PZero/SwimTimer/firmware/xiao-stream/LEGGIMI.md

# xiao-stream - XIAO nRF52840 Sense, streaming IMU via BLE, registrazione in vasca e sincronizzazione con il display

Firmware di prova: annuncia "SwimTag", invia l'IMU alla tab XIAO di `tools/index.html`, manda un log, si sospende (comando, fermo prolungato) e si risveglia con 4 tocchi o con l'USB, e si aggiorna via Bluetooth dalla finestra «Firmware del tag».

**0.6.4** (2026-11-12, compilata, NON caricata né provata): stack BLE 10 KB (`-DCFG_BLE_TASK_STACKSIZE=(256*10)`); **in registrazione la tag resta collegata al ricevitore** (central con PRONTO v2) e manda ogni blocco appena completo, senza FINE e senza disconnettersi (keepalive: una MAPPA ogni 5 s senza altro traffico; a fine registrazione, con `annSonno`, torna la FINE); se il collegamento cade ricomincia dagli annunci e riprende dal blocco non confermato piu' vecchio (invariato). Nuova **DIAGNOSI2** (0x08, subito dopo la DIAGNOSI, solo PRONTO v2; formato in `swr_sync.h`): intervallo, MTU, DLE e PHY negoziati, VBUS adesso + eventi «vista»/«persa» con contatori e millis dell'ultimo (letti ogni 20 ms in ogni modo; ogni evento anche nel diario: NOTA 19 = p2 1 vista/0 persa, p3 contatore, p4 millis), disconnessioni con motivo HCI 0x3E e totali, ultimo motivo, minimo storico dello stack BLE libero. Compilazione: sketch 191860 B (23 %), RAM 38344 B (16 %). Attenzione: con il collegamento permanente restano valide le regole 0.6.1 «niente scritture flash con un client BLE collegato» (diario solo con >= 32 eventi in RAM, azzeramento del contatore di ripartenze dopo 10 min stabili solo senza client): vanno rimisurate in vasca.

**0.6.1** (2026-11-11, dopo l'incidente in piscina): regole di modo (a batteria niente modalita' normale), ripresa automatica dopo un riavvio inatteso, watchdog, contesto del guasto, diario persistente, allineamento del FIFO. Vedi la sezione «0.6.1» in fondo e `PROVA-0.6.1.md`. Compilazione: sketch ~182 KB (22 %), RAM globale ~36,6 KB (15 %).

**0.6.0** (2026-11-10, provata a secco su 2 tag: 666 blocchi in 15 min, 0 errori): sincronizzazione con il display (`docs/SINCRONIZZAZIONE.md`), BLE sempre acceso anche in registrazione, memoria ad anello (**formato 3**), nome e colore della tag, **LED spenti a batteria** (accesi solo con l'USB alimentata, anche il lampeggio del BLE), seq mai riusato (`/seq.bin`). Vedi la sezione «Sincronizzazione con il display (0.6.0)» in fondo.

**0.5.4** (2026-11-08): corrente di carica 100 mA (P0.13 basso, resta in System OFF). Per le prove si usa una cella da 1000 mAh: da vuota servono ~10-12 h.

## Compilazione e caricamento via USB
Core `Seeeduino:nrf52` 1.1.13 (non mbed, con Bluefruit), FQBN `Seeeduino:nrf52:xiaonRF52840Sense`.
Indice schede: `https://files.seeedstudio.com/arduino/package_seeeduino_boards_index.json`.

Il toolchain ARM **non accetta percorsi con spazi**: compilare una copia in un percorso senza spazi. Dalla 0.6.0 lo sketch ha piu' file (`swr_formato.h`, `swr_anello.h`, `swr_sync.h`, `flash_qspi.h`): vanno copiati tutti.

    mkdir C:\Temp\xs\xiao-stream ; copy xiao-stream.ino,*.h C:\Temp\xs\xiao-stream\
    arduino-cli compile --fqbn Seeeduino:nrf52:xiaonRF52840Sense --build-property "compiler.cpp.extra_flags=-DCFG_BLE_TASK_STACKSIZE=(256*10)" --build-path C:\Temp\xs\build C:\Temp\xs\xiao-stream
    (dal 0.6.3 il -D e' obbligatorio, dalla 0.6.4 vale 10 KB: stack del task BLE 10 KB invece di 5 KB, +5 KB di heap; vale anche per le build destinate all'OTA; con altri -D, nello stesso valore separati da spazio)
    arduino-cli upload -p COMxx --fqbn Seeeduino:nrf52:xiaonRF52840Sense --input-dir C:\Temp\xs\build

Dalla 0.6.0 la compilazione dice: sketch ~172 KB (21 %), RAM globale ~34,8 KB (14 %); il limite dell'app per l'OTA e' 356 KB.

L'upload entra da solo nel bootloader (touch a 1200 baud); la porta cambia (COM13 -> COM15). Se non entra: doppio tap su reset (la scheda in sospensione va svegliata prima).

## Aggiornamento via Bluetooth (OTA 0006, stesso protocollo dell'ESP32)
Il servizio DFU Nordic legacy e' sulla blocklist di Web Bluetooth (Chrome/Edge), quindi l'aggiornamento usa un OTA nostro sulla caratteristica `7a1e0006`, identico a quello dell'ESP32: comando `OTA,<byte>,<crc32 hex>,<versione>[,forza]` su 0004, poi scritture su 0006 = `uint32 offset LE + dati`, poi `OTAEND`. Risposte su 0005: `K ota pronto,<blocco>`, `X ota offset,N` (ripartire da N), `K ota ok`, errori `X ota ...`.

**Cosa si carica**: il `.bin` dell'applicazione, cioe' l'ELF convertito con objcopy (parte da 0x27000, `SP` iniziale in RAM 0x2000xxxx). Il core non lo produce da solo (genera .hex e .zip): si ottiene con

    arm-none-eabi-objcopy -O binary xiao-stream.ino.elf xiao-0.4.x.bin

(l'objcopy e' in `%LOCALAPPDATA%\Arduino15\packages\Seeeduino\tools\arm-none-eabi-gcc\9-2019q4\bin`). Il binario contiene `SWIMTAG_VER=<versione>;` e `SWIMTAG_BOARD=xiao-nrf52840;`: il tag rifiuta (`X`) qualsiasi immagine senza la firma della scheda o con vettori non validi (es. il .bin dell'ESP32), con dimensione fuori da 1 KB..356 KB, della stessa versione o precedente (senza `forza`).

### Mappa della flash (nRF52840, 1 MB)
| Indirizzi | Contenuto | Fonte |
|---|---|---|
| 0x00000-0x26FFF | MBR + SoftDevice S140 7.3.0 | `nrf52840_s140_v7.ld` del core: `FLASH ORIGIN = 0x27000` |
| **0x27000** (`APP_BASE`) - fine app | applicazione (~140 KB, fine ~0x4A000) | idem |
| **0x80000** (`STAGING_BASE`) - 0xEC FFF | **staging** dell'immagine ricevuta (max 356 KB = `APP_MAX_BYTE`, anche limite per l'app) | scelto: dopo l'app, prima di InternalFS |
| 0xED000-0xF3FFF | InternalFS di Bluefruit (bonding, 7 pagine) | `InternalFileSystem.cpp`: `LFS_FLASH_ADDR 0xED000` |
| 0xF4000-0xFDFFF | bootloader Adafruit | `dfu_types.h`: `BOOTLOADER_REGION_START 0xF4000` |
| 0xFE000 / **0xFF000** | MBR params / **impostazioni del bootloader** (`BL_SETTINGS`) | `dfu_types.h` |

### Come funziona
1. I dati arrivano in un anello da 8 KB (la callback BLE non tocca la flash) e il `loop` li scrive nello staging con `flash_nrf5x_write` (API del core sopra `sd_flash_write/erase`, compatibile col SoftDevice). Il CRC32 si calcola mentre arrivano.
2. A `OTAEND`: controllo di lunghezza, CRC32, vettori (SP in RAM, reset dispari dentro l'immagine), firma scheda e marcatore di versione. Se qualcosa non torna: scartato, `X ...` e riga di log.
3. Se tutto torna: `K ota ok`, dopo 0,8 s disconnessione, `sd_softdevice_disable`, interrupt spenti e routine `ramInstalla` **tutta in RAM** (sezione `.data.ramfunc`, verificato col disassemblato: nessuna chiamata a funzioni in flash): cancella le pagine dell'app, copia lo staging con NVMC, rilegge e confronta, riscrive le impostazioni del bootloader e fa il reset di sistema.
4. **Bootloader (fonte: `bootloader.c` e `dfu_types.h` di Adafruit_nRF52_Bootloader, letti da GitHub)**: all'avvio `bootloader_app_is_valid()` guarda `bank_0 == BANK_VALID_APP (1)` e, **se `bank_0_crc != 0`, calcola il CRC16 su `bank_0_size` byte** e lo confronta; con `crc == 0` il controllo e' disattivato. Su questa scheda la pagina impostazioni dopo un upload USB contiene `bank_0 = 1, crc = 0, size = dimensione dell'app` (il firmware lo legge e lo scrive nel log all'avvio: `bl bank0 ok crc 0000 = dim N`). L'OTA scrive esattamente lo stesso formato (`bank_0=1`, `bank_0_crc=0`, `bank_1=0xFF`, `bank_0_size` = byte arrotondati a 4), quindi il bootloader accetta la nuova app. Se la copia non verifica, le impostazioni non vengono toccate e il bootloader (versione di riferimento) resta in modalita' DFU.
5. **Recupero**: il bootloader non viene mai modificato; se la nuova app non parte, doppio tap su reset (LED che pulsa, unita' XIAO-SENSE o porta DFU) e caricamento via USB.

Ogni fase finisce nel log del tag (`ota: 143008 byte, v0.4.1`, `ricevuto 25/50/75/100%`, `crc ok`, `installazione`, errori) e quindi nel pannello «Log tag». Durante l'OTA il flusso IMU e la sospensione automatica sono fermi. Velocita' misurata con Windows/Realtek: ~1 KB/s (scritture con risposta), cioe' circa 2,5 minuti.

Prova da PC senza browser: `python ota_prova.py ota xiao-0.4.1.bin 0.4.1` (script `bleak`, stesso protocollo della pagina; vedi sotto in «Prove»).

## Protocollo (little endian)
- Servizio `7a1e0001-5b1d-4c8e-9f3a-1d2c3b4a5e60`.
- DATI `7a1e0002-...` notify, 16 byte a 25 Hz: `uint32 millis`, `int16 ax,ay,az` (2048 LSB/g, +-16 g), `int16 gx,gy,gz` (16,4 LSB/dps). Ogni valore e' la **media** dei campioni a 208 Hz nei 40 ms dall'ultimo pacchetto (niente aliasing); il giroscopio e' gia' privo di bias.
- STATO `7a1e0003-...` read+notify, 1 Hz, 8 byte: `uint16 mV`, `uint8 flag` (bit0 USB presente o in carica, bit1 IMU ok, bit2 registrazione=0, bit4 g16=1), `uint8 causa` (0 accensione, 1 doppio tap, 3 watchdog, 5 software, 6 lockup, 7 USB, 8 pin reset), `uint32 millis`. mV = 0 se la cella non c'e'.
- COMANDI `7a1e0004-...` write (testo, max 64): `SLEEP`, `LIST` (risponde `Z`), `OTA,...`, `OTAEND`, `OTAABORT`; altro -> `X non supportato`.
- RISPOSTE `7a1e0005-...` notify: primo byte = tipo. **`G` + testo = riga di log**; `Z` fine elenco; `K`/`X` risposte ai comandi.
- OTA `7a1e0006-...`, VERSIONE `7a1e0007-...` (`xiao-0.4.x`). Servizio DFU Nordic (BLEDfu) ancora presente per l'app nRF Connect.

## Batteria (0.4.2)
- **STATO a 12 byte** (compatibile: i primi 8 sono invariati; la pagina riconosce la XIAO dalla lunghezza 12): `[8] flag2` (bit0 VBUS presente, bit1 carica completata, bit2 in carica, bit3 batteria bassa < 3,4 V), `[9] int8` temperatura del die in gradi (`sd_temp_get`), `[10-11] uint16` fattore del partitore x1000. Stati: in carica = VBUS e ~CHG basso; carica completata = VBUS e ~CHG alto con cella presente; a batteria = niente VBUS.
- **Lettura ADC**: 24 letture a 1 ms, media delle 16 centrali (scarta i picchi causati dalle trasmissioni radio).
- **Taratura**: comando `VCAL,<mV letti col tester>` calcola il fattore del partitore e lo salva in flash (file `/vcal.bin` nell'InternalFS di Bluefruit, 0xED000-0xF3FFF: non tocca ne' lo staging OTA 0x80000 ne' le impostazioni del bootloader). `VCAL` senza argomento mostra il fattore, `VCAL,0` ripristina 2,96. Risposta `K vcal 2.xxx`, errori `X vcal ...`.
- **Batteria bassa**: log `batteria bassa` sotto 3,4 V a batteria; sotto 3,3 V per 5 letture di fila sospensione "solo USB" (IMU spento). Mai con la USB collegata.

## Log
Buffer circolare in RAM di 50 righe (44 caratteri): boot e causa di reset (con RESETREAS grezzo), IMU ok/errore, bias del giroscopio, stato del bootloader, batteria/USB/carica (a ogni cambio e ogni 60 s), connessioni, sospensione, OTA. Alla connessione (quando la pagina abilita le notifiche su 0005) viene rimandato tutto il buffer; la pagina mostra le righe nel pannello «Log tag». Le stesse righe escono sulla seriale.

## Sospensione e risveglio con 4 tocchi
`SLEEP` (pulsante «Sospendi») oppure 60 s "abbastanza fermo" (vedi costanti `QUIETE_*`). Il firmware spegne il giroscopio, accelerometro a 416 Hz +-2 g in basso consumo, doppio tap hardware (`TAP_CFG=0x8F` con **LIR**, `TAP_THS_6D`=soglia, `INT_DUR2=0x7F`, `WAKE_UP_THS=0x80`, `MD1_CFG=0x08` -> INT1 = P0.11), poi System OFF con sense alto su P0.11.
- **Risveglio (0.4.5/0.5.0)**: il primo doppio tap hardware (2 tocchi) fa partire il chip. **All'uscita da System OFF l'IMU perde l'alimentazione e resta cieco per circa 0,5 s** (bootloader, avvio, riaccensione e riconfigurazione): il 3o e il 4o tocco dati a ritmo normale cadono in questo buco, misurato sulla tag. Per questo, dopo `RISVEGLIO_PAUSA_MS` (150 ms), `risveglioQuattroTap()` accende il **LED blu come invito** a dare i tocchi di conferma e li conta in software (tocco singolo, `TAP_SRC` bit SINGLE_TAP, antirimbalzo 100 ms) entro `RISVEGLIO_FINESTRA_MS` (3000 ms); il blu si spegne a fine sequenza. Sequenza **2 tocchi, blu, 2 tocchi** = risveglio (log `risveglio 4 tap`). Falso risveglio (solo 2 tocchi): torna in System OFF senza BLE, USB ne' log, scrivendo in `GPREGRET2` `MARCA_FALSO` (0xC0 | tocchi visti), che al boot vale come marca di sleep ed e' visibile nel log `marca %02X` (provato: `marca C0`). WHO_AM_I e' ritentato 4 volte da 40 ms. Il risveglio da USB (VBUS) resta immediato.
- **Bug del risveglio con 2 tocchi: causa vera (0.5.0)**: il bootloader Adafruit azzera `RESETREAS` prima di lanciare l'app, quindi `causaReset` risultava sempre "accensione" (RESETREAS 0, anche dopo un OTA) e `risveglioQuattroTap()` non veniva mai chiamata: la tag partiva al primo doppio tap. La correzione di 0.4.3 (conferma in software) era giusta ma non veniva eseguita. Ora, prima di **ogni** System OFF, si scrive la marca `MARCA_SLEEP` (0xB7) in `GPREGRET2` (`sd_power_gpregret_*` con il SoftDevice, il registro diretto senza; il bootloader non lo tocca); in `setup()` la si legge e la si azzera, e se c'e' la marca, non c'e' VBUS e la causa non e' USB, `causaReset = 1` (doppio tap). Nel log compare `marca B7 vbus 0`. (Fonte: prove sulla tag del coordinatore, versione 0.4.4 provvisoria.)
- **Niente sospensione automatica con la seriale aperta**: se un programma sul PC tiene aperta la porta USB (CDC con DTR attivo, `Serial` vero) la sospensione per quiete non scatta e nel log compare una volta `seriale aperta: niente sospensione`. Restano attivi il comando `SLEEP` esplicito e la protezione batteria bassa (esclusa comunque con la USB). Idem se la pagina e' collegata via BLE con comandi negli ultimi 120 s e durante un OTA.
- **Falso risveglio**: da sveglio per circa 40 ms (avvio) + 40 ms (IMU) + 250 ms + 2500 ms + qualche ms = **~2,9 s**, a regime CPU ferma in attesa (da misurare con un amperometro).
- **Soglia del doppio tap**: `TAP_SOGLIA` in cima allo sketch (12 = 0,75 g, 1 LSB = 62,5 mg). Piu' basso = piu' sensibile. La durata massima fra i due tap di un doppio tap e' in `INT_DUR2` (DUR=7, ~0,5 s a 416 Hz).
- **Consumo in sospensione: stima, non misura.** nRF52840 in System OFF ~1 uA; LSM6DS3TR-C con solo accelerometro a 416 Hz in basso consumo ~100-200 uA (termine dominante: il tap hardware richiede almeno 416 Hz); flash QSPI e BQ25101 pochi uA. Totale atteso ~0,1-0,2 mA, cioe' 8-16 giorni con la cella da 40 mAh. Da misurare con un multimetro in serie alla batteria.

## Orientamento: perche' la testa si storceva e cosa e' cambiato
1. **Aliasing (causa principale)**: prima ogni pacchetto era un campione istantaneo a 25 Hz del giroscopio; una rotazione veloce cade fra due campioni e l'integrale e' sbagliato. Ora il firmware campiona a 208 Hz e manda la media.
2. **Bias del giroscopio**: ~1-2 dps da fermo si integrano in 10-20 gradi al minuto. Misurato al boot e ri-stimato quando il tag e' fermo (finestre da 0,5 s, variazione sotto 2,5 dps, |a| fra 0,9 e 1,1 g, media entro 4 dps dal bias noto).
3. **Assi/segni**: da verificare con «Verifica assi» (Z a +1 g a faccia in su, Y a +1 g con l'USB-C in alto).
4. **Imbardata (yaw)**: senza magnetometro non e' osservabile; la deriva si azzera con «Ricentra».

## Prove
- `C:\Temp\xs\ota_prova.py` (venv con `bleak`): `python ota_prova.py log` legge versione e log; `python ota_prova.py ota file.bin 0.4.1` esegue l'OTA come la pagina.
- Il partitore batteria (2,96) va confermato con un multimetro: letti ~4,0 V con la cella collegata e USB.

## Modalita' vasca (0.5.0): registrazione su flash (dalla 0.6.0 il BLE resta acceso solo per annunciarsi e sincronizzare)
Per la prova in piscina: il BLE non attraversa l'acqua, quindi la tag registra l'IMU grezzo sulla flash QSPI; i dati si scaricano a bordo vasca dal display (0.6.0) oppure a casa via USB.

### Uso (tocchi, tag senza USB)
| Gesto | Effetto |
|---|---|
| **REGISTRA**: 2 tocchi, **LED blu** (si spegne un attimo a ogni tocco contato, dalla 0.5.1), 2 tocchi | sveglia e **registra subito**. Se in memoria c'e' gia' una registrazione, si **accoda** come nuovo segmento (una sola sessione, piu' risvegli). |
| **AZZERA**: 2 tocchi, **LED blu**, 6 tocchi, poi rosso lampeggiante e 2 di conferma entro 4 s | **azzera** la memoria (LED rosso lampeggiante durante i 4 s; senza conferma non succede nulla). Cancellazione 5-15 s. |
| tag ferma | **stop** per quiete: 180 s consecutivi "abbastanza fermi" (soglie `QUIETE_GYRO_DPS`/`QUIETE_ANGOLO_GRADI`), poi chiusura e sospensione. |
Nessuno stop a tocchi. Altri stop: memoria piena, batteria sotto 3,3 V (3 letture ogni 5 s). Il blu si accende 150 ms dopo il risveglio e resta acceso finche' la sequenza non e' finita: finisce quando passano 900 ms senza un nuovo tocco (la registrazione parte ~1 s dopo l'ultimo), e il conteggio decide: 6 tocchi dopo il blu = azzera, da 2 a 5 = registra (2 non si scambia con 6). Finestra totale per il 1o tocco dopo il blu: 3 s. Con la **USB collegata** i tocchi danno la modalita' normale (BLE, OTA, log) e non si registra. **0.6.0**: se la flash contiene dati del **formato 1** (0.5.x) la registrazione **non parte** e i dati non si cancellano da soli: 4 lampi viola (rosso+blu); si scaricano con `DUMP` e poi si azzera con la sequenza AZZERA (6 tocchi + conferma). Un contenuto non riconosciuto (ne' formato 1 ne' 2) si cancella da solo, come in 0.5.x. Nota: i 180 s di quiete contano anche prima di entrare in acqua.

### LED (RGB a tre canali discreti attivi bassi: LED_RED P0.26, LED_GREEN P0.30, LED_BLUE P0.06; non e' un NeoPixel)
| Stato | Segnale |
|---|---|
| registrazione avviata | 3 lampi verdi da 150 ms |
| in registrazione | 1 lampo verde da 30 ms ogni 8 s |
| memoria > 80% non confermata (0.6.0) | 2 lampi gialli (rosso+verde) ogni 8 s |
| batteria < 3,5 V | 1 lampo rosso ogni 8 s |
| memoria piena di blocchi non confermati (stop) / azzera rifiutato | 5 lampi rossi |
| flash in formato 1 (non si registra) | 4 lampi viola (rosso+blu) |
| batteria < 3,4 V al risveglio (non registra) | 3 lampi rossi da 200 ms |
| batteria < 3,3 V (stop e chiusura) | 3 lampi rossi da 200 ms, poi IMU spento: si riparte solo con l'USB |
| errore (IMU, flash, I2C) | 10 lampi rossi rapidi |
| conferma azzeramento | rosso lampeggiante a 5 Hz per 4 s; poi azzerata = 3 lampi blu; gia' vuota = 1 lampo blu |
| flash formattata (altro contenuto) | blu fisso durante la cancellazione |
**Dalla 0.6.0 i LED sono spenti a batteria** (decisione 2026-11-10: sotto la cuffia non si vedono e consumano): la tabella vale solo con l'USB alimentata. I tempi delle sequenze (tocchi, finestre) restano uguali; lo stato si vede sul display e sulla pagina.

### Cosa si registra
208 Hz, accelerometro +-16 g (488 ug/LSB), giroscopio +-1000 dps (35 mdps/LSB), FIFO dell'LSM6 in modo continuo (a 208 Hz tiene ~1,6 s: copre le scritture in flash). Il giroscopio **non e' corretto del bias** (si stima a casa dai tratti fermi). Ordine nel FIFO secondo il datasheet: G poi XL; nel file: ax ay az gx gy gz. Controllo a secco: a faccia in su az ~ +1 g.
Se mai il FIFO va in overrun, riparte e la pagina successiva ha il flag di interruzione.

### Formato .swr 1 (0.5.x; specifica completa in `swr_formato.h`; il formato 2 della 0.6.0 e' descritto piu' sotto)
Flash = sequenza di **pagine da 256 byte** scritte una sola volta, in ordine (nessuna cancellazione in registrazione, nessun filesystem). Intestazione da 16 byte: tipo (segmento 0xA5 / dati 0xD1 / chiusura 0xE0), numero di pagina, `millis` del primo campione, mV, temperatura, flag, segmento, **CRC16** dell'intera pagina. Pagina dati: primo campione **assoluto** (12 B) poi per campione 6 differenze int8, oppure un **escape** (0x80 + 12 B assoluti) se una differenza esce da -127..127: ogni pagina si decodifica da sola. Capacita': 8192 pagine; con dati regolari ~6 B/campione (~2 x rispetto ai 12 B grezzi: ~25 min), con molti escape meno (13 B al campione). Una pagina di segmento a ogni risveglio, una di chiusura (motivo, campioni).
La fine si ricostruisce dall'ultima pagina valida (ricerca binaria della prima pagina libera): se la batteria muore senza chiusura i dati scritti restano e il segmento risulta "senza chiusura". Al risveglio, con pagina 0 non valida e non vuota, la flash viene azzerata (prima installazione).
Il driver `flash_qspi.h` usa direttamente `nrfx_qspi` (la libreria utente `Adafruit_SPIFlash` 5.x rompe la compilazione di Bluefruit).

### Scarico (USB, modalita' normale) e analisi
Comandi sulla seriale (115200): `MEM`, `DUMP`, `ERASE`. `DUMP` risponde `SWR1 <pagine>`, le pagine binarie, `END <pagine>` (flash in formato 1) oppure, dalla 0.6.0 con la flash in formato 2, `SWR2 <blocchi>`, i blocchi non vuoti da 4096 byte in ordine fisico (confermati compresi: lo scarico USB legge anche cio' che e' gia' sul display), `END <blocchi>`; durante il dump niente log sulla seriale. `swr.py` e `scarica.py` riconoscono i due formati (primo byte 0xA5 o 0xB1), riordinano i blocchi per seq, saltano le intestazioni, trattano le pagine 0xFF come vuote e segnalano i buchi di seq. `MEM` in formato 3: `K mem formato3 da_validare N confermati N liberi N anomali N seq N`. `NOME` e `COLORE` senza argomento rispondono col valore attuale. **SLEEP funziona anche in registrazione** (dalla pagina): chiude il segmento (motivo 6 «comando SLEEP»), annuncia «vado in sonno» e dorme; gli altri comandi in registrazione rispondono `X registrazione in corso`. `ERASE` cancella tutto (anche non confermato: e' un comando esplicito da USB).

    pip install pyserial
    python scarica.py scarica COM5        # salva registrazioni/AAAAmmdd_HHMMSS.swr e il CSV
    python scarica.py converti file.swr   # solo conversione
    python scarica.py mem COM5 ; python scarica.py azzera COM5
    python test_swr.py                    # test su dati inventati (23 test; anche `python -m unittest test_swr` dalla cartella)

CSV: `seg,pagina,n,t_s,ax_g..gz_dps,mV` (`--grezzo` per gli LSB). `t_s` e' in secondi dall'inizio del segmento (dai `millis` di pagina, regolarizzati con una regressione sulle pagine contigue); tra segmenti diversi il tempo non e' collegabile. Il programma segnala pagine corrotte, interruzioni, segmenti senza chiusura. I `.swr` e i CSV sono dati di salute: ignorati da git.

### Limiti noti (0.5.0, non provata su hardware)
- Non collaudata sulla tag: ordine G/XL del FIFO, lettura a burst da `FIFO_DATA_OUT`, cancellazione chip, QSPI senza SoftDevice e consumi vanno verificati a secco.
- Il codificatore C++ (`swr_formato.h`) e' specchiato in Python (`swr.py`) ma non e' stato eseguito su PC (nessun compilatore host): i test provano il formato in Python; la parita' C++/Python e' per costruzione e va confermata scaricando una registrazione vera.
- Il tempo dei campioni nel firmware e' stimato (±1 campione); il bias del giroscopio non e' misurato.
- Nessun BLE/OTA in vasca: aggiornare il firmware richiede l'USB. Il sensore `LED` puo' non essere visibile sotto la cuffia.
- Consumo stimato (da misurare): ~1,5-2 mA registrando, ~0,1-0,2 mA in sospensione.

## Sincronizzazione con il display (0.6.0)
Specifica: `docs/SINCRONIZZAZIONE.md` (§1-§3, §7, §8). Riferimento binario lato display: `firmware/display-sync/protocollo.h` (i messaggi di `swr_sync.h` devono combaciare byte per byte).

### Cosa fa
- **BLE sempre acceso**, anche in registrazione (prima in vasca era spento): annuncio connectable ogni **200 ms** con i dati produttore del §7 (22 byte: id, stato, batteria, % memoria non confermata, blocchi in attesa, ultimo seq, secondi di registrazione, errori, colore) e, nella scan response, il nome. **2 collegamenti periferici** contemporanei (display + pagina web). La tag **non interpreta il movimento**: l'annuncio e' sempre lo stesso, con i dati che cambiano.
- **Nome** nella scan response: il nome scelto dall'utente (max 12 caratteri ASCII) oppure `ST-xxxx` (ultime 4 cifre dell'id). **Cambia rispetto alla 0.5.x** (prima `SwimTag`): la pagina `tools/index.html` non deve piu' filtrare per nome `SwimTag`. Nella scan response c'e' anche il servizio `7a1e0001` se il nome e' di al massimo 11 caratteri.
- **Stati annunciati**: 0 vado in sonno (~2 s prima di dormire; se la memoria e' piena prima 2 s di stato 4; se un display sta scaricando si aspetta la sua FINE/STOP, al massimo 60 s), 1 pronta (modalita' normale), 2 registra, 4 memoria piena, 5 errore (IMU o flash, anche flash in formato 1), 6 sincronizza.
- **Servizio `7a1e0101`**: CONTROLLO `0102` (scrittura, **solo collegamento cifrato**: `SECMODE_ENC_NO_MITM`, bonding Just Works con le impostazioni predefinite di Bluefruit: bond, LESC se il chip lo permette), DATI `0103` (notifiche inviate direttamente al SoftDevice con `sd_ble_gatts_hvx`: se la coda radio e' piena non si blocca, riprova al giro dopo), STATO SYNC `0104` (lettura + notifica ogni 2 s, 151 byte, senza cifratura, la pagina non puo' confermare). MTU 247, coda di 4 notifiche, evento da 7,5 ms; PHY 2M e DLE li negozia il display (la libreria Bluefruit accetta le richieste del centrale).
- **Scarico**: dopo PRONTO la tag manda MAPPA, poi il blocco non confermato piu' vecchio (BLOCCO + 32 FRAMMENTI), al massimo 2 blocchi trasmessi e non confermati; **attende la CONFERMA senza timer**; non rinvia mai da sola; RIPETI rimette in coda il blocco; STOP chiude; quando non resta niente da confermare manda FINE (e riparte da sola se si chiude un nuovo blocco mentre il display e' ancora collegato). **Il blocco aperto non si invia** (niente anteprima): il display riceve solo blocchi chiusi (~3 s di ritardo al massimo).
- **Conferma**: CONFERMA(seq, crc32) -> la tag **ricalcola il CRC32 dalla flash** e solo se coincide scrive la parola 252..255 a 0x00, **rilegge l'intera intestazione** (deve risultare confermata e ancora valida) e risponde CONFERMATO. Altrimenti ERRORE (1 CRC diverso, 2 seq sconosciuto, 3 flash).
- **La registrazione non si ferma durante lo scarico**: tutto gira nel `loop` a pezzi (al massimo ~10 messaggi per giro, ogni frammento e' una lettura da 128 byte dalla flash; il CRC32 di un blocco = 16 letture da 256 byte). Il FIFO dell'IMU (1,6 s) viene servito almeno ogni 20 ms mentre si scarica (40 ms altrimenti). Le operazioni piu' lunghe sono la **cancellazione di un settore** (45 ms tipici, fino a 300 ms; una per blocco, solo quando la memoria ha fatto il giro) e la scrittura. **Misure per verificarlo**: la pagina di chiusura di ogni segmento ora contiene (byte 24..30) il massimo intervallo fra due letture del FIFO in ms, gli overrun, il massimo tempo di apertura di un blocco (cancellazione compresa) e i blocchi confermati nella sessione; `swr.py` le mostra nel riassunto (`tempi: ...`). Se il massimo intervallo si avvicina a 1600 ms il FIFO va in overrun.

### Memoria ad anello (formato 3)
- Flash da 2 MB = **512 blocchi da 4 KB** (= settore). Pagina 0 del blocco = intestazione `0xB1` (seq u32 globale, id tag, **parola 252..255 = conferma** fuori dal CRC16; il formato 2 la teneva nel byte 16, vedi sotto), pagine 1-15 = pagine del formato 1 (segmento 0xA5, dati 0xD1, chiusura 0xE0, numero di pagina fisica). Capacita' utile 15/16 della flash (~7680 pagine). CRC32 del blocco = IEEE sui 4096 byte con la conferma a 0xFF (anche nei frammenti inviati). Il seq non si riusa mai: prima di ogni cancellazione totale si salva il massimo in `/seq.bin` (InternalFS), senza file si parte da 1000.
- All'avvio si leggono le 512 intestazioni (~100 ms): seq massimo, blocchi da validare, confermati, liberi, anomali (contenuto non riconosciuto: non si toccano mai). Un blocco e' "aperto" solo in RAM mentre si registra; dopo un riavvio i blocchi scritti a meta' sono semplicemente "da validare" (le pagine non scritte restano 0xFF = vuote e valide). Ogni segmento (ogni risveglio) comincia un blocco nuovo; il blocco si chiude quando e' pieno o a fine segmento.
- Nuovo blocco: il **libero successivo** (in ordine ad anello); se non c'e', il **confermato piu' vecchio** (cancellato solo ora); se sono tutti non confermati: **stop `SWR_STOP_PIENA`** (5 lampi rossi, stato 4). **Mai si scrive su un blocco non confermato.** Il blocco libero si verifica tutto 0xFF prima dell'uso (cancellazione interrotta da un'interruzione di corrente), altrimenti si cancella.
- Con memoria piena la pagina di chiusura del segmento non si scrive (il segmento risulta senza chiusura per `swr.py`; il motivo e' nell'annuncio, stato 4) e l'ultima pagina dati parziale (< 0,2 s) puo' andare persa.
- Il seq riparte da 1 dopo un azzeramento totale (`ERASE` o AZZERA a tocchi): il display riconosce un seq gia' visto con CRC diverso come anomalia e lo segnala.
- **Flash in formato 1 trovata all'avvio**: non si cancella, non si registra (vedi sopra); `DUMP` la legge ancora come prima. In 0.5.x un contenuto estraneo veniva azzerato da solo; **dalla 0.6.0 mai**: 4 lampi viola (solo con USB), niente registrazione, si azzera con `ERASE` o con i tocchi.

### Nome e colore (comandi sulla caratteristica `7a1e0004`, solo in modalita' normale)
`NOME,<testo>` (max 12 caratteri ASCII stampabili, vuoto = cancella; risposte `K nome <testo>`, `X nome troppo lungo (max 12)`, `X nome carattere non valido`), `COLORE,<0-9>` / `COLORE,-1` (`K colore <n>`, `X colore fuori campo (0-9 o -1)`); `COLORE` senza argomento mostra il valore. Salvati in InternalFS `/nome.bin` (come `/vcal.bin`: restano dopo riavvio e OTA); il nome cambia subito la scan response, il colore e' il byte 21 dell'annuncio. In registrazione (vasca) tutti i comandi rispondono `X registrazione in corso`.

### Consumi stimati del BLE in registrazione (stime, NON misure)
Annuncio a 200 ms, +4 dBm (3 canali per evento, con le finestre di ascolto per scan request e connessione): ~50-100 uA medi; con 0 dBm circa un quarto in meno. In piu': 2 stop/start dell'annuncio ogni 4 s (trascurabile) e il loop sveglio ogni 40 ms come prima. Rispetto ai ~1,5-2 mA della registrazione e' un +3-5 %: da **misurare con un amperometro in serie alla batteria**, prima e dopo. Collegata al display (7,5-15 ms) la tag assorbe ~0,5 mA in piu', con picchi di qualche mA durante lo scarico (pochi secondi a ogni sosta).

### Cosa NON e' provato (0.6.0: solo compilata, mai eseguita su hardware)
- Memoria SRAM del SoftDevice con 2 collegamenti, MTU 247, 4 notifiche e tabella attributi da 3 KB: se `Bluefruit.begin` fallisce il BLE resta spento ma la registrazione parte comunque (log `BLE begin KO`; in modalita' normale si vede nel pannello log). Da verificare al primo avvio.
- **Lezione 2026-11-10 (formato 2 → 3):** la Puya della XIAO, riprogrammando una parola da 4 byte gia' scritta, la **sostituisce** (non fa l'AND dei bit): scrivere `00 FF FF FF` nei byte 16..19 cancellava i byte 17..19 del seq. Intestazioni non valide, seq riusati, 185 anomalie al display (nessun dato perso: erano blocchi gia' confermati). Dal formato 3 la conferma ha una parola tutta sua (252..255) e dopo la scrittura si rilegge l'intestazione intera.
- Ordine e tempi reali: massimo intervallo fra letture FIFO con scarico in corso e con cancellazioni, throughput (atteso 30-80 KB/s con PHY 2M, mai misurato), tempo da «fermo» a «collegato».
- Bonding Just Works con il display ESP32 (CONTROLLO richiede la cifratura; se il display non fa il pairing la scrittura viene rifiutata), PHY 2M e DLE, stop/start dell'annuncio con 1 collegamento attivo (il secondo collegamento si riannuncia dal loop), nome lungo nella scan response, collegamento contemporaneo di display e pagina.
- Il codificatore C++ del formato 2 (`swr_formato.h`, `swr_anello.h`) e' specchiato in `swr.py` e provato lato Python (25 test, compresi la parola di conferma isolata e la lettura del formato 2); non c'e' un compilatore host: la parita' C++/Python va confermata con uno scarico USB reale. Nessun test automatico sulla logica dell'anello e della macchina a stati (solo compilazione).
- La batteria non e' stata considerata per lo scarico: la tag non si spegne da sola finche' un display sta scaricando (max 60 s dopo lo stop).

## 0.6.1 - regole di modo, ripresa, watchdog, contesto del guasto, diario, FIFO (2026-11-11)
Nasce dall'incidente in piscina: la tag 4A510689 si e' riavviata registrando, al riavvio e' andata in modalita' normale (ignora i tocchi) e ha perso tutto il nuoto; nei dati acc e giro risultavano scambiati a tratti. Casi di prova: `PROVA-0.6.1.md`.

### Regole di modo
- **A batteria la modalita' normale non esiste.** Senza USB un avvio puo' solo: registrare (4 tocchi, oppure ripresa automatica) o dormire. Avvio senza USB e senza ragione per registrare (cella appena collegata, reset senza marca) = System OFF subito, senza BLE (`dormiSenzaBle`, diario `MODO sonno mot5`).
- **USB staccata in modalita' normale** (VBUS assente per ~0,5 s): annuncio SONNO ~2 s e System OFF con marca B7 e tap configurato (`controlloUsb()`, diario `USB staccata`). Non scatta durante un OTA.
- **Con USB: modalita' normale, mai registrazione**, anche se arrivano i 4 tocchi. PC o caricatore si distinguono con l'**enumerazione USB** (`TinyUSBDevice.mounted()` = `tud_mounted()`; non il DTR): diario `USB PC` / `USB caricatore`. All'avvio con USB si attende fino a 3 s la seriale.
- **Nome e colore** (`NOME,x`, `COLORE,n`) solo con USB: altrimenti `X solo con USB` (le richieste senza argomento restano permesse).
- **OTA via BLE**: di fatto solo con la tag su USB o caricatore (e' una funzione della modalita' normale). In piscina o a batteria non si aggiorna. `SLEEP` resta (anche in registrazione).

### Ripresa automatica dopo un riavvio inatteso
- All'avvio della registrazione: `GPREGRET2 = MARCA_REGISTRA (0xD0 | riprese)` e `/reg.bin` (InternalFS: attiva, riprese). Alla chiusura ordinata: `MARCA_SLEEP` (B7) e `/reg.bin` azzerato (subito dopo la pagina di chiusura, prima degli annunci, cosi' un guasto in quella fase non riprende un segmento gia' chiuso).
- Al boot **senza VBUS**: marca REGISTRA -> `modalitaVasca(1)`: nessun rito dei tocchi, IMU riacceso (`imuAccendi()`), **nuovo segmento** (nuovo blocco), causa nella pagina di segmento.
- **Seconda rete** (GPREGRET2 perso, es. brownout): senza marca e senza USB, se `/reg.bin` e' attivo **e** l'ultimo blocco per seq contiene pagine di segmento/dati ma non la chiusura (`ultimoSegmentoAperto()`) -> `modalitaVasca(2)`. Con USB al boot lo stato orfano viene annullato (non riparte piu').
- **Protezione dai cicli**: al massimo `MAX_RIPRESE = 3` riprese consecutive senza chiusura ordinata; alla quarta annuncio ERRORE (~3 s) e sonno, diario `RIPRESA 4/3`. Il contatore si azzera con una chiusura ordinata o con una partenza a tocchi. **Non c'e' un orologio**: il vincolo «in pochi minuti» non e' implementabile senza RTC, vale «consecutive senza chiusura». Niente ripresa con batteria sotto `BAT_MIN_AVVIO_MV` (controllo gia' prima del conteggio).

### Watchdog hardware
`wdtAvvia()` a inizio `setup()`: timeout 8 s (`CRV = 8*32768-1`), `CONFIG.SLEEP = Run` (conta anche mentre la CPU dorme nel FreeRTOS idle), servito da `cane()` (RR[0] = 0x6E524635) nel `loop()`, nel ciclo della registrazione, in `attendi`, `bleServi` (quindi `sonnoAnnuncia`, fino a 60 s), `contaTocchi`, `calibraBoot`, nelle attese del chip QSPI (`flash.ciclo`, cancellazione chip fino a 15 s), nei `DUMP` e dentro `ramInstalla` (a interrupt spenti: scrittura diretta di NRF_WDT->RR[0] per pagina e ogni 1024 parole).

**Cosa succede al WDT (fonti e prove):**
- **Dopo il reset software e attraverso il bootloader il WDT continua a contare**: lo dice il bootloader stesso (Adafruit_nRF52_Bootloader 0.6.2, `lib/sdk11/components/libraries/bootloader_dfu/bootloader.c`, `wait_for_events()`: «WDT cannot be disabled once started. It even last through NVIC soft reset») e l'ho verificato: dopo `PROVA_RESET` la tag riparte con `RUNSTATUS = 1` (diario `WDT gia' attivo al boot`). Il bootloader **serve tutti i canali WDT** nel suo ciclo DFU, quindi gli aggiornamenti via USB non vengono interrotti (provato: caricamenti da 27 s con il WDT attivo). Il passaggio normale nel bootloader dura ~1 s, ben sotto 8 s.
- **Dopo un reset del watchdog il WDT risulta fermo** (provato: `PROVA_BLOCCO`, riavvio con `RUNSTATUS = 0`).
- Conseguenza: un firmware **piu' vecchio, senza watchdog**, installato (OTA con `forza` o USB) sopra la 0.6.1 subisce **un** reset del WDT ~8 s dopo l'avvio e poi gira normale.
- **OTA / `ramInstalla`**: SoftDevice disabilitato e interrupt spenti, il WDT non e' servito da nessuno: per questo la routine in RAM lo serve da sola (verificato col disassemblato: nessuna chiamata a funzioni). Dopo il reset l'app nuova ha ~1 s di bootloader e poi parte (e fa `cane()` subito).
- **System OFF: NON VERIFICATO.** La documentazione Nordic del WDT dice che dopo un reset o un risveglio da OFF i registri tornano configurabili, quindi non dovrebbe scattare in OFF (LFCLK spento); non l'ho potuto provare perche' con l'USB collegata la tag si risveglia subito. Caso 17 di `PROVA-0.6.1.md`: in sonno > 1 min nel diario non devono comparire avvii con causa 3.
- Il TIMEOUT del WDT genera un IRQ ~61 us prima del reset: `WDT_IRQHandler` (priorita' 3, le 0/1/4 sono del SoftDevice) salva PC e LR. Se la CPU e' bloccata in un handler di priorita' <= 3 l'IRQ non parte: resta solo RESETREAS = watchdog senza PC.

### Contesto del guasto
- **RESETREAS e' affidabile**: lo azzera il **core** (`init()` in `cores/nRF5/wiring.c`: `NRF_POWER->RESETREAS |= NRF_POWER->RESETREAS`) prima di `setup()`, ma ne conserva una copia, `readResetReason()`. Il bootloader Adafruit **non lo tocca** (`main.c` 0.6.2: lo legge solo per la doppia pressione del reset). La nota della 0.5.0 («lo azzera il bootloader») era sbagliata; l'effetto («causa sempre 0») era del core. Il firmware ora usa il valore grezzo (bit: 0 pin, 1 watchdog, 2 software, 3 lockup, 16 System OFF, 20 VBUS) e lo scrive nella pagina di segmento e nel diario. Il resto di questo documento che dice «il bootloader azzera RESETREAS» va letto con questa correzione.
- `HardFault_Handler` (`guastoC`) sostituisce quello del core (che faceva solo `NVIC_SystemReset`): salva in RAM `noinit` PC, LR, CFSR, HFSR, fase e tipo, poi reset. Per il WDT: tipo 4 dall'IRQ. **Non agganciabili senza modificare il core**: l'handler di errore del SoftDevice (`nrf_error_cb` e' `static` in `bluefruit.cpp` e con `CFG_DEBUG=0` ritorna) e gli hook FreeRTOS `vApplicationStackOverflowHook`/`MallocFailedHook` (stesso oggetto di `yield`: definirli qui darebbe un doppione): un assert del SoftDevice o uno stack overflow lasciano la tag bloccata o impazzita e li copre solo il watchdog (senza contesto, tipo «watchdog»).
- **Dove sta la RAM**: `.noinit` normale NON basta (GCC lo emette come `PROGBITS` e lo startup del core copia da `__data_start__` a `__bss_start__`, quindi lo azzera: provato, il contesto andava perso). Si dichiara la sezione `NOBITS` con `section(".noinit,\"aw\",%nobits@")` (su ARM `@` e' il commento): finisce fra `.bss` e `.heap`, non copiata ne' azzerata, e **sopravvive al bootloader** (provato con `PROVA_CRASH` e `PROVA_BLOCCO`: il PC si risolve con `addr2line` sulla riga giusta). L'indirizzo dipende dalla dimensione del bss; il bootloader usa la RAM da 0x20008000 (`linker/nrf52840.ld`): **se un giorno il contesto non torna piu', controllare l'indirizzo** (`nm xiao-stream.ino.elf | grep ctxRam`). Si valida con magic + checksum e solo se RESETREAS ha watchdog, reset software o lockup. A System OFF la RAM si perde: non serve.
- Il contesto va nella **pagina di segmento** (byte 38..63, `swr_formato.h`; i lettori vecchi li ignorano) e nel diario (`GUASTO`, `AVV`). Dalla revisione le pagine di segmento portano anche il tempo di sessione (byte 64..73). Un guasto in modalita' normale (USB) finisce solo nel diario e nel log.

### Diario persistente
`/dia.bin` nell'InternalFS (stessa flash interna di bonding e nome): record da 12 byte (secondi dall'avvio, tipo, parametri), **200 record** al massimo; al riempimento si tiene la meta' piu' recente. Gli eventi si accodano in RAM (40 posti) e si scrivono in `diarioFlush()`: al boot, ai cambi di modo, a inizio e fine registrazione e, in registrazione, al massimo ogni 120 s (400-800 ms misurati, vedi «Revisione del 2026-11-11»; il FIFO tiene ~1,6 s); mai dalle callback BLE. Eventi: avvii con causa, marca e RESETREAS, guasto (PC/LR/CFSR), WDT gia' attivo, cambi di modo con motivo, USB (staccata/PC/caricatore), inizio e fine registrazione (origine, motivo, secondi), riprese, overrun, disallineamenti del FIFO, batteria, connessioni e sincronizzazione (collegato/scollegato con motivo, pronto, STOP, FINE, persa), falsi risvegli (solo con `PROVE_GUASTI`: una scrittura flash per falso risveglio). Ogni evento e' anche una riga di log (`D ...`): arriva sul pannello «Log tag». Comandi: seriale `DIARIO` (stampa tutto) e `DIARIO,CANC`; BLE `DIARIO[,n]` (ultimi n record come righe `G`, solo in modalita' normale). **Limite**: gli eventi in RAM non ancora scritti si perdono in un guasto (al massimo gli ultimi 120 s di registrazione).

### Allineamento del FIFO (il difetto acc/giro scambiati)
L'algoritmo sta in **`swr_fifo.h`** (C++ senza Arduino, I2C/tempo/uscita iniettati: template `SwrFifo<Hw>`); lo sketch ha solo l'adattatore `FifoHw`. Il **port Python `fifo_sim.py`** ne e' la copia riga per riga (sul PC non c'e' un compilatore C++) con un simulatore del sensore; `test_swr.py` controlla che le costanti coincidano con quelle dell'header e prova l'algoritmo con segnale sintetico.
- **Causa misurata** (`PROVA_FIFO,<s>[,<modo>]`, tag ferma su USB, IMU vero, nessuna scrittura in flash): il flusso del FIFO dell'LSM6DS3TR-C **si sfasa davvero da solo**, ~5 volte al minuto a riposo (si perdono 1-2 parole nel flusso). La 0.6.0 leggeva insiemi da 6 parole senza controllare nulla: da quel punto tutti i campioni risultano scambiati o mescolati. Prova `modo 2` (taglio forzato di 3 parole, senza controllo): meta' dei campioni scambiati.
- **Causa dello slittamento: NON trovata.** Senza effetto: letture da 2/4/6 byte, I2C a 100 kHz, margine di 12 parole nel FIFO. **Esperimento sulla radice (modo 4, un solo tentativo):** lettura a **fase fissa** dopo il dato pronto (DRDY dell'accelerometro su INT1 a impulsi, 4 impulsi = ~19 ms, poi ~2,4 ms di attesa e lettura) invece che a fase casuale: **nessun miglioramento**: 3 prove da 60 s a fase fissa = 11, 1 e 5 riallineamenti (media 5,7/min), 3 prove a fase casuale = 5, 0 e 1 (media 2/min); gli sfasamenti variano molto da un minuto all'altro, ma non crollano con la fase fissa. Non e' la strada.
- Osservazioni sul sensore: il registro **FIFO_PATTERN** (FIFO_STATUS3/4) e' esatto per una parte degli slittamenti, ma a volte legge un valore falso e a volte lo slittamento non compare nei registri; **DIFF_FIFO e PATTERN non sono assestati per ~1 ms** dopo una lettura del FIFO; con il FIFO vuoto il pattern non e' significativo (legge 5).
- **Lezione del 2026-11-11 (buffer di Wire):** una lettura I2C piu' lunga di 32 byte (il buffer di `Wire`) interrompe la transazione a meta' e **perde parole dal FIFO, creando lo sfasamento che vuole curare**: la finestra di ricerca da 70 byte lo faceva (misurato: 30 % di campioni scambiati). Ora `leggiBlocchi` legge al massimo 24 byte per transazione (`SWRF_BLOCCO_I2C`); il simulatore riproduce il limite.
- **Rimedio a due livelli** (commento in testa a `swr_fifo.h`):
  1. **Registri**: stato letto solo almeno 8 ms dopo l'ultimo accesso; gli insiemi della chiamata precedente (batch, max 40) vanno al codificatore solo con pattern 0. Pattern != 0 si agisce solo se **confermato dopo 2 ms** e **coerente con DIFF** (`DIFF mod 6 == (6 - pattern) % 6`): batch buttata e scarto di `6 - pattern` parole.
  2. **Contenuto**: al primo salto della somma delle differenze fra insiemi consecutivi (`SWRF_SPIKE` = 1000 LSB, ~0,5 g sui 6 canali) si smette di leggere; alla chiamata dopo si leggono 35 parole fresche (5 insiemi per ogni scostamento `s` = 0..5) e per ogni `s` si assegnano le 5 serie temporali ai 6 canali, se ne prende la **mediana** e si somma `|mediana - canale dell'ultimo insieme buono|`. Si cambia `s` solo se `costo(s) < 800` e `costo(s) * 4 < costo(0)`; altrimenti (urto vero o dubbio) `s = 0`, nessuno scarto e l'insieme sospetto si tiene. La mediana su 5 campioni ignora un urto lungo fino a 2 campioni. **Una prima versione** (soglia 3500, accettazione `c[best]*2 < c[0] && c[best] < 3500`, confronto con l'ultimo insieme su 11 parole) **creava falsi riallineamenti con gli urti** (6,5 % secondo il modello del revisore) e una seconda (coerenza interna fra insiemi consecutivi) era sbagliata in principio (confronta sempre lo stesso canale con se' stesso e non dipende dall'allineamento: 197 falsi su 1500 urti nella simulazione): scartate.
- **Prova sintetica** (`fifo_sim.py`, `TestFifo` in `test_swr.py`): segnale = gravita' che oscilla + rotazione + rumore ±3 LSB, urti da **5, 10 e 20 g su 1-3 campioni**, sfasamenti iniettati di 1-5 parole, pattern «visibile» o «invisibile» e il 2 % di letture false del pattern. Risultati: **0 falsi riallineamenti su 10 000 urti** (10 000 sospetti, 0 riallineamenti, 0 campioni mescolati su ~205 000); sfasamenti trovati: pattern visibile **100 %**, pattern invisibile senza urti **~96 %** (media su 3 semi, 91-98 %), pattern invisibile con urti vicini ~88 % (la scelta e' ambigua se lo sfasamento cade dentro l'urto: si resta con `s = 0`, limite noto). **Il criterio del 95 % e' soddisfatto per il pattern visibile e per l'invisibile senza urti, NON per l'invisibile con urti vicini.**
- **Costo**: ogni riallineamento butta ~20-40 ms (una batch) e chiude la pagina dati con `SWR_FLAG_GAP`: a ~5 al minuto sono ~300 pagine chiuse in anticipo all'ora (+1,5 % di pagine su ~20 000/h); `swr.py` li raggruppa. Diario: un solo record cumulativo (`FIFO riall +N`) ogni 120 s. **Non si e' evitato il GAP** (i campioni buttati sono tempo perso e il tempo di pagina si falserebbe). «Zero sfasamenti» **non raggiunto alla fonte** (e' il sensore), raggiunto per i dati a riposo.
- **Contatori di `PROVA_FIFO`** (riga `n ok sw d s r b`): campioni, plausibili (|a| = 1 g), scambiati (stesso criterio di `swr.py`, **vale solo a riposo**), `d` riallineamenti con dati scartati, `s` **sospetti** (salti di contenuto), `r` ricerche eseguite, `b` ricerche con `s != 0` (riallineamenti dal contenuto); seconda riga `gmax ovr dia reg`.
- Statistiche: chiusura byte 31..34 (disallineamenti, parole scartate **saturate**), diario `FIFO riall`. `vImuAvvia()` controlla anche CTRL2_G, FIFO_CTRL5 e FIFO_CTRL3. L'overrun resta come prima. Costo CPU: ~2 transazioni I2C ogni 20 ms in piu'.
- `vQuiete` ora vede il giroscopio vero: lo stop per quiete (180 s) deve tornare a scattare (caso 13).

### Comandi di prova (`PROVE_GUASTI`, predefinito **0**; build di prova con `-DPROVE_GUASTI=1`; **prima di ogni rilascio `PROVE_GUASTI = 0`**)
Sulla caratteristica COMANDI `0004` (**aperta**: chiunque in portata puo' mandarli, per questo vanno spenti in produzione) anche in registrazione, e sulla seriale: `PROVA_CRASH` (HardFault vero: `udf`), `PROVA_BLOCCO` (ciclo infinito: watchdog dopo 8 s), `PROVA_RESET` (reset software), `PROVA_FIFO,<s>[,<modo>]` (solo modalita' normale; modo 0 normale, 1 taglio di 3 parole con riallineamento, 2 taglio senza riallineamento, 3 senza riallineamento ne' taglio), `PROVA_TEMPI` (misura diarioFlush e regScrivi), `PROVA_TEMPO` e `PROVA_AVVIO` (per `misura_avvio.py`). I messaggi di CONTROLLO del display (protocollo di sincronizzazione) non sono stati toccati.

### swr.py
Legge i campi nuovi del segmento (origine, riprese, marca, RESETREAS, tipo di guasto, PC/LR/CFSR/HFSR, fase) e della chiusura (disallineamenti, parole scartate); il riassunto mostra «origine», «GUASTO», «FIFO» e avvisa con **ATTENZIONE** se trova campioni con acc/giro scambiati (|giro grezzo| x 0,488 mg ~ 1 g e |acc| < 0,5 g) e quanti. `python test_swr.py`: 45 test, dati inventati.

### Non verificato / rischi
- Tutti i casi **a batteria** (sonno a stacco USB, ripresa, seconda rete, protezione dai cicli, System OFF con WDT): solo scritti e compilati, non provati. Anche la registrazione con il nuovo `vServi` non e' stata provata in vasca (provata solo con `PROVA_FIFO` su USB).
- Il contesto in RAM sopravvive al bootloader su questa build; non e' garantito per ogni layout.
- Con `GPREGRET2` persa e `/reg.bin` attivo la ripresa parte anche dopo giorni se l'ultimo segmento e' senza chiusura e si ricollega la cella (una connessione USB nel frattempo annulla lo stato).
- La ripresa lascia un buco nei dati (~8 s col watchdog) e un nuovo segmento: il tempo fra segmenti non e' collegabile.
- `TinyUSBDevice.mounted()` puo' essere falso con PC molto lenti all'enumerazione (>3 s): il diario dira' `caricatore` e poi si correggera' in `PC`; non cambia il comportamento.

### Revisione del 2026-11-11 (correzioni dopo la revisione indipendente)
- **Regola di rilascio: prima di ogni rilascio `PROVE_GUASTI = 0`** (e' il predefinito). La build per la prova a secco si compila con `--build-property compiler.cpp.extra_flags=-DPROVE_GUASTI=1` (script: `arduino-cli compile --fqbn Seeeduino:nrf52:xiaonRF52840Sense --build-property "compiler.cpp.extra_flags=-DPROVE_GUASTI=1" ...`); e' riconoscibile dalla versione `xiao-0.6.1-prove` (caratteristica 0007, log di boot), dal diario (`AVV ... PROVE`) e dalla pagina di segmento (versione `0.6.1p`). Con 0 i comandi `PROVA_*` non esistono: rispondono `X non supportato` (BLE) o `X comando` (seriale), **verificato sulla build 0**. La build di prova e quella normale hanno lo stesso `VER_NUM` (0.6.1, il marcatore dell'OTA): l'OTA fra le due viene rifiutata come «stessa versione», si cambia build via USB.
- **Protezione dai cicli**: `riprese = max(contatore in /reg.bin, nibble della marca GPREGRET2) + 1`; il file e' di 3 byte con checksum e si scrive **atomicamente** (si scrive `/reg.tmp` e lo si rinomina su `/reg.bin`, `lfs_rename` e' atomico). File mancante = nessuna ripresa dalla seconda rete (resta la marca); file presente ma corrotto = prudenza (attivo, riprese al massimo: la prossima ripresa viene rifiutata). Con `/reg.bin` cancellato la tag si ferma comunque alla quarta ripresa grazie alla marca. Il contatore si azzera anche dopo **10 minuti di registrazione stabile** (una sola scrittura di `/reg.bin`, FIFO svuotato subito prima).
- **Vitalita' del flusso dati**: in registrazione, se `vCampioni` non cresce per 5 s si smette di servire il watchdog (`wdtSospeso`): dopo al piu' 8 s scatta il reset e la ripresa automatica, che **riaccende l'IMU** (`imuAccendi`). Si e' scelto questo e non una chiusura con ERRORE perche' chiudere perderebbe il resto dell'allenamento mentre la ripresa lo salva; il limite di 3 riprese consecutive evita i cicli. Diario `NOTA 6`.
- **Misura dei tempi con il BLE in annuncio** (`PROVA_TEMPI`, tag su USB, BLE non collegato): `diarioFlush` **400-625 ms** (800 ms quando il file ruota), `regScrivi` fino a **1217 ms**. Sono stalli veri del loop (la flash interna con il SoftDevice cancella pagine da 85 ms e aspetta gli slot radio). Con il FIFO da ~1,6 s reggono, ma con un collegamento BLE attivo possono allungarsi e portare a un overrun. Per questo: (a) fuori dalla registrazione (partenza, chiusura) nessun problema; (b) in registrazione il diario si scrive **al massimo ogni 120 s** (non 15), dopo aver svuotato il FIFO, e i riallineamenti del FIFO sono **un solo record cumulativo**; (c) `regScrivi` in registrazione solo al decimo minuto (una volta per catena). Il massimo reale si legge nel diario a fine registrazione: `NOTA 7 <diarioFlush ms> <regScrivi ms> <statGapMax ms>`. **Da verificare in vasca** con la tag collegata al display; se `statGapMax` si avvicina a 1000 ms, passare il diario a un registro in flash raw (pagina dedicata con record da 12 byte in append, senza LittleFS: scrittura da pochi ms): proposta non realizzata.
- **Watchdog nelle scansioni**: servito anche in `anello.scansiona` (ogni 32 blocchi) e in `memInit`. **`DUMP` seriale**: se il PC smette di leggere, `Serial.write` si blocca, il watchdog scatta dopo 8 s e la tag si riavvia (nessun dato perso: lo scarico e' di sola lettura); riaprire la porta e ripetere `DUMP`.
- **Stati silenziosi a batteria**: i LED restano spenti a batteria (decisione 2026-11-10), con tre eccezioni: **un solo lampo da 15 ms** (aggira `ledScrivi`) per (a) ripresa dopo guasto = giallo, (b) avvio senza motivo che porta al sonno = blu, (c) IMU muto = rosso. Consumo: ~15 ms x pochi mA = ~0,05 mC per evento, trascurabile (una cella da 40 mAh = 144 C); i casi sono rari.
- **`VCAL,<mV>`** (taratura) solo con USB come nome e colore (`X solo con USB`); `VCAL` senza argomento legge.
- **Controllo di `&ctxRam`**: all'avvio si logga l'indirizzo (`ctx 2000EED4`) e, se cadesse in `[__bss_start__, __bss_end__)` (lo startup lo azzererebbe), compare `IN BSS!` e il diario `NOTA 8`.
- **USB instabile (2026-11-11)**: la tag, collegata al PC, si era addormentata dopo 0,5 s senza VBUS e poi, risvegliata 3 volte dall'USB, leggeva ancora `vbus0` all'avvio e tornava a dormire. Ora: (a) USB staccata = **2 s** di assenza continua (`VBUS_ASSENZA_N`); (b) avvio causato dall'USB ma VBUS non visto: attesa fino a **1 s** (`VBUS_ATTESA_AVVIO_MS`), diario `NOTA 12 <visto> <ms>`; (c) `sistemaOff()` (usato da tutti i sonni) e il falso risveglio **non entrano mai in System OFF con VBUS presente**: riavviano in modalita' normale, diario `NOTA 11 <marca>`. Caso 40 di `PROVA-0.6.1.md`.
- **LED della gestione dei tocchi visibili anche a batteria (2026-11-11, richiesta dell'utente)**: dopo il doppio tocco che sveglia il chip (~0,5 s di bootloader) si accende il **blu** (aspetta, ~150 ms); poi **verde** finche' e' aperta la finestra dei tocchi di conferma (3 s; si spegne un attimo a ogni tocco contato); se non arrivano abbastanza tocchi **rosso per 2 s**, poi spento e di nuovo in sonno. Se la registrazione parte, **3 lampi verdi** e da li' LED di nuovo spenti a batteria (`ledTocchi`). Anche i lampi di errore all'avvio della registrazione e la sequenza AZZERA restano visibili.

### Tempo di sessione continuo dopo le riprese (sincronizzazione con il video)
Dopo un riavvio `millis()` riparte da 0: ogni segmento ripreso salva nella pagina di segmento lo **scarto** da sommare ai suoi millis (byte 64..73, `swr_formato.h`): `tempo di sessione = millis + scarto`.
- `scarto = scarto precedente + istante del reset + T_AVVIO`. L'**istante del reset** (millis del vecchio avvio) lo salvano `HardFault_Handler` e l'IRQ del watchdog nel blocco RAM NOBITS `ctxTempo` (origine «gestore», esatto a ~1 ms). Senza gestore (assert del SoftDevice, reset software, lockup) si usa l'**ultimo vivo** = millis dell'ultimo `cane()` (+8 s se la causa e' il watchdog). **RAM persa** (brownout, System OFF): origine «sconosciuta», il segmento dice «tempo non continuo» e la catena resta persa fino alla prossima partenza a tocchi. Un **contatore di avvii** nel blocco conta anche gli avvii andati in crash prima di scrivere il segmento (lo scarto si accumula comunque in RAM) e finisce nel segmento (byte 71). Il margine d'errore (byte 69..70) somma `T_AVVIO_ERR_MS` (30 ms) per ogni riavvio, piu' 60 ms con origine «ultimo vivo». Il T_AVVIO usato e' nel segmento (byte 72..73): `swr.correggi_scarto()` lo ricalcola con un valore migliore.
- **T_AVVIO MISURATO dal PC** (`misura_avvio.py`, tag su USB seriale, 2026-11-11): tempo fra il reset e `millis() = 0` del nuovo avvio (bootloader + avvio). Crash (HardFault): **n = 10, media 499,8 ms, min 495,0, max 518,1** (due avvii a ~517 ms, gli altri 495,0-496,0). Watchdog: **n = 6, media 495,6, min 495,2, max 496,0**. Misura BLE con la tag su USB (n = 3, crash): 493,2 ms (min 487,6, max 501,8; rtt BLE 15-30 ms, quindi +-8 ms). Costante `T_AVVIO_MS = 500`, `T_AVVIO_ERR_MS = 30`.
- **Margine d'errore risultante** (per riavvio): crash e watchdog con gestore ~30 ms (+ BLE: ~8 ms di incertezza della misura); senza gestore ~90 ms; dopo piu' riavvii si somma. Un ciclo completo di 3 riprese col gestore: ~90 ms.
- **Casi NON coperti**: (1) **T_AVVIO senza VBUS (a batteria)** non e' misurato: il bootloader potrebbe comportarsi diversamente (niente USB da enumerare). Lo script per la prova vera esiste (`misura_avvio.py --ble auto` con la tag in registrazione a batteria, vedi sotto): va eseguito dall'utente e il valore corretto messo in `T_AVVIO_MS`. (2) RAM persa (brownout): tempo non continuo, non recuperabile. (3) La seconda rete (`modalitaVasca(2)`) con RAM valida usa il blocco; con RAM persa e' «sconosciuta». (4) Deriva dell'orologio della tag (RC/cristallo ±250 ppm: ~2 ms in 8 s). (5) Il margine non include l'errore di sincronizzazione video/PC dell'utente.
- **Come misurare a batteria (per l'utente)**: compilare e caricare la build di prova; staccare l'USB; avviare la registrazione con i 4 tocchi (2 tocchi, blu, 2 tocchi); sul PC (con Bluetooth) `pip install bleak pyserial` e `python misura_avvio.py --ble auto --guasto crash -n 10`, poi `--guasto blocco -n 5` (la tag si riavvia e riprende da sola: lo script si riconnette); confrontare con i valori su USB e, se differiscono, aggiornare `T_AVVIO_MS`. Ogni ripetizione consuma una ripresa (max 3 consecutive): lo script non puo' farne piu' di 3 senza chiudere la registrazione: dopo 3 ripetizioni staccare e rifare i 4 tocchi (o provare 3 per volta).

### Seconda revisione del 2026-11-11 (correzioni)
- **Uscite anticipate dalla modalita' vasca** (`uscitaAnticipata`): lo stato «registrazione in corso» (marca GPREGRET2 e `/reg.bin`) non resta mai armato. Durante una **ripresa** (origine != 0), se l'IMU non parte (`imuAccendi`, `vImuAvvia`) o la flash/memoria non rispondono (`memInit`, `apri`, scrittura della pagina di segmento), si fa **`NVIC_SystemReset()`** dopo aver scritto `/reg.bin` e la marca con la ripresa consumata: il reset riaccende l'IMU e il QSPI, il limite di 3 riprese chiude il ciclo. In **ogni altra** uscita anticipata (batteria < 3,4 V, formato 1 o estraneo, memoria piena, partenza a tocchi con guasto, rifiuto della quarta ripresa) si disarma (`MARCA_SLEEP`, poi `regScrivi(0,0)`): una cella ricollegata giorni dopo non riprende da sola. In tutti questi casi **un lampo rosso da 15 ms** anche a batteria (come per ripresa, avvio senza motivo, IMU muto).
- **Chiusura**: prima `MARCA_SLEEP` (istantanea), poi `/reg.bin` (~1 s misurato): un guasto in mezzo lascia la marca gia' disarmata (con la sola marca disarmata e `/reg.bin` ancora attivo l'avvio con USB annulla lo stato, senza USB la tag dorme).
- **Watchdog sospeso**: `wdtSospeso` si rimette a false all'uscita dal ciclo di registrazione (la chiusura e gli annunci durano piu' di 8 s); dopo ogni stallo pianificato (`diarioFlush` periodico, `regScrivi` del decimo minuto) `tVivo` si riparte, cosi' lo stallo non conta come flusso fermo.
- **Diario sicuro rispetto alle callback BLE**: `diario()` accoda dentro una sezione critica (`taskENTER_CRITICAL`), `diarioFlush()` copia e svuota la coda nella sezione critica e scrive la copia fuori: gli eventi arrivati durante la scrittura finiscono nella coda nuova, nessuno si perde.
- **Parole scartate**: somma **saturata** a 0xFFFE (`swrfSatSomma`).
- **Timestamp** dei 6 insiemi dopo un sospetto: ~4,8 ms l'uno, l'ultimo al tempo attuale (prima due insiemi avevano lo stesso tempo).
- **Stalli con BLE collegato (D3)**: `ble_carico.py` (client `bleak` collegato, notifiche abilitate) lancia `PROVA_FIFO,<s>,5`: il servizio del FIFO gira come in registrazione (ogni 20 ms) con un `diarioFlush` ogni 10 s e un `regScrivi` ogni 60 s (su file di prova). **Risultato, client collegato, modo 5 (stalli grezzi, 180 s): `gmax` 2037 ms, overrun 2, `diarioFlush` max 931 ms, `regScrivi` max 2014 ms: criterio (gmax < 1000 ms, overrun 0) NON rispettato.** Per questo nel ciclo di registrazione **niente scritture flash finche' un client BLE e' collegato** (diario e reset del contatore a 10 min aspettano lo scollegamento o la chiusura; il diario scrive comunque con >= 32 eventi in RAM). Modo 6 (stessa regola, client collegato, 150 s): **`gmax` 31 ms, overrun 0**. Non spostato il diario in QSPI (tocca la mappa a 512 blocchi del display: da decidere insieme). Limite: la regola e' provata solo con un client collegato senza traffico di sincronizzazione.
- **Misure da rifare in vasca**: come nel caso 33 della prova a secco, con il display che scarica (la sincronizzazione vera non e' riproducibile dal PC: il CONTROLLO richiede il bonding).
- **Numeri aggiornati**: `python test_swr.py` = **45 test** (37 + 8 del FIFO: costanti, 10 000 urti, sfasamenti trovati in 4 condizioni, lettura senza controllo, senza sfasamenti); compilazione prove 190624 B flash (23 %), RAM 37816 B (15 %), build normale 185752 B (22 %), RAM 37784 B (15 %). Caso 26 della prova a secco: reset dopo circa **13 s** (5 s di rilevamento + 8 s di watchdog). Il commento sul diario dice 120 s (non 15). `swr.py`: il controllo dei campioni scambiati **vale solo a riposo** (messaggio e docstring aggiornati; «firmware <= 0.6.0» rimosso).

### 0.6.2 (2026-11-12): crash in sincronizzazione e banda (NON ancora caricata né provata sull'hardware)
- **Callback BLE leggere**: `inConnessione`/`inDisconnessione` e `inOta` non usano più snprintf né diario; copiano un evento in una coda (`evConn`, 8 posti) e il loop fa log, diario e richieste di PHY 2M / DLE / intervallo 7,5-15 ms (`connEventiServi()`, da `syncServi()`). `inControllo`/`inComando` erano già solo copie.
- **Stack**: loop 4 KB, task «Callback» 3 KB, «BLE» 5 KB (default del core) sono costanti del core (`main.cpp`, `bluefruit.cpp`); dalla 0.6.3 lo stack BLE si porta a 10 KB con `-DCFG_BLE_TASK_STACKSIZE=(256*10)` (in word da 4 byte, obbligatorio: senza il flag lo sketch non compila, `#error`), vedi sopra. Nuovo `stackMonitor()` (ogni 5 s, `uxTaskGetSystemState`): minimo libero per task nel diario (NOTA 13, sotto 512 B) e nella DIAGNOSI. HardFault (PC/LR/CFSR in RAM non inizializzata) e RESETREAS nel diario c'erano già dalla 0.6.1.
- **DIAGNOSI** (0x07, solo con PRONTO versione 2): motivo dell'ultimo reset + ultime righe del diario, vedi `docs/SINCRONIZZAZIONE.md`.
- **Banda**: frammenti da 238 B (PRONTO v2 e MTU 247; ricaduta a 128), `HVN_CODA` 8, invio in ciclo finché la coda radio accetta (tetto 40 messaggi per chiamata), annuncio a 100 ms con blocchi in attesa e 200 ms altrimenti, `carSyncDati` maxLen 244. Finestra di conferma invariata (2 blocchi).
- **Da verificare al primo avvio**: `Bluefruit.begin` con HVN 8 (RAM del SoftDevice; se fallisce: log `BLE begin KO`, riportare `HVN_CODA` a 6 o 4), banda reale, compatibilità con display-sync (PRONTO v1).
