PZero/SwimTimer/firmware/display-sync/src/trgb/LEGGIMI.md

# Driver LilyGO T-RGB

Copia senza modifiche di LilyGo-T-RGB 1.0.5 (licenza MIT, vedi LICENSE), senza `LV_Helper` (richiede LVGL).
Va compilato con il core Arduino ESP32 2.0.x e SensorLib 0.2.3, come indicato da LilyGO: vedi `../../platformio.ini`.
