PZero/SwimTimer/hardware/nrf52840/progetto.md

# Tag su misura nRF52840 — progetto (proposta)

**Stato:** studio del 2026-10-25 (schema e PCB v0.2 fatti; v0.3 in corso, vedi sotto), nessun acquisto. Componenti in `bom.md`. Prototipo attuale (ESP32-S3 SuperMini + BMI160) in `../bom.md` e `../schema.md`.

**Obiettivo:** tag da portare sotto la cuffia, ~19 × 21 × 7,2 mm resinato (disposizione B), con sensore di profondità e vibratore, LiPo ~20 mAh, ricarica a contatto in una custodia tipo AirPods, prodotto e montato da JLCPCB.

## Schema a blocchi

```
 custodia (5 V, molle pogo + magneti)
   │ VIN   GND
   ▼
 [TVS] → [Schottky] ──┬──► BQ25101 (13,5 mA, 4,2 V) ──► LiPo 20 mAh (con PCM)
                      │        │ /CHG → GPIO               │ BAT
                      └─ 1M/1M → GPIO "in custodia"         ▼
                                                    VDDH  nRF52840 (MDBT50Q)
                                                          REG0 LDO → VDD 3,3 V (UICR.REGOUT0)
                                                          REG1 DC/DC → core
                                                          SAADC: VDDHDIV5 = misura batteria
                         VDD 3,3 V ─┬─ LSM6DSV16X  (SPI, INT1/INT2: dati pronti, risveglio)
                                    ├─ W25Q256JV   (QSPI, 32 MB)
                                    ├─ MS5837-02BA (I2C, profondità)
                                    └─ LED rosso 0603 (anodo sulla batteria, GPIO in assorbimento)
                         VDDH ──[2×47 µF]── vibratore Ø 6 mm ── N-MOSFET ← GPIO (PWM)
                         SWD: piazzole interne per il primo avvio (sotto la resina)
```

Note di progetto:
- **VDDH direttamente dalla LiPo** (modo "alta tensione" dell'nRF52840): niente regolatore esterno. ⚠ In questo modo VDD esce a **1,8 V di serie**: il firmware (o il primo flash) deve scrivere `UICR.REGOUT0 = 3,3 V`, altrimenti la flash a 3 V non parte. VDD a 3,3 V (deciso in v0.1 per il LED e la flash) permette di usare la batteria fino a ~3,5 V.
- **Batteria con VDDHDIV5** sul SAADC: nessun partitore esterno, nessuna perdita a riposo (SlimeVR usa un partitore con interruttore; qui non serve).
- **IMU su SPI** (8 MHz, meno tempo di CPU sveglia rispetto all'I2C) con FIFO: l'nRF si sveglia ~3 volte al secondo, legge un blocco e torna a dormire.
- **Le piazzole non portano mai la tensione della batteria**: senza custodia VIN è tirato a massa dal partitore → niente elettrolisi in acqua tra i contatti.
- **Risveglio**: dall'IMU (movimento o doppio tocco, come sul prototipo) e dal pin "in custodia" (estrazione = accensione, inserimento = sonno e ricarica).

## Cosa riusare dai progetti SlimeVR nRF

Fonti: [SlimeVR-Tracker-nRF](https://github.com/SlimeVR/SlimeVR-Tracker-nRF) (firmware, Zephyr/nRF Connect SDK, licenza MIT/Apache 2.0), [SlimeVR-Tracker-nRF-PCB](https://github.com/SlimeVR/SlimeVR-Tracker-nRF-PCB), [slimenrf3 su OSHWLab](https://oshwlab.com/sctanf/slimenrf3), [documentazione Smol Slimes](https://docs.slimevr.dev/smol-slimes).

| Area | Cosa fanno | Cosa riusiamo |
|---|---|---|
| Moduli | slimenrf r3 = Ebyte E73 (nRF52840); versioni precedenti con Insight SiP ISP1807 e ISP1507 (8 × 8 mm); molti cloni "SuperMini nRF52840" | conferma che E73 e ISP1807 sono montabili e funzionano; ISP1807 per la v2 ultra piccola |
| IMU | driver con FIFO per LSM6DSV, LSM6DSO/DSM, ISM330BX, ICM-45686, ICM-42688, BMI270; la loro classifica mette LSM6DSV e ICM-45686 ai primi posti | scelta dell'IMU, configurazione FIFO, calibrazione del giroscopio, uso del clock esterno dell'IMU (`clk-gpios`) |
| Magnetometri | MMC5983MA, BMM350, LIS2MDL… | non servono a noi (direzione assoluta inutile in vasca) |
| Carica | caricatore con pin `chg`/`stby` letti dal firmware; pin `dock` per la base; base di ricarica con 3 contatti per 8 tracker a 300 mA | lettura stato di carica, rilevamento custodia, idea della base a 2–3 contatti |
| Batteria | partitore con interruttore (`power-gpios`) sul SAADC | noi usiamo VDDHDIV5 (più semplice) |
| Alimentazione | DC/DC (`reg1` in modo DCDC), opzionalmente LDO separato | DC/DC attivo su REG1 |
| Sonno | System OFF con risveglio dall'IMU (`int0-gpios`) o pulsante | stesso schema |
| Bootloader | UF2 (Adafruit) su USB | **diverso**: niente USB nel tag sigillato → MCUboot + aggiornamento via BLE (SMP/mcumgr) |
| Radio | ESB proprietario verso un dongle | **diverso**: BLE verso display e pagina web |

Anche Zephyr ha già i driver: `st,lsm6dsv16x`, `invensense,icm45686`, `meas,ms5837`, `nordic,qspi-nor`.

## Memoria: 32 MB

| Frequenza | Dati per ora (6 assi × 16 bit + tempo + intestazioni) | Ore in 32 MB (~31 MB liberi, 1 MB per la copia del firmware di MCUboot) |
|---|---|---|
| 50 Hz | ~2,8 MB | **~11 h** |
| 100 Hz | ~5,5 MB | ~5,5 h |
| 50 Hz + pressione a 5 Hz | ~2,9 MB | ~10,5 h |

32 MB coincidono con l'autonomia della batteria (~12 h di registrazione): 64 MB (W25Q512JV, stesso package 8 × 6) non servirebbero finché la cella è da 20 mAh. Scaricamento via BLE: una sessione di 1 h (~3 MB) in 30–60 s; la memoria piena in 5–10 min.
Trucco per i consumi: **cancellare la flash mentre è in custodia** (la cancellazione è la parte più costosa delle scritture), così in acqua si scrive soltanto.

## Bilancio dei consumi (stima, cella 20 mAh, ~16 mAh utilizzabili)

| Voce | Nuoto (registra a 50 Hz, BLE attivo) | Fermo fuori dalla custodia | In custodia, custodia scarica |
|---|---|---|---|
| IMU LSM6DSV16X | 0,65 mA (alte prestazioni) | ~5 µA (solo acc., risveglio al movimento) | 2,6 µA (spenta) |
| nRF52840 (CPU + RAM) | ~0,2 mA (letture FIFO, algoritmi) | ~3 µA (System ON in attesa) | ~1,5 µA (System OFF + risveglio sui GPIO) |
| BLE (annunci 10 Hz, 0 dBm; zero sott'acqua se si usa la pressione) | ~0,15 mA | — (o ~20 µA con annunci a 1 Hz) | — |
| Flash (solo scrittura, pre-cancellata) | ~0,04 mA | 1 µA | 1 µA |
| Pressione 5 Hz | ~0,06 mA | — | 0,1 µA |
| LED a impulsi | ~0,05 mA | — | — |
| Vibratore (~100 impulsi da 200 ms per ora, PWM 50 %) | ~0,2 mA medi | — | — |
| PCM della cella + caricatore | ~3 µA | ~3 µA | ~3 µA |
| **Totale** | **~1,35 mA** | **~12 µA** | **~8 µA** |
| **Autonomia** | **~12 h** (circa 8–10 allenamenti da 1–1,5 h) | ~55 giorni | ~80 giorni (poi interviene il PCM) |

Con l'ICM-45686 il nuoto scende a ~1,1 mA (~14 h). Ricarica a 13,5 mA: **~1,5–2 h** da vuota. Questi numeri vanno **misurati** sui primi tag montati (Nordic PPK2 o un multimetro con shunt) prima di fissare la cella.

## Ingombro stimato

Pianta in scala 1:1 in [`ingombro.svg`](ingombro.svg) (rigenerabile con `python.exe genera_ingombro.py` di KiCad: **ora disegna la v0.3 variante 1c dal PCB reale**, 26 × 30 mm; il testo di questa sezione è la storia della v0.2/Raytac). Vincolo principale dal foglio Raytac: **antenna sul bordo della scheda** e striscia di **3,8 mm senza rame su tutti gli strati**, larga quanto la scheda. Sopra al modulo, fuori da quella striscia, ci sta esattamente una cella da ~3 × 10 × 12 mm.

| Disposizione | Scheda | Tag finito (0,8 mm di resina sui lati) | Note |
|---|---|---|---|
| **A · lunga** (un solo lato) | 11,5 × 26,5 mm | **~13 × 28 × 7,2 mm** | modulo in alto, sotto la flash con il vibratore sopra, in fondo IMU, pressione, caricatore, LED |
| **B · compatta** (un solo lato) — **scelta dall'utente** | 17,5 × 19,5 mm | **~19 × 21 × 7,2 mm** | flash e vibratore a fianco del modulo, pressione e passivi in basso |
| C · due lati (non disegnata) | ~11,5 × 19 mm | ~13 × 21 × 10 mm | componenti anche sotto il modulo: più corta ma più spessa (il sensore di pressione da 2,75 mm finisce sotto), montaggio JLC più caro, poco posto per il vibratore |

Spessore di A e B: resina sotto 0,5 (copre le piazzole SWD) + PCB 0,8 + modulo 2,05 + biadesivo 0,2 + cella 3,0 + resina sopra 0,6 ≈ **7,2 mm**; il vibratore (2,7 mm) sta sopra la flash (0,75 mm) senza aumentare lo spessore. Peso stimato ~4–5 g.
Contatti di ricarica: due piazzole tonde Ø 2,5 mm sul lato sotto, a filo della resina; piazzole SWD sul lato sotto, annegate. Il sensore di pressione resta scoperto verso l'alto (O-ring).

Confronto: una moneta da 2 € è Ø 25,75 mm; il prototipo attuale (SuperMini 18 × 22 mm + modulo BMI160 + LiPo da 300–500 mAh) è parecchie volte più grande.

## Avviso in acqua: vibratore o cicalino

| | Vibratore (motore a moneta Ø 6 × 2,7 mm) | Cicalino magnetico passivo (es. Huaneng MLT-5020, LCSC C94598, 5 × 5 mm, 4 kHz, ~75 dB, ~0,4 $) |
|---|---|---|
| Chi lo percepisce | tutti, anche i non udenti | solo chi sente; sotto la cuffia arriva per via ossea (come il metronomo FINIS Tempo Trainer) |
| Dubbio | sotto la cuffia e in movimento potrebbe sentirsi poco | potrebbe sentirsi troppo o disturbare chi nuota vicino |
| Intensità regolabile | sì, PWM sulla tensione del motore (soglia minima per partire) | **sì**: duty cycle del PWM (volume) e frequenza (tono; più forte vicino a 4 kHz). Livello impostabile dalla pagina web o dal display |
| Consumo | 50–80 mA mentre vibra | decine di mA, molto meno a volume basso |
| Ingombro sulla scheda B | sopra la flash, nessun mm in più | 5 × 5 mm sulla scheda: con entrambi la scheda passa da 19,5 a ~21 mm (tag ~19 × 22,5 mm) |

**Consiglio:** puntare sul **vibratore** come avviso principale (vale per tutti, discreto, non disturba la corsia) e decidere con una **prova sul prototipo ESP32**, prima dello schema:
- 2 motori a moneta (Ø 6 e Ø 8 mm, per confronto), 1 cicalino MLT-5020, 2 MOSFET AO3400 (SOT-23, facili da saldare a mano), 2 diodi 1N4148, resistenze; ~5 € in tutto.
- Firmware di prova: impulsi singoli, doppi, lunghi; intensità in PWM a 3–4 livelli; da provare sotto la cuffia, prima a secco poi nuotando.
- Se il vibratore si sente bene: solo vibratore. Se è al limite: entrambi sulla scheda (+1,5 mm) e scelta dall'utente nelle impostazioni.

## Sigillatura in resina

- Guscio stampato in 3D (o stampo in silicone) riempito di **resina epossidica o poliuretanica a basso ritiro**; colata sotto vuoto o con degasaggio per evitare bolle sui componenti BGA.
- **Restano fuori dalla resina**: le piazzole di ricarica (a filo della superficie) e la porta del sensore di pressione (il gel del MS5837 deve toccare l'acqua: guarnizione o O-ring intorno al cappuccio, mai resina sopra).
- LED visibile attraverso una resina trasparente o una finestrella.
- Vibratore incollato rigido al guscio prima della colata (la resina rigida trasmette bene la vibrazione; una morbida la smorza).
- **Contatti esterni: solo i 2 poli di ricarica** (più l'eventuale terzo). Le piazzole SWD servono una volta sola, prima della colata (MCUboot + firmware + prova), e poi restano annegate nella resina.
- Niente pulsanti: accensione/spegnimento dalla custodia e dai gesti (doppio/triplo tocco già usati nella pagina).
- La resina sopra l'antenna sposta un po' la frequenza: provare la portata **dopo** la colata.

## Rischi

| Rischio | Gravità | Mitigazione |
|---|---|---|
| **Corrosione dei contatti nel cloro** | alta | nessuna tensione sulle piazzole fuori dalla custodia; oro spesso (ENIG ha solo 0,05–0,1 µm: si consuma) → meglio inserti dorati o in acciaio inox sulla resina, saldati alla scheda; molle pogo e magneti nella custodia; risciacquo con acqua dolce |
| **Antenna** sotto la cuffia, vicino alla testa e all'acqua | media | il BLE in acqua non va comunque (già noto): trasmettere solo fuori dall'acqua/al muro; antenna sul bordo della scheda, zona libera da rame e componenti come da foglio Raytac; prova di portata dopo la resina |
| **Montaggio** (DSBGA 0,4 mm, LGA, modulo con piazzole sotto) | media | JLC li monta con raggi X; nessun componente 0201 fuori dai *basic*; ordinare 5 pezzi e provarne 2 prima di resinare |
| **Carica a corrente bassa** (13,5 mA) | bassa/media | il BQ2510x è fatto apposta (da 10 mA); attenzione al **timer di sicurezza fisso di 10 h** e alla soglia di terminazione (PRETERM); niente caricatori tipo TP4056 (minimo pratico ~50 mA) |
| **Picchi di corrente** su cella da 20 mAh (max 1–2 C = 20–40 mA), soprattutto il **vibratore** (50–80 mA) | alta | vibratore in PWM ~50 % a impulsi brevi, 2 × 47 µF su VDDH, niente radio/flash durante l'impulso, cella ≥ 2 C; soglia di spegnimento del vibratore sotto ~3,6 V; provarlo sul prototipo ESP32 prima del PCB |
| **Disponibilità componenti** (modulo e IMU *extended*, stock variabile) | media | verificare stock il giorno dell'ordine; riserva E73 per il modulo e ICM-45686 per l'IMU già nel progetto |
| **Primo flash e recupero**: dopo la resina l'SWD non è più raggiungibile | alta | programmare e collaudare (radio, IMU, flash, carica) **prima** della colata; da lì solo aggiornamenti via BLE con MCUboot: bootloader non aggiornabile, immagine nuova provata e confermata solo se il BLE funziona (altrimenti torna alla precedente), immagine di riserva nella flash esterna; programmatore J-Link EDU Mini o Raspberry Pi Pico come *debugprobe* con pinza pogo |
| **Porting del firmware** da Arduino/ESP32 a Zephyr | media | algoritmi già indipendenti dall'hardware e messi a punto sul prototipo ESP32; il porting si fa su un tag montato e **non resinato**, collegato all'attrezzo di programmazione |
| **Sensore di pressione** con porta esposta | media | O-ring, prova di tenuta in vasca prima di resinare le altre schede |

## Progetto KiCad v0.2 (2026-10-25)

File in [`kicad/`](kicad/), generati da script a partire da un'unica tabella di dati, così schema e PCB restano coerenti:

| File | Cosa fa |
|---|---|
| `dati_scheda.py` | componenti, codici LCSC, collegamenti, posizioni sulla scheda (**si modifica solo questo**) |
| `genera_schema.py` | scrive `swimtag.kicad_sch` (schema a etichette di rete) |
| `verifica_netlist.py` | confronta la netlist esportata da KiCad con i dati (oggi: 28 reti su 28) |
| `genera_pcb.py` | scrive `swimtag.kicad_pcb`: contorno, componenti, piani di massa, zona antenna, regole JLC |
| `posizioni_collaudo.py` / `cerca_posizioni.py` | posizioni dei componenti della variante 1c (x, y, rotazione, lato) e programma che le cerca (raffreddamento simulato, `python.exe cerca_posizioni.py L H seme passi file`) |
| `sbroglia.py` | sbroglio automatico con **Freerouting 2.5.0** (Java 25), poi riempimenti di massa |
| `esporta_jlc.py` | Gerber + fori (zip), BOM e CPL nel formato JLC, render, PDF dello schema in `jlc/` |
| `lib/` | simboli, impronte e modelli 3D scaricati da LCSC con `easyeda2kicad` |

**Scheda:** 17,5 × **22,5 mm** (v0.1 era 20,5: +1 mm per le piazzole reali della flash, +2 mm per protezione dei contatti e reset), 4 strati, 0,8 mm. Tag finito ~**19 × 24 × 7,2 mm**.
- Sopra tutti i componenti (montaggio JLC su un lato); sotto solo piazzole: 2 contatti di ricarica Ø 2,5 mm sul bordo basso (VIN a sinistra, GND a 4,2 mm), 5 piazzole SWD Ø 1 mm su due file sfalsate (VDD, SWDIO, SWDCLK, RESET, GND, per molle pogo), BAT+/BAT− sul bordo sinistro, MOT+/MOT− sul bordo destro (fili saldati a mano).
- Antenna sul bordo alto, striscia di 3,8 mm senza rame su tutti gli strati; massa su In1 (piano) e riempimenti di massa sugli altri strati.
- Regole: piste 0,127 mm (minimo 0,1), distanze 0,1 mm, via 0,5/0,3 mm (nessun sovrapprezzo), foro-rame 0,2 mm; via coperti dal solder mask (anche quelli sotto il modulo).
- **DRC: 0 errori**, 401 piste, 55 via (dopo le correzioni delle verifiche, vedi [verifiche.md](verifiche.md)). Restano avvisi di sola serigrafia (contorni delle impronte LCSC) e i pin liberi del modulo, che nello schema hanno la crocetta.

**Pin dell'nRF52840:** QSPI flash P0.17 CS, P0.19 SCK, P0.20/21/22/23 IO0–3 (pin consigliati da Raytac); IMU in SPI P0.15 SCK, P0.13 MOSI, P0.14 MISO, P0.16 CS, INT1 P0.11, INT2 P0.12; pressione I2C P0.26 SDA, P0.27 SCL (pull-up 10 kΩ R5/R6, come da TE); vibratore P0.08 (MOSFET, pull-down 100 kΩ); LED P0.06; stato di carica P0.04; contatti di ricarica → TVS SD05 → Schottky B5819WS → caricatore e VBUS del modulo (evento USB = "nella custodia"); reset hardware all'inserimento nella custodia (AO3400A + 100 nF + 1 MΩ su RESET); VDDH alla batteria, VDD 3,3 V da impostare in `UICR.REGOUT0`.

**Per l'ordine JLC** (non ancora fatto): `jlc/swimtag_gerber.zip`, `jlc/bom_jlc.csv`, `jlc/cpl_jlc.csv`. Opzioni: 4 strati, 0,8 mm, **ENIG** (contatti dorati), montaggio *Economic* lato sopra, raggi X per modulo e BGA. Controllare nell'anteprima JLC la rotazione dei componenti (alcune impronte risultano ruotate di 90/180° rispetto alla libreria JLC).

**Verifiche sui datasheet:** fatte il 2026-10-25, registro in [verifiche.md](verifiche.md) (4 correzioni: due 100 nF sull'IMU, pull-up I2C, 10 µF sull'uscita del caricatore, condensatori del modulo avvicinati). Restano: anteprima JLC (rotazioni e stock) e la protezione dei contatti. Il modulo Raytac non ha modello 3D (nei render si vedono solo le piazzole).

## v0.3 (2026-11-01) — solo variante "collaudo", forma 1c (quasi quadrata)

> **Modulo sostituito il 2026-11-01: Raytac MDBT50Q-1MV2 → Ebyte E73-2G4M08S1C (LCSC C356849).** Il Raytac è a **stock 0** su JLC e LCSC (decisione dell'utente). Il resto della v0.3 è invariato; cambiano pin del modulo, impronta, zona antenna, misure della scheda e spessore. Verifiche sul foglio Ebyte in [verifiche.md](verifiche.md) (ultima sezione). Il testo sotto sul "foglio Raytac" vale solo come storia; `ingombro.svg` è ora generato dal PCB reale (vedi sotto).

**Variante 1c (approvata dall'utente il 2026-11-01).** Il tag di collaudo si indossa a lungo sotto la cuffia, quindi la forma è **quasi quadrata e piatta** (la v0.3 con header 2 × 12 era 19 × 46 mm, lunga e scomoda). Cambiano rispetto al commit 2a257ff: **tolti J2 (header 2 × 12) e J3 (ponticello)**; BAT e VBAT sono uniti da uno **0 Ω 0402 (R11, C17168, basic)** che si dissalda a banco per misurare la corrente; **J1 JST SH resta** (serigrafia + e −); sul lato sotto **Tag-Connect TC2030-NL (J4)** per SWD al posto delle 5 piazzole, più piazzole di prova (Ø 0,8: CHG_N, SENS_ON, VDD_SENS, FG_ALRT; Ø 1: VBAT, VDD, GND per il tester) e due contatti di ricarica Ø 2,5 mm a 4,2 mm l'uno dall'altro. Componenti solo sul lato sopra; sotto solo piazzole.

**Stato del progetto KiCad (2026-11-01): sbrogliato.** `kicad/swimtag_collaudo.kicad_sch/.kicad_pcb` generati da `dati_scheda.py` + `posizioni_collaudo.py` (posizioni cercate con `cerca_posizioni.py`, raffreddamento simulato su lunghezza delle reti e ingombri reali): **netlist 0 differenze (36 reti), ERC 0, DRC 0 errori e 0 elementi non connessi, parità schema/PCB 0** (restano 7 avvisi di serigrafia: U5 e D4 vicini, cerchio del pin 1 di U5), **609 piste e 80 via** (Freerouting 2.5.0, 40 passate, margine di 5 µm sul minimo JLC di 0,1 mm). File per JLC in `kicad/jlc/v0.3_swimtag_collaudo/` (Gerber, BOM, CPL, render sopra/sotto/3D, PDF dello schema). I file v0.2 (`swimtag.kicad_*`, `jlc/` sciolti) restano come storico. La variante *definitiva* è prevista in `dati_scheda.py` ma non ancora implementata.

| Cambio | Come | Pin / rete |
|---|---|---|
| Batteria Ampul 401012 (40 mAh, PCM) | connettore **JST SH 1,0 mm laterale SM02B-SRSS-TB (J1)**, montato da JLC; serigrafia + (BAT) e − (GND) | rete `BAT` |
| Sensori commutati | **TPS22916C (U6)**: VDD → `VDD_SENS`; alimenta IMU (Vdd e Vdd_IO), MS5837, pull-up I2C R5/R6 e i loro 100 nF. La flash resta su VDD | ON = `SENS_ON` pad 6 (P1.13); pull-down 1 MΩ (R8) |
| Misuratore di carica | **MAX17048 (U7)** sul VBAT lato sistema, 100 nF, secondo bus I2C con pull-up 10 kΩ (R9/R10) su VDD sempre acceso | SDA2 pad 34 (P0.22), SCL2 pad 35 (P0.24), ALRT pad 4 (P0.28) |
| Sospensione carica | pin TS del BQ25101 a un GPIO, R2 10 kΩ resta | `TS` pad 2 (P1.10) |
| Condensatori | 2 × 47 µF 0805 (C10, C11) su VBAT; 10 µF su VDDH (C7) e 10 µF sull'uscita del caricatore lato batteria (C12) | |
| Corrente | **R11 = 0 Ω 0402** (C17168, basic) tra `BAT` (cella e caricatore) e `VBAT` (circuito): si dissalda a banco e il tester va in serie (C12 resta sul lato batteria, vicino al caricatore) | la carica non passa dallo 0 Ω |
| Collaudo | niente header: **Tag-Connect TC2030-NL (J4)** sul lato sotto per SWD + 7 piazzole di prova sotto | vedi sotto |
| Misure | scheda **26,0 × 30,0 mm** con l'E73 (v0.3 con header: 19 × 46; Raytac 17,5 × 34,5; v0.2: 17,5 × 22,5), vedi sotto | |

**Pin del modulo scelti (E73, rete → pad → GPIO).** Fonte: foglio Ebyte cap. 3 e Nordic PS. SPI, I2C e QSPI solo su pin non "bassa frequenza"; sui pin lenti (colonna sinistra, pad 2-10) solo segnali statici.
- Alimentazione e sistema: VDD 19, VDDH (`VBAT`) 23, VBUS (`VIN_D`) 27, GND 5/21/24, RESET P0.18 26, SWDIO 37, SWDCLK 39.
- Lenti: TS 2 (P1.10), CHG_N 3 (P0.03), FG_ALRT 4 (P0.28), SENS_ON 6 (P1.13), IMU_INT2 7 (P0.02), IMU_INT1 8 (P0.29), LED 9 (P0.31), MOT_PWM 10 (P0.30, **PWM ≤ 10 kHz**).
- QSPI (qualsiasi GPIO, registri PSEL): CS 12 (P0.26), IO1 14 (P0.06), IO2 15 (P0.05), IO3 16 (P0.08), SCK 17 (P1.09), IO0 18 (P0.04); i pin consigliati da Nordic non sono esposti tutti (P0.19, 21, 23 mancano).
- IMU in SPI: SCK 20 (P0.12), MOSI 22 (P0.07), MISO 28 (P0.15), CS 30 (P0.17). I2C sensori: SDA 32 (P0.20), SCL 33 (P0.13). I2C misuratore: SDA 34 (P0.22), SCL 35 (P0.24).
- Liberi: P1.11, XL1/XL2 (11, 13, per un eventuale quarzo), DCCH, USB D±, P1.00, P1.02, P1.04, P1.06, NFC.

**Lato sotto (variante 1c).**
- **J4 Tag-Connect TC2030-NL** (6 pad Ø 0,787 mm a passo 1,27 + 3 fori di allineamento NPTH Ø 0,99; impronta KiCad `Tag-Connect_TC2030-IDC-NL`, dal disegno Tag-Connect). Pinout standard ARM SWD: **1 VREF (VDD), 2 SWDIO, 3 RESET, 4 SWDCLK, 5 GND, 6 SWO non collegato**. Sta sotto il corpo del modulo (x = 13, y = 9,5): sul lato opposto non ci sono pad, ma i 3 fori passano sotto l'E73 (controllo DRC `npth_inside_courtyard` messo su *ignore* nel progetto per questo motivo); nessuna via sotto i pad (zona di divieto nell'impronta). Si usa il cavo TC2030-NL con i fori di centraggio.
- **Piazzole di prova** (colonna a destra, nomi in serigrafia): Ø 0,8 mm CHG_N, SENS_ON, VDD_SENS, FG_ALRT; Ø 1 mm VBAT, VDD, GND (puntali del tester). Gli altri ex pin di J2 (IMU_*, I2C_*, FG_SDA/SCL, TS) non sono più raggiungibili dall'esterno.
- **Contatti di ricarica:** 2 piazzole Ø 2,5 mm (VIN, GND) a 4,2 mm tra i centri (x = 15,2 e 19,4; y = 28,0), lontane dal Tag-Connect: servirà una base a più posti (molle pogo a passo 4,2 mm) o un solo posto per tag.
- **Vibratore: non montato sui 2 tag di collaudo** (decisione 2026-11-01). L'utente non salda, e nessun motore SMD adatto è montabile da JLC a rifusione: LEADER C2942345 e C2992359 risultano "Wave Soldering", C41348533 è alto 11 mm, KOTL C2836756 (SMT, cilindrico 3 V 90 mA) ha stock e misure non verificati. Il pilotaggio resta montato (Q1, D1, R3); MOT+/MOT− (1 × 1 mm, x = 8,6 e 10,6) restano come piazzole di prova per l'oscilloscopio, senza fili. Il vibratore arriva nella versione definitiva, dopo la prova sotto la cuffia sul prototipo ESP32; ai tag di collaudo (registrazioni per i filtri) non serve.
- Serigrafia sotto: "SwimTimer tag / v0.3 collaudo" e i nomi di tutte le piazzole; sopra + e − del connettore batteria.

**Ingombro (variante 1c, dal PCB sbrogliato; disegno in [ingombro.svg](ingombro.svg), render in `kicad/jlc/v0.3_swimtag_collaudo/` e `kicad/prova/`):**
- **Scheda 26,0 × 30,0 mm** (misurata sul contorno), 4 strati 0,8 mm. **25 × 27 e 25 × 28 mm non reggono** (flash 9,5 × 6,2 mm e J1 5,9 × 6,7 mm non entrano nelle strisce laterali larghe ~5 mm accanto al modulo, vanno nella fascia sotto, e così gli spazi per le piste mancano); 26 × 30 è la più piccola che si è sbrogliata con DRC 0.
- Modulo E73 (13 × 18 mm) in alto, antenna sul bordo alto con la **striscia di 3,7 mm senza rame su tutti gli strati**; nella fascia sotto il modulo J1 (a filo del bordo sinistro, apertura verso l'esterno) e la flash; ai lati MOSFET, caricatore, IMU, MS5837 (scoperto verso l'alto), MAX17048, TPS22916C, 2 × 47 µF e i passivi. Cella 401012 (4 × 10 × 12 mm) **sopra il modulo** (x 8-18, y 5-17 mm), ≥ 1,3 mm oltre la striscia dell'antenna. Lo spazio sopra la flash resta libero (riservato al vibratore della versione definitiva).
- **Tag finito con ~1,5 mm di resina per lato: ~29 × 33 mm**; la spina della cella (J1) a sinistra sporge ancora di ~4-5 mm (connettore + filo). **Spessore ~9,2 mm**: PCB 0,8 + modulo 3,0 + cella 4,0 + resina ~1,4 (sopra ~0,9, sotto ~0,5). Rispetto alla v0.3 con header (19 × 46 mm, ~22 × 49 con resina, fino a 30 × 52 con i pin): larghezza +7 mm, lunghezza −16 mm, area −11 %, ma forma quasi quadrata e **nessun pin che sporge**: adatta a stare sotto la cuffia.
- **Piste sotto il modulo (lato opposto, B.Cu):** solo SWD (SWDIO 2,0 mm, SWDCLK 4,1, RESET 2,5), VDD 7,2 e SENS_ON 7,1 mm (statici), GND 0,8 mm: **nessun segnale veloce** (QSPI, SPI dell'IMU, I2C) sul lato opposto al modulo, come consiglia il foglio Ebyte. I piani interni però **non sono interi**: Freerouting ha usato In1 e In2 anche per i segnali (219 e 245 mm di piste) con la massa a riempimento attorno; da migliorare nella versione definitiva con piano di massa pieno e sbroglio guidato.
- Possibili riduzioni (decisioni dell'utente): flash 16 MB (WSON 6 × 5 mm) al posto di quella da 32 MB; componenti anche sul lato sotto (JLC doppia faccia, più caro); variante *definitiva* senza piazzole di prova.

**Pendenze prima dell'ordine:** impronta MAX17048 (KiCad TDFN-8 2×2, EP 0,8 × 1,2) da confrontare con quella LCSC; nell'anteprima JLC controllare rotazione e pin 1 di U6 (TPS22916C), U7 (MAX17048), U1 (E73), J1 (JST SH, apertura verso il bordo sinistro), Q1/Q2 (SOT-23: nelle librerie JLC spesso serve +180°), D2 (LED) e D1/D3/D4 (polarità); `esporta_jlc.py` scrive in `jlc/v0.3_<variante>/` con rotazioni normalizzate 0-359.

## v0.4 / v0.5 "economica" (2026-11-02 / 2026-11-04) — registrazione dei dati grezzi dell'IMU, budget ≤ 100 €

**Scopo:** 2 prototipi montati da JLC per registrare i dati grezzi dell'IMU (definire i filtri), spesi il meno possibile (5 PCB, 2 montati, spedizione e IVA incluse, tetto 100 €). La v0.3 collaudo resta com'è e si rigenera con `SWIMTAG_VARIANTE=collaudo` (default); la v0.4 con `SWIMTAG_VARIANTE=economica`. Dati in `kicad/dati_economica.py`, posizioni in `kicad/posizioni_economica.py`, file generati `kicad/swimtag_economica.*`, file JLC in `kicad/jlc/v0.4_swimtag_economica/`, disegno in [`ingombro_v0.4.svg`](ingombro_v0.4.svg).

**Revisione v0.5 (2026-11-04), da leggere prima del resto della sezione (che descrive la v0.4: dove c'è conflitto vale questo blocco).** File: `kicad/swimtag_economica.*` e `kicad/jlc/v0.5_swimtag_economica/` (la cartella `v0.4_swimtag_economica/` resta com'è, congelata; la v0.4 si rigenera dal commit 8fd6cc0; la v0.3 resta rigenerabile con `SWIMTAG_VARIANTE=collaudo`). Titolo schema "Rev 0.5", serigrafia "v0.5 economica". **Scheda 21,59 × 28,0 mm** (larghezza invariata, +2 mm in altezza), 2 strati, 25 componenti montati per scheda, **DRC 0 errori / 0 avvisi / 0 non collegati, parità schema/PCB 0, ERC 0 errori (41 avvisi `pin_to_pin` dei pin "Unspecified" dei simboli generati), netlist 28/28 reti, `kicad/verifica_v05.py`: 100 pin attesi, 0 differenze**; 369 piste, 36 via. Piazzole sotto TP1–TP7 **alle stesse coordinate della v0.4**; nuova TP8.

Cosa cambia rispetto alla v0.4 (21,59 × 26):
1. **Interruttore di carico TPS22916C (U6, C2680319, extended, stock 1619, 0,40 $)**: VDD → `VDD_IMU` → Vdd e Vdd_IO dell'IMU con C2 e C4 (100 nF) sulla rete commutata; ON = `SENS_ON` su **P0.04 (pad 18)**, pull-down **R7 1 MΩ** (C26083, basic). Motivo: tag sigillato in resina, un IMU in latch-up si sblocca solo togliendo l'alimentazione. Nessun condensatore in uscita oltre ai 100 nF (il foglio TI SLVSDO5F non lo richiede; in ingresso bastano C1 10 µF e C3 su VDD, vicini). **R6** (100 k su CS) ora sta su `VDD_IMU`: nessun pull-up dell'IMU verso il VDD sempre acceso. Nessun altro pin dell'IMU va a VDD (INT1/INT2 sono uscite dell'IMU, senza pull-up). MAX17048 **non** rimesso.
2. **GPIO cambiati rispetto alla v0.4:** IMU_MISO pad 13 → **16 (P0.08)**, IMU_CS pad 11 → **20 (P0.12)** (P0.00/P0.01 = XL1/XL2 ora **liberi**; MISO commuta in MHz e non è su un pin "low frequency"); SENS_ON nuovo su **P0.04 (pad 18)**. Invariati: IMU_MOSI P0.05 (15), IMU_SCK P1.09 (17), INT1 P0.26 (12), INT2 P0.06 (14), CHG_N P0.20 (32), LED P0.22 (34), flash P0.13/P0.15/P0.17/P0.24, RESET P0.18, SWD. Nessun dato inviato all'app cambia.
3. **C5 (ingresso BQ25101) = 4,7 µF 10 V X5R (C23733, basic)**: prima 10 µF 6,3 V (C15525) su un ingresso a 5 V. TI SLUSBV8C: IN 1–10 µF (≥ 1 µF per l'ESD); con la polarizzazione a 5 V il 0402 10 V tiene ~2,5–3 µF effettivi.
4. **Capacità su VBAT: C6 = 4,7 µF 10 V (C23733), C7 tolto.** Prima ~20 µF nominali contro 1–10 µF consigliati da TI per OUT. Ora 4,7 µF sulla rete VBAT più i 4,7 µF già dentro il modulo E73 su VDDH (manuale Ebyte; Nordic fig. 211 chiede 4,7 µF su VDDH): ~9 µF nominali, circa 5–6 µF effettivi a 4,2 V, dentro l'intervallo TI e sopra il minimo di 2 µF in uscita (ESD).
5. **R8 100 kΩ tra VIN (TP6, anodo di D2) e GND** (C25741, basic): a tag fuori dalla base il contatto resta a ~0 V (la perdita inversa di D2 non porta VIN verso VBAT, niente elettrolisi tra i due contatti in acqua); costa 50 µA a 5 V durante la carica (0,4 % di 13,5 mA).
6. **TVS D3 bidirezionale PTVSLC3D5VB (C41408025, SOD-323, extended, stock 3384, 0,029 $)** sul contatto VIN **prima** dello Schottky: VRWM 5 V, perdita 200 nA, 0,6 pF, clamp ~20 V (BQ25101 IN regge 28–30 V). A monte di D2 perché così protegge anche D2 dall'ESD sul contatto; bidirezionale perché con la polarità invertita a 5 V non conduce (Vbr 6 V). Scartati: PTVSUC3D5VB C918847 (1 µA, 1,2 pF), unidirezionali a valle (D2 resterebbe esposto), SMF5.0A SOD-123 (più grande, 400 µA). Tutti i TVS a stock sono *extended*: +1 caricamento.
7. **Protezione dall'inversione della cella: P-MOSFET AO3401A (Q1, C15127, *basic*, stock 1,64 M, 0,096 $)** in serie al "+" di J1: **drain verso la cella** (`BAT_IN`, pin 1 di J1), **source verso il circuito** (`VBAT`: uscita BQ25101, VDDH, C6), **gate a GND con R9 100 kΩ** (C25741). Cella dritta: il diodo del corpo conduce all'inizio, poi Vgs ≈ −Vcella e il canale conduce nei due versi (scarica e carica dal BQ25101); cella invertita: gate e source a 0 V, il diodo è inverso, tutto spento. Dal foglio AO3401A: Vgs(th) −0,5…−1,3 V, Rds(on) 47 mΩ a 10 V, 60 a 4,5 V, **85 mΩ a 2,5 V** (≈ 70 mΩ a 3,0 V): a 20 mA di picco (radio + flash) cadono ~1,5 mV, a 13,5 mA di carica ~1 mV; Vgs max ±12 V (cella 4,2 V). ⚠️ Da provare a banco con cella dritta e invertita (la tensione letta dal BQ25101 è quella a valle del MOSFET).
8. **Piazzola di prova TP8 `VDD_IMU`**, Ø 0,8 mm, lato sotto, x = 17,78 mm, y = 12,70 mm (sulla riga SWD, a destra di GND), serigrafia "VDD_IMU". Nessuna piazzola per CHG_N (non c'era spazio gratis).
9. **Piste sotto il modulo:** zona senza piste su F.Cu al centro sotto l'E73 (x ±2,2 mm dal centro del modulo, y 7,4–14,8 mm). Non si può eliminare del tutto (uscite dei pad interni): la prova di portata resta obbligatoria.
10. **Serigrafia ≥ 1,0 mm** (nomi delle piazzole, titolo, "+" e "−" della cella), tratto 0,15 mm (minimo JLC).

**Perché 28,0 mm e non 26:** i 6 componenti in più (U6, R7, R8, R9, D3, Q1) hanno reso lo sbroglio a 2 strati con Freerouting impossibile a 26 e 26,5 mm (non chiudono ISET, TS e VIN_D intorno al BGA 0,4 mm del BQ25101, né MISO dell'IMU); a 27,5 mm il posizionamento chiude con pochissime soluzioni e lo sbroglio non è chiuso; a 28 mm chiude. Tag finito ~25 × 31 mm con la resina. La larghezza 20,32 mm (prova della v0.4) resta non raggiungibile.

**Per il firmware (v0.5).**
- **UICR (una volta, con SWD, cella collegata):** `REGOUT0` (0x10001304) = 5 (3,3 V; es. scrivere 0xFFFFFFFD), `PSELRESET[0]` e `[1]` (0x10001200 / 0x10001204) = 18 (P0.18 = RESET); poi un reset. Prima VDD è 1,8 V: la flash non risponde e il LED non si accende; **non toccare la flash prima del reset**.
- **LFCLK da RC** (`CLOCK_CONTROL_NRF_K32SRC_RC`): il modulo non ha il quarzo a 32,768 kHz. Dalla v0.5 P0.00/P0.01 sono liberi, ma i pad 11 e 13 restano non collegati.
- **Spegnere l'IMU:** prima di portare SENS_ON basso, **SCK, MOSI e CS a uscita bassa** (o in alta impedenza senza pull-up) e **MISO, INT1, INT2 come ingressi senza pull-up**: con VDD_IMU a 0 un pin alto alimenterebbe l'IMU dal diodo ESD (alimentazione parassita). Il pull-up di CS (R6) sta su VDD_IMU, quindi non lo alimenta.
- **Riaccendere:** SENS_ON alto → attendere **≥ 3 ms** (tON 1,7 ms a 3,6 V + avvio dell'IMU; ~10 ms per sicurezza) → CS alto, SPI modo 3 o 0 → leggere WHO_AM_I → riprogrammare **tutta** la configurazione (ODR, fondo scala, FIFO, interrupt): spento, l'IMU perde ogni registro. Per sbloccare un latch-up: SENS_ON basso ≥ 100 ms (il QOD da 150 Ω scarica VDD_IMU), poi riaccendere.
- Lettura batteria: SAADC `VDDHDIV5`; VDDH = VBAT a valle di Q1.

**Esito: scheda a 2 strati riuscita, DRC 0 errori e 0 avvisi, 0 non collegati, ERC 0, parità schema/PCB 0, netlist 24/24 reti.** Non serve passare a 4 strati. ERC: 0 errori (34 avvisi `pin_to_pin` sui pin "Unspecified" dei simboli generati, come prima). **Ricompattata il 2026-11-03: 21,59 × 26,0 mm** (era 22,86 × 26,0), 313 piste, 29 via, 0,8 mm, HASL senza piombo, componenti solo sopra.

**Contenuto (20 componenti montati per scheda):** E73-2G4M08S1C (VDDH dalla cella, REGOUT0 3,3 V da UICR, come v0.3), IMU LSM6DSV16X in SPI con INT1/INT2, flash 16 MB in SPI semplice, caricatore BQ25101, 1 LED 0603 *basic* (KT-0603R, anodo su VDD), header batteria a 2 pin, 6 resistenze, 7 condensatori, Schottky in serie ai contatti di ricarica. **Tolti rispetto alla v0.3:** MS5837 (pressione), MAX17048, TPS22916C, vibratore e pilotaggio (Q1, D1, R3 di allora), Tag-Connect, 7 piazzole di prova, TVS, MOSFET di reset (Q2, C8, R7), 2 × 47 µF, 0 Ω BAT/VBAT, pull-up I2C. BAT e VBAT sono ora la stessa rete (`VBAT`).

**Misure (ricompattazione del 2026-11-03).** Scheda **21,59 × 26,0 mm** (8,5 passi da 2,54 mm), tag finito ~25 × 29 mm con 1,5 mm di resina. Cosa è cambiato rispetto ai 22,86 mm: il modulo E73 è spostato a sinistra, con i pad esterni a **0,3 mm dal bordo** (centro a x = 7,8 mm); la striscia sinistra (D2, LED, resistenza, header) non c'è più; D1 (LED), BQ25101 e i suoi condensatori e resistenze stanno nella colonna destra (x da 15,3 mm), D2 e J1 nella fascia sotto il modulo, a sinistra della flash. **Antenna:** il foglio Ebyte non indica alcuna distanza laterale tra modulo e bordo (solo "antenna lontana da metallo"); resta la zona senza rame di 3,7 mm sul bordo alto, larga quanto la scheda, e a sinistra non c'è rame oltre ai pad del modulo. La prova di portata resta obbligatoria (⚠️ il piano di massa vicino al lato sinistro dell'antenna non è misurato). **Perché non 20,32 mm:** con il modulo a filo di sinistra la colonna destra utile è 5,0 mm meno 0,9 mm di uscita dei pad (3,8 mm per D1, BQ25101, 7 passivi, 2 resistenze); la posizione dei componenti chiude (penalità 0 a 20,32 × 25,4 e 26) ma lo sbroglio con Freerouting a 2 strati, regole JLC 0,127 mm, non chiude: su circa 100 sbroglii (una quindicina di posizionamenti con penalità 0, altezze 25,4 e 26) il migliore lascia 2 collegamenti aperti o violazioni di distanza di pochi µm (reti ISET, CHG_N, SPI dell'IMU, VDD, riempimenti di massa isolati sopra), mai DRC 0. A 21,59 mm chiude dopo ~20 sbroglii (margine di 35 µm sulla distanza in Freerouting). Per scendere ancora servirebbe lo sbroglio a mano o 4 strati (non misurato). Il flash SOIC resta (nessun WSON, nessun caricamento extended in più).

**Pinout del modulo (pad → GPIO → rete).** Segnali veloci solo su pin non "bassa frequenza" (Nordic PS).

| Pad | GPIO | Rete | Pad | GPIO | Rete |
|---|---|---|---|---|---|
| 20 | P0.12 | IMU_CS (R6 100 k a VDD_IMU) | 28 | P0.15 | FL_MISO |
| 16 | P0.08 | IMU_MISO | 30 | P0.17 | FL_CS (R5 100 k a VDD) |
| 15 | P0.05 | IMU_MOSI | 33 | P0.13 | FL_MOSI |
| 17 | P1.09 | IMU_SCK | 35 | P0.24 | FL_SCK |
| 32 | P0.20 | CHG_N (pull-up interno) | 12 / 14 | P0.26 / P0.06 | IMU_INT1 / IMU_INT2 |
| 34 | P0.22 | LED (anodo su VDD, 1 k, attivo basso) | 26 | P0.18 | RESET (`UICR.PSELRESET`) |
| 19 / 23 | VDD / VDDH | VDD (C1 10 µ) / VBAT (C6 4,7 µ) | 37 / 39 | SWDIO / SWDCLK | SWD |
| 18 | P0.04 | SENS_ON (ON del TPS22916C, R7 1 M a GND) | 5, 21, 24 | GND | |
| altri | | liberi (11, 13 = XL1/XL2 liberi; 27 VBUS non collegato) | | | |

**Pinout cambiato il 2026-11-03** rispetto alla prima v0.4 (CHG_N 3→32, LED 9→34, INT2 7→14, INT1 8→12): i pad della colonna sinistra del modulo stanno a 0,3 mm dal bordo e non hanno spazio per le piste; il firmware deve usare i nuovi GPIO (P0.20, P0.22, P0.26, P0.06). Nessun dato inviato all'app cambia. P0.00/P0.01 sono XL1/XL2: liberi come GPIO perché l'E73 non ha il quarzo a 32 kHz. Lettura batteria: canale **VDDHDIV5** del SAADC (VDDH è la cella), nessun partitore e nessun GPIO. Nessun dato inviato all'app cambia; **manca però la pressione (profondità)**: se l'app o il rilevamento la usano va segnalato all'agente `app`.

**Scelte e motivazioni.**
- **Flash 16 MB: W25Q128JVSIQ SOIC-8 208 mil (C97521), *basic*, 78 mila pz, 2,46 $.** Alternative: W25Q128JVPIQ WSON 5 × 6 (C190862, extended, 3,38 $) e XTX XT25F128FWOIGT WSON (C3202839, extended, 1,56 $). Per 2 schede: SOIC 4,93 $; WSON Winbond 6,76 + 3,07 di caricamento extended = 9,83 $; XTX 3,12 + 3,07 = 6,19 $. Il SOIC costa meno e non paga il caricamento; l'ingombro (courtyard 9,4 × 5,9 mm contro ~6 × 6) ha imposto la larghezza (21,59 mm, ex 22,86). SPI semplice (non QSPI): per l'IMU bastano pochi kB/s; IO2/IO3 (WP#/HOLD#) alti con R4 10 k su VDD. **Attenzione: 16 MB sono ~24 minuti a 960 Hz sei assi a 16 bit (11,5 kB/s, senza timestamp), ~97 min a 240 Hz, ~3 ore a 120 Hz:** scegliere la frequenza di campionamento di conseguenza (la v0.3 aveva 32 MB).
- **TS del BQ25101:** resistenza fissa **10 k verso massa (R2)**, nessun NTC e nessun GPIO: 50 µA × 10 k = 0,5 V = zona normale, il caricatore carica sempre. Costa una resistenza *basic* e zero pin. Rinuncia alla protezione termica del caricatore (la cella ha il PCM; 13,5 mA = 0,34 C). Alternativa scartata: NTC 10 k (componente in più, non giustificato a 13,5 mA). ISET 10 k = 13,5 mA, come v0.3 (verifiche.md).
- **Stato di carica:** `CHG_N` (open drain) su P0.20 (pad 32) con pull-up interno; costa solo una pista.
- **Protezione dei contatti di ricarica:** Schottky **1N5819WS (C191023, *basic*)** in serie al contatto VIN (polarità inversa, e nessun ritorno della tensione di batteria verso i contatti anche se il caricatore perdesse). TVS (extended, +3,07 $) e reset all'inserimento tolti.
- **LED:** 0603 rosso **KT-0603R (C2286, *basic*, stock 6,98 M pz il 2026-11-03, 0,0077 $)**: toglie il caricamento extended del LED (−3,07 $, ~3,3 €). **Anodo su VDD** (non su VBAT): al primo avvio VDD è 1,8 V (UICR vuoto) e con l'anodo su VBAT (fino a 4,2 V) LED e resistenza tirerebbero il pin oltre VDD + 0,3 V iniettando corrente nei diodi di protezione. Catodo → R3 1 k → P0.22 in assorbimento: con VDD 3,3 V e Vf ~1,9 V circa **1,4 mA** (a VDD 1,8 V il LED non si accende). Alternativa scartata: 0402 NCD0402R1 C130719 (extended).
- **Batteria: header SMD 1,27 mm 1 × 2 (C55213900) al posto del JST SH.** Confronto: JST SH SM02B-SRSS-TB (C160402): impronta 4,8 × 5,55 mm = 26,6 mm², 0,133 $; header SMD 1,27 mm: 2,0 × 5,2 mm = 10,4 mm² (−61 %), 0,008 $; header SMD 2,54 mm (C41417359): 3,81 × 5,8 mm = 22,1 mm², 0,028 $; header THT 2,54 (C225477): **non montabile nel servizio Economic (solo SMD)**, servirebbe il montaggio Standard (setup 25 $ invece di 8,18 $, più manodopera a mano) = circa +20 $. Tutti i connettori sono *extended* (3,07 $ in ogni caso). L'header 1,27 mm occupa meno della metà del JST e costa meno: scelto. Pin lunghi (7,2 mm totali): si accorciano dopo la saldatura dei fili; i pad sfalsati sono piccoli, serve un fermacavo o la resina. Da controllare nell'anteprima JLC che lo accetti a rifusione (`assemblyProcess` non indicato nell'API).
- **2 strati / 0,8 mm / HASL senza piombo:** regole JLC a 2 strati: piste e distanze 0,127 mm, via 0,6/0,3 mm (coperti dal solder mask), foro-rame 0,2 mm. Massa piena su B.Cu (isole di massa su F.Cu rimosse), sbroglio Freerouting 2.5.0 con margine di 20 µm sulla distanza (da ripetere finché DRC = 0: lo sbroglio non è deterministico). Zona antenna invariata: 3,7 mm senza rame su tutti gli strati, modulo a 2,2 mm dal bordo. Un 2 strati con piano di massa unico dalla parte dei contatti e piste di segnale a 0,127 mm vicino all'antenna non è stato misurato: la prova di portata resta obbligatoria.

**Lato sotto: griglia 2,54 mm.** Coordinate in mm dall'angolo in alto a sinistra (lato antenna, scheda vista da sopra, y verso il basso); la larghezza (21,59 mm) non è multipla di 2,54: vista da sotto le colonne sono a x' = 21,59 − x (la griglia dalle tacche si legge dal bordo sinistro visto da sopra, il bordo alto è lo stesso).

| Piazzola | Rete | x | y | Ø | x' vista da sotto |
|---|---|---|---|---|---|
| TP1 | VDD | 5,08 | 12,70 | 2,0 | 16,51 |
| TP2 | SWDIO | 7,62 | 12,70 | 2,0 | 13,97 |
| TP3 | SWDCLK | 10,16 | 12,70 | 2,0 | 11,43 |
| TP4 | RESET | 12,70 | 12,70 | 2,0 | 8,89 |
| TP5 | GND | 15,24 | 12,70 | 2,0 | 6,35 |
| TP6 | VIN (ricarica) | 7,62 | 17,78 | 2,5 | 13,97 |
| TP7 | GND (ricarica) | 12,70 | 17,78 | 2,5 | 8,89 |

Le 5 piazzole SWD stanno in una fila a passo 2,54 mm (5 passi dal bordo alto), i 2 contatti di ricarica a 5,08 mm l'uno dall'altro, 2 passi sotto la fila, sulle colonne di SWDIO e RESET. Le piazzole SWD (Ø 2,0) hanno 0,54 mm tra i bordi. Riferimento per la millefori: **tacche di serigrafia ogni 2,54 mm sui bordi sinistro e alto** (più lunga ogni 5 passi); l'angolo in alto a sinistra è il foro (0,0). Su una millefori le molle pogo si saldano ai fori (colonna, riga) = (2, 5), (3, 5), (4, 5), (5, 5), (6, 5) per SWD e (3, 7), (5, 7) per la ricarica, con colonna = x/2,54 e riga = y/2,54. Finitura HASL: contatti irregolari (ENIG costa di più). VDD sul pogo è solo riferimento: il tag va programmato con la cella collegata. Nell'ingombro la griglia è sovrapposta (lato sotto).

**Controlli nell'anteprima JLC:** rotazione e pin 1 di U1 (E73), U2 (LGA), U4 (BGA), U3 (SOIC-8: punto sul pin 1), J1 (header), D1 (LED 0603: catodo/anodo) e D2 (Schottky); che JLC accetti l'header C55213900 nel servizio Economic; stock dell'E73 (550 pz); che il CPL (Y negativi, come KiCad) sia letto correttamente.

**Costi v0.4 (stima del 2026-11-02, superata dal carrello reale: vedi sotto).**

**Costi v0.5 (2026-11-04), da carrello JLC reale del 2026-11-03 (montaggio *Standard*: E73, IMU e BQ25101 sono "Standard only"; ricalcolato, non rifatto nel carrello).** Il carrello (v0.4 con LED extended) era: merce 87,52 € (setup 23,02, stencil 7,39, componenti 26,95, caricamenti extended 16,63 = 5 × 3,33, SMT 0,66, raggi X 8,85, imballo 0,45, PCB 1,79) + spedizione 9,62 + IVA, dazio e gestione 31,32 (32,2 % su merce + spedizione) = **128,46 €**.

| Voce (€) | Carrello v0.4 | v0.5 |
|---|---|---|
| Setup + stencil + imballo + SMT | 31,52 | 31,57 |
| Componenti per 2 schede | 26,95 | ~27,8 (+TPS22916C, TVS, AO3401A, 3 resistenze; −C7, condensatori 4,7 µF più economici) |
| Caricamenti extended | 16,63 (5 tipi) | 19,96 (**6 tipi**: E73, IMU, BQ25101, header, TPS22916C, TVS; il LED 0603 è *basic*) |
| Raggi X | 8,85 | ~11,8 (+1 BGA, TPS22916C) |
| PCB | 1,79 | 1,79 |
| Coupon PCBA / PCB | — | −8,05 / −1,79 |
| Merce dopo i coupon | 87,52 | **~84,9** |
| Spedizione | 9,62 | 9,62 |
| IVA, dazio, gestione (32,2 %) | 31,32 | ~30,5 |
| **Totale** | 128,46 | **~125 €** (115 € la v0.4 con i coupon) |

**ENIG invece di HASL:** non verificato nel carrello; per 5 PCB 2 strati 0,8 mm piccoli JLC chiede in genere pochi dollari in più (stima **+4–8 $, cioè +5–10 € con imposte**): totale ~130–135 €. La scelta HASL/ENIG si fa all'ordine e non cambia i Gerber (la verifica consiglia ENIG per il BGA 0,4 mm del BQ25101 e l'LGA a 0,5 mm).

**Il tetto di 100 € non è raggiunto** con la v0.5 completa (~125 €): il montaggio Standard costa 23,02 € di setup contro 8,18 $ dell'Economic. Tagli (stessa formula, coupon inclusi): **senza raggi X ~109 €** (ma i BGA/LGA non verificati: rischio sul BQ25101 e sull'IMU); senza raggi X e senza TVS (−1 extended) **~105 €**; senza raggi X, TVS e header J1 (fili saldati sulle piazzole, −1 extended) **~100,5 €**; senza raggi X, TVS e TPS22916C **~99,5 €**. I tagli sono tutti rinunce a protezioni o controlli: vanno decisi dall'utente. Nel conto non sono compresi la cella, il programmatore e le molle pogo.

## Piano a tappe

**(a) Prototipo: resta l'ESP32-S3 SuperMini + BMI160** (decisione dell'utente 2026-10-25)
- Su di esso si mettono a punto gli algoritmi (registrazioni e video) e si prova l'avviso in acqua: vibratore Ø 6 mm e cicalino con un MOSFET su un GPIO, sotto la cuffia.
- Niente scheda di sviluppo nRF intermedia: il firmware Zephyr nasce direttamente sui primi tag definitivi.

**(b) Schema e PCB (KiCad)** — v0.1 fatta il 2026-10-25 (vedi sopra)
- Schema e layout 4 strati, regole e librerie JLC; simbolo/impronta MDBT50Q dal foglio Raytac.
- Firmware `firmware/tag-nrf/` su nRF Connect SDK (VS Code + estensione nRF Connect) con overlay della scheda: lettura IMU con FIFO, servizio GATT compatibile con la pagina `tools/`, annuncio BLE per il display, registrazione su flash, sonno con risveglio dall'IMU, misura della batteria, MCUboot + aggiornamento via BLE (SMP, da aggiungere alla pagina web).
- Revisione dello schema prima dell'ordine (consumi a riposo, piazzole SWD, zona antenna).

**(c) Ordine prototipi** — 5 pezzi montati da JLC (~150–250 $ con spedizione e IVA)
- **Pannello**: più tag sulla stessa scheda (proposta 2 × 3 = 6 tag, ~70 × 80 mm con i bordi), staccati con **mouse bites** (fori di rottura su linguette da 2–3 mm, dove non c'è la zona dell'antenna); il V-cut no, perché taglia da bordo a bordo e su schede così piccole è poco preciso. Bordi di servizio da 5 mm con fiducial e fori di riferimento (servono comunque a JLC per montare schede sotto i 20 mm). Pannello generato con **KiKit** (plugin di KiCad). Prezzo: JLC fa pagare il pannello per le sue misure (fascia fino a 100 × 100 mm) e lo stesso progetto ripetuto è ammesso; più progetti *diversi* sullo stesso pannello pagano un supplemento.
- Il risparmio vale per PCB e spese fisse, **non per i componenti**, che restano a tag. Proposta: 5 pannelli prodotti, **2 montati** = 12 tag (~12 × 25 $ di componenti + spese fisse), i 3 pannelli nudi di scorta.
- Collaudo a banco: carica a 13,5 mA, consumi, portata BLE, scrittura flash.
- Resinare 1–2 pezzi, prova in vasca; gli altri restano aperti per le modifiche.

**(d) Custodia di ricarica e attrezzo di programmazione** — da progettare noi (elettronica + parti 3D stampate con la Bambu Lab A1 mini, piano 180 × 180 mm)
- Stampa 3D, molle pogo dorate, magneti per allineamento e polarità, alimentazione USB-C (eventuale batteria nella custodia in una seconda fase).
- LED di carica sulla custodia (o lettura dello stato dal tag via BLE).

## Risposte dell'utente (2026-10-25) e conseguenze

- **Modulo Raytac MDBT50Q-1MV2** e **IMU a ±4 g**: confermati.
- **Autonomia richiesta: 3 ore.** Al nuoto servono ~4–5 mAh (3 h × ~1,4 mA) più qualche giorno di attesa (~2 mAh a settimana). Basta una cella da **15–20 mAh**: la 40 mAh non serve e aumenta l'ingombro, che è il vincolo principale. Si tiene la 20 mAh solo se il vibratore la richiede (picchi: 20 mAh × 2 C = 40 mA).
- **Memoria:** 3 h a 50 Hz sono ~8,4 MB. 32 MB = 3–4 allenamenti senza scaricare; **16 MB (W25Q128JV, WSON 6 × 5 mm invece di 8 × 6)** = un allenamento e mezzo, con meno ingombro. Da decidere.
- **Ingombro:** scelta la disposizione **B compatta** (~19 × 21 × 7,2 mm), vedi *Ingombro stimato*. ISP1807 scartato dall'utente.
- **Feedback in acqua:** il vibratore è l'unico avviso mentre si nuota, ma va provato: sotto la cuffia il tag è premuto sul cranio, che trasmette bene le vibrazioni. Alternativa da provare insieme: un **cicalino** piezo o magnetico (come il FINIS Tempo Trainer, un metronomo che si mette sotto la cuffia e si sente bene in acqua). Prova sul prototipo ESP32 con entrambi prima di fissare lo schema; sulla scheda si può lasciare l'impronta e montarlo o no.
- **Budget: 50 € per la sola parte JLC** (PCB + montaggio + componenti + spedizione). JLC monta **almeno 2 schede** (minimo del montaggio economico, da riverificare):

| Voce JLC (2 tag con MDBT50Q, stima) | Con sensore di pressione | Senza |
|---|---|---|
| PCB 4 strati, 5 pezzi | ~8 $ | ~8 $ |
| Spese fisse (impianto ~8 $, stencil ~1,5 $, ~5 componenti *extended* a ~3 $) | ~25 $ | ~22 $ |
| Componenti per 2 tag | ~50 $ | ~38 $ |
| Spedizione economica | ~8 $ | ~8 $ |
| IVA 22 % | ~20 $ | ~17 $ |
| **Totale** | **~110 $ ≈ 95–100 €** | **~93 $ ≈ 80 €** |

  **50 € non bastano** per 2 tag con questi componenti: il modulo da solo costa ~10 $ a tag e il minimo è 2 tag. Leve per ridurre: sensore di pressione non montato al primo giro (impronta pronta; ~−15 €), solo componenti *basic* per i passivi, vibratore saldato a mano (i fili non servono a JLC), eventuali buoni sconto per nuovi clienti del montaggio. Realisticamente **~80 € il minimo**, ~100 € completo.
- **ISP1807 (8 × 8 mm) come opzione:** sì. Non è su LCSC, ma JLC lo può comprare per noi con il servizio **Global Sourcing** (lo prende da DigiKey/Mouser, lo mette nella nostra libreria e lo monta), oppure glielo si spedisce noi (*consigned parts*). Contro: prezzo più alto (DigiKey ~12,5 $; tramite JLC alcuni utenti riportano ricarichi fino al +50 %), 1–3 settimane in più di attesa, piazzole LGA fini (montaggio con raggi X). Costo in più sull'ordine di 2 tag: **~+15–20 €**. Da verificare sul datasheet Insight SiP prima di sceglierlo: piedini VDDH e QSPI disponibili (servono per alimentazione dalla LiPo e flash da 32 MB).
- **Memoria: 32 MB confermati** (W25Q256JV).
- **Stampo per la resina:** rinviato.
- **Da progettare (elettronica + oggetto 3D):** custodia di ricarica, attrezzo di programmazione, stampo per la resina:

| Oggetto | Elettronica | Parte 3D |
|---|---|---|
| Custodia di ricarica | USB-C con resistenze CC da 5,1 kΩ, fusibile ripristinabile, LED; 2 molle pogo e 2 magneti. Basta una schedina da USB-C già pronta: il caricatore sta nel tag | guscio con sede del tag, coperchio, magneti a polarità fissa (il tag non entra al contrario) |
| Attrezzo di programmazione | 5 molle pogo sulle piazzole SWD + Raspberry Pi Pico con firmware *debugprobe*; contatti di ricarica per il collaudo | culla che allinea la scheda (o il pannello) sopra le molle |
| Stampo per la resina | — | guscio stampato che resta come involucro, oppure stampo in silicone ricavato da un modello stampato; sedi per contatti, porta del sensore di pressione con O-ring, finestrella del LED |

## Decisioni proposte (non ancora prese)

| Proposta | Motivo |
|---|---|
| Flash **32 MB W25Q256JV** (**confermato dall'utente**) | 3–4 allenamenti da 3 h senza scaricare |
| Modulo **Raytac MDBT50Q-1MV2** (**confermato dall'utente**); ISP1807 scartato dall'utente | certificato, montabile da JLC |
| IMU **LSM6DSV16X** a **±4 g** (**confermato dall'utente**), ICM-45686 di riserva | rumore 3 volte inferiore al BMI160, fondo scala cambiabile via firmware |
| VDDH dalla LiPo, VDD a 3,3 V da UICR, batteria con VDDHDIV5 | meno componenti, zero perdite di partitori |
| Caricatore **BQ25101** a 13,5 mA (deciso in v0.1) | fatto per celle piccole, protetto fino a 28 V sull'ingresso |
| Sensore di pressione **MS5837-02BA** (**deciso dall'utente** il 2026-10-25) | fase subacquea, uscita dall'acqua, BLE spento sott'acqua |
| **Vibratore** Ø 6 mm in PWM come avviso principale; cicalino MLT-5020 solo se la prova sul prototipo ESP32 lo richiede | vale anche per i non udenti, discreto; volume/intensità regolabili in PWM |
| Cella **15–20 mAh** (non 40) | 3 h di autonomia richieste; l'ingombro è il vincolo principale |
| Firmware su **Zephyr / nRF Connect SDK** con MCUboot e DFU via BLE | driver pronti, stesso stack di SlimeVR, aggiornamento senza aprire il tag |
| Piazzole SWD interne, sotto la resina (**deciso dall'utente** il 2026-10-25) | si programmano una volta prima della colata; all'esterno solo i contatti di ricarica |
| Primo ordine: 2 tag senza pannello; **pannello con mouse bites** (KiKit) dal lotto successivo | budget; il pannello conviene solo con molti tag |
| Disposizione **B compatta**, componenti su un solo lato (**decisa dall'utente**) | ~19 × 21 × 7,2 mm; montaggio JLC su un lato, più economico |
| Nessuna scheda nRF intermedia (**deciso dall'utente**): prototipo ESP32 per gli algoritmi, poi direttamente il tag definitivo | il prototipo è già montato e funzionante |
| Budget JLC: ~80 € senza sensore di pressione, ~100 € completo (obiettivo dell'utente 50 €) | il minimo di 2 tag e il costo del modulo non permettono di scendere a 50 € |
