PZero/SwimTimer/docs/DECISIONI.md

# Registro delle decisioni

| Data | Decisione | Motivazione |
|---|---|---|
| 2026-10-24 | Repository `PZero/SwimTimer`, segreti solo in `.env` | Nessuna credenziale o dato personale su GitHub |
| 2026-10-24 | Eventuale app su Firebase Spark, senza Cloud Functions | Nessuna spesa |
| 2026-10-24 | Template adattato a progetto hardware: agenti `elettronica` e `app` al posto di `frontend`/`backend` | Il prodotto principale sono due dispositivi; l'app è facoltativa |
| 2026-10-24 | Repository GitHub pubblico | Scelta dell'utente; i dati reali restano fuori da git (`dati/` ignorata) |
| 2026-10-24 | Architettura di partenza: tag BLE indossato + display a bordo vasca | Idea dell'utente; dettagli e limiti in `docs/IDEA.md` |
| 2026-10-24 | Prototipo del tag con ESP32-S3 SuperMini + BMI160 + TP4056 | Componenti già disponibili; il magnetometro si aggiunge dopo se serve |
| 2026-10-24 | Batteria direttamente sui pad BAT+/BAT− dell'ESP32, senza TP4056 né interruttore di programmazione | La scheda ha il caricabatterie integrato; meno componenti |
| 2026-10-24 | START dalla spinta (accelerometro), STOP da tag vicino + calma ≥ ~3 s, con ora presa alla decelerazione | Evita falsi STOP in virata; distanze in multipli di 100 m, display sul lato di partenza |
| 2026-10-24 | Firmware con Arduino CLI (core esp32 3.3.12), non PlatformIO | Già installato sul PC; PlatformIO resta possibile in seguito |
| 2026-10-24 | Strumento di diagnosi come pagina HTML con Web Serial (`tools/assi.html`) | Nessuna installazione; funziona in Chrome o Edge |
| 2026-10-24 | Display a bordo vasca: LilyGO T-RGB (ESP32-S3, display rotondo 480×480, touch, microSD) | Già disponibile; BLE integrato e stesso microcontrollore del tag; si legge da fermi al muro |
| 2026-10-24 | Il display riceve i dati nell'annuncio BLE (dati produttore), senza collegarsi al tag | Un solo collegamento libero per la pagina; latenza bassa; il display resta in sola ricezione |
| 2026-10-24 | Libreria BLE del core esp32 (non NimBLE-Arduino) su tag e display | NimBLE-Arduino manda in crash il tag con core 3.3.12 |
| 2026-10-24 | Driver T-RGB copiato in `firmware/display-prova/src/trgb` e adattato | LilyGo-T-RGB richiede LVGL 8.4 e SensorLib 0.2; sul PC ci sono LVGL 9 e SensorLib 0.3 |
| 2026-10-24 | Doppio framebuffer con attesa del vsync sul display | Niente tremolio negli aggiornamenti |
| 2026-10-24 | Corona del display: 3 assi di accelerazione, un giro ogni 15 s in senso orario | Stessa lettura della pagina HTML, a colpo d'occhio |
| 2026-10-24 | Cronometro di prova: parte con colpo secco, si ferma con tag vicino e fermo 3 s (ora dell'ultimo movimento) | Provabile fuori dall'acqua, dove il BLE non cade |
| 2026-10-24 | Display compilato con PlatformIO, espressif32 6.9.0 (core Arduino 2.0.17), driver LilyGO originale | Con il core 3.x il display RGB scorre e balla (contesa sulla PSRAM); LilyGO supporta solo 2.0.x |
| 2026-10-24 | Il tag resta su arduino-cli con core 3.3.12 | Funziona bene; un solo ambiente per il display |
| 2026-10-24 | Interfaccia del display: pace clock con 4 lancette (sfondo, lancette, segni), al posto del grafico degli assi | Si legge a colpo d'occhio dall'acqua; meno aggiornamenti dello schermo |
| 2026-10-24 | Lancette continue (circa 15 immagini/s), costante per tornare agli scatti di un secondo | Provato: fluido |
| 2026-10-24 | Sonno profondo: tag dopo 2 min fermo (risveglio dal BMI160 su INT1), display dopo 5 min senza tag (risveglio al tocco) | Autonomia della batteria |
| 2026-10-24 | Seriale non bloccante sul tag (`setTxTimeoutMs(0)`) | Senza PC la seriale rallentava il programma e il BLE |
| 2026-10-24 | Quadrante sempre dritto con un accelerometro sul connettore I2C del display | Il display può essere appoggiato in qualsiasi orientamento |
| 2026-10-24 | Display: risveglio anche dal tasto BOOT, pull-up su GPIO1 nel sonno, motivo dell'avvio a schermo | Riserva se il touch non risveglia; diagnosi senza seriale |
| 2026-10-24 | Confronti dei tempi con segno quando un valore arriva da un altro task (`visto` dal BLE) | La sottrazione senza segno traboccava e mandava subito il display in sonno |
| 2026-10-25 | Tag su misura: modulo Raytac MDBT50Q-1MV2, IMU LSM6DSV16X a ±4 g, sensore di pressione MS5837, piazzole SWD sotto la resina | Certificato e montabile da JLC; meno rumore del BMI160 senza saturare; programmazione una volta prima della colata |
| 2026-10-25 | Autonomia del tag: 3 ore di nuoto | Requisito dell'utente: cella piccola, l'ingombro conta più della durata |
| 2026-10-25 | Tag su misura: disposizione B compatta (scheda 17,5 × 19,5 mm, componenti su un lato, cella sopra il modulo), tag finito ~19 × 21 × 7,2 mm | Più raccolta della versione lunga; montaggio su un solo lato più economico |
| 2026-10-25 | Tag su misura: cella LiPo 15–20 mAh con protezione | Bastano per le 3 ore richieste; l'ingombro conta più dell'autonomia |
| 2026-10-25 | Programmatore e custodia di ricarica costruiti da noi (elettronica + stampa 3D su Bambu Lab A1 mini) | Scelta dell'utente: tutto l'hardware è da progettare |
| 2026-10-25 | PCB del tag v0.1: 17,5 × 20,5 mm, 4 strati 0,8 mm, generato da script KiCad e sbrogliato con Freerouting; avviso solo con vibratore | Schema e PCB coerenti da un'unica tabella; 1 mm in più per le piazzole reali della flash |
| 2026-10-25 | Caricatore BQ25101 (disponibile su LCSC) al posto del BQ25100; niente TVS né diodo su VIN, un LED rosso | Spazio sulla scheda; polarità garantita dai magneti della custodia |
| 2026-10-25 | PCB v0.2: protezione dei contatti (TVS SD05 + Schottky B5819WS) e reset hardware all'inserimento nella custodia; scheda 17,5 × 22,5 mm | Richiesta dell'utente; un terzo contatto RESET esposto in acqua rischierebbe corrosione e reset spontanei |
| 2026-10-25 | Nessuna scheda nRF intermedia: il prototipo resta l'ESP32 SuperMini, poi direttamente il tag definitivo | Il prototipo è già montato; la scheda è da progettare comunque |
| 2026-10-25 | Primo ordine JLC: 2 tag senza pannello; pannello con mouse bites (KiKit) dal lotto successivo | Budget: il pannello conviene solo con molti tag |
| 2026-10-25 | Reset del tag all'inserimento nella custodia (nessun terzo contatto esposto); watchdog nel firmware per i blocchi in acqua | Un contatto RESET in acqua rischia corrosione e reset spontanei |
| 2026-10-25 | Sbroglio automatico con Freerouting 2.5.0 (Java 25, jar verificato col checksum di GitHub) | Scheda di 17,5 × 22,5 mm con BGA a passo 0,4 mm: a mano troppo lungo |
| 2026-10-25 | Verifiche sui datasheet: due 100 nF sull'IMU, pull-up I2C 10 kΩ, 10 µF sull'uscita del caricatore, condensatori del modulo vicini a VDD e VDDH | Indicazioni di ST (AN5763), TE, TI e Raytac; vedi `hardware/nrf52840/verifiche.md` |
| 2026-10-25 | Pagina di analisi unica `tools/index.html` (3D, radar, interpretazione, registrazioni), al posto di `assi.html` | Un solo posto per vedere i dati, calibrare e rielaborare le registrazioni |
| 2026-10-25 | Calibrazione automatica: fermo in piedi 2 s per l'asse "su", cenno in avanti per l'asse "avanti" | Il tag sotto la cuffia non è mai montato nello stesso modo; senza magnetometro |
| 2026-10-25 | Registrazione sul tag con doppio tap (inizio) e triplo tap (fine), file su LittleFS; la pagina scarica e rielabora | Il BLE non passa l'acqua; la logica sta nella pagina finché gli algoritmi si mettono a punto |
| 2026-10-25 | Tap riconosciuti dai campioni (salto oltre 0,8 g), non dal motore tap del BMI160 | Il bit del motore tap non si attivava mai senza pin mappato |
| 2026-10-25 | Accelerometro a ±16 g e 100 Hz | Il ±2 g satura su tuffi e urti; la letteratura usa 100 Hz o più |
| 2026-10-25 | Flash con due copie del programma e aggiornamento via Bluetooth con ritorno automatico; ~40 min di registrazione | Non servono più cavo e tasto BOOT (con la batteria sempre collegata non si entrava in modalità BOOT) |
| 2026-10-25 | Versione numerica con marcatore nel .bin; stessa versione rifiutata, precedente con conferma; controllo sia nella pagina sia nel tag | Il firmware lo rilasciamo noi; evita caricamenti inutili o file sbagliati |
| 2026-10-25 | Firmware compilato da GitHub e pubblicato con la pagina (`firmware/tag.bin`, `tag.json`) | La pagina può aggiornare "all'ultima" anche dall'iPhone |
| 2026-10-25 | Partitore su GPIO 2 dal pin 5V; percentuale in carica stimata con correzione di 0,15 V | Sapere se è in carica; il misuratore MAX17048 resta l'alternativa precisa |
| 2026-10-25 | LED RGB del tag come riscontro (legenda nella pagina) | Prima il tag era muto: non si capiva se registrasse o dormisse |
| 2026-10-25 | Sblocco automatico del bus I2C all'avvio e dopo 20 letture fallite | Il BMI160 si era incantato tenendo SDA a 0 V |
| 2026-10-25 | Algoritmi propri, ispirati alla letteratura; origine annotata | Brevetti sul campo (es. FORM): verifica di libertà di operare prima di vendere |
| 2026-10-25 | Scheda su misura nRF52840 affidata a una sessione dedicata; prototipo resta l'ESP32 finché gli algoritmi non funzionano | Gli algoritmi sono indipendenti dall'hardware; si evita di cambiare due cose insieme |
| 2026-10-25 | Fondo scala ±16 g impostato a sensori accesi e riletto (fino a 5 tentativi) | Con il BMI160 sospeso le scritture si perdevano: ±2 g sul sensore, ±16 g nella pagina, 8 g da fermo |
| 2026-10-25 | La pagina avvisa se da fermo il modulo non vale circa 1 g | Scale incoerenti tra tag e pagina falsano calibrazione, tap ed eventi |
| 2026-10-25 | Vibrazione sospesa (serve un modulo con transistor; GPIO 5 libero) | Nessun modulo trovato da saldare; riscontro per ora dal LED |
| 2026-10-25 | Latch-up del BMI160: sul prototipo interruttore generale per spegnere tutto; firmware 0.4.4 (sensore alimentato da GPIO 5) scartato. Sulla nRF52840 load switch o P-MOSFET sul sensore | Dopo uno spegnimento brusco il sensore si sblocca solo togliendogli tensione; sul prototipo basta l'interruttore in fase di test |
| 2026-10-25 | Lezioni apprese dal prototipo in `docs/LEZIONI-APPRESE.md`, da applicare alla scheda nRF52840 | Confronto con la v0.2: mancano alimentazione commutata del sensore, misuratore di carica, spegnimento vero, etichette +/− |
| 2026-10-25 | Correzione in carica della percentuale da 0,15 a 0,05 V | Misurato col tester: 3,84 V a riposo, 3,87 V in carica; con 0,15 V la pagina segnava 29% invece di ~65% |
| 2026-10-26 | Card batteria della pagina con grafico di GPIO 1, GPIO 2, tensione stimata a riposo e livello target in % | Distinguere a colpo d'occhio partitori, batteria vera e carica mancante; il valore in carica falsava la percentuale |
| 2026-10-26 | GitHub Pages attivo (Source: GitHub Actions) | Pagina e firmware raggiungibili da iPhone (Bluefy) e aggiornamento "all'ultima" dalla pagina |
| 2026-10-26 | Il progetto della scheda nRF52840 vive nel repository privato `PZero/SwimTimer-nrf52840`; `SwimTimer` resta pubblico | Hardware della miniaturizzazione riservato; rendere privato tutto spegnerebbe GitHub Pages (piano gratuito), che serve pagina e firmware |
| 2026-11-01 | Cella LiPo **401012 Ampul** (4 × 10 × 12 mm, 40 mAh dichiarati, 4,2 V, PCM integrato, 1 C) al posto della 301012 da 20 mAh; tag stimato ~19 × 24 × 8,2 mm | Nessuna cella da 3 mm regge 2 C e nessuna 401015 con PCM trovata: stesso ingombro in pianta, 40 mA per il vibratore; capacità reale da misurare |
| 2026-11-01 | Tag v0.3 di collaudo variante **1c**: 26 × 30 mm, una faccia, modulo Ebyte E73 (Raytac a stock 0), senza header, Tag-Connect TC2030-NL sotto, BAT/VBAT con 0 Ω | Indossato a lungo sotto la cuffia per le registrazioni: forma quasi quadrata, niente sporgenze |
| 2026-11-01 | Vibratore **non montato** sui 2 tag di collaudo; pilotaggio e piazzole MOT+/MOT− restano | L'utente non salda e nessun motore SMD adatto è montabile da JLC a rifusione; per le registrazioni non serve |
| 2026-11-01 | v0.3: sensori su interruttore di carico (TPS22916C), MAX17048 su bus I2C separato, TS del caricatore da GPIO, 2 × 47 µF, 0 Ω tra cella e circuito, niente reed né protezione d'inversione (connettore polarizzato) | Risponde alle lezioni apprese del prototipo senza componenti inutili |
| 2026-11-01 | Programmazione via Tag-Connect TC2030-NL; il pin VDD è solo riferimento (VREF), programmatore a tensione adattabile | Con la cella collegata VDD è già alimentato; a 1,8 V di fabbrica un Pico a 3,3 V danneggerebbe la scheda |
| 2026-11-01 | Wallpaper tecnici e PDF di progetto generati dal PCB reale con script (`hardware/nrf52840/wallpaper/`) | Riproducibili a ogni revisione della scheda |
| 2026-11-02 | **v0.4 "economica"** su JLC con E73: solo IMU, flash, caricatore, 1 LED, header batteria; scheda 22,86 × 26 mm | Prototipi di sola registrazione dei dati grezzi dell'IMU con tetto di 100 € tutto compreso |
| 2026-11-02 | v0.4: via MS5837, MAX17048, TPS22916C, vibratore, Tag-Connect, piazzole di prova, TVS e MOSFET di reset; lettura batteria con VDDHDIV5 | Risparmio di componenti *extended* (3,07 $ l'uno) e di spazio; non servono alla registrazione (manca la profondità) |
| 2026-11-02 | v0.4: 2 strati, 0,8 mm, HASL senza piombo, DRC 0 con regole JLC 0,127 mm | Lo sbroglio a 2 strati chiude senza toccare l'antenna: nessun motivo per i 4 strati |
| 2026-11-02 | v0.4: flash W25Q128JVSIQ SOIC-8 *basic* (C97521) in SPI semplice, 16 MB | 4,93 $ per 2 schede contro 9,83 $ del WSON (caricamento extended); costa 3 mm di larghezza |
| 2026-11-02 | v0.4: TS del BQ25101 con 10 k a massa (niente NTC né GPIO), CHG_N su GPIO, Schottky *basic* in serie ai contatti | Soluzione più economica; carica sempre; polarità e ritorno verso i contatti bloccati |
| 2026-11-02 | v0.4: batteria su header SMD 1,27 mm (C55213900) invece del JST SH | 10,4 contro 26,6 mm² e costa meno; il THT 2,54 mm non è montabile nell'Economic (+~20 $) |
| 2026-11-02 | v0.4: sotto 5 pogo SWD Ø 2 e 2 contatti di ricarica sulla griglia 2,54 mm, tacche di serigrafia | Primo caricamento su millefori con pin/molle pogo saldati |
| 2026-11-03 | v0.4: LED 0603 KT-0603R (C2286, *basic*) con anodo su VDD; scheda ricompattata a 21,59 × 26 mm (E73 a 0,3 mm dal bordo sinistro, pinout dei segnali lenti spostato sui pad interni) | −3,07 $ di caricamento extended; anodo su VDD per non iniettare corrente nel pin al primo avvio (VDD 1,8 V); 20,32 mm non chiude lo sbroglio a 2 strati |
| 2026-11-03 | Programmatore: HAT 65 × 56,5 mm innestato sul 40 pin del Raspberry Pi 3/4 (OpenOCD bit-bang), pogo sulle 7 piazzole, 1 kΩ in serie su SWD, ricarica 5 V con ponticello e PTC; toner transfer | L'utente ha un Pi 3/4 e non vuole comprare altre schede; l'innesto 2×20 completo evita errori di cablaggio |
| 2026-11-03 | Regola "niente saldature" solo per il tag (tutto montato da JLC); il programmatore lo salda l'utente | Chiarimento dell'utente |
| 2026-11-04 | v0.5: TPS22916C su VDD_IMU (R6 su VDD_IMU), TVS C41408025 su VIN, AO3401A contro l'inversione della cella, 100 kΩ VIN-GND, TP8 VDD_IMU, C5/C6 4,7 µF 10 V (C7 tolto), IMU_MISO/CS su P0.08/P0.12; scheda 21,59 × 28 mm | un IMU in latch-up nella resina si sblocca solo senza alimentazione; protezioni dalle revisioni esterne; a 26 mm lo sbroglio a 2 strati non chiude; costo ~125 € (Standard), tetto 100 € non raggiunto |
| 2026-11-04 | Repository unico e **pubblico** `PZero/SwimTimer` con tutto il progetto (scheda, programmatore, sfondi, video); il privato `SwimTimer-nrf52840` dismesso | Scelta dell'utente: un solo progetto; GitHub Pages resta gratuito per la pagina di analisi e i test a secco del tag |
| 2026-11-05 | Associazione nuotatore–tag con la **base di ricarica a slot** ("pulsantiera"): gettone NFC passivo personale lasciato nello slot del tag preso; la base attiva il tag, a fine allenamento ne scarica i dati e li manda al display; tag non attivato = non registra | Il display non è touch e può essere lontano dagli atleti; niente telefono a bordo vasca; deterrente al furto |
| 2026-11-06 | v0.6 "Rev0" (`swimtag_v06`): MCP73831T-2ACI/OT (SOT-23-5, PROG 66,5 kΩ = 15 mA, STAT su CHG_N tramite 1N4148WS + pull-up 100 kΩ) al posto del BQ25101, TPS22917DBVR (SOT-23-6) al posto del TPS22916C, J1 DNP (fili a mano), 4 strati 0,8 mm (In1 massa), 21,59 × 28,5 mm | NextPCB Rev0 rifiuta i BGA con passo < 0,45 mm (DSBGA 0,4); v0.5 resta invariata |
| 2026-11-06 | README.md solo in inglese (nessuna copia italiana), senza sezione ringraziamenti per ora; documenti di lavoro in `docs/` in italiano; nuove voci del CHANGELOG in inglese | Repository pubblico con pubblico internazionale; i documenti interni restano nella lingua di lavoro |
| 2026-11-06 | Resta la v0.6 a 4 strati (non a 2): ordine NextPCB Rev0 da 20 pz in 5 pannelli 2×2, D3 sostituito con LC05CI; si attende il contatto di Viviane prima di ordinare | A 2 strati il risparmio è solo ~25–40 $ (~1,5–2 $/tag) ma la scheda crescerebbe e servirebbe nuovo sbroglio e nuova anteprima; la massa piena aiuta l'antenna |
| 2026-11-06 | Versione finale del tag senza flash esterna (solo eventi, buffer RAM ~10 s); i prototipi la tengono. XIAO nRF52840 Sense con cella LP-401230 100 mAh (minimo 50 mA di carica) valutato come tag di prova | Semplifica l'elettronica; il BQ25101 del XIAO non carica sotto 50 mA |
| 2026-11-06 | Messaggi di commit e descrizione del repository GitHub in inglese (i vecchi commit restano in italiano) | Repository pubblico con pubblico internazionale, coerente con il README |
| 2026-11-06 | Pagina web: tab XIAO con testa wireframe dalla scansione Lee Perry-Smith (CC BY 3.0, caricata da CDN, crediti in pagina), collo e spalle procedurali; calibrazione del montaggio dalla gravità + cenni | Più realistica di una testa procedurale; licenza libera con attribuzione, nessun file del modello nel repo |
| 2026-11-06 | Tag XIAO sempre sul lato destro della testa con il lato componenti verso l'esterno: tolte dalla pagina le scelte «Lato componenti» e «USB-C verso» | Con lato e verso fissi la gravità basta a ricavare anche la rotazione della scheda nel suo piano (verificato: errore 0° con qualunque direzione dell'USB-C); resta solo lo spostamento avanti/indietro, corretto da «Annuisci» |
| 2026-11-06 | Tab XIAO: cuffia da nuoto arancione facoltativa (casella «Cuffia», ricordata in localStorage) sulla testa scansionata | Rende chiaro dove va il tag (sotto la cuffia, sul lato destro) e il punto di tangenza |
| 2026-11-06 | Display a bordo vasca: architettura proposta Raspberry Pi 4 (2 GB) + dongle USB nRF52840 + monitor portatile 15,6" + power bank USB-C PD, Wi-Fi spento, programma nativo (non ancora in distinta; l'ESP32/LilyGO resta per 1–3 nuotatori) | Servono 10 tag connessi e un monitor leggibile per 2 h a batteria (~13 W, ~26 Wh); il BLE del Pi regge solo 4–7 connessioni, il dongle nRF52840 ~15–20 |
| 2026-11-06 | Il tag registra gli eventi col proprio orario e li conserva finché il display conferma la ricezione; il display salva solo eventi (~60 KB per 10 tag in 2 h), niente dati IMU raw | Il BLE non attraversa l'acqua: tempi precisi anche con consegna in ritardo; la connessione (non l'advertising) dà la conferma |
| 2026-11-06 | Pagina `tools/display.html` a **segmenti generici** (partenza→arrivo, qualsiasi distanza), nessun allenamento caricato; vasca 25/50 m impostata una volta | Il Pi è offline e caricare l'allenamento ogni volta è complesso; gli allenamenti reali non sono mai solo «10×100» |
| 2026-11-06 | Sul display l'indicatore si chiama **Effort** (1–10), calcolato solo sull'ultimo segmento (CSS/passo, provvisorio), con storico degli ultimi 10 segmenti: il nuovo entra a sinistra, lampeggia 5 s, gli altri slittano a destra | «Fatigue» non piaceva; il test di riferimento per il calcolo è da concordare |
| 2026-11-06 | Il cronometro grande riparte quando il primo nuotatore inizia un nuovo segmento e mostra in grigio la durata del giro precedente; i tempi di ogni nuotatore partono dalla sua partenza | Gli altri possono ancora arrivare: la pagina non deve influire sui loro tempi |
| 2026-11-06 | Ogni nuotatore ha un colore (10 colori distinti) e l'interfaccia della pagina display è tutta in inglese (stati Swimming/Rest) | Riconoscere il proprio nome a colpo d'occhio; coerenza con il README |
| 2026-11-06 | Nella demo i nuotatori si fermano solo al muro del display (segmenti multipli di 100 m); il caso del muro opposto resta gestito nel codice | Un mattoncino di storico per arrivo; il problema BLE al muro opposto si affronta con l'hardware |
| 2026-11-07 | Firmware XIAO `firmware/xiao-stream/` (Arduino, core Seeeduino:nrf52 + Bluefruit, non Zephyr) come tag di prova: stesso protocollo BLE 'SwimTag' (dati 16 byte 25 Hz, stato, comandi, log, versione), IMU mediata a 208 Hz con bias del giroscopio tarato | Riusa la tab XIAO della pagina senza modifiche al protocollo; la media toglie l'aliasing a 25 Hz e il bias era una causa della testa «storta» |
| 2026-11-07 | Aggiornamento firmware della XIAO via BLE con un **OTA nostro** sulla caratteristica 0006 (staging a 0x80000, CRC32, firma `SWIMTAG_BOARD=xiao-nrf52840;`, installatore in RAM), provato 0.4.0→0.4.1→0.4.2; pubblicati `xiao.bin`/`xiao.json` su GitHub Pages | Il DFU Nordic legacy (00001530) è nella blocklist di Web Bluetooth di Chrome: dal browser non è raggiungibile; per il tag definitivo resta l'opzione Zephyr + MCUboot + SMP |
| 2026-11-07 | Sospensione: comando «Sospendi» e **automatica dopo 60 s «abbastanza fermo»** (medie di 1 s: rotazione < 3 dps e inclinazione < 3°); mai durante un OTA, con seriale USB aperta o con comandi BLE recenti; risveglio con **4 tap** (due doppi tap) o con la USB; sotto 3,3 V a batteria va in sospensione | Il tavolo vibra ma non s'inclina, una testa a riposo sì; i 4 tap evitano accensioni per urti; protegge la LiPo |
| 2026-11-07 | Riquadro Batteria della pagina rifatto per la XIAO (stato carica, % da curva LiPo, tempo, grafico, taratura `VCAL` col tester); l'ESP32 non è più la scheda principale (codice mantenuto) | Stato a 12 byte (carica, VBUS, temperatura, fattore del partitore) |
| 2026-11-07 | La XIAO usata per le prove ha il regolatore 3,3 V guasto (probabilmente durante la saldatura della cella): alimentata dalla cella tramite un diodo al silicio sul pin 3V3, solo per il banco | Con 0 V sul 3V3 la scheda non partiva; il diodo (~0,6 V) porta la cella nei limiti dell'nRF52840 |
| 2026-11-07 | Scarico della registrazione dalla pagina `tools/index.html` con **Web Serial** (MEM/DUMP/ERASE, Chrome/Edge), salvataggio `.swr` con showSaveFilePicker (fallback download), Azzera con doppia conferma | Nessun programma da installare (niente Python/pyserial) e i dati restano nel browser; `scarica.py` resta come alternativa |
| 2026-11-07 | Gli eventi annotati si salvano nel **tempo del video** (t_dati = t_video + offset), sync con X sul 5° tocco | Cambiare l'offset non obbliga a rifare l'annotazione; il video è il riferimento che l'utente vede |
| 2026-11-07 | Definizioni: B = entrata della mano in acqua, R = bocca fuori dall'acqua (V/F inizio/fine virata, P, A, X) | Eventi osservabili senza ambiguità nel video; servono per tarare i filtri dopo l'annotazione completa |
| 2026-11-07 | Il bug del risveglio con 2 tocchi aveva una causa sola: il bootloader Adafruit azzera `RESETREAS`, quindi `risveglioQuattroTap()` non partiva mai. Ora prima di ogni System OFF si scrive una marca in `GPREGRET2` e al boot si legge quella | Provato sulla tag (log `marca B7` / `marca C0`); la conferma in software della 0.4.3 era giusta ma non veniva eseguita |
| 2026-11-07 | Risveglio = **2 tocchi, LED blu, 2 tocchi** (blu come invito, finestra 3 s); dalla 0.5.1 il blu si spegne un attimo a ogni tocco contato | All'uscita da System OFF l'IMU resta cieco ~0,5 s: senza un segnale il 3° e il 4° tocco andavano persi |
| 2026-11-07 | Firmware 0.5.0 «vasca»: 4 tocchi registrano subito (BLE spento), nuovi risvegli accodano un segmento; **8 tocchi + 2 di conferma** azzerano; registrazione su flash QSPI in pagine da 256 B con CRC, delta int8, 208 Hz, acc ±16 g, gyro ±1000 dps | Dati al sicuro se la batteria si scarica (si perde al più l'ultima pagina); ~25 min con dati regolari |
| 2026-11-07 | Niente stop a tocchi durante la registrazione; quiete di **180 s** (60 s fuori dalla registrazione), memoria piena o batteria < 3,3 V | I 5 colpi di sincronizzazione non devono fermare né azzerare niente |
| 2026-11-07 | Scarico dei dati solo via USB (a registrazione finita la tag in modalità normale con USB non registra); niente file inventati nel repo: la parità `swr.js`/`swr.py` si verifica su una registrazione reale fuori dal repo (`tools/parita_swr.mjs`) | Nessun BLE in registrazione per risparmiare energia; dati reali = dati di salute, restano sul PC |
| 2026-11-07 | Vecchia scheda «Registrazioni» rinominata «Reg. ESP32»; la nuova è «Registrazione» | Evitare confusione tra prototipo ESP32 e nuova registrazione XIAO |
| 2026-11-07 | Le schede Registrazione e Annotazione non usano il layout «tutto in una schermata» (`min-height: auto`, scorrono); `annotazione.css/js` caricati con `?v=2` | Il layout a schermata unica schiacciava il riquadro video a 0 px; la cache mostrava il vecchio CSS |
| 2026-11-07 | Avviso in pagina se il video ha solo audio (`videoWidth` 0), tipico di HEVC da telefono | Evitare di scambiare un codec non supportato per un bug |
| 2026-11-07 | Adattamento dello strumento ai video a 25 fps rimandato | Decisione dell'utente («non ora»); i tempi degli eventi restano corretti |
| 2026-11-08 | Campagna di test 1: solo l'utente, **vasca da 50 m**, ~800 m al giorno tra 100 e 50, ripresa con **iPhone** da una persona che segue il nuotatore lungo il bordo, **4 giorni**; poi si decide se estendere ad altri nuotatori | Il metodo (sync, annotazione, filtri) va provato su un solo nuotatore prima di coinvolgerne altri; il 50 m è la vasca d'uso |
| 2026-11-08 | I filtri per ora esistono **solo nella pagina web** (JavaScript, a casa); la tag registra soltanto i dati raw | Iterare sui filtri senza toccare il firmware; il porting in C si fa quando i filtri sono stabili |
| 2026-11-08 | Si procede a cicli: giorno 1 annotato tutto a mano → prima bozza del filtro → giorni 2–4 annotati partendo dalla pre-classificazione (con confidenza) e corretti a mano | Partenze e arrivi sono pochi ma facili da localizzare (confine fermo/nuoto): la bozza riduce il lavoro, la precisione al fotogramma si affina coi dati |
| 2026-11-08 | Firmware XIAO 0.5.2: **niente sospensione automatica con USB alimentata** (VBUS), anche senza porta seriale aperta | Collegata al PC la tag dormiva dopo 60 s e spariva dall'USB, impedendo scarico e azzeramento |
| 2026-11-08 | Pagina `tools/index.html` riordinata solo per la XIAO: un pannello di collegamento (USB filtro 0x2886 + Bluetooth + Demo), schede Dal vivo / Registrazione / Annotazione / Firmware; tolti Reg. ESP32, USB ESP32, radar, interpretazione, eventi e i rami ESP32 dell'OTA; eliminata `tools/assi.html` | Tre pulsanti di collegamento e doppioni ESP32 rendevano la pagina incomprensibile; l'ESP32 non si usa più (il suo firmware resta in `firmware/`) |
| 2026-11-08 | Firmware 0.5.3: collegare l'USB durante la registrazione la chiude (motivo `SWR_STOP_USB` = 4) e riavvia in modalità normale | In acqua l'USB non si collega mai: è un gesto voluto per scaricare; prima la tag continuava a registrare e non rispondeva alla pagina |
| 2026-11-08 | Parte online su Firebase Spark (progetto `swimtimer-pzero`, Firestore eur3): sessioni raw a chunk su Firestore, video come link Drive con sha256 (non su Firebase), annotazioni per autore; niente Storage (richiede Blaze) né Functions | Restare nelle quote gratuite; i video pesano GB; tutti gli approvati vedono tutto ma si vede chi ha fatto cosa |
| 2026-11-08 | Login Google; ogni nuovo account è «in attesa» e solo l'admin (identificato dall'UID nelle regole, non dall'email) lo approva | Il repo è pubblico: niente email nel codice; sicurezza solo nelle regole Firestore |
| 2026-11-08 | Landing pubblica su `/`, area riservata su `/area/`; `versione.json` generato a ogni deploy e controllato dalle pagine per ricaricarsi da sole (non se ci sono modifiche non salvate) | Evitare che gli utenti restino con file vecchi in cache |
| 2026-11-08 | Il controllo «sono admin» in sessione ricorda solo il sì, mai il no | Un no memorizzato bloccava l'admin dopo l'aggiornamento delle regole |
| 2026-11-08 | Video di annotazione: camera ferma al muro, esercizi corti per virate/partenze/arrivi (giorni 1–3), allenamento vero solo per verifica (giorno 4); X360 al muro solo sott'acqua e lato corsia | Gli eventi rari sono il cuore del progetto; i giri in acqua servono come falsi positivi |
| 2026-11-08 | Firmware 0.5.4: corrente di carica 100 mA (P0.13 uscita bassa) invece di 50 mA | Con il regolatore guasto la scheda si alimenta sempre dalla cella e a 50 mA la tensione restava ferma a 3,57 V |
| 2026-11-08 | Per le prove la tag usa una cella da 1000 mAh (non 100); la pagina stima la carica con 1000 mAh e 100 mA | Con 100 mA una cella da 1000 mAh sale di pochi mV in minuti: la tensione ferma non è un guasto |
| 2026-11-08 | Landing e area in italiano e inglese (selettore, `app/comune/i18n.js`); pagina Strumenti per ora solo in italiano | Pubblico internazionale; tradurre gli strumenti è un lavoro più grande |
| 2026-11-08 | Modulo contatti senza Functions: messaggi in Firestore `contatti` (creazione libera validata, lettura solo admin), honeypot e pausa di 60 s; indirizzo pubblico SmartSwimTimer@gmail.com | Piano gratuito: niente invio email dal server |
| 2026-11-08 | Strumenti della tag pubblicati anche su `/strumenti/` del sito Firebase (copiati al deploy) con «Carica online»; GitHub Pages resta come copia senza upload | Un solo portale; i file raw finiscono subito nell'archivio condiviso |
| 2026-11-08 | Video condivisi tramite una cartella Google Drive condivisa (Visualizzatore) con gli utenti approvati, mai «chiunque abbia il link» | Sono riprese di persone: accesso solo ai membri |
| 2026-11-08 | Nuovo video YouTube di avanzamento (IT `_Htx2DawnF8`, EN `JLs5JJG4JG8`), musica originale generata da codice; in landing sopra la prima presentazione | Mostrare l'avanzamento; nessun diritto di terzi |
| 2026-11-09 | Riferimento degli eventi dal video con OpenCV (verificato a mano), non più dalle etichette manuali | Le etichette manuali variavano fino a ±0,45 s tra due passate |
| 2026-11-09 | Metodo strutturato: dataset, banco di prova in streaming, validazione su sessioni nuove; rete neurale solo per l'arrivo (notifica ≤ 1,5 s, tempo datato al tocco) | Le soglie tarate a mano su una sessione non dicevano nulla sulla successiva |
| 2026-11-10 | Video YouTube v3 «Il primo test in vasca» (IT `J01CR2nldp8`, EN `bs7WDUuwb-A`) con dati e immagini reali dell'autore; in landing sopra il video v2 | Scelta dell'autore; i file con immagini reali restano fuori dal repo |
| 2026-11-10 | Pacchetto di aggiornamento della pagina portato da 0.4.2 a 0.5.4 (`xiao.bin`/`xiao.json`, compilato senza percorsi locali) | Il tag del test 1 gira la 0.5.4; la pagina installava una versione più vecchia |
| 2026-11-10 | Annotazione d'ora in poi nell'area riservata online; editor con fps reali, lista senza scroll e frecce che spostano l'evento selezionato | Salvataggio condiviso su Firestore; le etichette erano imprecise a 30 fps su video a 50 |
| 2026-11-10 | Video da Google Drive nell'editor: lasciato stare | Serve la Drive API e la condivisione «chiunque abbia il link» |
| 2026-11-10 | Sincronizzazione tag→display (`docs/SINCRONIZZAZIONE.md`): blocchi da 4 KB, la tag spinge il più vecchio non confermato, conferma solo dopo scrittura e rilettura su SD, nessun rinvio a tempo, finestra 2 | Nessun dato perso e memoria «estesa» a ogni sosta al muro |
| 2026-11-10 | Si resta a 208 Hz; la tag non interpreta il movimento (niente stato «al muro», annuncio fisso ~200 ms) | Richiesta dell'utente: per ora solo registrazione e scarico |
| 2026-11-10 | Display di sincronizzazione su T-RGB con Adafruit GFX (no LVGL), 3 spicchi da 120°, mai in standby | Riuso dell'ambiente già stabile; il display deve sempre ricevere |
| 2026-11-10 | Formato `.swr` 2: pagina 0 di ogni blocco = intestazione 0xB1 con seq e byte di conferma fuori CRC | Formato 1 delle pagine dati invariato; −6% di spazio |
| 2026-11-10 | Nome (max 11 caratteri) e colore (tavolozza di 10) impostati dalla pagina, salvati nella tag, mostrati dal display | Riconoscere la propria tag a colpo d'occhio |
| 2026-11-10 | **LED della tag spenti a batteria** (sotto la cuffia non si vedono e consumano): da applicare al prossimo aggiornamento del firmware | Richiesta dell'utente |
| 2026-11-10 | Priorità: versione «super stabile» di tag e display (timeout, watchdog, prova di durata, casi limite) prima di nuove funzioni | Richiesta dell'utente |
| 2026-11-10 | Formato `.swr` 3: conferma nella parola di 4 byte 252..255, tutta sua; il formato 2 si legge ma non si scrive | La flash Puya riscrive l'intera parola da 4 byte: la conferma nel byte 16 rovinava il seq |
| 2026-11-10 | Seq dei blocchi mai riusato, nemmeno dopo un azzeramento (base salvata in `/seq.bin`, iniziale 1000) | Il display riconosce i doppioni dal seq: un seq riusato diventa un'anomalia |
| 2026-11-10 | La tag non cancella mai da sola una memoria non riconosciuta (4 lampi viola, azzeramento esplicito) | Nessun dato perso; prima un contenuto «estraneo» si cancellava automaticamente |
| 2026-11-10 | Batteria sul display con la stessa curva LiPo della pagina; segnale in % al posto di «vista N s fa» (scala provvisoria −95…−55 dBm) | I due numeri non coincidevano; il segnale dice il margine per lo scarico |
| 2026-11-10 | Pagina dei tool con Edge (Chrome su Windows tiene un collegamento BLE appeso) | Con Edge il collegamento funziona |
| 2026-11-10 | Il display scrive un file per tag (`/swim/<id>/tag.swr`) invece di uno per avvio; la pagina apre più `.swr` e li unisce per seq | Una registrazione spezzata su più file non si leggeva (solo il primo aveva la pagina di segmento) |
| 2026-11-10 | In registrazione la tag accetta il comando SLEEP (chiude il segmento, motivo 6) e risponde a NOME/COLORE senza argomento | Il pulsante Sospendi non faceva niente; la pagina mostrava il nome in cache |
| 2026-11-11 | Senza USB la tag registra o dorme: la modalità normale esiste solo con l'USB | L'incidente in vasca: dopo un riavvio la tag restava PRONTA e non registrava |
| 2026-11-11 | Ripresa automatica dopo un riavvio inatteso, al massimo 3 di fila, con marca in RAM + file in flash (si usa il maggiore dei due contatori) | Un crash non deve più fermare la registrazione; il watchdog azzera la marca, la flash no |
| 2026-11-11 | Watchdog 8 s; contesto del guasto e diario persistenti | La causa del riavvio in vasca è andata persa |
| 2026-11-11 | Nome, colore e taratura batteria modificabili solo con l'USB | Richiesta dell'utente; niente scritture da chiunque in portata |
| 2026-11-11 | Comandi di prova (`PROVE_GUASTI`) spenti nella versione di rilascio e visibili nella versione (`-prove`) | La caratteristica dei comandi è aperta |
| 2026-11-11 | Memoria piena: la tag si ferma (non sovrascrive i blocchi non scaricati) | Scelta dell'utente |
| 2026-11-11 | Mai System OFF con l'USB presente: si riavvia in modalità normale | Con VBUS presente la tag non avrebbe modo di svegliarsi |
| 2026-11-11 | LED visibili anche a batteria solo nella gestione dei tocchi (blu, verde, rosso 2 s, 3 lampi verdi) | Senza segnali non si sapeva se la registrazione era partita |
| 2026-11-11 | Display senza schermo: rete Wi-Fi «SwimTimer» con pagina di stato per iPhone; scansione BLE al 30 % | Schermo rotto; con l'80 % la rete spariva |
| 2026-11-11 | Standby comandato dalla scheda con il comando M_SONNO (0x14) sul canale cifrato di sincronizzazione | Il secondo collegamento sulla caratteristica aperta non funzionava ed era insicuro |
| 2026-11-11 | Dimezzare il costo in token: agenti nuovi e brevi, niente riprese di agenti lunghi, un obiettivo per sessione | Richiesta dell'utente dopo una giornata troppo costosa |
| 2026-11-12 | Display finale: monitor portatile 15,6″ HDMI pilotato da un Raspberry Pi (pagina HTML), usato anche per log e diagnosi; una scheda dedicata acquisisce le tag via BLE e passa i dati al Pi | Acquisto dell'utente; schermo grande leggibile da più nuotatori, il T-RGB resta scheda di sviluppo |
| 2026-11-12 | Scheda di acquisizione: XIAO nRF52840 collegata via USB al Raspberry Pi (niente ESP32); test con 2 tag in raw | Stessa radio e stesso stack delle tag, nessuna condivisione con il Wi-Fi; scelta dell'utente |
| 2026-11-12 | Stazione: Raspberry Pi 3 (pagina HTML a schermo intero sul monitor 15,6″) | La schermata dei tempi è leggera; il flusso dati (pochi KB/s) non richiede di più |
| 2026-11-12 | Pi configurato senza Imager: immagine scritta con `dd`, cloud-init al primo avvio, poi script `systemd.run=` sulla partizione di avvio; display Waveshare 4″ con `hdmi_cvt 480 800` + `hdmi_drive=1` (non `video=` del KMS) | Imager non funziona da riga di comando su Windows; cloud-init non riparte dopo il primo avvio; con `video=` l'immagine era triplicata |
| 2026-11-12 | La tag considera scaricato un blocco solo dopo che l'host (Pi/PC) lo ha scritto, sincronizzato su disco e riletto | Scelta dell'utente: nessun blocco perso se il Pi o il collegamento cadono |
| 2026-11-12 | Ricevitore: senza PRESENZA dall'host non si collega a nessuna tag | Evita conferme di blocchi che nessuno salva |
| 2026-11-12 | Frammenti di sync da 238 B con PRONTO v2 e MTU 247; 128 B con il protocollo v1 | Circa metà delle notifiche per blocco; display-sync resta compatibile |
| 2026-11-12 | Stack del task BLE della tag a 8 KB (`-DCFG_BLE_TASK_STACKSIZE=(256*8)` in ogni compilazione) | Con 5 KB la DIAGNOSI misurava 29–47 B liberi: probabile causa del crash dell'11/11 |
| 2026-11-12 | Letture flash della tag sempre allineate a 4 byte | Con frammenti da 238 B le letture non allineate davano E_FLASH |
| 2026-11-12 | Dopo ogni collegamento la tag invia la DIAGNOSI (reset, guasto, stack, diario) e l'host la registra | La causa di un riavvio non deve più andare persa |
| 2026-11-12 | Causa del crash dell'11/11 attribuita all'overflow dello stack BLE della tag; nella 0.6.4 lo stack sale a 10 KB | Dopo ore d'uso restano 606 B liberi su 8 KB: servono ~7,4 KB, oltre i 5 KB della versione andata in vasca |
| 2026-11-12 | Non si ottimizza la conferma della tag: il limite dello scarico è la radio del ricevitore condivisa (~17 KB/s totali) | Prove a banco: con 1 tag 16,5 KB/s, con 2 tag ~8,8 KB/s ciascuna; il periodo per blocco non cambia con la conferma |
| 2026-11-12 | Tag 0.6.4: in registrazione, vicino al ricevitore, la tag resta collegata e invia ogni blocco appena completo (niente ricollegamento per blocco) | Scelta dell'utente: le prove mostrano un ricollegamento per blocco (fino a 247 in 6 min) e HCI 0x3E frequenti |

| 2026-11-12 | Eventi diagnostici che spiegano un reset (eventi VBUS, azzeramento riprese pendente) in RAM noinit, con limite di frequenza (una NOTA 19 ogni 10 s + riepilogo NOTA 21) | Col BLE collegato il diario in flash e' rimandato: un reset farebbe perdere gli eventi che lo spiegano; la RAM noinit li conserva e al boot si riversano nel diario (NOTA 20) e nella DIAGNOSI2 |
| 2026-11-12 | Con la tag 0.6.4 il display (PRONTO v1) non puo' fare sync mentre il ricevitore tiene il collegamento: accettato | Il collegamento resta aperto in registrazione; la stazione di sincronizzazione e' il Raspberry Pi con il ricevitore, il display non serve per la sync |
| 2026-11-12 | Video YouTube v4 «Houston, abbiamo un problema» (IT `85RNvPnFV1E`, EN `mj6OTWkjgwk`), 3 min, solo scritte, animazioni con dati inventati; in landing sopra il video v3 | Racconta il crash dell'11/11 e le contromisure; il ritmo delle bracciate presentato come pista in verifica |
| 2026-11-12 | Stazione sul Pi: l'host scrive un JSON di stato (`--stato`, os.replace) e un piccolo server HTTP standard (`pannello.py`) lo serve con la pagina | Nessuna dipendenza, nessun parsing della riga di stato; la pagina riceve numeri veri |
| 2026-11-12 | Browser kiosk: **cog** (WPE WebKit su DRM, senza X) al posto di Chromium; Chromium+cage resta come riserva (`BROWSER=chromium`) | ~330 MB contro 300–450 solo di Chromium su un Pi 3 da 1 GB; cog parte con `CapabilityBoundingSet=` vuoto e `libgles2` |
| 2026-11-12 | Installazione sul Pi lanciata con `systemd-run` (staccata da SSH) | In sottotensione il Wi-Fi cade a metà di `apt`: l'installazione deve proseguire comunque |
| 2026-11-12 | Nomi delle tag da `nomi.txt` sul Pi, non nel repository; modello `nomi.esempio.txt` | Sono nomi di persone (dati personali); il ricevitore 0.1.x non legge il nome dall'annuncio |
| 2026-11-12 | Il pannello deduce «REGISTRA» dalla crescita dell'ultimo blocco annunciato (15 s) | Da collegata la tag annuncia «sincronizza» anche se registra; soluzione definitiva: modifica al firmware |
| 2026-11-12 | Per mettere a riposo una tag si usa SONNO (0x14), non un reset | Un reset a batteria fa riprendere la registrazione; SONNO esiste già nella tag |
