PZero/SwimTimer/hardware/programmatore/Programmatore_SwimTag_v0.5.pdf

### SwimTimer

# Adattatore di programmazione e collaudo del tag v0.4

pogo jig nRF52840 (E73) a forma di HAT si innesta sul Raspberry Pi 3 / 4 e si programma con OpenOCD

# 1. Cos'e' e come funziona

Il tag SwimTimer ha, sul lato sotto, 5 piazzole per il debug SWD (VDD, SWDIO, SWCLK, RESET, GND) e 2 contatti di ricarica (VIN, GND), tutti su griglia 2,54 mm. L'adattatore e' una basetta delle dimensioni e con i fori di un HAT del Raspberry Pi (65 x 56,5 mm, 4 fori M2,5): si innesta direttamente sul connettore a 40 pin del Pi (header femmina 2x20 completo, niente cavetti) e porta sulla faccia superiore 7 molle (pogo pin) che cadono sulle piazzole del tag. Il tag si appoggia a faccia in giu' sulle molle, lo si spinge contro tre battute e lo si preme.
Serve a tre cose: (1) scrivere bootloader, firmware e impostazione UICR.REGOUT0 (VDD a 3,3 V) con OpenOCD in bitbang sui GPIO del Pi; (2) ricaricare la cella senza staccarla, anche mentre il tag e' collegato via SWD (massa comune); (3) misurare tensioni e corrente di carica con il tester.

TAG SwimTimer

nRF52840 (E73), cella 40 mAh 5 piazzole SWD (O 2,0)
2 contatti ricarica (O 2,5) lato sotto, a faccia in giu'

ADATTATORE = HAT 65 x 56,5

7 pogo + battute di centraggio
3 x 1 kohm in serie (SWD)
ricarica: PTC, ponticello, LED header femmina 2x20 da sotto

Raspberry Pi 3 / 4

OpenOCD, bitbang su GPIO
GPIO24 SWDIO GPIO25 SWCLK GPIO18 reset + GND
5 V (pin 2) per la carica
pogo | 2x20

Il tag NON viene alimentato dall'adattatore: usa la sua cella. Il 3,3 V del Pi non va mai sul VDD del tag.

ATTENZIONE MAI il 3,3 V del Raspberry Pi sul VDD del tag. La piazzola VDD e' solo un punto di misura per il tester (pin J4 isolato, non collegato al connettore). Il tag si alimenta dalla sua cella. Sul connettore sono collegati SOLO i pin 2 (5 V), 12, 18, 20 (GND) e 22: tutti gli altri restano scollegati.

Al primo avvio il VDD del tag e' 1,8 V (UICR vuoto); dopo UICR.REGOUT0 e un reset diventa 3,3 V. Il Pi pilota SWDIO, SWCLK e RESET a 3,3 V: le tre resistenze da 1 kOhm in serie limitano la corrente che passa nei diodi di protezione dell'nRF52840 mentre il tag e' ancora a 1,8 V (circa 1 mA per linea). E' una protezione, non una traduzione di livello: vedi la sezione 9.8.

SwimTag adattatore di programmazione e collaudo v0.5 (HAT) | pag. 1 / 19

# Indice

1. Cos'e' e come funziona | 1
2. Schema elettrico e collegamenti | 3
3. Ricarica del tag dall'adattatore | 4
4. Distinta componenti (prezzi indicativi, novembre 2026) | 5
5a. STAMPA 1:1 rame speculare (toner transfer) | 6
5b. STAMPA 1:1 posizioni dei componenti (non speculare) | 7
5b'. Posizioni dei componenti ingrandite 2:1 (consultazione) | 8
5c. Mappa dei fori 1:1 | 9
6. Costruzione, passo passo | 10
7. Montaggio dei pogo all'altezza giusta | 12
8. Innesto sul Raspberry Pi | 14
9. Primo collegamento e programmazione | 16
10. Immagini dal progetto KiCad e rigenerazione | 19

Le stampe 1:1 sono a pagina 6 (rame speculare, 8 copie), 7 (posizioni componenti) e 9 (mappa fori).

SwimTag adattatore di programmazione e collaudo v0.5 (HAT) | pag. 2 / 19

# 2. Schema elettrico e collegamenti

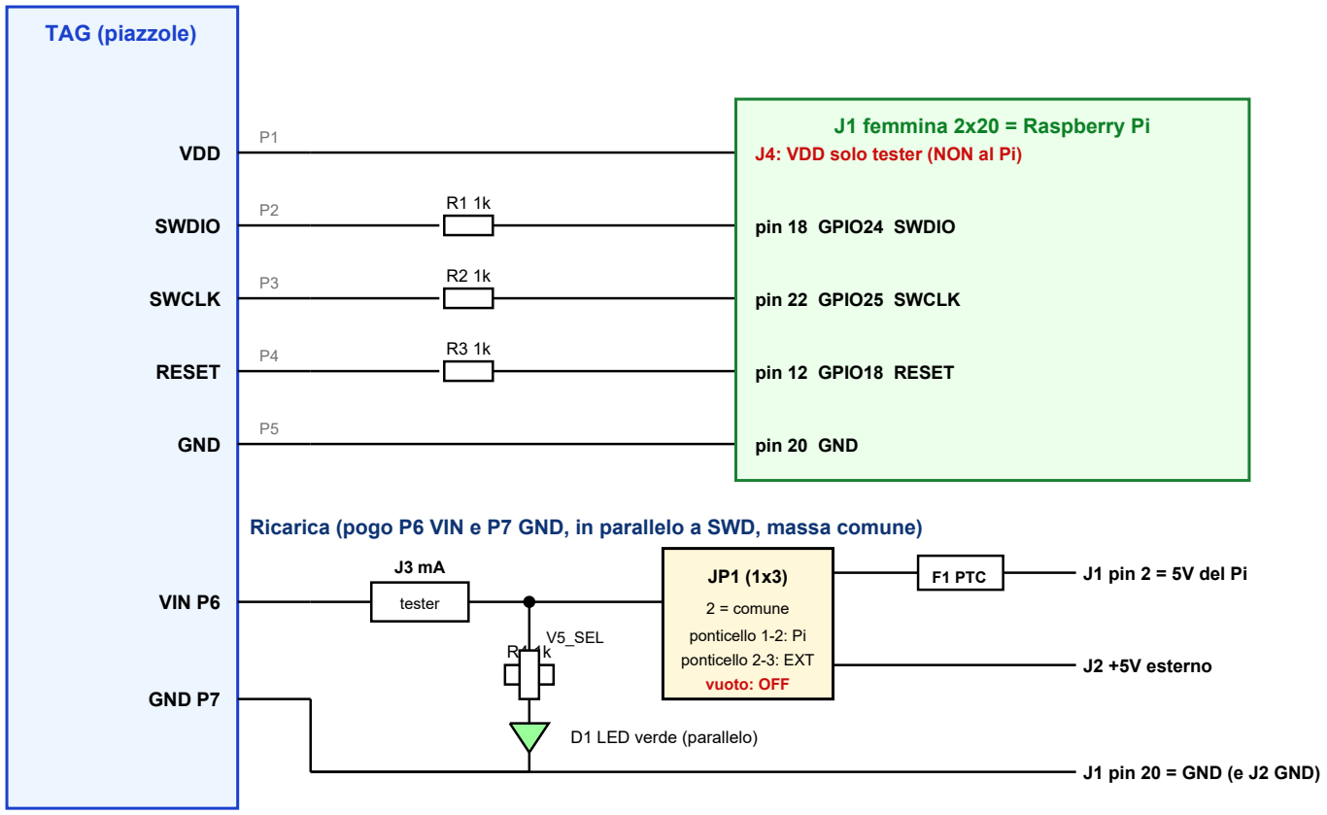
[picture p27: figure]
TAG (piazzole); VDD; SWDIO; SWCLK; RESET; GND; J1 femmina 2x20 = Raspberry Pi J4: VDD solo tester (NON al Pi); pin 18 GPIO24 SWDIO; pin 22 GPIO25 SWCLK; pin 12 GPIO18 RESET; pin 20 GND; VIN P6; GND P7; tester; V5_SEL R4 1k; D1 LED verde (parallelo); 2 = comune ponticello 1-2: Pi ponticello 2-3: EXT vuoto: OFF; F1 PTC; J1 pin 2 = 5V del Pi; J2 +5V esterno; J1 pin 20 = GND (e J2 GND)

Ricarica (pogo P6 VIN e P7 GND, in parallelo a SWD, massa comune)

GND unico sull'adattatore; nessun altro pin del connettore e' collegato.

### Pin del connettore a 40 pin usati (gli altri 35 sono scollegati)

Pin fisico | GPIO (BCM) | Segnale | Sull'adattatore | Note
18 | GPIO24 | SWDIO | R1 1 kohm > P2 | bitbang OpenOCD
22 | GPIO25 | SWCLK | R2 1 kohm > P3 | bitbang OpenOCD
12 | GPIO18 | RESET (P0.18) | R3 1 kohm > P4 | open drain in OpenOCD
20 | | GND | dorsale di massa: P5, P7, J2, LED | massa comune SWD + carica
2 | | 5 V | PTC F1 > JP1 > J3 > P6 (VIN) | solo con ponticello JP1 1-2
(nessuno) | | VDD del tag | J4 (pin isolato) | solo tester: mai al Pi

R1 sta su SWDIO (J1 pin 18), R2 su SWCLK (pin 22), R3 su RESET (pin 12). R2 e R3 sono resistenze 'lunghe' che scavalcano altre piste: in una basetta a una faccia solo le piste tra pogo e connettore si incrociano (ordine SWDIO-SWCLK-RESET-GND sul tag, RESET-SWDIO-GND-SWCLK sul connettore), quindi le due resistenze fanno anche da ponticello. I GPIO sono quelli delle configurazioni OpenOCD storiche per il Pi (raspberrypi2-native.cfg: SWCLK GPIO25, SWDIO GPIO24, SRST GPIO18; massa pin 20). Le configurazioni piu' recenti hanno spostato i default (SWCLK GPIO11, SWDIO GPIO8): il file di configurazione della sezione 9 assegna comunque i pin in modo esplicito.

SwimTag adattatore di programmazione e collaudo v0.5 (HAT) | pag. 3 / 19

# 3. Ricarica del tag dall'adattatore

I pogo P6 (VIN) e P7 (GND) toccano i contatti di ricarica del tag. Sul tag, VIN passa da un diodo Schottky 1N5819WS (protezione) e arriva al caricatore BQ25101, impostato a 13,5 mA (R_ISET = 10 kOhm) con terminazione fissa al 10 % (circa 1,35 mA) e timer di sicurezza di 10 ore.
JP1 e' la selezione ON/OFF e della sorgente. Nessun ponticello = ricarica OFF (predefinito): si programma senza caricare. Ponticello 1-2 = 5 V dal Raspberry Pi (pin 2 del connettore, attraverso il PTC). Ponticello 2-3 = 5 V da alimentatore esterno su J2 (limitato a 50-100 mA).
Il LED verde D1 con R4 (1 kOhm) e' in parallelo, subito dopo JP1 e prima del tester: indica 5 V presente e la sua corrente (circa 3 mA) non entra nella misura.
J3 e' il punto per il tester: con il tester in serie (portata mA) si legge la corrente di carica; senza tester va messo un ponticello su J3, altrimenti non carica.
F1 e' un PTC radiale (0,1 A di mantenimento) sul 5 V del Pi: se un pogo va in corto il Pi non e' esposto; dopo l'intervento si lascia raffreddare qualche minuto.
La massa e' unica: si puo' programmare via SWD mentre si carica e il firmware puo' leggere CHG_N (P0.03) e VDDH (canale VDDHDIV5 del SAADC).

### Verifica della tensione minima del caricatore

Voce | Valore | Nota
5 V del Pi (pin 2) | 4,9-5,1 V | con il carico di 14 mA non cala
PTC F1 (0,1 A hold) | -0,03...-0,1 V | ordine di 2-7 ohm x 14 mA
Tester in portata mA | -0,05...-0,3 V | dipende dallo strumento: usare la portata 200 mA (shunt piccolo)
Schottky 1N5819WS sul tag | circa -0,2 V | a 13,5 mA; Vf piu' alta a corrente maggiore
VIN al BQ25101 | circa 4,4-4,8 V | TI: tensione consigliata 4,45-6,45 V; sotto 4,25-4,37 V interviene la VIN-DPM e la corrente cala

Conclusione: con 5 V pieni, PTC e un tester a basso carico il margine e' di 0,2-0,4 V. Se la corrente misurata e' molto minore di 13,5 mA mentre la tensione sul pin 2 di J3 e' sotto circa 4,7 V, la VIN-DPM sta riducendo la corrente: togliere il tester (ponticello su J3) o usare l'alimentatore esterno a 5,0-5,2 V. I valori del BQ25101 vanno ricontrollati sul datasheet TI prima di fare affidamento sui margini.

### Tempi e cosa misurare (cella Ampul 401012 da 40 mAh)

Situazione | Atteso
Corrente in carica a corrente costante (CC) | 13,5 mA (misura al tester su J3, firmware in sleep)
Cella molto scarica (sotto circa 3 V) | prima una fase a corrente ridotta (precarica, circa il 10 %: ~1,4 mA) finche' VBAT sale
Fine carica | corrente a circa 1,35 mA (10 % di I_CHG); CHG_N (P0.03) torna alto
Durata dalla cella vuota | circa 3-3,5 ore (CC ~3 h + coda a tensione costante)
Durata dal 50 % | circa 1,5-2 ore
Timer di sicurezza | 10 ore, poi il caricatore si ferma da solo
VIN sul pogo P6 (tester su J3.2 e GND) | 4,6-5,1 V
Tensione sulla cella a fine carica | 4,2 V (misurare sui fili cella o leggere VDDH)

Nota: il carico del tag (CPU in debug, qualche mA) e' alimentato dalla stessa cella/caricatore: durante la misura della corrente di carica il firmware deve essere fermo o in sleep (o RESET tenuto basso), altrimenti si legge carica + carico e la terminazione al 10 % non scatta finche' il carico supera 1,35 mA.

SwimTag adattatore di programmazione e collaudo v0.5 (HAT) | pag. 4 / 19

# 4. Distinta componenti (prezzi indicativi, novembre 2026)

I link sono ricerche sui cataloghi: i codici esatti e le giacenze vanno controllati al momento dell'acquisto. Spedizioni dalla Cina (AliExpress, LCSC): 1-3 settimane; da distributori europei (Mouser, Farnell, RS) 2-4 giorni.

Q. | Componente | Codice / tipo | Prezzo | Dove
7+3 | Pogo pin P75-E2 (testa a corona, O corpo ~1,0-1,3 mm, corsa ~2 mm) | P75-E2 (3 di scorta) | ~2-3 EUR per 10 pz | lcsc.com/search?q=P75-E2 AliExpress 'P75-E2 pogo pin'
7+3 | Ricettacolo per P75 (a saldare / wirewrap) | R75-2W (o R75-3S) | ~2 EUR per 10 pz | lcsc.com/search?q=R75-2W
1 | Header FEMMINA 2x20 (40 pin), passo 2,54, altezza 8,5 mm, per HAT | es. 'Raspberry Pi 40 pin female header 2x20' | | Pimoroni/Adafruit/Kiwi
4 | Distanziale M2,5 femminafemmina, 11 mm (nylon o ottone) | kit distanziali M2,5 | ~3 EUR (kit) | AliExpress / Amazon
4+4 | Vite M2,5 x 6 (testa tonda) | kit viti M2,5 | ~1 EUR | ferramenta / kit
1 | Basetta FR4 1,6 mm, rame su una faccia (100 x 160 mm; ne ricavi 2) | normale (non fotosensibile) | ~4-6 EUR | AliExpress / Amazon 'single side copper clad 100x160'
1 striscia | Header maschio 1x40, passo 2,54 (JP1 3, J2 2, J3 2, J4 1, battute 3 pin)
2 (+1) | Ponticello (jumper cap) 2,54 mm | generico | ~0,3 EUR | come sopra
4 | Resistenza 1 kohm 1/4 W 5 %, foro passante (corpo 6,3 mm) | generica | ~0,1 EUR | qualsiasi
1 | LED verde 3 mm, foro passante | generico | ~0,1 EUR | qualsiasi
1 | PTC radiale, hold 0,1 A, passo 5,08 mm | es. Bourns MF-R010 / Littelfuse RXEF010 | ~0,4 EUR | mouser.it / farnell.com ('PTC 100 mA radial')
3 | Blocchetto 2,54 x 2,54 x 2,5 mm: corpo di plastica di un header (appoggi del tag) | ricavato da 1 header maschio | | cianoacrilico o biadesivo
| Carta lucida (rivista patinata o carta fotografica glossy), persolfato di sodio o cloruro ferrico, punte 0,8 / 1,0 / 1,5 / 2,75 mm | consumabili | ~10-15 EUR | negozi di elettronica / AliExpress
~1-2 EUR | lcsc.com/search?q=female+header+2x20
generico | ~0,5 EUR | lcsc.com/search?q=pin+header+1x40

Totale: circa 25-30 EUR di componenti piu' circa 10-15 EUR di consumabili se non li hai gia'. Il connettore femmina 2x20 e' un normale header per HAT (non il 'GPIO stacking' con code lunghe): va montato da sotto e saldato sopra (sezione 6.6).

### Scelta dei pogo: due alternative a confronto

| P75-E2 + R75 (scelto) | P50 + R50 (alternativa)
Corpo del ricettacolo | foro ~1,5 mm: anello di rame 0,25 mm intorno (piazzola ovale 2,0 x 3,2) | foro ~1,0 mm: anello 0,5 mm, piu' comodo da forare a mano
Corrente / robustezza | ~3 A, molla piu' robusta | ~1-2 A, molla piu' debole, stesso uso
Reperibilita' | molto comune (e' la serie 'standard' a passo 2,54) | comune
Contro | foro grande: allineare bene la punta del trapano | punta del pogo piu' sottile: piu' fragile

Motivo della scelta: richiesta e disponibilita' della serie P75; se il foro da 1,5 mm strappa il rame in foratura, passare a P50/R50 (stessa piazzola, basta cambiare FORO_POGO in modello.py e rigenerare).

SwimTag adattatore di programmazione e collaudo v0.5 (HAT) | pag. 5 / 19

### RAME SPECULARE STAMPARE AL 100% (scala reale), NERO PIENO

Disattivare 'adatta alla pagina' / 'riduci'. Misurare la barra: deve essere 50,0 mm (+-0,3). Laser, carta lucida, toner al massimo.
Il rame e' SUL LATO COMPONENTI (sopra): la carta si gira sul rame. Dopo il trasferimento 'JIG 0.5' e 'USB->' si leggono dritte e il pin 1 e' a sinistra.

< barra di controllo scala: 50 mm

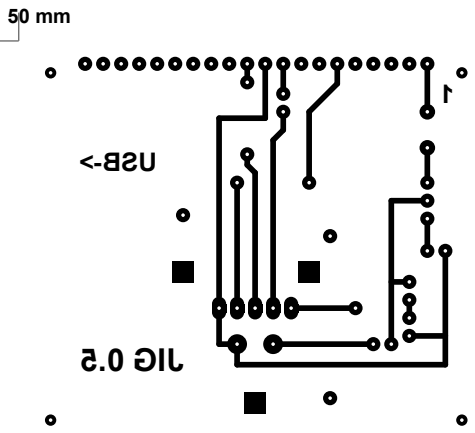
[picture p28: figure]
USB->; JIG 0.5
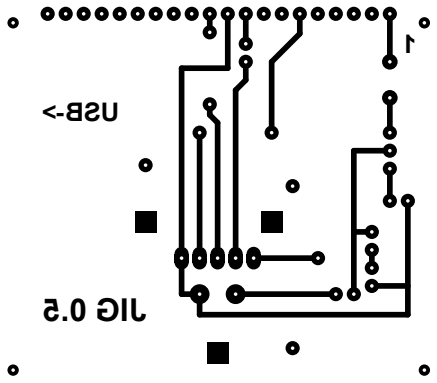
[picture p29: figure]
USB->; JIG 0.5
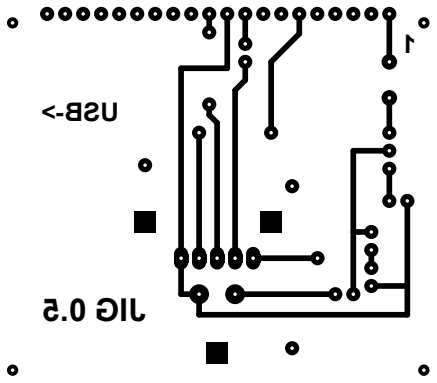
[picture p30: figure]
USB->; JIG 0.5
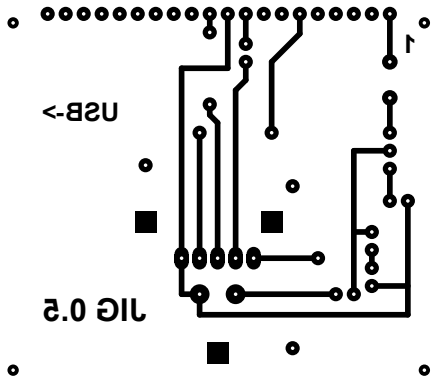
[picture p31: figure]
USB->; JIG 0.5
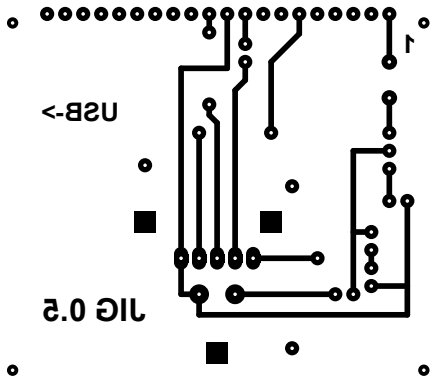
[picture p32: figure]
USB->; JIG 0.5
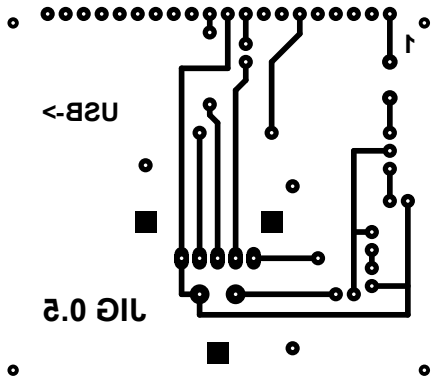
[picture p33: figure]
USB->; JIG 0.5
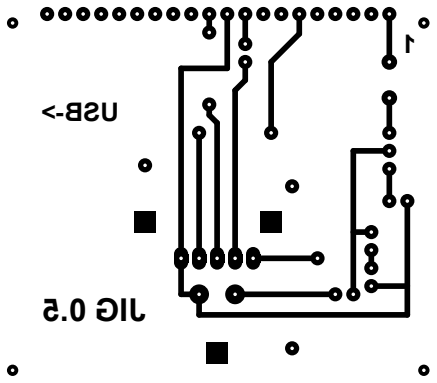
[picture p34: figure]
USB->; JIG 0.5
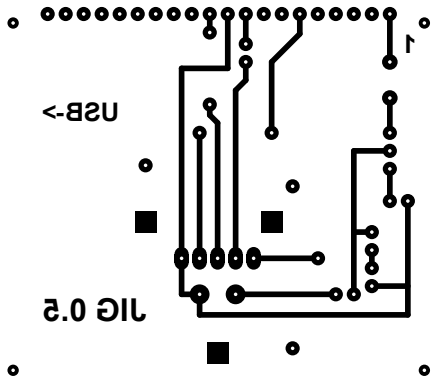
[picture p35: figure]
USB->; JIG 0.5

SwimTag programmatore v0.5 (HAT) 8 copie 1:1 della stessa basetta (65.0 x 56.5 mm) generato da genera_pdf.py

SwimTag adattatore di programmazione e collaudo v0.5 (HAT) | pag. 6 / 19

### POSIZIONI 1:1 (vista dall'alto, NON speculare)

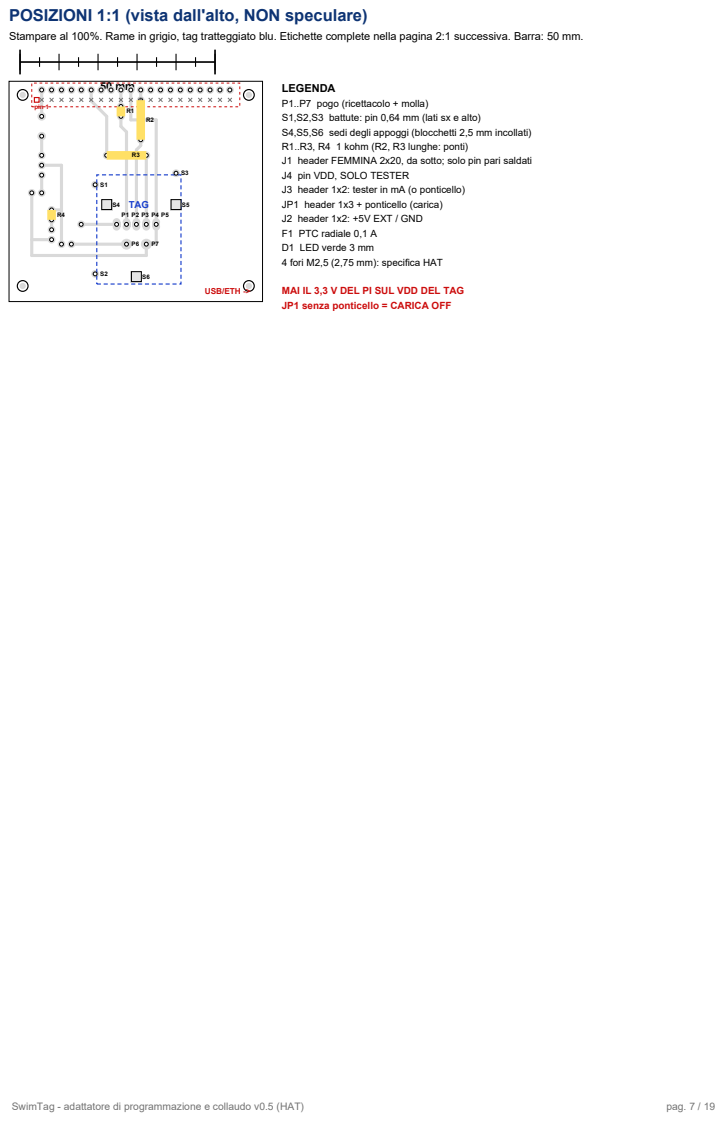
[picture p36: page 7]

Stampare al 100%. Rame in grigio, tag tratteggiato blu. Etichette complete nella pagina 2:1 successiva. Barra: 50 mm.

LEGENDA
P1..P7 pogo (ricettacolo + molla)
S1,S2,S3 battute: pin 0,64 mm (lati sx e alto)
S4,S5,S6 sedi degli appoggi (blocchetti 2,5 mm incollati)
R1..R3, R4 1 kohm (R2, R3 lunghe: ponti)
J1 header FEMMINA 2x20, da sotto; solo pin pari saldati
J4 pin VDD, SOLO TESTER
J3 header 1x2: tester in mA (o ponticello)
JP1 header 1x3 + ponticello (carica)
J2 header 1x2: +5V EXT / GND
F1 PTC radiale 0,1 A
D1 LED verde 3 mm
4 fori M2,5 (2,75 mm): specifica HAT

MAI IL 3,3 V DEL PI SUL VDD DEL TAG
JP1 senza ponticello = CARICA OFF

### POSIZIONI INGRANDIMENTO 2:1 (vista dall'alto)

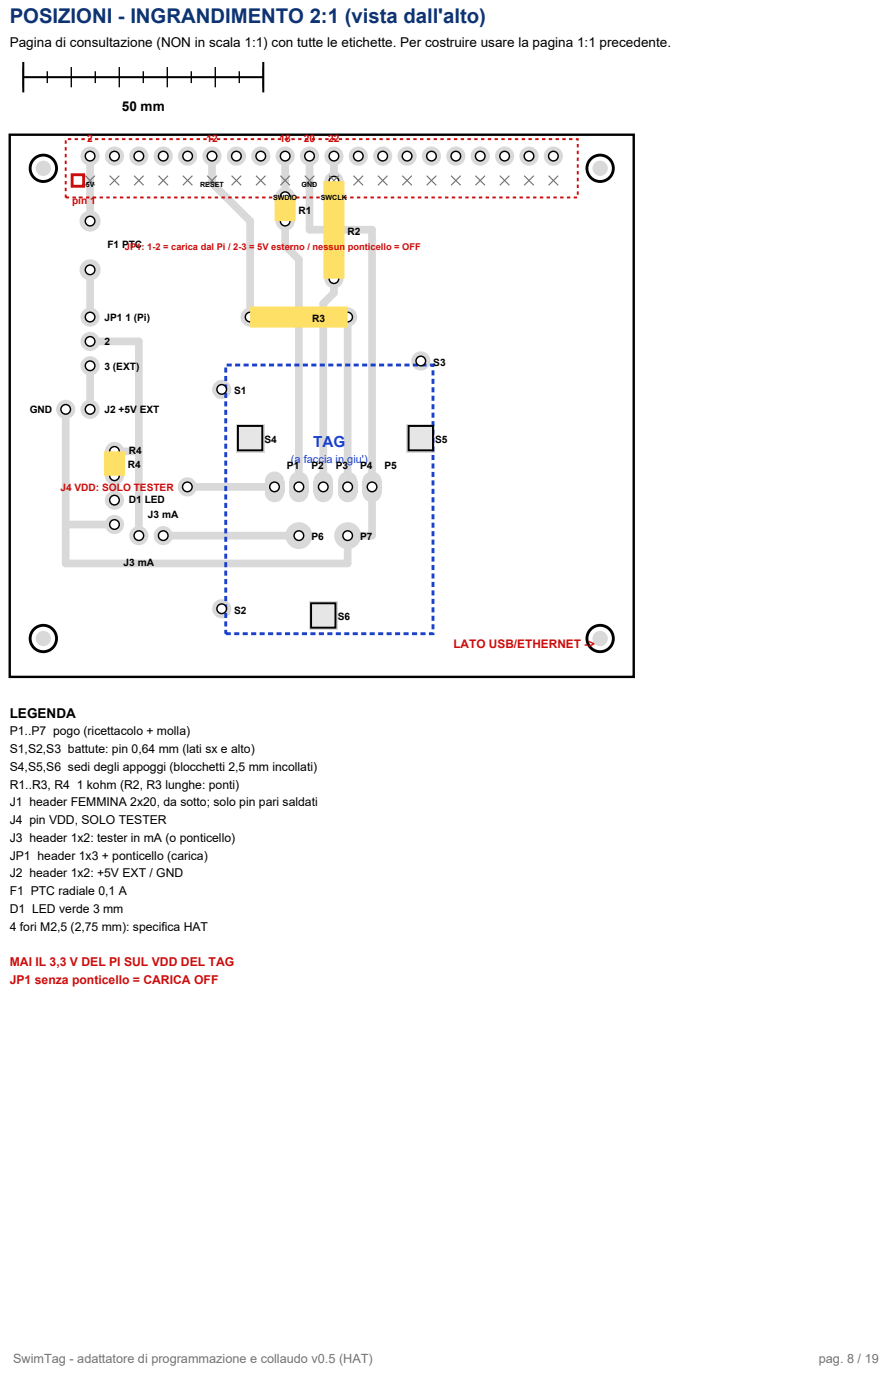
[picture p37: page 8]

Pagina di consultazione (NON in scala 1:1) con tutte le etichette. Per costruire usare la pagina 1:1 precedente.

F1 PTC
JP1: 1-2 = carica dal Pi / 2-3 = 5V esterno / nessun ponticello = OFF

LEGENDA
P1..P7 pogo (ricettacolo + molla)
S1,S2,S3 battute: pin 0,64 mm (lati sx e alto)
S4,S5,S6 sedi degli appoggi (blocchetti 2,5 mm incollati)
R1..R3, R4 1 kohm (R2, R3 lunghe: ponti)
J1 header FEMMINA 2x20, da sotto; solo pin pari saldati
J4 pin VDD, SOLO TESTER
J3 header 1x2: tester in mA (o ponticello)
JP1 header 1x3 + ponticello (carica)
J2 header 1x2: +5V EXT / GND
F1 PTC radiale 0,1 A
D1 LED verde 3 mm
4 fori M2,5 (2,75 mm): specifica HAT

MAI IL 3,3 V DEL PI SUL VDD DEL TAG
JP1 senza ponticello = CARICA OFF

### MAPPA DEI FORI 1:1 (vista dall'alto, lato rame)

Ogni foro porta la lettera del diametro. Forare dal lato rame verso il basso. Stampare al 100%.

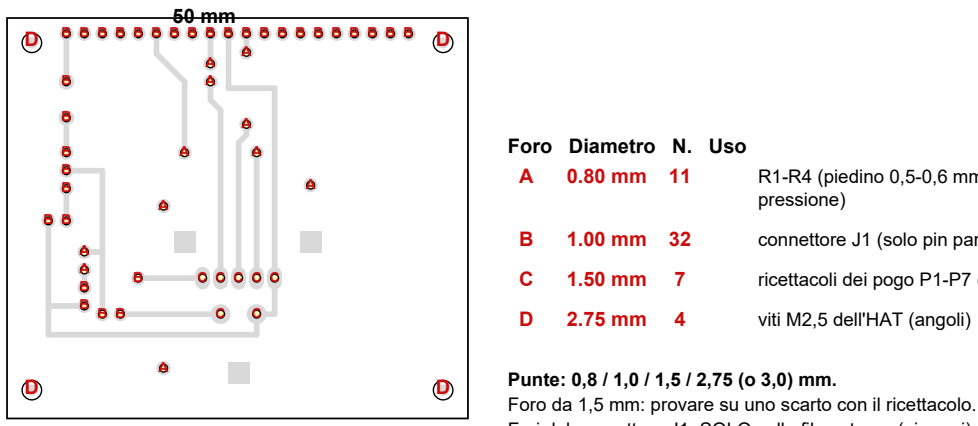
[picture p38: figure]
Foro Diametro N. Uso; pressione); viti M2,5 dell'HAT (angoli)

A | 0.80 mm 11 | R1-R4 (piedino 0,5-0,6 mm) e battute S1-S3 (pin 0,64 mm a
B | 1.00 mm 32 | connettore J1 (solo pin pari), header 1x1/1x2/1x3, PTC, LED
C | 1.50 mm | 7 | ricettacoli dei pogo P1-P7 (VERIFICARE sul pezzo!)

Punte: 0,8 / 1,0 / 1,5 / 2,75 (o 3,0) mm.
Foro da 1,5 mm: provare su uno scarto con il ricettacolo. Fori del connettore J1: SOLO sulla fila esterna (pin pari); la fila interna non ha fori (code tagliate).
Totale fori: 54
SwimTag adattatore di programmazione e collaudo v0.5 (HAT) | pag. 9 / 19

# 6. Costruzione, passo passo

Particolarita' di questa basetta: il rame e' SUL LATO COMPONENTI (sopra), come in un HAT vero, perche' il connettore femmina a 40 pin si monta da sotto e si salda sopra. Quindi la stampa e' speculare (carta girata sul rame) e tutti i componenti si saldano dal lato in cui si vedono le piste.

### 6.1 Preparare la stampa

1. Aprire la pagina 5a (o stampa/rame_speculare_1a1.pdf); stampare al 100 % ('dimensione reale'), mai 'adatta alla pagina'. Stampante LASER, qualita' massima, toner scuro, nessun risparmio toner.
2. Carta: carta lucida da rivista patinata (la piu' economica) o carta fotografica 'glossy' a getto d'inchiostro; il toner deve restare sopra, senza assorbirsi.
3. Controllo della scala: misurare con un righello la barra da 50 mm in alto e la barra verticale a destra: devono dare 50,0 + 0,3 mm.
4. Controllo del verso: sul foglio le scritte 'USB->' e 'JIG 0.5' sono scritte al rovescio e il pin 1 e' a destra: e' giusto. Dopo il trasferimento sul rame (guardandolo da sopra) si leggono dritte e il pin 1 e' a sinistra.
5. Ritagliare UNA copia lungo i segni di taglio (angoli), lasciando 3-5 mm di carta intorno. Le altre copie servono come scorta.

### 6.2 Preparare il rame

1. Tagliare la basetta a misura (65.0 x 56.5 mm, angoli arrotondati r = 3 mm come da specifica HAT) con seghetto o cutter da PCB incidendo piu' volte e spezzando; limare i bordi e gli angoli.
2. Pulire il rame con paglietta fine / carta vetro 1000 e acetone o alcol isopropilico: rame lucido, senza ditate. Non toccarlo piu' con le dita.

### 6.3 Trasferimento con il ferro

1. Appoggiare la carta con il toner rivolto verso il rame, centrata, fissarla con nastro di carta su due lati.
2. Ferro da stiro al massimo, senza vapore. Premere forte e uniformemente 2-3 minuti sul primo punto, poi muovere lentamente su tutta la superficie per altri 3-5 minuti, insistendo sui bordi.
3. Lasciare raffreddare, poi mettere in acqua tiepida con una goccia di detersivo per 10 minuti e togliere la carta sfregando con il dito.
4. Controllare con una lente: piste continue, piazzole piene. Ritoccare i difetti con un pennarello indelebile a punta fine; i punti bianchi dei fori (O 0,5 mm) non vanno coperti.

### 6.4 Incisione (con avvertenze)

Sicurezza: cloruro ferrico e persolfato macchiano e sono corrosivi. Occhiali, guanti, abiti vecchi, ambiente ventilato, vaschetta di plastica o vetro (mai metallo). Non versare la soluzione esausta nello scarico: conferirla al centro di raccolta rifiuti speciali del comune. Tenere lontano da bambini e animali.

1. Soluzione tiepida (40-50 C) di persolfato di sodio (circa 100-200 g/litro) o cloruro ferrico, in vaschetta. Agitare dolcemente.
2. Tempo: persolfato circa 10-20 minuti, cloruro ferrico 15-30 minuti. Fermarsi appena il rame scoperto e' sparito del tutto (controllare in controluce).
3. Sciacquare in abbondanza. Togliere il toner con acetone o paglietta fine: il rame delle piste deve tornare lucido. Passare un velo di flussante o stagno liquido.
4. Controllare con il tester (continuita') l'assenza di corti tra piste e piazzole vicine: specialmente tra le piazzole del connettore (0,54 mm) e dei pogo.

### 6.5 Foratura

Usare la mappa dei fori (pagina 5c). Punteggiare con un punto di bulino sui segni bianchi, forare con un minitrapano (punte in metallo duro: 0,8 / 1,0 / 1,5 / 2,75 mm). Il connettore ha fori SOLO sulla fila esterna (20 fori, pin pari). Per il foro da 1,5 mm: partire con 1,0 mm e allargare, basetta ben ferma su un legno di scarto, senza premere. Sbavare a mano.

### 6.6 Montaggio (tutto si salda dal lato rame, sopra)

1. Connettore femmina 2x20: con un tronchesino a filo, TAGLIARE le code dei pin dispari (fila interna, quella che sulla basetta non ha fori; sono i pin 1, 3, ... 39). Inserirlo DA SOTTO, con le prese rivolte verso il basso (verso il Pi) e le code della fila esterna che sporgono sopra; il lato con il pin 1 a sinistra, la fila esterna verso il bordo. Saldare le 20 code sopra (sono la ritenzione meccanica) e tagliarle a ~1 mm.
SwimTag adattatore di programmazione e collaudo v0.5 (HAT) | pag. 10 / 19

2. Resistenze: R1 e R4 'in piedi' (un piedino piegato sul corpo, 2,54 mm). R2 (SWCLK) e R3 (RESET) sdraiate, con i piedini a 10,16 mm: il corpo scavalca le piste. Inserire dall'alto, tenere il corpo sollevato ~1-2 mm dalla basetta (uno spessore) e saldare sopra il piedino dove entra nel foro; tagliare sotto.
3. Header maschio (JP1 3 pin, J2 2 pin, J3 2 pin, J4 1 pin): inserire DA SOTTO con il lato lungo dei pin verso l'alto, corpo di plastica sotto la basetta; saldare sopra, e tagliare a filo la parte corta sotto il corpo.
4. LED e PTC: inserire dall'alto, lasciare 2-3 mm di piedino libero sopra la basetta, saldare sopra (polarita' LED: anodo in alto nella pagina 5b', verso R4).
5. Battute S1, S2 (bordo sinistro) e S3 (bordo alto): pezzi di pin di header (0,64 mm) infilati nel foro da 0,8 mm da sotto, sporgenti 4-5 mm sopra, saldati sopra; devono restare dritti e con una faccia piana verso il tag.
6. Appoggi S4, S5, S6: blocchetti di plastica da 2,54 x 2,54 x 2,5 mm (il corpo di un header privato dei pin) incollati con una goccia di cianoacrilico sui quadrati di rame da 3 x 3 mm.
7. Pogo: v. sezione successiva. Distanziali: avvitare i 4 distanziali da 11 mm sotto l'HAT con le viti M2,5 dall'alto.
SwimTag adattatore di programmazione e collaudo v0.5 (HAT) | pag. 11 / 19

# 7. Montaggio dei pogo all'altezza giusta

Sezione laterale (quote da verificare sui pezzi arrivati)
Rame e componenti sullo stesso lato (sopra). Punta libera = piano del tag + compressione. Il tag poggia sugli appoggi, non sui pogo. Testa del ricettacolo a H_r = 4.0 mm L sopra la basetta (L = quanto la punta sporge dal ricettacolo, molla a riposo).

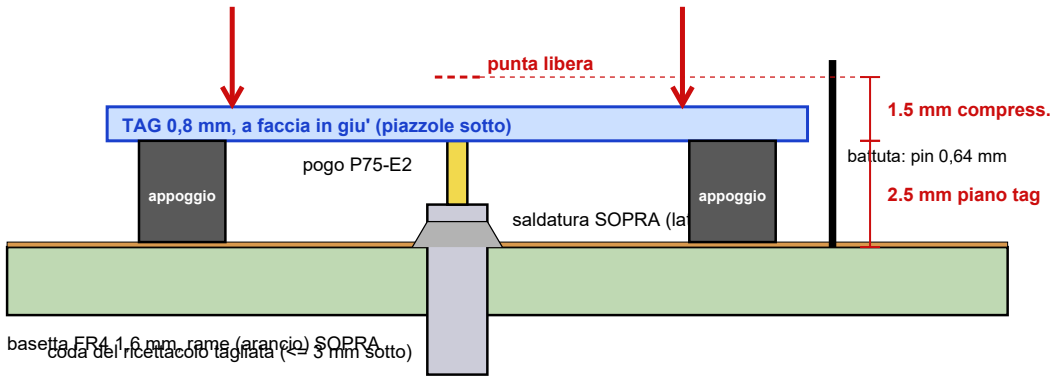
[picture p39: figure]
saldatura SOPRA (lato rame); pogo P75-E2; punta libera; appoggio; battuta: pin 0,64 mm; 2.5 mm piano tag; 1.5 mm compress.

basetta FR4 1,6 mm, rame (arancio) SOPRA coda del ricettacolo tagliata (<= 3 mm sotto)

TAG 0,8 mm, a faccia in giu' (piazzole sotto) pressione dall'alto (dito, coperchio o elastico)

Condizione: la testa del ricettacolo non deve superare 2,0 mm sopra la basetta (altrimenti tocca il tag).

1. Inserire un ricettacolo nel suo foro dall'alto; infilarci il pogo e misurare con il calibro quanto la punta sporge dalla testa del ricettacolo con la molla a riposo (L).
2. Calcolare l'altezza della testa del ricettacolo sopra la basetta: H_r = 4.0 mm L. Esempio: se L = 3,0 mm, la testa va a 1,0 mm sopra la basetta. Se H_r > 2,0 mm il ricettacolo sarebbe troppo alto: usare un ricettacolo piu' corto.
3. Togliere il pogo (per non scaldare la molla). Con uno spessore di H_r mm sotto la testa del ricettacolo, saldare SOPRA, intorno al corpo, con stagno e poca fiamma; il piano delle punte resta cosi' a 4.0 mm.
4. Reinserire i pogo. Tagliare la coda del ricettacolo che sporge sotto (resta al massimo 3 mm: sotto c'e' il Pi).
5. Verifica del piano: appoggiare un righello rigido sui blocchetti S4-S6: le punte dei 7 pogo devono sporgere di 1.5 mm dalla faccia del righello (+-0,3), tutte uguali.
6. Prova del contatto: appoggiare il tag, premere, e controllare con il tester (continuita') tra una piazzola del tag e il corrispondente pin (J4, J3, ...).
SwimTag adattatore di programmazione e collaudo v0.5 (HAT) | pag. 12 / 19

### Posizionamento e centraggio del tag

Pianta del centraggio (vista dall'alto, 7 pt per mm)
Il tag poggia sui blocchetti S4-S6 e si spinge contro i pin di battuta S1, S2 (bordo sinistro) e S3 (bordo alto).

Tolleranza richiesta: +-0,3 mm. Gioco battutabordo 0,1 mm, taglio del tag +-0,1 mm,
foratura +-0,1 mm:
totale ~ +-0,3 mm sulle piazzole.

Le piazzole del tag sono O 2,0 mm: la punta del pogo (~1 mm) cade comunque dentro la piazzola.

Tacche arancio = serigrafia del tag ogni 2,54 mm sui bordi sinistro e alto: controllo a vista del centraggio.

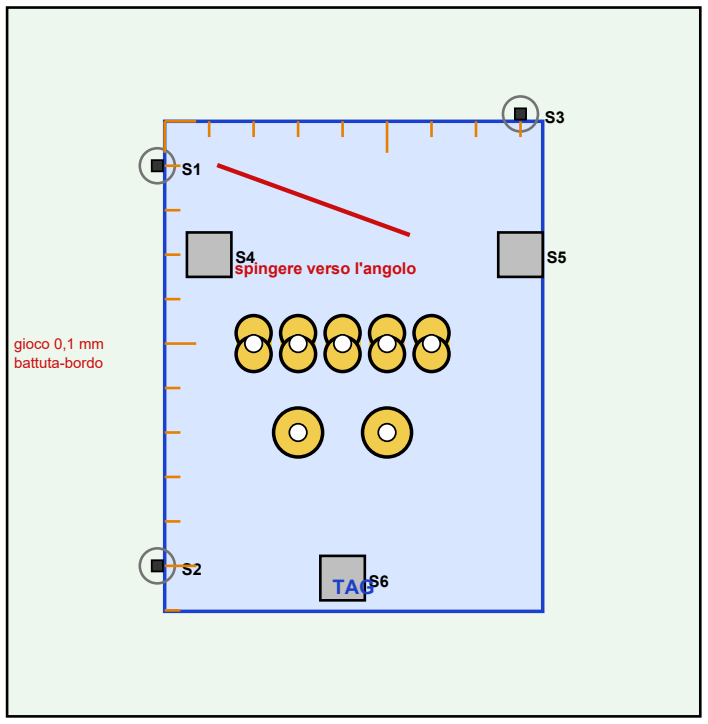
[picture p40: figure]
spingere verso l'angolo; gioco 0,1 mm battutabordo; TAG

Forza dei pogo: ogni molla da circa 0,5-1 N a meta' corsa, quindi circa 4-7 N sui sette: basta premere con un dito sul tag, oppure un coperchio di plexiglas o un elastico largo intorno all'HAT e al Pi. L'HAT poggia sui distanziali: la pressione verso il basso e' sostenuta dal Pi. Prima di programmare, tenere il tag premuto: un contatto intermittente da' errori misteriosi di OpenOCD.

SwimTag adattatore di programmazione e collaudo v0.5 (HAT) | pag. 13 / 19

# 8. Innesto sul Raspberry Pi

Con il Pi spento, appoggiare l'HAT sul connettore con il bordo del connettore verso il bordo del Pi, la scritta 'USB->' verso le porte USB/Ethernet, il pin 1 (fila interna, a sinistra) dal lato della scheda SD. I 4 fori M2,5 (58 x 49 mm) e la posizione del connettore sono quelli della specifica HAT ufficiale (identici su Pi 3 e Pi 4): con i distanziali ai fori l'HAT entra in un solo verso. Il connettore e' completo (2x20), quindi non puo' scorrere di un pin. Distanziali da 11 mm (header femmina 8,5 mm + 2,5 mm di plastica del maschio): il tag e i pogo restano sopra, le porte USB/Ethernet restano scoperte.

Innesto sul Raspberry Pi 3 / 4 (stessa posizione del connettore e dei fori)

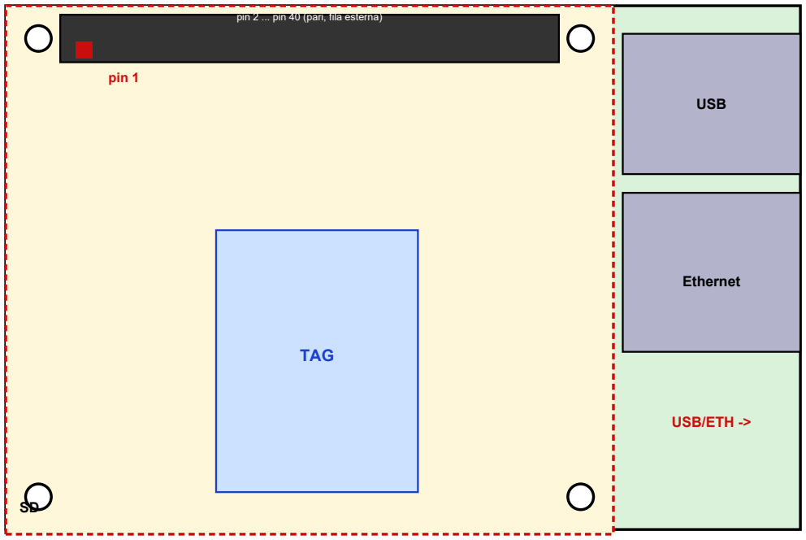
[picture p41: figure]
USB; Ethernet; USB/ETH >; TAG; pin 2 ... pin 40 (pari, fila esterna); pin 1

Pi (85 x 56 mm) con SD a sinistra; HAT tratteggiato (65 x 56,5 mm); connettore sul bordo alto.

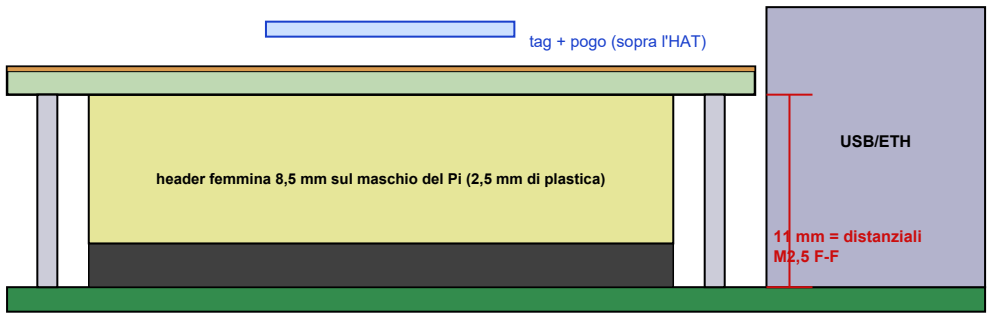
[picture p42: figure]
USB/ETH; tag + pogo (sopra l'HAT); 11 mm = distanziali M2,5 F-F

header femmina 8,5 mm sul maschio del Pi (2,5 mm di plastica)

Sezione: i distanziali (4, ai fori M2,5) si avvitano all'HAT e poggiano sul Pi; non serve fissarli al Pi.
Sotto l'HAT restano solo: il connettore (8,5 mm), i corpi dei 4 header (2,5 mm) e le code dei componenti tagliate.

Verificare la posizione del connettore sulla specifica HAT (centro del connettore a 3,5 mm dal bordo e a meta' tra i fori) sul proprio Pi prima della foratura: un errore di 1 mm si vede subito perche' i fori M2,5 non coincidono.

### E se l'HAT fosse innestato ruotato di 180 gradi?

La specifica HAT lo rende fisicamente evidente: ruotato di 180 gradi intorno al connettore, l'HAT sporgerebbe di 49 mm oltre il bordo del Pi e due soli distanziali cadrebbero sui fori del Pi. Se lo si forzasse comunque, la presa 'pin 2k' dell'HAT finisce sul pin 41-2k del Pi; i pin pari del Pi (5 V, GND, GPIO) incontrano la fila interna dell'HAT, le cui code sono tagliate: quindi non si collega nulla di cio' che e' sulla fila esterna del Pi (5 V compresi).

SwimTag adattatore di programmazione e collaudo v0.5 (HAT) | pag. 14 / 19

Presa dell'HAT (segnale) | Pin del Pi con innesto | Effetto
pin 2 (5 V, verso PTC F1) | ruotato pin 39 = GND | la linea 5 V dell'adattatore va a massa: nessun danno (con JP1 1-2 il tag vede 0 V). MAI fare JP1 2-3 con il 5 V esterno: l'ingresso esterno non tocca questa linea.
pin 12 (RESET) | pin 29 = GPIO5 | ingresso/uscita GPIO libera: nessun effetto finche' non la si usa
pin 18 (SWDIO) | pin 23 = GPIO11 (SPI SCLK) | come sopra
pin 20 (GND dell'adattatore) | pin 21 = GPIO9 (SPI MISO) | la massa del tag e dell'eventuale alimentatore esterno e' su un GPIO in ingresso: nessun cortocircuito
pin 22 (SWCLK) | pin 19 = GPIO10 (SPI MOSI) | come sopra
altre prese a pin pari (40 pad flottanti) | pin dispari: 1 e 17 = 3,3 V, 2/4 non raggiunti | pad flottanti: i 3,3 V del Pi cadono su rame isolato

Conclusione: nessun caso pericoloso. I 3,3 V (pin 1 e 17) e i 5 V (pin 2, 4) del Pi non finiscono mai su una linea collegata del tag, ne' innestato giusto ne' ruotato: il 5 V arriva soltanto dal pin 2 attraverso il PTC e JP1 (spento per default). Ne' occorre aggiungere protezioni; restano le 1 kohm in serie e il PTC.

SwimTag adattatore di programmazione e collaudo v0.5 (HAT) | pag. 15 / 19

# 9. Primo collegamento e programmazione

### 9.1 Controlli con il tester (tag NON ancora sull'adattatore, adattatore NON sul Pi)

1. Continuita' tra ogni pogo e il suo punto: P1-J4, P2-pin 18 del connettore (circa 1 kohm, via R1), P3-pin 22 (1 kohm), P4-pin 12 (1 kohm), P5-pin 20 (0 ohm), P6-J3, P7-pin 20.
2. Nessun corto tra pin vicini e nessuna continuita' tra il pin 20 (GND) e il pin 2 (5 V), ne' tra J4 (VDD) e qualunque pin del connettore.
3. JP1 senza ponticello (carica OFF), J3 con ponticello.

### 9.2 Il tag sull'adattatore

1. Innestare l'HAT sul Pi (spento). Collegare la cella al connettore batteria del tag. Appoggiare il tag a faccia in giu', spingerlo contro S1-S3 e premerlo.
2. Con il tester in portata 20 V: nero su pin GND (J2 GND), rosso su J4 (VDD). Primo avvio, UICR vuoto: atteso 1,8 V (da 1,7 a 1,9 V). Se e' 0 V: cella scollegata, scarica, contatto mancante. Se legge 3,3 V il REGOUT0 e' gia' impostato.
3. Solo ora accendere il Pi e lanciare OpenOCD.

### 9.3 Installare OpenOCD sul Raspberry Pi (Raspberry Pi OS)

sudo apt update
sudo apt install ‐y openocd
openocd ‐‐version | # 0.12.0 su Raspberry Pi OS Bookworm
openocd ‐c 'adapter list' ‐c shutdown | # deve elencare bcm2835gpio (e linuxgpiod)
# controlla i default ufficiali installati sul tuo Pi (possono cambiare tra versioni):

grep ‐n 'swd_nums\|swclk\|srst' /usr/share/openocd/scripts/interface/raspberrypi*native.cfg

OpenOCD va lanciato con sudo (accede alla memoria dei GPIO). Pi 5: non supportato da bcm2835gpio (GPIO dietro il chip RP1), non usarlo.

### 9.4 File di configurazione completo: swimtag_pi.cfg

# swimtag_pi.cfg ‐ nRF52840 con bit‐bang su GPIO del Raspberry Pi # ‐‐‐ scegliere UNA sola riga peripheral_base ‐‐‐

# Pi 3 / Pi 2 / Zero 2: | 0x3F000000 | Pi 4: | 0xFE000000

adapter driver bcm2835gpio
bcm2835gpio peripheral_base 0x3F000000
# calibrazione velocita' (valore di partenza del Pi 3; sul Pi 4 vedi 9.5) bcm2835gpio speed_coeffs 146203 36

# SWCLK = GPIO25 (pin 22), SWDIO = GPIO24 (pin 18)

bcm2835gpio swd_nums 25 24
# RESET = GPIO18 (pin 12), a drenaggio aperto (il tag ha il pull‐up interno) bcm2835gpio srst_num 18

reset_config srst_only srst_open_drain
transport select swd
adapter speed 1000
set WORKAREASIZE 0
source [find target/nrf52.cfg]

Con OpenOCD piu' recente (dalla 0.12 con 'adapter gpio') la sintassi equivalente e': 'adapter gpio swclk 25', 'adapter gpio swdio 24', 'adapter gpio srst 18'. Su Pi 4 l'indirizzo delle periferiche e' 0xFE000000. 'adapter speed' e' in kHz: partire da 1000, scendere a 200-400 se compaiono errori di parita' o timeout.

### 9.5 Differenze tra Pi 3 e Pi 4

| Raspberry Pi 3 | Raspberry Pi 4
peripheral_base | 0x3F000000 | 0xFE000000
speed_coeffs | 146203 36 (valore dei file ufficiali) | il driver e' tarato sul Pi 3: partire da 'adapter speed 400' e alzare; misurare il clock con un oscilloscopio o un analizzatore se serve
Alternativa | | driver linuxgpiod (richiede openocd compilato con enablelinuxgpiod): 'adapter driver linuxgpiod', 'linuxgpiod gpiochip 0', 'linuxgpiod swd_nums 25 24', 'linuxgpiod srst_num 18'; piu' lento ma indipendente dall'indirizzo delle periferiche
Velocita' tipica | 1-2 MHz di bitbang | 1-3 MHz, usare comunque meno di 2 MHz

### 9.6 Comandi

SwimTag adattatore di programmazione e collaudo v0.5 (HAT) | pag. 16 / 19

Tutti dalla cartella con swimtag_pi.cfg; la sigla c esegue il comando e poi esce.

# a) Leggere l'ID: IDCODE SWD, riconoscimento nRF52840 e protezione APPROTECT

sudo openocd ‐f swimtag_pi.cfg ‐c 'init; dap info; exit'
sudo openocd ‐f swimtag_pi.cfg ‐c 'init; mdw 0x10000100 1; mdw 0x10000060 2; mdw 0x10001208 1; exit'
# | 0x10000100 FICR.INFO.PART deve valere 0x00052840

# | 0x10000060 FICR.DEVICEID[0..1] identifica il singolo chip

# | 0x10001208 UICR.APPROTECT 0xFFFFFFFF = vuoto / non protetto

# L'IDCODE SWD atteso e' 0x2ba01477 (messaggio all'avvio di OpenOCD).

# b) Impostare UICR.REGOUT0 = 3,3 V (VDD del tag da 1,8 a 3,3 V)

# UICR.REGOUT0 = 0x10001304, VOUT = bit 2:0, valore 5 = 3,3 V (0xFFFFFFFD); NVMC.CONFIG = 0x4001E504 (1 = scrittura) sudo openocd ‐f swimtag_pi.cfg ‐c 'init; halt' \

‐c 'mww 0x4001E504 1' ‐c 'mww 0x10001304 0xFFFFFFFD' ‐c 'sleep 100' ‐c 'mww 0x4001E504 0' \
‐c 'mdw 0x10001304 1' ‐c 'reset run' ‐c exit
# | atteso nel mdw: 0x10001304: fffffffd. Il nuovo VDD parte dopo il reset: scollegare e ricollegare

# | la cella se il tester su J4 vede ancora 1,8 V.

# c) Reset

sudo openocd ‐f swimtag_pi.cfg ‐c 'init; reset run; exit' | # reset e riparte
sudo openocd ‐f swimtag_pi.cfg ‐c 'init; reset halt; exit' | # reset e si ferma

# d) Cancellare e caricare bootloader e firmware (esempi con i file generati da PlatformIO / nrfutil)

sudo openocd ‐f swimtag_pi.cfg ‐c 'init; halt; nrf5 mass_erase; exit'
sudo openocd ‐f swimtag_pi.cfg ‐c 'init; halt; program bootloader.hex verify' ‐c 'program firmware.hex verify reset exit' # NB: mass_erase cancella anche UICR: dopo, rifare il passo b) (a meno che il .hex contenga l'UICR).

# e) Verifica del contenuto

sudo openocd ‐f swimtag_pi.cfg ‐c 'init; halt; verify_image firmware.hex; exit'
sudo openocd ‐f swimtag_pi.cfg ‐c 'init; halt; mdw 0x10001304 1; flash info 0; exit'

Alternativa breve: con J-Link o Pico/debugprobe servirebbero cavetti sulle prese dell'HAT, ma l'adattatore e' pensato solo per il Pi. Il VDD (J4) non va mai collegato a VTref di un programmatore che lo alimenti.

### 9.7 Tensioni attese in ogni fase

Fase | VDD sul tester (J4 GND) | Se non e' cosi'
Cella collegata, chip vuoto (UICR vuoto) | 1,8 V (1,7-1,9) | 0 V: cella assente/scarica; 3,3 V: REGOUT0 gia' scritto
Dopo la scrittura REGOUT0 e il reset/power cycle | 3,3 V (3,2-3,4) | ancora 1,8 V: non e' scattato il reset, rifare 'reset run' o scollegare la cella
VIN sul pogo P6 con carica attiva (J3.2-GND) | 4,6-5,1 V | sotto 4,45 V la carica rallenta o non parte
Corrente di carica (J3) | 13,5 mA in CC, ~1,35 mA a fine carica | vedi sezione 3

### 9.8 Limiti dei livelli a 3,3 V e alternative

Finche' il VDD del tag e' 1,8 V il Pi porta SWDIO, SWCLK e RESET a 3,3 V, oltre il limite VDD + 0,3 V dell'nRF52840. Le tre resistenze da 1 kohm limitano la corrente nei diodi di protezione a circa (3,3 1,8 0,5) / 1000 = 1 mA per linea (circa 3 mA in tutto, che finiscono nel VDD del tag). E' tollerabile solo per i pochi minuti del primo collegamento e solo se il tag, con la CPU ferma, assorbe piu' di quei 3 mA (altrimenti il VDD potrebbe salire di qualche decimo di volt). Mitigazioni: (1) scrivere REGOUT0 subito, poi il rischio sparisce; (2) non collegare RESET nel primo passaggio (togliere R3 o sollevare un suo piedino); (3) alzare R1-R3 a 2,2 kohm con 400-500 kHz; (4) adattatore di livello 3,3/1,8 V bidirezionale opendrain (tipo BSS138) su SWCLK e SWDIO; (5) un programmatore con VTref (J-Link), che si adatta ai 1,8 V.

### 9.9 Risoluzione dei problemi

Sintomo | Causa probabile e rimedio
'Error: couldn't open /dev/mem' / 'Permission denied' | lanciare con sudo
'SWD DPIDR 0x00000000' o 'Failed to read' | tag non alimentato (cella), pogo che non toccano: premere, controllare altezza e centraggio; HAT non innestato a fondo
'DPIDR 0xffffffff' | SWDIO a livello alto fisso: pista interrotta, resistenza R1 interrotta, tag in System OFF: dare RESET (pin 12) e riprovare
Errori di parita' / timeout casuali | contatto intermittente: 'adapter speed 200', premere meglio il tag, controllare l'innesto
SwimTag adattatore di programmazione e collaudo v0.5 (HAT) | pag. 17 / 19

OpenOCD parte ma chip non riconosciuto | target/nrf52.cfg troppo vecchio (<0.11): aggiornare OpenOCD
'Failed to examine' / accesso negato con APPROTECT attivo | lanciare 'nrf52_recover' (cancella tutto, e' normale)
mdw 0x10001304 dice fffffffd ma VDD resta a 1,8 V | serve un reset di sistema o un power cycle (togliere un istante la cella)
La carica non parte (LED D1 spento) | JP1 senza ponticello; PTC F1 intervenuto (aspettare); il 5 V non arriva dal pin 2 del Pi; HAT non a fondo
LED acceso ma corrente 0 mA | J3 senza ponticello e senza tester; VIN troppo bassa (v. sezione 3); contatti VIN/GND non toccano
Corrente molto minore di 13,5 mA | VIN-DPM: tester con shunt troppo alto, usare 5,1 V esterno o ponticello; oppure carico del tag acceso
SwimTag adattatore di programmazione e collaudo v0.5 (HAT) | pag. 18 / 19

# 10. Immagini dal progetto KiCad e rigenerazione

Render del file swimtag_programmatore.kicad_pcb (kicadcli): a sinistra la faccia superiore con il rame (le piste sono sul lato dei componenti), a destra la faccia inferiore (solo foratura e connettore).

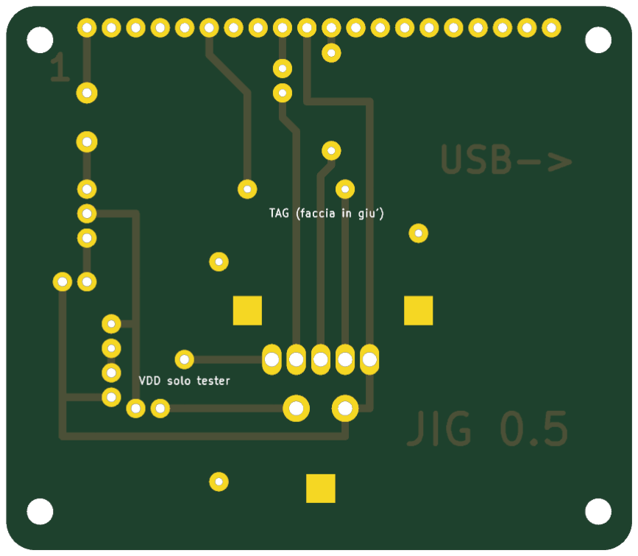
[picture p43: figure]
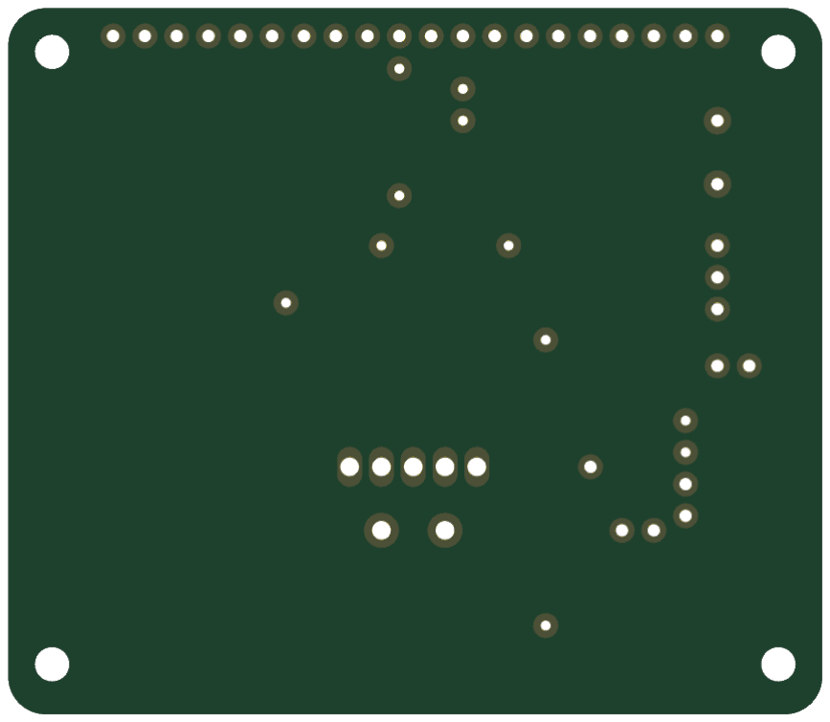
[picture p44: figure]

### Rigenerazione dopo la ricompattazione della scheda

cd hardware/programmatore
python genera_kicad.py ‐‐drc | # rilegge TP1‐TP7 e il contorno dal PCB del tag, riscrive KiCad, esegue DRC ed ERC
python genera_pdf.py | # rigenera questo PDF e le stampe 1:1
# PCB del tag diverso: SWIMTAG_PCB=percorso/al/file.kicad_pcb python genera_kicad.py

Lo script avvisa se il passo delle piazzole non e' piu' 2,54 mm o se TP6/TP7 non stanno piu' sotto SWDIO/RESET (lo sbroglio dei ponti e della ricarica dipende da questo). Con la scheda ricompattata le coordinate dei pogo seguono le piazzole, le battute i bordi del tag.
Dati letti dal PCB del tag per questa copia: scheda tag 21.59 x 28.00 mm; TP1 (5.08, 12.70) O 2.0; TP2 (7.62, 12.70) O 2.0; TP3 (10.16,
12.70) O 2.0; TP4 (12.70, 12.70) O 2.0; TP5 (15.24, 12.70) O 2.0; TP6 (7.62, 17.78) O 2.5; TP7 (12.70, 17.78) O 2.5.
SwimTag adattatore di programmazione e collaudo v0.5 (HAT) | pag. 19 / 19
