PZero/SwimTimer/docs/REQUISITI.md

# Requisiti

Da completare con l'utente dopo le risposte in `docs/DOMANDE-APERTE.md`.

## Funzionali
- Rilevare in automatico la **partenza** (spinta dal muro) e l'**arrivo** (fermata al muro).
- Mostrare i tempi su un display a bordo vasca, leggibile dall'acqua con gli occhialini.
- Nessun pulsante da premere durante la nuotata.

## Non funzionali
- Tag piccolo, leggero, impermeabile per immersione continua in acqua clorata.
- Autonomia almeno per un allenamento completo (indicativamente 2 ore), ricarica semplice.
- Display a batteria, utilizzabile a bordo vasca senza prese di corrente.
