PZero/SwimTimer/media/video/STORYBOARD_v4.md

# Video v4 «Houston, abbiamo un problema» – sequenza da approvare

Stesso metodo dei video v2/v3: **solo scritte a schermo** (niente voce), musica originale generata in codice, 1920x1080, 30 fps, tagli sui battiti (120 BPM), versioni IT ed EN.
Durata: **180 s (3:00)**. Animazioni generate in codice con **dati inventati** (nessun dato reale delle sessioni).

**Clip Marte/Houston** (`~/Downloads`, IT ed EN, 27 s, 1280x720): intera, senza tagli, in una cornice al centro (circa 70% dello schermo) su sfondo blu vasca,
**con il suo audio**. Durante la clip la musica scende molto (circa −18 dB) e risale con una dissolvenza di 1 s.

| Tempo | Scena | Scritte a schermo IT | Scritte a schermo EN | Immagini |
|---|---|---|---|---|
| 0–6 | **Apertura** | «Se nei test ti pianti, è perché sei arrivato a un livello di dettaglio nuovo.» | «If your tests crash, it's because you've reached a new level of detail.» | Testo che compare parola per parola su fondo scuro |
| 6–33 | **La prima scheda** | didascalia: «Dove eravamo rimasti» | caption: «Where we left off» | Clip Marte/Houston intera, in cornice, con il suo audio |
| 33–43 | **Houston** | «Houston, abbiamo un problema.» · «11 novembre: la tag nuota in un palloncino non stagno.» | «Houston, we have a problem.» · «November 11th: the tag swims inside a leaky balloon.» | Palloncino animato che galleggia, gocce che entrano |
| 43–55 | **Il grafico si ferma** | «Minuto 10: il grafico si ferma.» · «Perché?» | «Minute 10: the graph stops.» · «Why?» | Grafico del movimento (inventato) che scorre e si interrompe; linea piatta |
| 55–63 | **La scatola nera** | «Le abbiamo dato una scatola nera.» | «We gave it a black box.» | Lente sopra la tag spenta, poi scatola nera arancione che si apre |
| 63–78 | **La confessione** | «Ha confessato:» · «lo zaino della memoria per il Bluetooth era troppo piccolo.» · «Un passo di troppo… e trabocca.» | «It confessed:» · «the memory backpack for Bluetooth was too small.» · «One step too many… and it overflows.» | Zaino che si riempie, indicatore in rosso, l'ultimo oggetto fa traboccare tutto |
| 78–86 | **Cambi 1 e 2** | «① La scatola nera resta.» · «② Zaino doppio.» | «① The black box stays.» · «② A backpack twice as big.» | Scatola con spunta verde; zaino che si allarga |
| 86–96 | **Cambio 3** | «③ Una stazione a bordo vasca.» · «Ogni pezzo salvato riceve una ricevuta.» | «③ A poolside station.» · «Every saved piece gets a receipt.» | Catena tag → ricevitore → piccolo computer e monitor; a ogni blocco esce una ricevuta |
| 96–102 | **Risultato a banco** | «Quasi 1000 blocchi, zero persi.» | «Almost 1,000 blocks, zero lost.» | Contatore che sale a 985, «0 persi» in verde |
| 102–106 | **Anche il ritmo** | «Non solo hardware. Anche il ritmo.» | «Not just hardware. Rhythm too.» | Metronomo stilizzato; sotto, una riga di tacche corto/lungo che prosegue tratteggiata |
| 106–116 | **Le tacche** | «Ogni bracciata lascia una tacca:» · «corto, lungo, corto, lungo.» | «Every stroke leaves a tick:» · «short, long, short, long.» | Nuotatore curato (corpo, testa con cuffia e occhialini, braccia alternate, gambe che battono) che avanza verso il muro a destra; a ogni bracciata una tacca piena resta nello spazio della corsia, dove la mano è entrata (passo corto/lungo) |
| 116–122 | **Il ritmo si proietta** (PREVISIONE) | «Il ritmo si proietta in avanti.» · etichetta «previsto» | «The rhythm projects forward.» · label «predicted» | Dall'ultima tacca parte un impulso verso il muro e lascia 3 tacche fantasma tratteggiate (stessa alternanza corto/lungo, l'ultima sul muro); il nuotatore rallenta e la prima fantasma diventa piena quando la mano ci arriva |
| 122–134 | **Il tocco** | «Il sensore: il tocco è qui… più o meno.» · «Il tocco cade su un battito del ritmo.» · «32,47 s» | «The sensor: the touch is here… roughly.» · «The touch lands on a beat of the rhythm.» · «32.47 s» | Fascia rossa larga al muro (copre 2 fantasma), poi si stringe e scatta sulla tacca fantasma sul muro: diventa piena e verde, la mano tocca lì; tempo inventato |
| 134–142 | **La scivolata** | «Tacca vuota: scivolata finale.» · «Arriva bene al muro!» | «Empty tick: the final glide.» · «A clean finish at the wall!» | Ultima bracciata reale, poi il nuotatore scivola a braccia tese; la tacca prevista prima del muro resta vuota e tocca comunque |
| 142–152 | **In verifica** | «Pista promettente, in verifica:» · «su 12 arrivi l'errore scende da circa 0,8 a 0,5 s, ma dipende dalla taratura.» | «A promising lead, still being checked:» · «over 12 finishes the error drops from about 0.8 to 0.5 s, but it depends on calibration.» | Cartello «in verifica», valori in giallo |
| 152–162 | **Il prossimo livello** | «Prossimo livello: 1 ora a banco con 2 tag.» · «Poi di nuovo in vasca.» | «Next level: 1 hour on the bench with 2 tags.» · «Then back in the pool.» | Due tag affiancate, orologio che gira; poi la vasca |
| 162–172 | **La frase che torna** | «Se nei test ti pianti, è perché sei arrivato a un livello di dettaglio nuovo.» | «If your tests crash, it's because you've reached a new level of detail.» | Come l'apertura, su sfondo vasca chiaro |
| 172–180 | **Chiusura** | swimtimer-pzero.web.app · GitHub PZero/SwimTimer | swimtimer-pzero.web.app · GitHub PZero/SwimTimer | Logo e indirizzi, stacco musicale finale |

## Capitoli YouTube (IT / EN)
0:00 Apertura / Opening · 0:06 La prima scheda / The first board · 0:33 Houston, abbiamo un problema / Houston, we have a problem ·
0:55 La scatola nera / The black box · 1:18 Tre cambi / Three changes · 1:42 Anche il ritmo / Rhythm too · 2:32 Il prossimo livello / The next level

## Note
- **Palloncino**: animato. Se giri una breve ricostruzione col telefono, la inserisco a 33–43 con la scritta «ricostruzione».
- Tutti i dati delle animazioni (grafico, «32,47 s») sono inventati.
