PZero/SwimTimer/firmware/xiao-stream/PROVA-0.6.1.md

# Prova a secco della 0.6.1 (xiao-stream)

Da fare con la tag a batteria (senza USB), con la build **di prova**: `arduino-cli compile ... --build-property compiler.cpp.extra_flags=-DPROVE_GUASTI=1` (versione `xiao-0.6.1-prove`, diario `AVV ... PROVE`, segmento `0.6.1p`). La build normale (`PROVE_GUASTI = 0`, predefinito) non ha i comandi `PROVA_*`. Dopo ogni caso: collegare la tag all'USB del PC (resta in modalita' normale),
aprire la seriale a 115200 e inviare `DIARIO` (oppure dalla pagina: comando `DIARIO` sulla caratteristica 0004, le righe arrivano nel pannello «Log tag»);
poi scaricare con `python scarica.py scarica COMxx` e leggere il riassunto di `swr.py` (origine del segmento, GUASTO, FIFO, SCAMBIATI).
I comandi `PROVA_*` si mandano via BLE sulla 0004 (la pagina, o `bleak`): arrivano anche in registrazione.

Legenda diario: `AVV causaN rrXXX marcaYY vbusZ` (causa: 0 accensione, 1 doppio tap, 3 watchdog, 5 software, 6 lockup, 7 USB, 8 pin; rr = RESETREAS compattato: bit0 pin, bit1 watchdog, bit2 software, bit3 lockup, bit4 uscita da System OFF, bit8 VBUS), `MODO`, `USB PC|caricatore|staccata`, `REG+ orN` (0 tocchi, 1 marca, 2 flash), `REG- motN`, `GUASTO tN faseN pcXXXXXXXX`, `FIFO DISALL`, `OVERRUN`, `CONN`, `SYNC`.

| # | Caso | Passi | Esito atteso |
|---|---|---|---|
| 1 | USB al PC, modalita' normale | Collegare la tag al PC, aprire la seriale | Resta in modalita' normale (log `boot xiao-0.6.1`, annuncio PRONTA), mai registra. Diario: `AVV`, `MODO normale`, `USB PC`. |
| 2 | USB a un caricatore | Collegare a un alimentatore senza dati | Modalita' normale, nessuna registrazione; diario `USB caricatore` (visibile dopo averla collegata al PC). LED accesi solo con USB. |
| 3 | Stacco USB -> sonno | Tag in modalita' normale (caricatore o PC): staccare il cavo | Dopo ~0,5 s annuncio SONNO per ~2 s, poi System OFF (non si annuncia piu'). Diario: `USB staccata`, `MODO sonno mot4`. |
| 4 | Risveglio a tocchi | Dopo il caso 3: 2 tocchi, blu, 2 tocchi | Registra (annuncio REGISTRA sul display/pagina). Diario: `REG+ or0`. |
| 5 | Batteria appena collegata | Scollegare e ricollegare la cella senza USB | La tag NON entra in modalita' normale ne' registra: dorme subito (nessun annuncio). Diario: `AVV causa0`, `MODO sonno mot5`. |
| 6 | Nome/colore a batteria | (tag in registrazione) comando `NOME,prova` via BLE | `X registrazione in corso`. Con la tag su USB e' accettato; con USB staccata non esiste la modalita' normale. Prova diretta del messaggio `X solo con USB`: tag in modalita' normale su caricatore, staccare e mandare `NOME,x` entro 0,5 s (difficile: basta verificare nel codice). |
| 7 | PROVA_CRASH in registrazione | Registrare (caso 4), collegarsi via BLE, inviare `PROVA_CRASH` | La tag si riavvia e **riprende da sola** una registrazione nuova (nuovo segmento, nessun tocco, BLE di nuovo annunciato come REGISTRA). Collegata al PC: diario `GUASTO t1 ... pc ...` (il PC si risolve con `arm-none-eabi-addr2line -e xiao-stream.ino.elf <pc>`) e `RIPRESA 1/3 or1`; `swr.py`: origine «ripresa dopo riavvio (marca)», GUASTO HardFault con PC/LR/CFSR. |
| 8 | PROVA_BLOCCO in registrazione | Come 7 con `PROVA_BLOCCO` | Dopo ~8 s reset del watchdog, ripresa automatica con causa `watchdog` (RESETREAS 0x2), GUASTO t4 con il PC del ciclo infinito; il FIFO non va in overrun grave (gap di ~8 s fra i due segmenti). |
| 9 | PROVA_RESET in registrazione | Come 7 con `PROVA_RESET` | Ripresa automatica, causa software (RESETREAS 0x4), nessun contesto di guasto. |
| 10 | Protezione dai cicli | Ripetere 7 quattro volte di fila senza fermare ne' ripartire con i tocchi | Terza ripresa ok (`RIPRESA 3/3`); alla quarta: annuncio ERRORE ~3 s, poi sonno; diario `RIPRESA 4/3`, `NOTA 3`. Si riparte solo con i tocchi. |
| 11 | Seconda rete (brownout) | In registrazione scollegare un attimo la cella e ricollegarla (senza USB) | Se GPREGRET2 e' stato perso: riprende lo stesso (origine «flash»), purche' l'ultimo segmento non abbia la chiusura. Se la marca e' sopravvissuta: origine marca. Entrambe valide. |
| 12 | Niente ripresa con batteria bassa | Ripetere 7 con cella sotto 3,4 V | Nessuna ripresa: lampi rossi (solo con USB) e sonno. |
| 13 | Stop per quiete | Registrare, lasciare la tag ferma su un tavolo 5 min | Dopo 180 s di quiete il segmento si chiude (motivo «quiete»), la tag dorme. **Atteso corretto solo ora**: prima giro e acc erano scambiati e la quiete non scattava. Verificare in `swr.py` motivo «quiete» e assenza di SCAMBIATI. |
| 14 | Borsa scossa | Tag in sonno in una borsa, scuoterla 10 min | I falsi risvegli si contano nel diario (`FALSO risveglio tocchiN`, solo con `PROVE_GUASTI = 1`: ogni falso risveglio scrive nella flash). Registrazioni involontarie: nessuna se non arrivano 4 tocchi veri. |
| 15 | Memoria piena | Con la memoria tutta «da validare» (nessuna conferma dal display), registrare | 5 lampi rossi (solo USB), annuncio PIENA 2 s, sonno. Nessuna ripresa a catena (la marca e' B7). |
| 16 | Display fuori portata | Registrare lontano dal display per tutto l'allenamento | Nessun effetto sulla registrazione; sul display al rientro: blocchi da validare. Diario: nessun `SYNC`. |
| 17 | System OFF col watchdog (**non verificato**) | Tag a batteria in sonno per piu' di 1 minuto, poi 4 tocchi | Deve restare in sonno (nessun `AVV` extra nel diario fra i due). Se nel diario compaiono avvii con causa 3 (watchdog) durante il sonno, il WDT scatta in System OFF: segnalare. |
| 18 | FIFO: disallineamenti reali | Registrare 10 min muovendo la tag, scaricare | In `swr.py`: riga `FIFO: N disallineamenti`, **nessun** avviso SCAMBIATI, pochi `GAP` raggruppati. |
| 19 | Crash durante `anello.apri` (cancellazione di un settore) | In registrazione con la memoria piena di blocchi confermati (cosi' `apri` cancella), mandare `PROVA_CRASH` appena si apre un nuovo blocco (tentare piu' volte, ogni ~3 s di registrazione si chiude una pagina; il blocco si apre ogni 15 pagine) | Dopo la ripresa il blocco aperto risulta «da validare» (MEM da USB), il `seq` nuovo e' maggiore dei precedenti (nessun riuso), nessun blocco anomalo se non uno sporco (si cancella da solo). |
| 20 | Crash durante la scrittura di una pagina | `PROVA_CRASH` ripetuto a caso in registrazione (ogni ~190 ms si scrive una pagina) | Il blocco e' «da validare», l'ultima pagina puo' mancare o essere corrotta (CRC errata): `swr.py` la segnala e le altre restano; seq non riusato. |
| 21 | Crash durante `diarioFlush` / `regScrivi` | Registrare e provocare un `PROVA_CRASH` mentre c'e' un flush del diario in corso (ogni 120 s) o subito dopo l'avvio della registrazione (`regScrivi`) | Al boot `/reg.bin` e' o il vecchio o il nuovo stato (scrittura atomica con rinomina), mai metà: la ripresa avviene o non avviene ma non si blocca; il diario perde al piu' gli ultimi eventi. |
| 22 | Crash con l'USB inserita | Tag su USB (PC), `PROVA_CRASH` | Nessuna ripresa: modalita' normale, diario `GUASTO t1 ...`, nessun `REG+`. |
| 23 | USB inserita durante una ripresa | Registrare, `PROVA_CRASH`, collegare l'USB entro ~2 s dal riavvio (durante `modalitaVasca(1)`) | Se VBUS compare prima del controllo: modalita' normale; se compare dopo: la registrazione riparte e si chiude con motivo «USB collegata» e riavvio in modalita' normale (`REG- mot4`). In nessun caso un blocco o un segmento restano incoerenti. |
| 24 | `/reg.bin` cancellato in un ciclo | Con `PROVA_CRASH` ripetuto, dopo la prima ripresa cancellare `/reg.bin` e `/reg.tmp` da USB (`InternalFS.remove` con uno sketch, oppure `ERASE` non basta: e' un altro file) e ripetere | La marca in GPREGRET2 porta il conteggio: la tag si ferma comunque alla quarta ripresa. |
| 25 | 1 ora in movimento | Tag in tasca/al polso per 1 h con registrazione, poi scaricare | `swr.py`: `FIFO: N disallineamenti` (attesi ~1-4/min, vedi LEGGIMI), **0 SCAMBIATI**, motivo di fine corretto; nel diario `FIFO riall +N` cumulativi (uno ogni 120 s), `NOTA 7 <dia ms> <reg ms> <gapmax>`: `gapmax` (statGapMax) sotto 1000 ms; scritture del diario ~30 in 1 h. Memoria: blocchi/min vicini a 22 (0.6.0: 666 blocchi in 15 min con 2 tag). |
| 26 | IMU bloccato durante la registrazione | Scollegare/disturbare l'IMU non e' possibile: simulare con `PROVA_BLOCCO` e verificare anche il caso reale a lungo termine | Se i campioni non crescono per 5 s si smette di servire il watchdog: reset dopo circa **13 s** dall'ultimo campione (5 s di rilevamento + 8 s di watchdog) e ripresa (`NOTA 6` nel diario, causa watchdog). |
| 27 | Consumo in sonno per una notte con il WDT | Tag in sonno 8-12 ore, misurare la corrente (multimetro in serie) e controllare il diario al mattino | Corrente ~0,1-0,2 mA (stima, vedi LEGGIMI) e nessun `AVV` con causa 3 durante la notte (il watchdog non scatta in System OFF). |
| 28 | Batteria a 3,3-3,4 V e brownout | Cella quasi scarica (3,3-3,4 V): registrare, poi scollegare la cella 1 s e ricollegarla | Sotto 3,4 V: niente ripresa e niente registrazione dopo il tocco (lampi rossi solo con USB, un lampo da 15 ms a batteria nei casi di ripresa/IMU muto/avvio senza motivo). Dopo il brownout: seconda rete solo se `/reg.bin` e' attivo; il tempo di sessione risulta «NON CONTINUO». |
| 29 | Build 0: `PROVA_CRASH` risponde X | Compilare senza `-DPROVE_GUASTI`, collegarsi in BLE e mandare `PROVA_CRASH` (e `PROVA_BLOCCO`, `PROVA_RESET`, `PROVA_FIFO`) | Risposta `X non supportato` e la tag non si riavvia; la versione e' `xiao-0.6.1` (senza `-prove`). Provato anche su USB: `X comando`. |
| 30 | OTA | Tag su USB: aggiornare via BLE dalla pagina `0.6.1` -> stessa versione e poi una versione piu' nuova; a batteria: il comando `OTA` non e' raggiungibile (niente modalita' normale) | OTA riuscita solo con USB; la build di prova e quella normale hanno lo stesso `VER_NUM` (0.6.1): l'OTA fra le due e' rifiutata come «stessa versione» (caricare via USB). Dopo l'OTA il watchdog non scatta (`ramInstalla` lo serve). |
| 31 | Tempo di sessione continuo | Registrare, `PROVA_CRASH`, lasciar riprendere, ripetere 2 volte; scaricare | `swr.py`: ogni segmento ripreso mostra «tempo di sessione = millis + N ms (+-M ms), origine istante esatto». Con un brownout (caso 28) invece «TEMPO NON CONTINUO». Misurare T_AVVIO a batteria con `misura_avvio.py --ble ...` (vedi LEGGIMI). |
| 32 | IMU che non parte in ripresa | Registrare, `PROVA_CRASH`; al riavvio l'IMU non risponde (difficile da provocare: si puo' simulare con un contatto lento sul pin P1.08 / cella molto scarica; oppure verificare la logica rileggendo `uscitaAnticipata`) | In ripresa (origine != 0) l'IMU muto o `vImuAvvia` fallito causa un **reset** (consuma una ripresa, `NOTA 9`): al riavvio l'IMU viene riacceso; dopo 3 riprese consecutive: annuncio ERRORE e sonno con stato disarmato (`/reg.bin` attivo = 0, marca B7), lampo rosso da 15 ms. Con una partenza a tocchi lo stato viene disarmato subito e non c'e' reset. |
| 33 | Stallo con BLE collegato | Tag su USB (build di prova), `python ble_carico.py --secondi 180` (un client BLE collegato; la tag fa girare il servizio del FIFO con un diarioFlush ogni 10 s e un regScrivi ogni 60 s) | `gmax` (intervallo massimo fra servizi del FIFO) **< 1000 ms** e `ovr 0`. Se non basta: dirlo con i numeri (non spostare il diario in QSPI senza il coordinatore: tocca la mappa a 512 blocchi del display). Con il display vero collegato e in sincronizzazione: leggere `NOTA 7 <dia> <reg> <gapmax>` nel diario a fine registrazione. |
| 34 | Crash durante `regScrivi` in chiusura | Registrare, lasciar chiudere (quiete o `SLEEP`) e provocare un `PROVA_CRASH` entro 1,5 s dalla chiusura (la chiusura scrive la marca B7 e poi `/reg.bin`: ~1 s) | La marca B7 e' gia' scritta: al riavvio la tag dorme (nessuna ripresa); se `/reg.bin` e' ancora attivo, il successivo avvio con USB lo annulla (`NOTA 1`). Il segmento e' chiuso (`swr.py`: motivo di fine presente). |
| 35 | Quiete con `wdtSospeso` | Tag ferma su un tavolo 5 min con il display in portata e in sincronizzazione (la chiusura attende lo scarico fino a 60 s) | Dopo l'uscita dal ciclo il watchdog si serve di nuovo: nessun `AVV` con causa watchdog dopo `REG- mot1`, la tag dorme. (Con un flusso fermo di 5 s il watchdog resta sospeso solo finche' si registra.) |
| 36 | Urti con `PROVA_FIFO` modo 1 | Vedi «Prova fisica degli urti» qui sotto | Almeno 50 sospetti; `bn` non oltre la baseline + 1; con il taglio forzato esattamente 1 riallineamento in piu' per ogni taglio. |
| 37 | Cella ricollegata dopo un'uscita anticipata | Provocare un'uscita anticipata in ripresa/avvio (batteria < 3,4 V con ripresa, memoria piena, formato estraneo); scollegare e ricollegare la cella (anche dopo ore) | Nessuna ripresa da sola: `/reg.bin` e marca sono disarmati (`uscitaAnticipata`). Un lampo rosso da 15 ms nell'uscita. Diario: `MODO sonno mot5`. |
| 38 | Due reset entro 500 ms (DFU) | Premere il reset due volte in 500 ms con la tag a batteria o su USB e un firmware 0.6.1 in esecuzione (il bootloader entra in DFU); poi caricare un firmware via USB | La tag resta in DFU e accetta il caricamento: il bootloader serve il watchdog nel suo ciclo (fonte: `bootloader.c` 0.6.2). Al termine l'app riparte (un solo reset del WDT se il nuovo firmware non lo serve). |
| 39 | Catena di 3 riavvii confrontata con il video | Filmare la tag (o un orologio) durante una registrazione; provocare 3 volte `PROVA_CRASH`/`PROVA_BLOCCO` a distanza di ~1 min; scaricare e confrontare con il video il tempo di sessione (`millis + scarto`) di un evento riconoscibile (es. un colpo) in ciascun segmento | Errore entro il margine dichiarato (~30 ms col gestore per riavvio, ~90 senza; somma sui 3 riavvii); nessun salto fra segmenti. Con un brownout nella catena: «TEMPO NON CONTINUO». |
| 40 | USB instabile (difetto visto il 2026-11-11) | Tag collegata al PC: muovere il cavo e toccare il connettore per 1 min; staccare e ricollegare 10 volte con pause da 0,5 a 3 s; ricollegare un cavo a una tag che dorme | Con stacchi sotto i 2 s nessun `USB staccata`. Un risveglio da USB non torna mai a dormire: se VBUS arriva in ritardo compare `NOTA 12 1 <ms>`, mai `AVV causa7 … vbus0` seguito da `MODO sonno mot5`. Un sonno chiesto con l'USB presente diventa un riavvio (`NOTA 11`). |

## Prova fisica degli urti (per l'utente, tag su USB, build di prova)
Serve a vedere che il controllo sul contenuto del FIFO non crei sfasamenti con urti veri (bordo, tuffo, spinta). Programma sul PC: un terminale seriale a 115200 sulla porta della tag (o `python ser.py` / `misura_avvio.py` per i comandi); `pip install pyserial`.
1. **Baseline a riposo**: tag ferma sul tavolo, inviare `PROVA_FIFO,60,0` e aspettare la riga `n... ok... sw... dis... sos... rc... bn...` (circa 70 s). Annotare `dis`, `rc`, `bn` e `sw` (sw deve essere 0).
2. **Urti**: ripetere `PROVA_FIFO,60,0` e, **subito dopo il comando**, battere la tag (in mano, con il cavo allentato) sul tavolo almeno 50 volte in 60 s (colpi netti, circa uno al secondo, anche di piatto e di lato).
   Criterio: `sos` >= 50 (i colpi sono notati), `sw` = 0, `bn` non oltre `bn(baseline) + 1` (i colpi non devono produrre riallineamenti).
3. **Taglio forzato con urti**: `PROVA_FIFO,60,1` battendo la tag come sopra. Il taglio (3 parole tolte a meta' prova) deve produrre **esattamente 1 riallineamento in piu'** rispetto alla baseline: `dis` = `dis(baseline)` + 1 al massimo, `sw` = 0. (Con la tag ferma gli sfasamenti spontanei sono ~5/min: per questo il criterio e' relativo alla baseline.)
4. Ripetere 3 volte; incollare le righe nel rapporto.

## Prove gia' fatte con la tag su USB (2026-11-11, COM15)
- `PROVA_RESET`, `PROVA_CRASH`, `PROVA_BLOCCO` (watchdog dopo ~8 s, contesto salvato, riavvio in modalita' normale), caricamenti USB ripetuti (il bootloader serve il WDT in DFU).
- `PROVA_FIFO` (4 prove da 60 s, 51 271 campioni: 0 scambiati, 19 riallineamenti; con taglio forzato 3199/3199), `PROVA_TEMPI` (diarioFlush 400-625 ms, 808 ms con rotazione, regScrivi 1217 ms).
- Tempo di sessione: `misura_avvio.py --seriale COM15` crash n=10 (media 499,8 ms, 495,0-518,1), watchdog n=6 (media 495,6, 495,2-496,0); `--ble auto` crash n=3 (493,2 ms). T_AVVIO a **batteria (senza VBUS)**: da misurare (caso 31).
- Build 0 (`PROVE_GUASTI=0`): `PROVA_CRASH`, `PROVA_BLOCCO`, `PROVA_RESET`, `PROVA_FIFO` rispondono `X comando` e la tag non si riavvia.
Non provati dalla tag: tutti i casi a batteria.
