PZero/SwimTimer/firmware/display-sync/web/anteprima-iphone.png

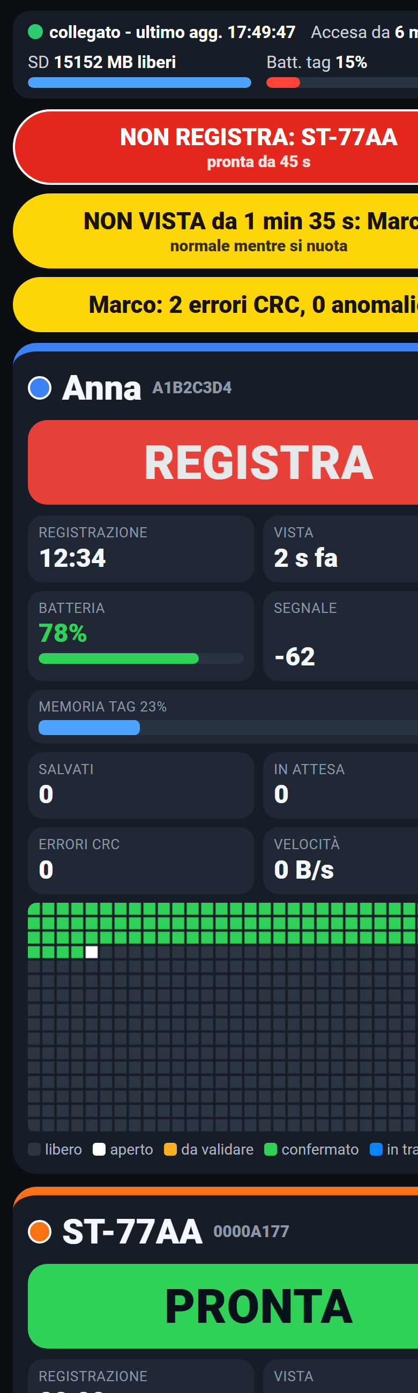
firmware/display-sync/web/anteprima-iphone.png
