PZero/SwimTimer/hardware/display-involucro/render/1-assieme-30.png

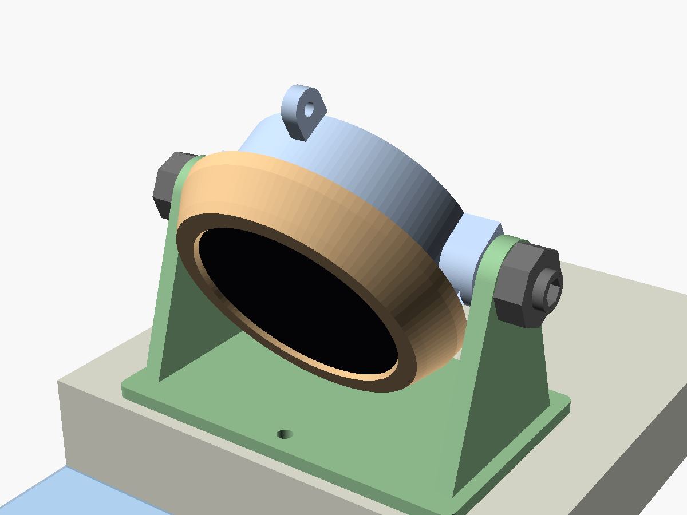
hardware/display-involucro/render/1-assieme-30.png
