PZero/SwimTimer/hardware/display-involucro/render/2-fianco-0.png

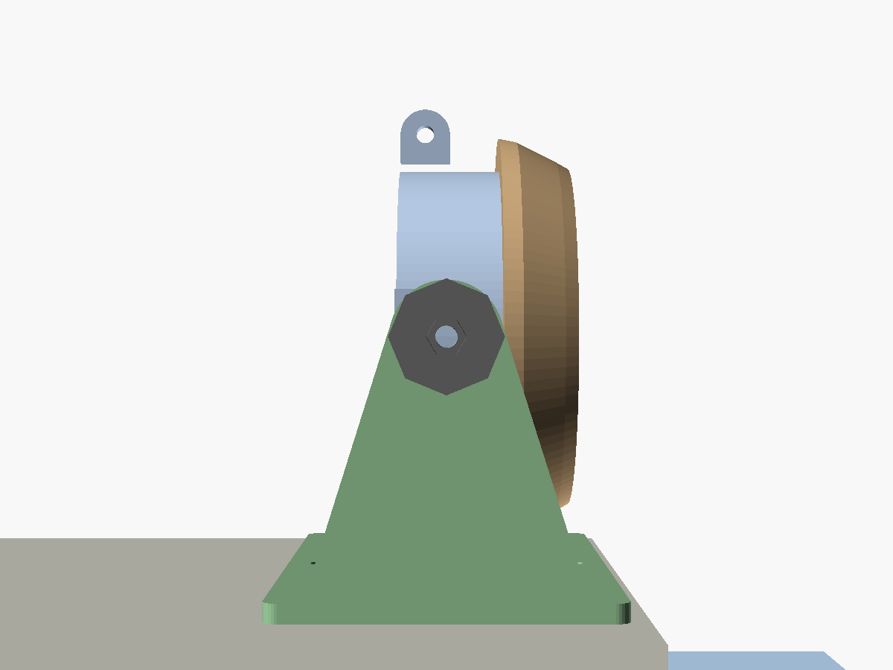
hardware/display-involucro/render/2-fianco-0.png
