PZero/SwimTimer/hardware/display-involucro/render/2-fianco-30.png

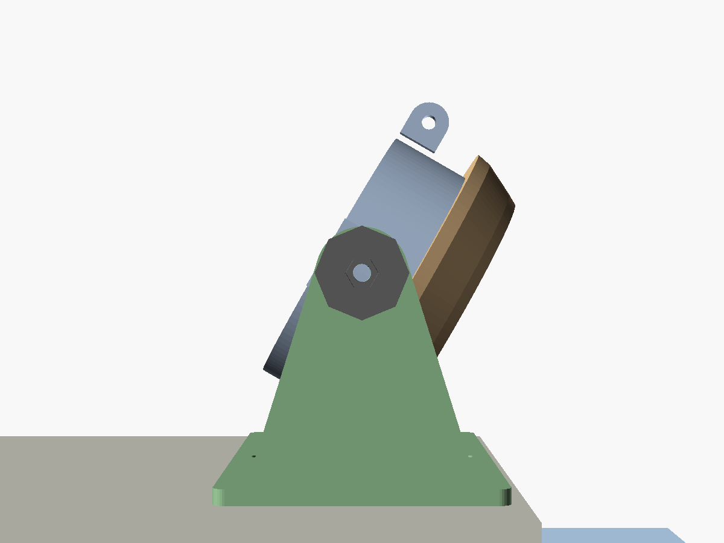
hardware/display-involucro/render/2-fianco-30.png
