PZero/SwimTimer/hardware/display-involucro/render/3-vaso.png

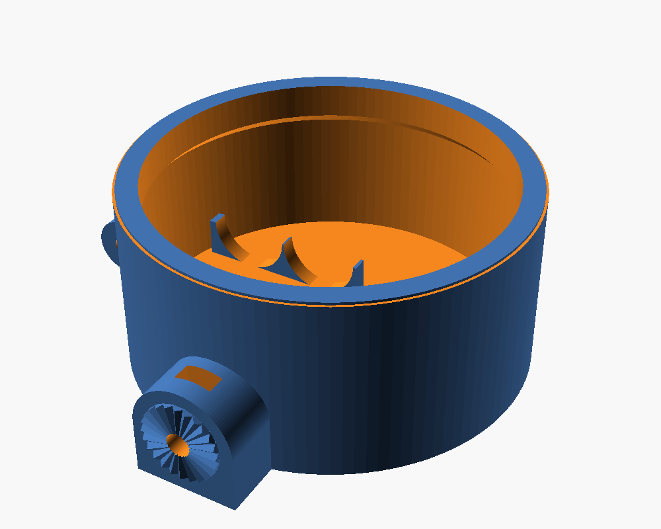
hardware/display-involucro/render/3-vaso.png
