PZero/SwimTimer/hardware/display-involucro/render/4-forcella.png

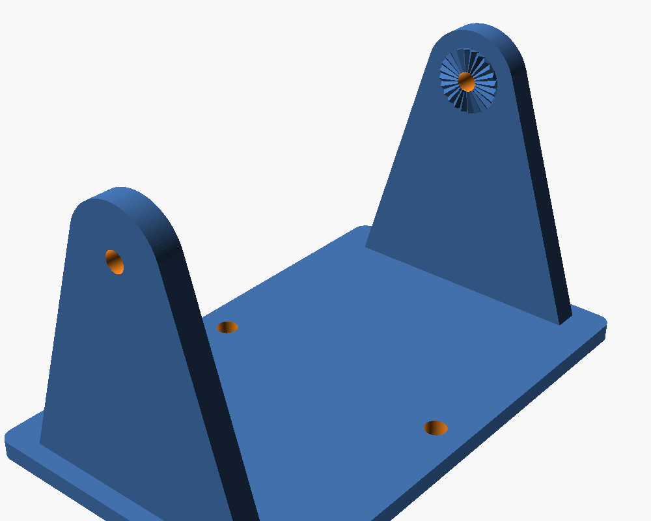
hardware/display-involucro/render/4-forcella.png
