PZero/SwimTimer/hardware/nrf52840/kicad/jlc/v0.3_swimtag_collaudo/render_sopra.png

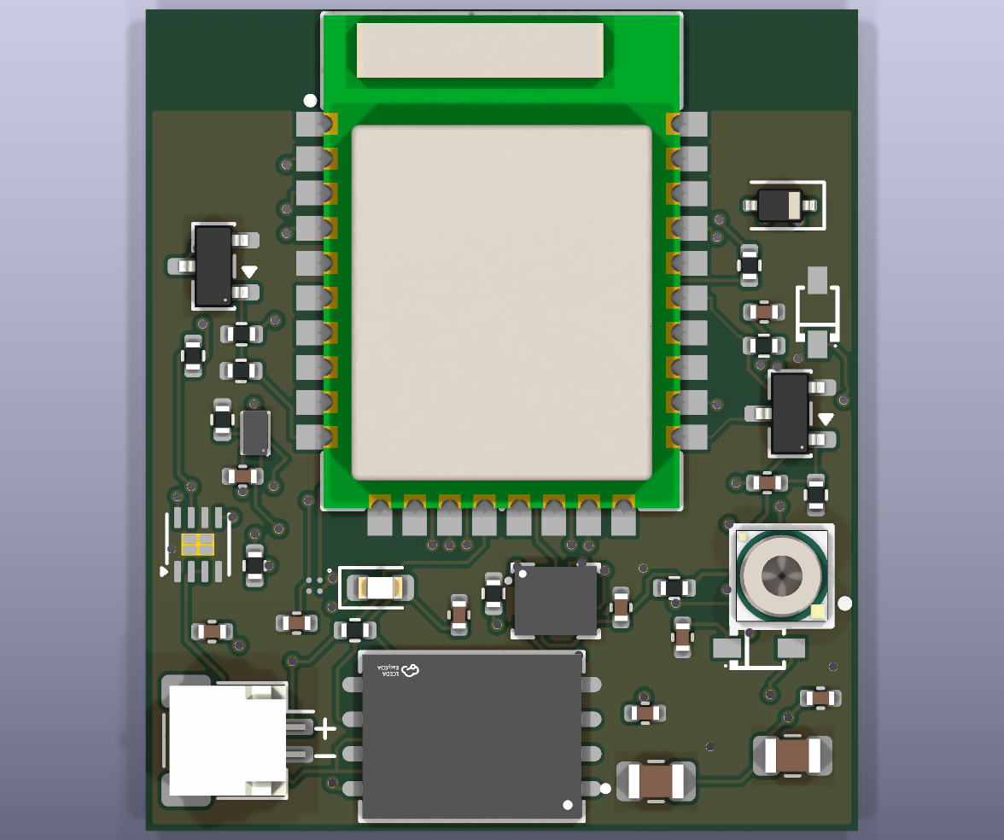
hardware/nrf52840/kicad/jlc/v0.3_swimtag_collaudo/render_sopra.png
