PZero/SwimTimer/hardware/nrf52840/kicad/jlc/v0.6_swimtag_v06/render_sotto.png

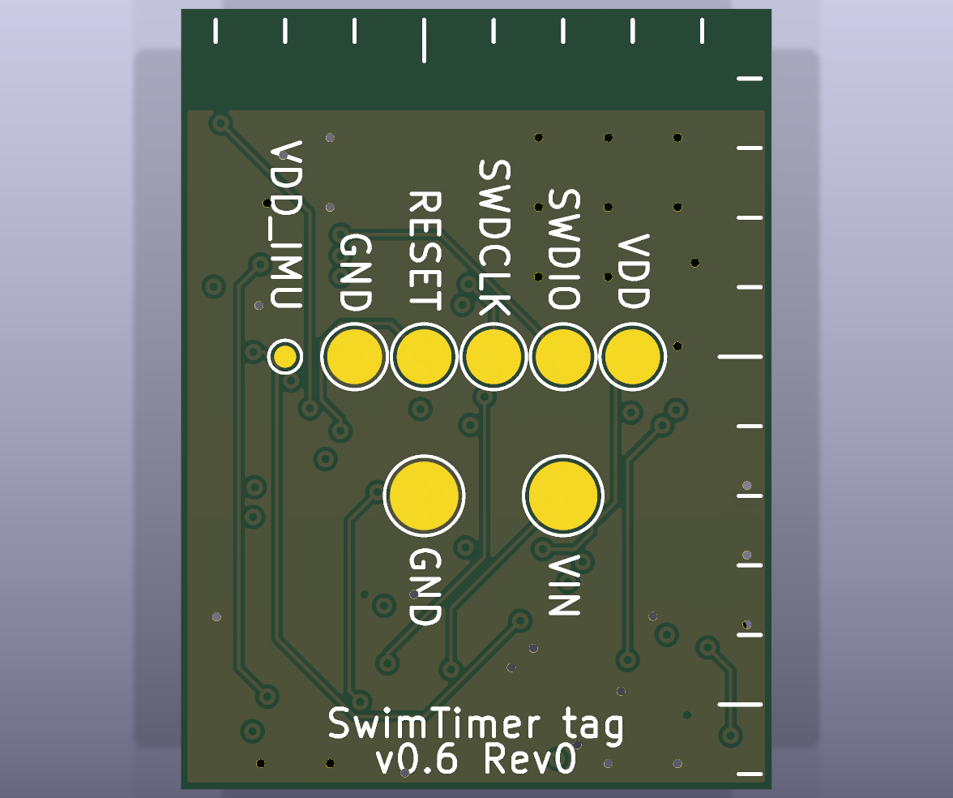
hardware/nrf52840/kicad/jlc/v0.6_swimtag_v06/render_sotto.png
