PZero/SwimTimer/hardware/nrf52840/kicad/prova/render_collaudo_sotto.png

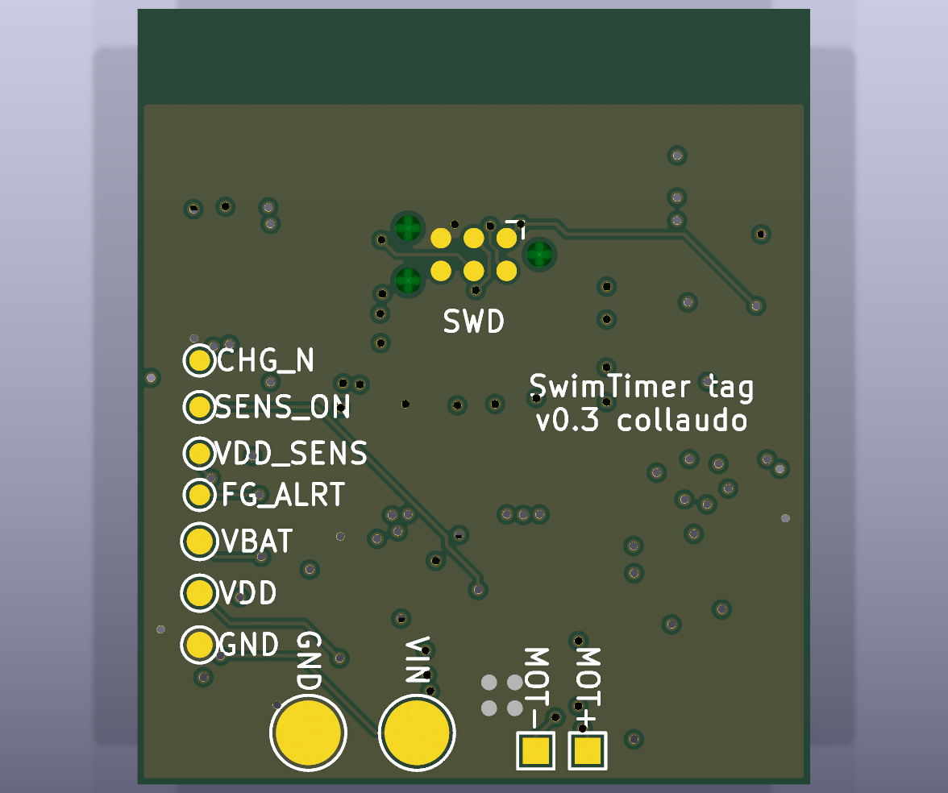
hardware/nrf52840/kicad/prova/render_collaudo_sotto.png
