PZero/SwimTimer/hardware/nrf52840/saldatura_cella_v0.5.png

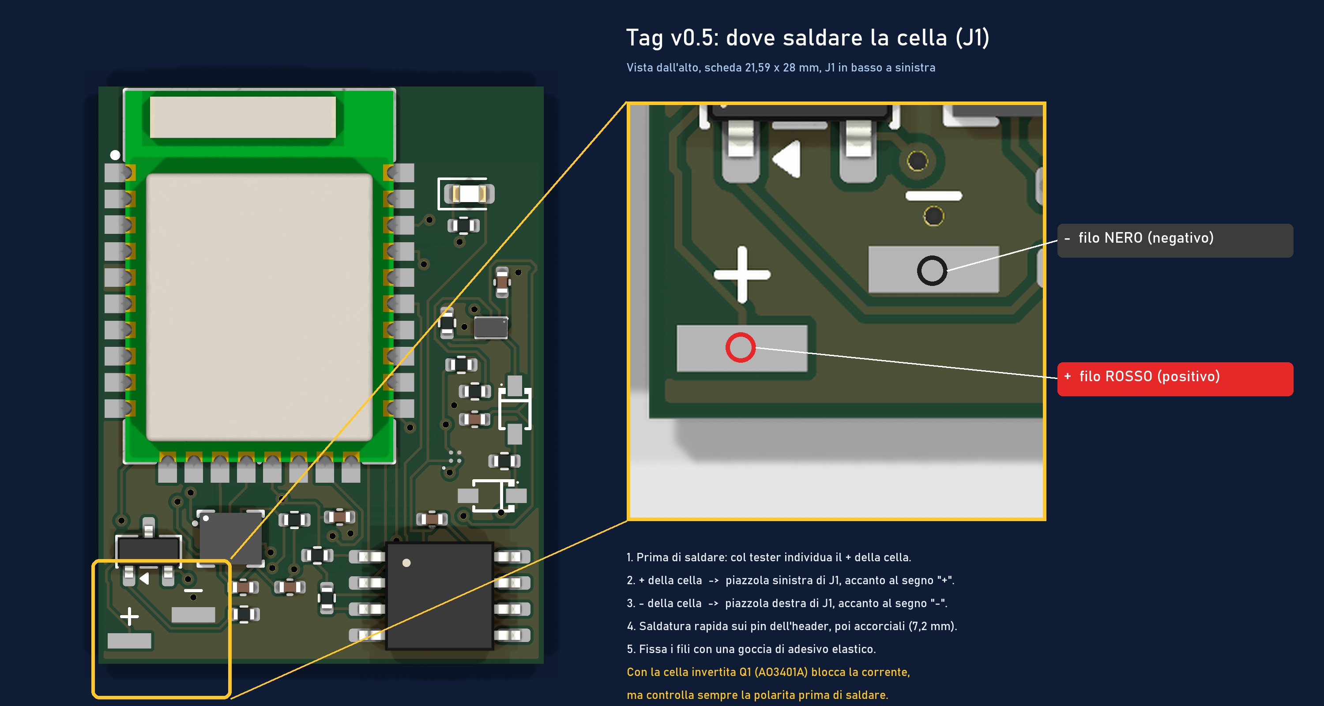
hardware/nrf52840/saldatura_cella_v0.5.png
