PZero/SwimTimer/hardware/nrf52840/wallpaper/png/01_pianta.png

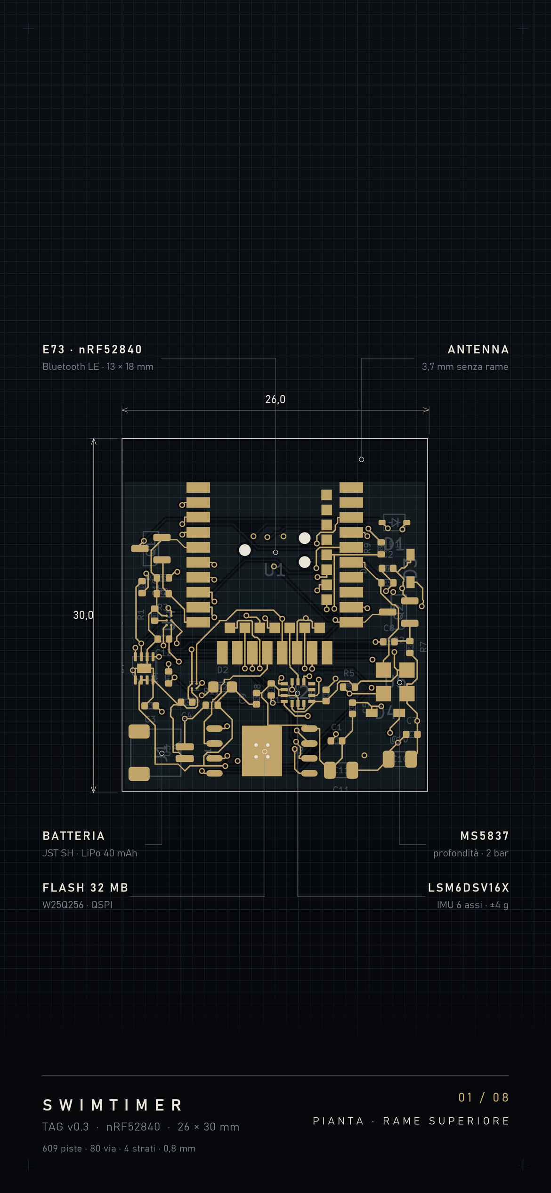
hardware/nrf52840/wallpaper/png/01_pianta.png
