PZero/SwimTimer/hardware/nrf52840/wallpaper/png/02_strati.png

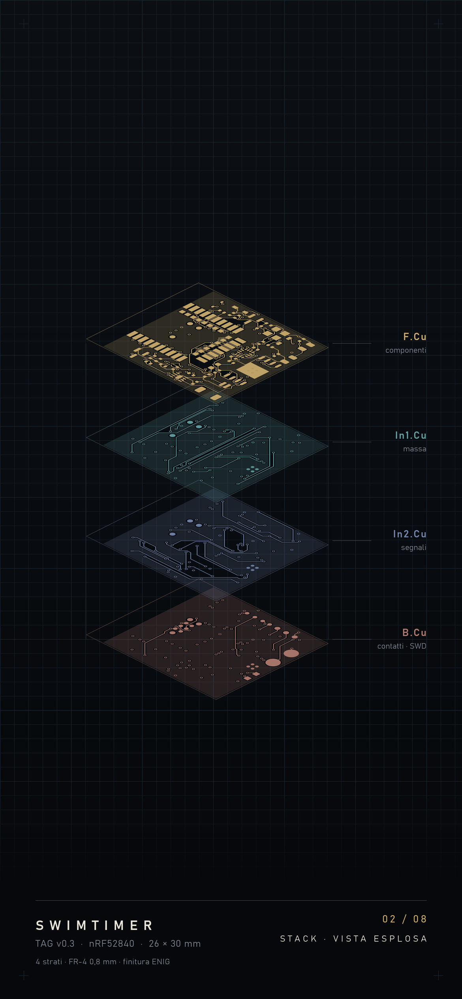
hardware/nrf52840/wallpaper/png/02_strati.png
