PZero/SwimTimer/hardware/nrf52840/wallpaper/png/03_macro_modulo.png

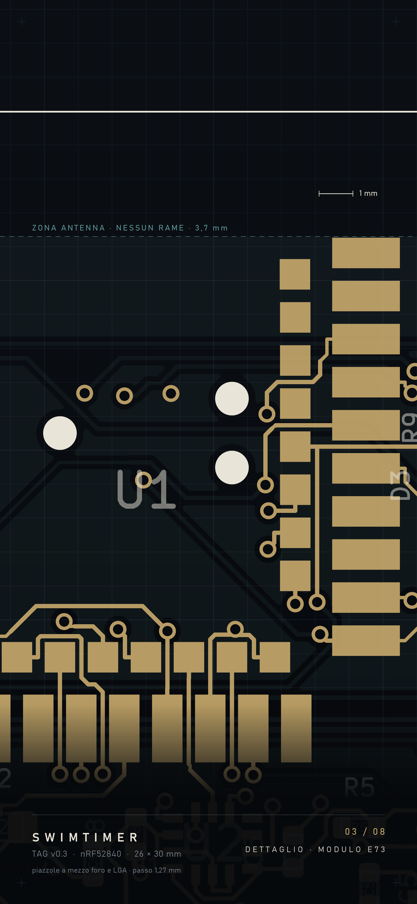
hardware/nrf52840/wallpaper/png/03_macro_modulo.png
