PZero/SwimTimer/hardware/nrf52840/wallpaper/png/04_lato_sotto.png

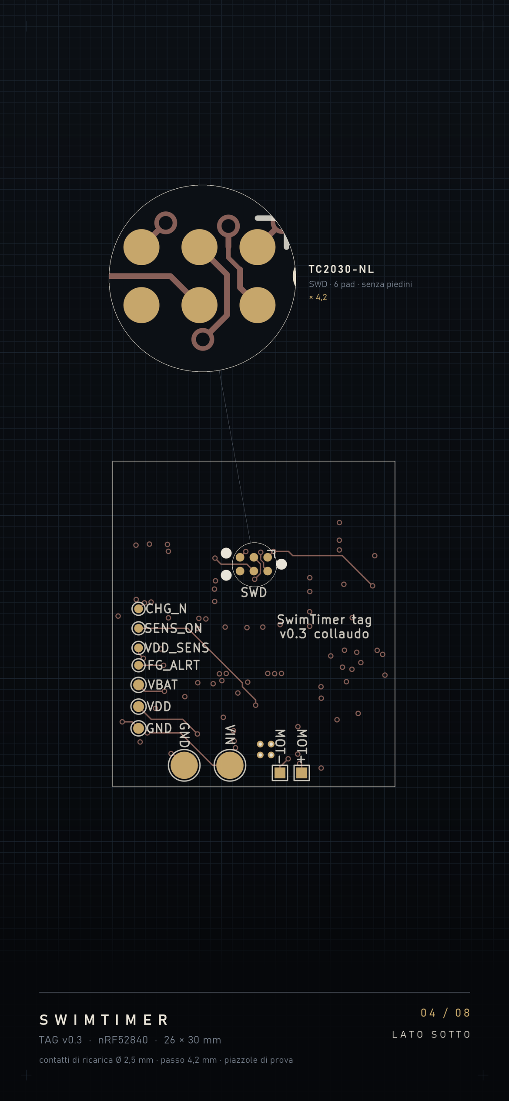
hardware/nrf52840/wallpaper/png/04_lato_sotto.png
