PZero/SwimTimer/hardware/nrf52840/wallpaper/png/05_sezione.png

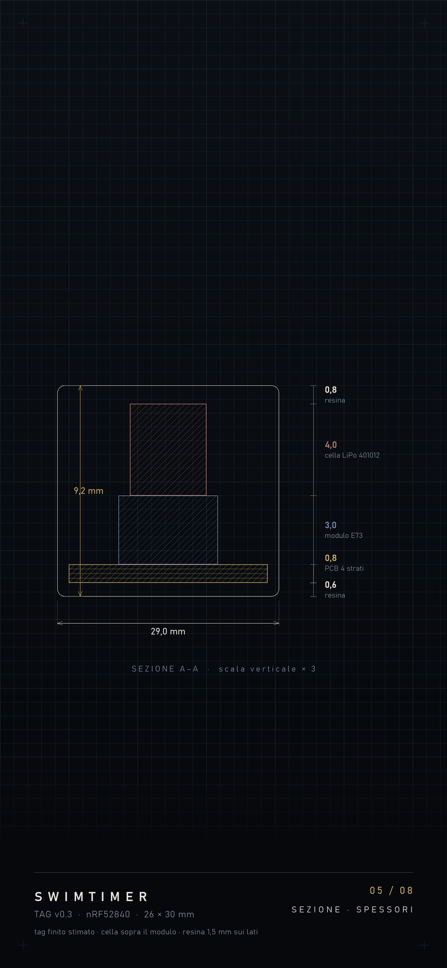
hardware/nrf52840/wallpaper/png/05_sezione.png
