PZero/SwimTimer/hardware/nrf52840/wallpaper/png/06_iso_sopra.png

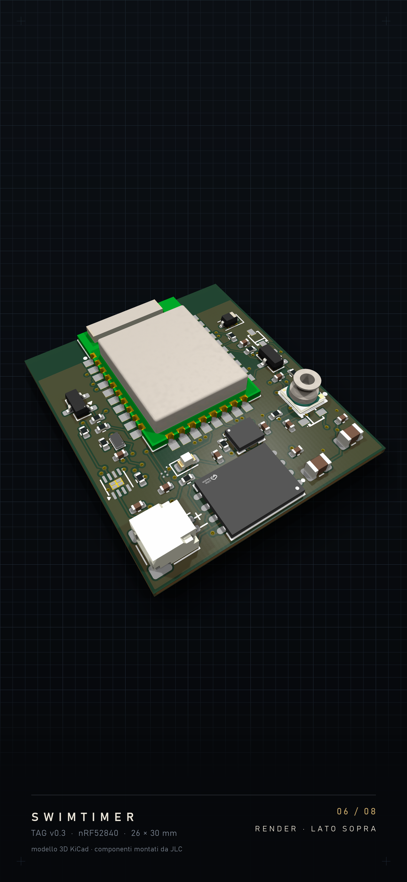
hardware/nrf52840/wallpaper/png/06_iso_sopra.png
