PZero/SwimTimer/hardware/nrf52840/wallpaper/png/07_iso_sotto.png

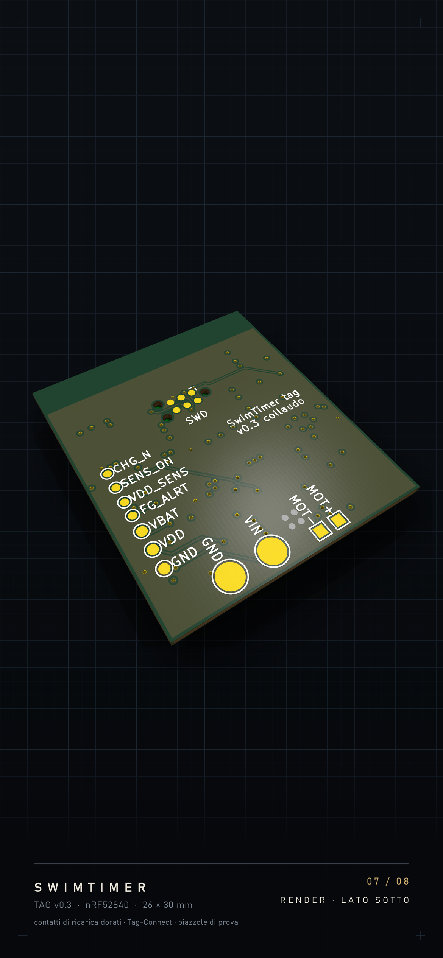
hardware/nrf52840/wallpaper/png/07_iso_sotto.png
