PZero/SwimTimer/hardware/nrf52840/wallpaper/png/08_foratura.png

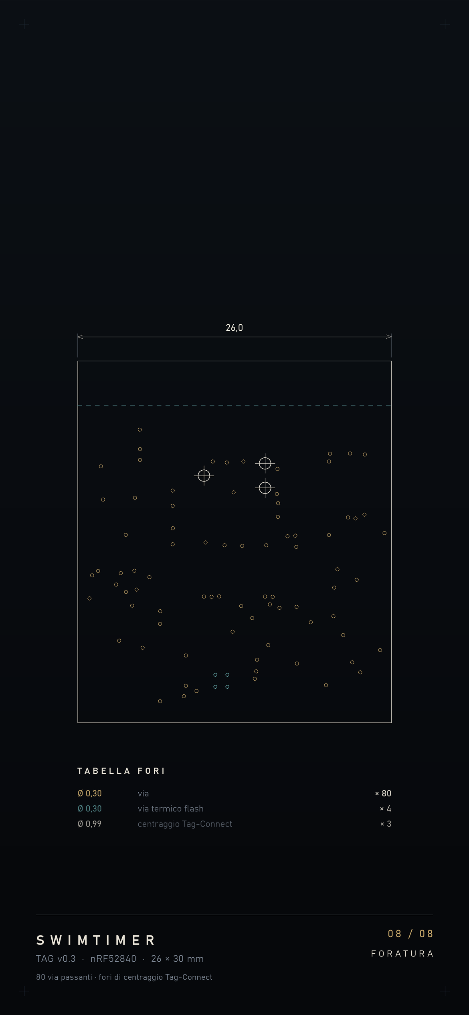
hardware/nrf52840/wallpaper/png/08_foratura.png
