PZero/SwimTimer/hardware/nrf52840/wallpaper/render/iso_sopra.png

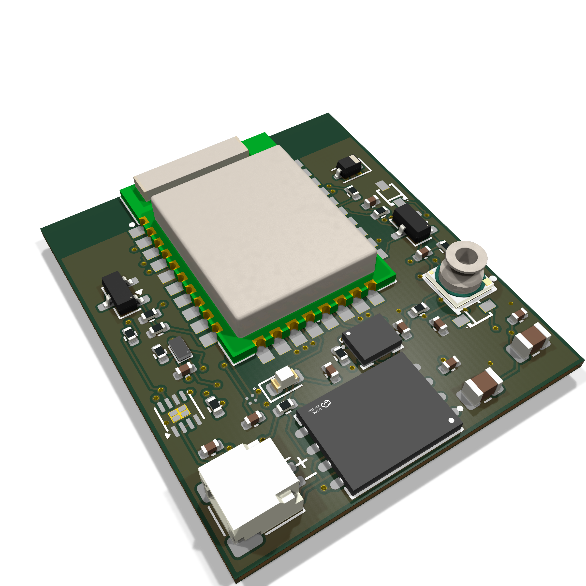
hardware/nrf52840/wallpaper/render/iso_sopra.png
