PZero/SwimTimer/hardware/nrf52840/wallpaper/render/iso_sotto.png

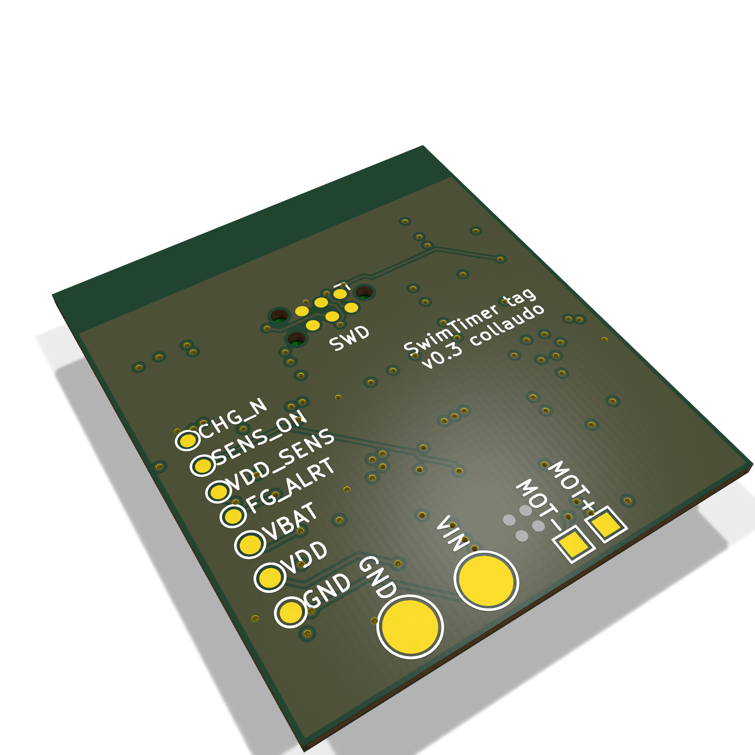
hardware/nrf52840/wallpaper/render/iso_sotto.png
