PZero/SwimTimer/hardware/programmatore/img/render_rame.png

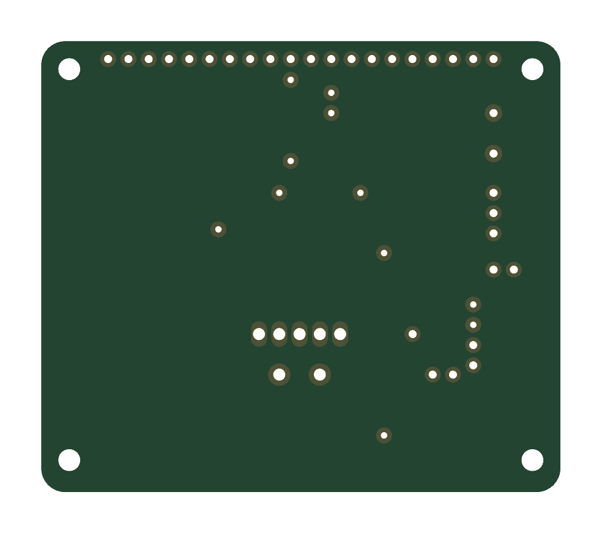
hardware/programmatore/img/render_rame.png
