PZero/SwimTimer/hardware/wallpaper_v0.5/anteprima.png

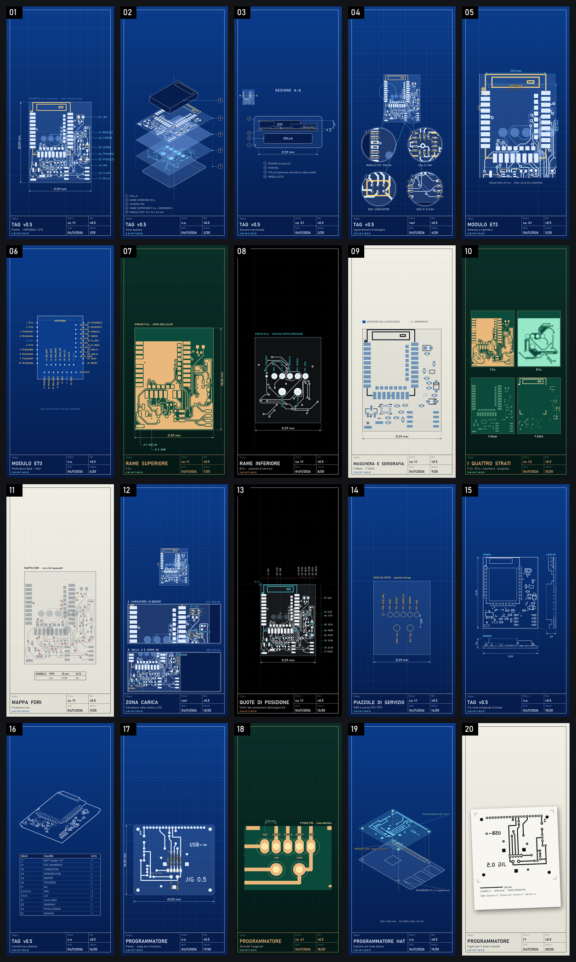
hardware/wallpaper_v0.5/anteprima.png
