PZero/SwimTimer/hardware/wallpaper_v0.5/png/04_tag_dettagli_1080x2400.png

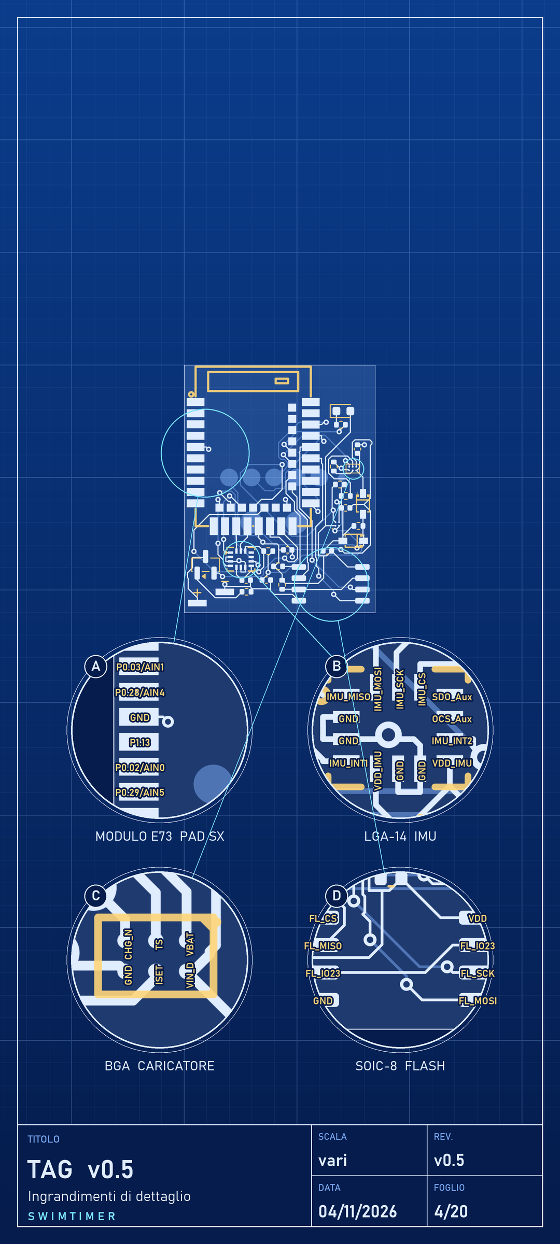
hardware/wallpaper_v0.5/png/04_tag_dettagli_1080x2400.png
