PZero/SwimTimer/hardware/wallpaper_v0.5/render/tag_alto.png

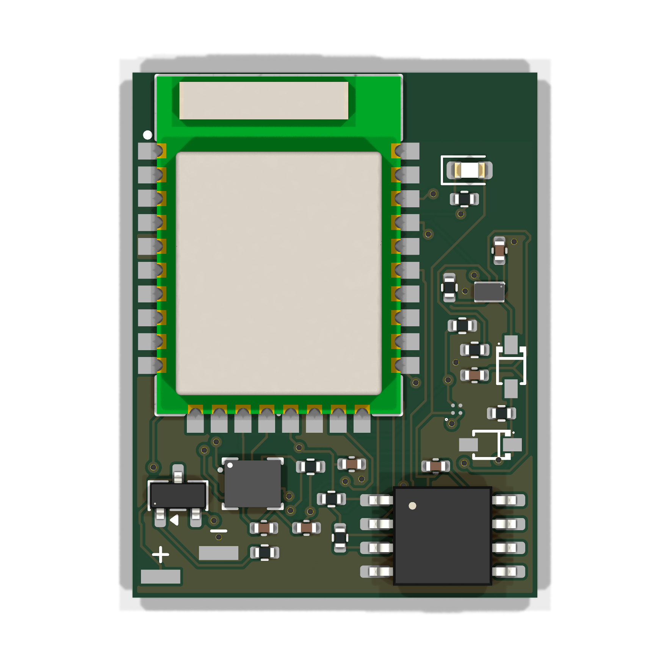
hardware/wallpaper_v0.5/render/tag_alto.png
