PZero/SwimTimer/hardware/wallpaper_v0.5/render/tag_fronte.png

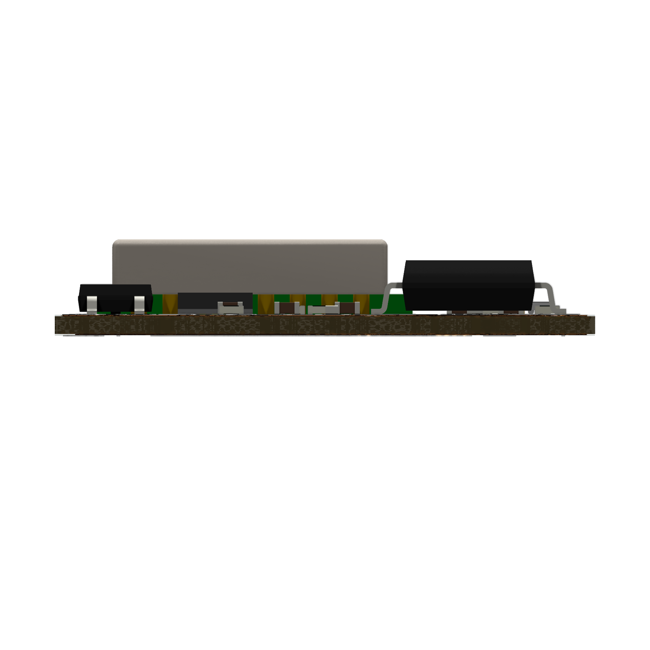
hardware/wallpaper_v0.5/render/tag_fronte.png
