PZero/SwimTimer/hardware/wallpaper_v0.5/render/tag_iso.png

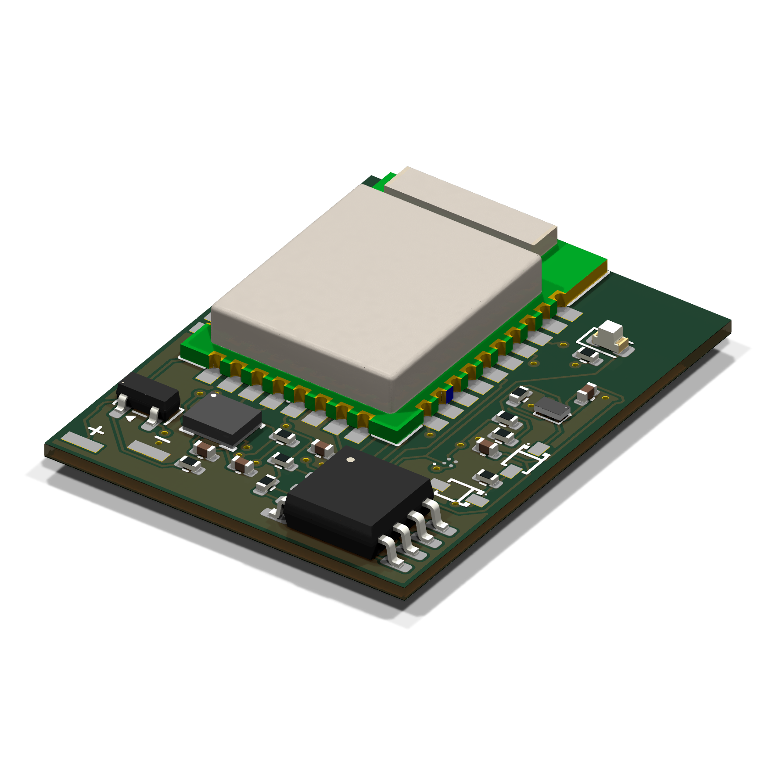
hardware/wallpaper_v0.5/render/tag_iso.png
