PZero/SwimTimer/hardware/wallpaper_v0.5/render/tag_lato.png

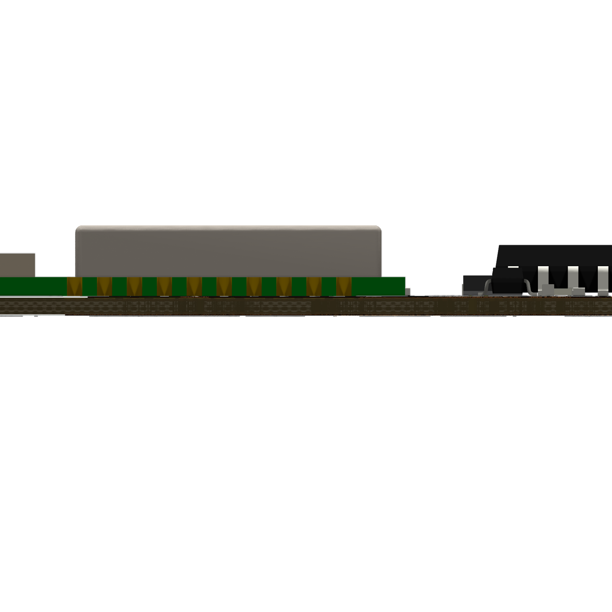
hardware/wallpaper_v0.5/render/tag_lato.png
