PZero/SwimTimer/media/display/display_demo_serie.png

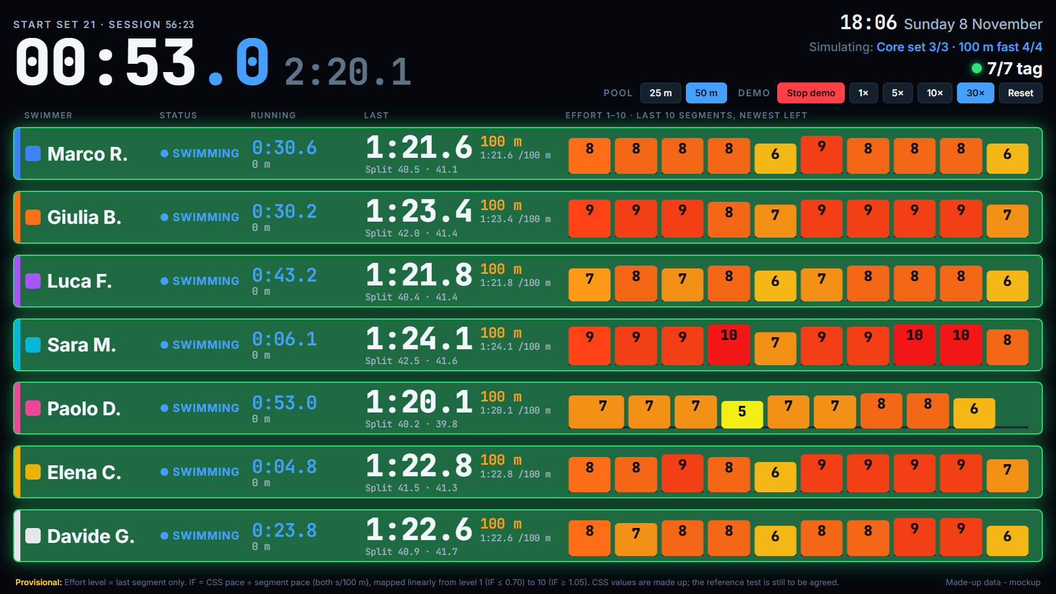
media/display/display_demo_serie.png
