PZero/SwimTimer/media/video/img_v2/area_en_admin_sessioni.png

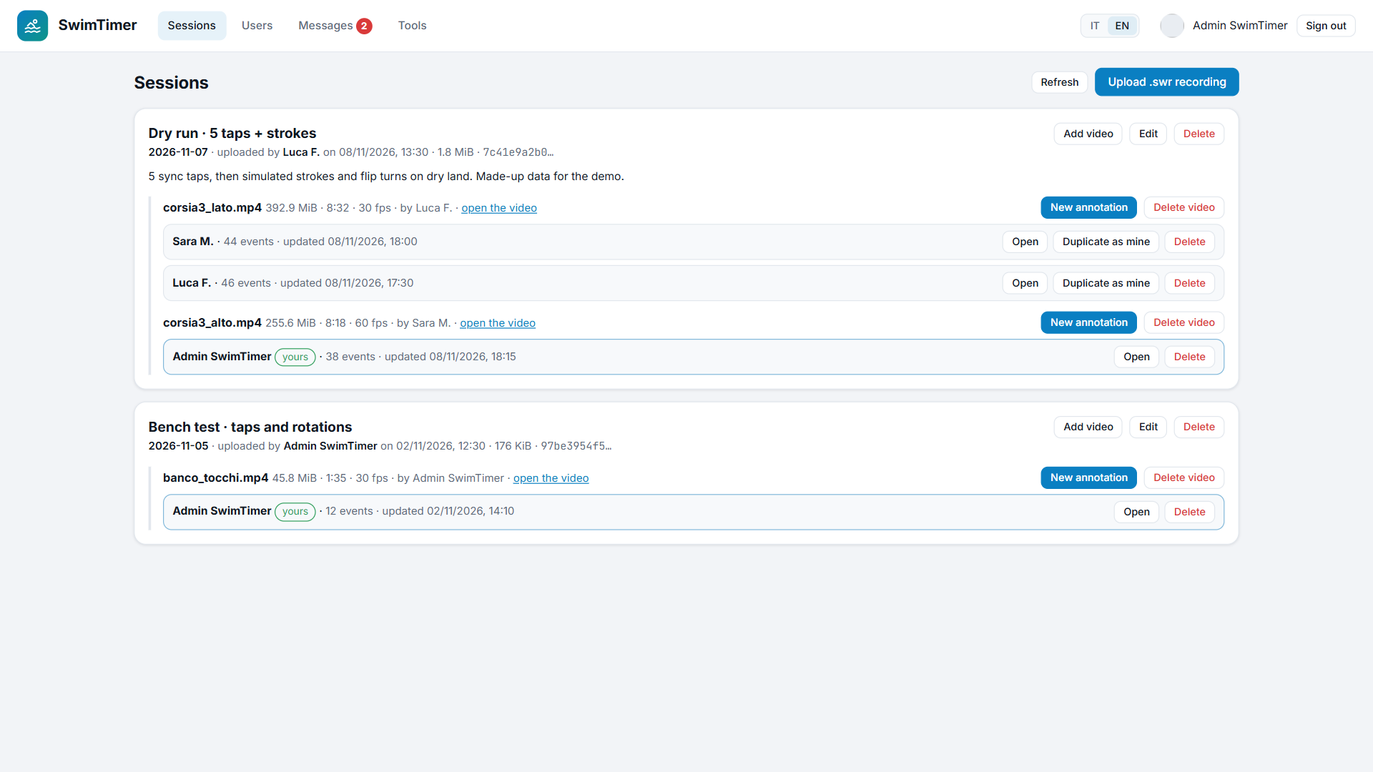
media/video/img_v2/area_en_admin_sessioni.png
