PZero/SwimTimer/media/video/img_v2/area_en_attesa.png

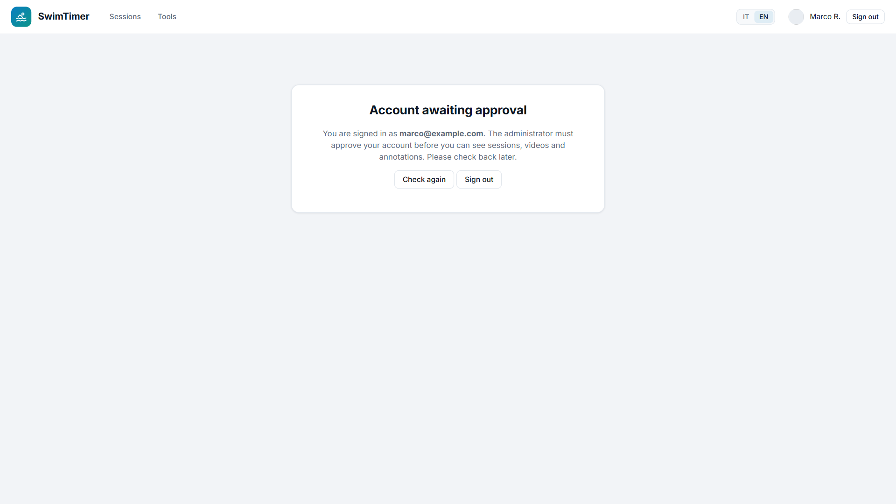
media/video/img_v2/area_en_attesa.png
