PZero/SwimTimer/media/video/img_v2/area_it_admin_admin.png

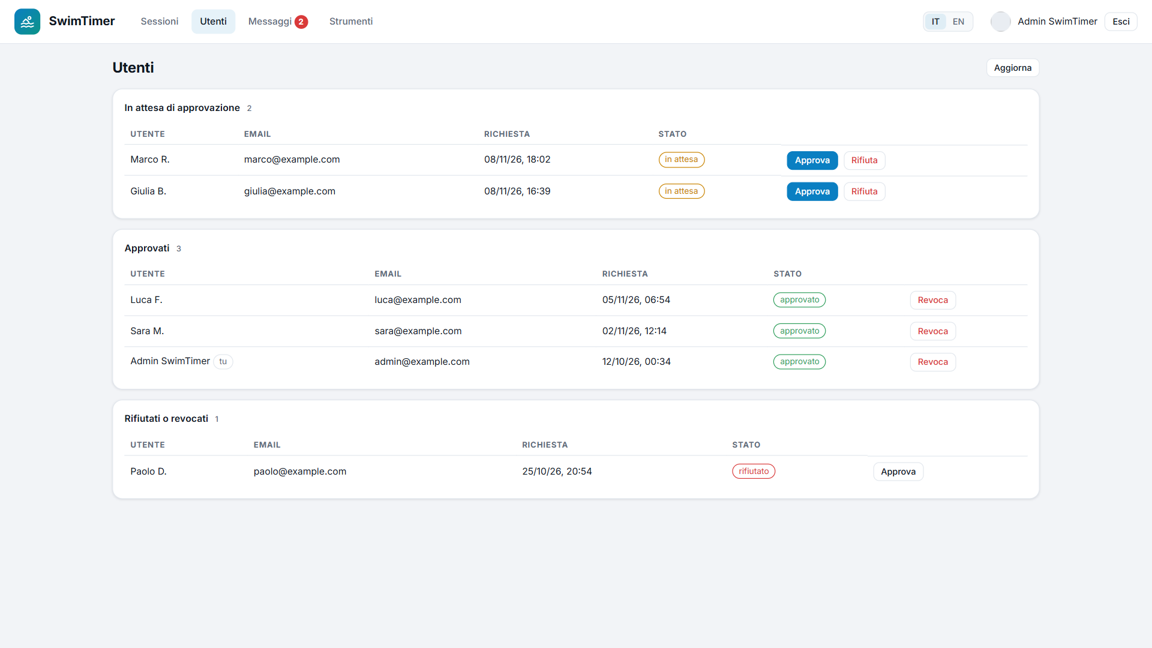
media/video/img_v2/area_it_admin_admin.png
