PZero/SwimTimer/media/video/img_v2/landing_en.png

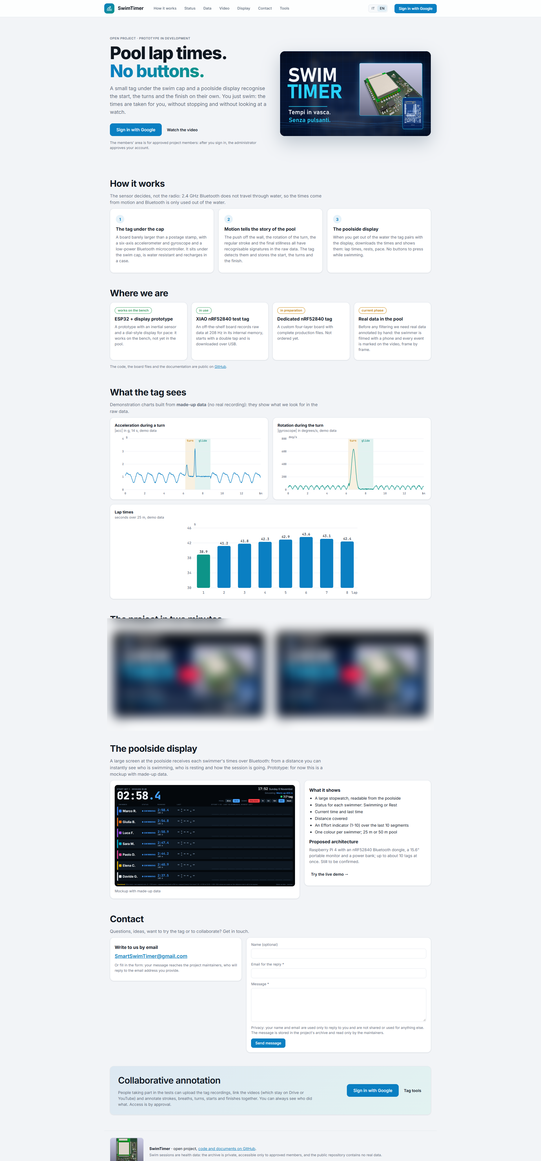
media/video/img_v2/landing_en.png
