PZero/SwimTimer/media/video/img_v2/strumenti_annotazione.png

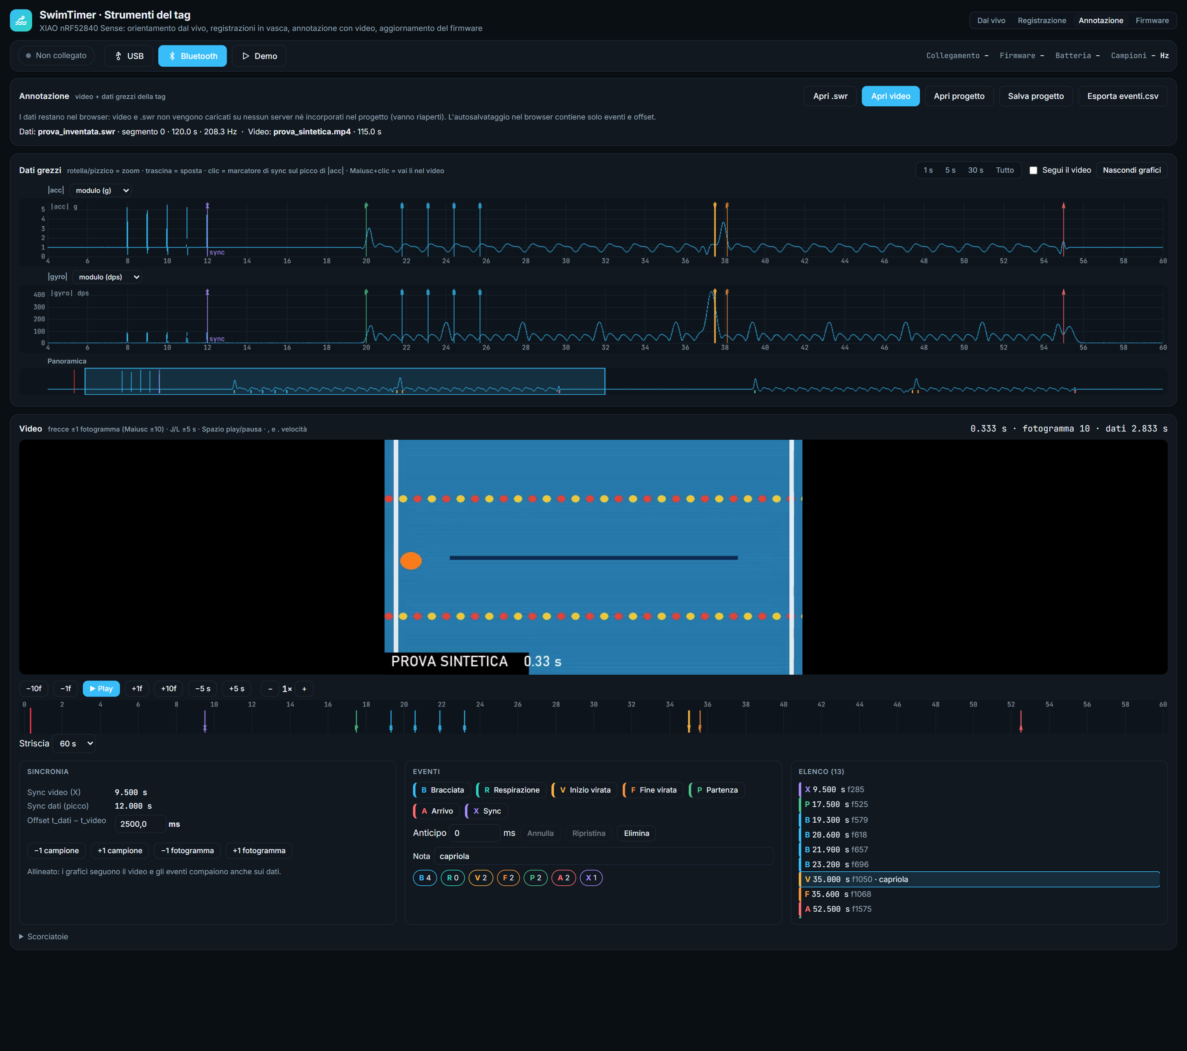
media/video/img_v2/strumenti_annotazione.png
