PZero/SwimTimer/media/video/img_v2/strumenti_annotazione_virata.png

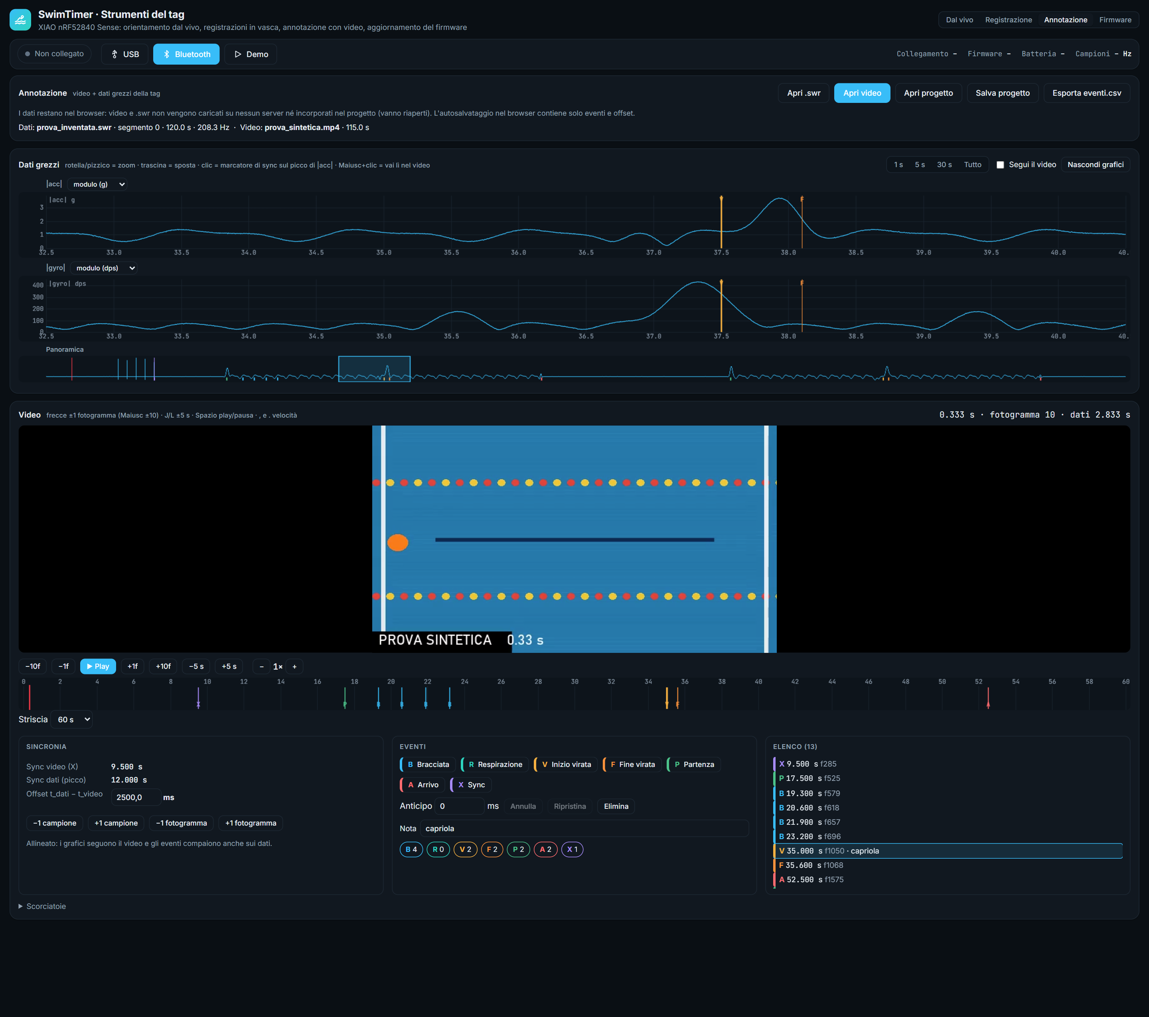
media/video/img_v2/strumenti_annotazione_virata.png
