PZero/SwimTimer/media/video/img_v2/strumenti_dal_vivo.png

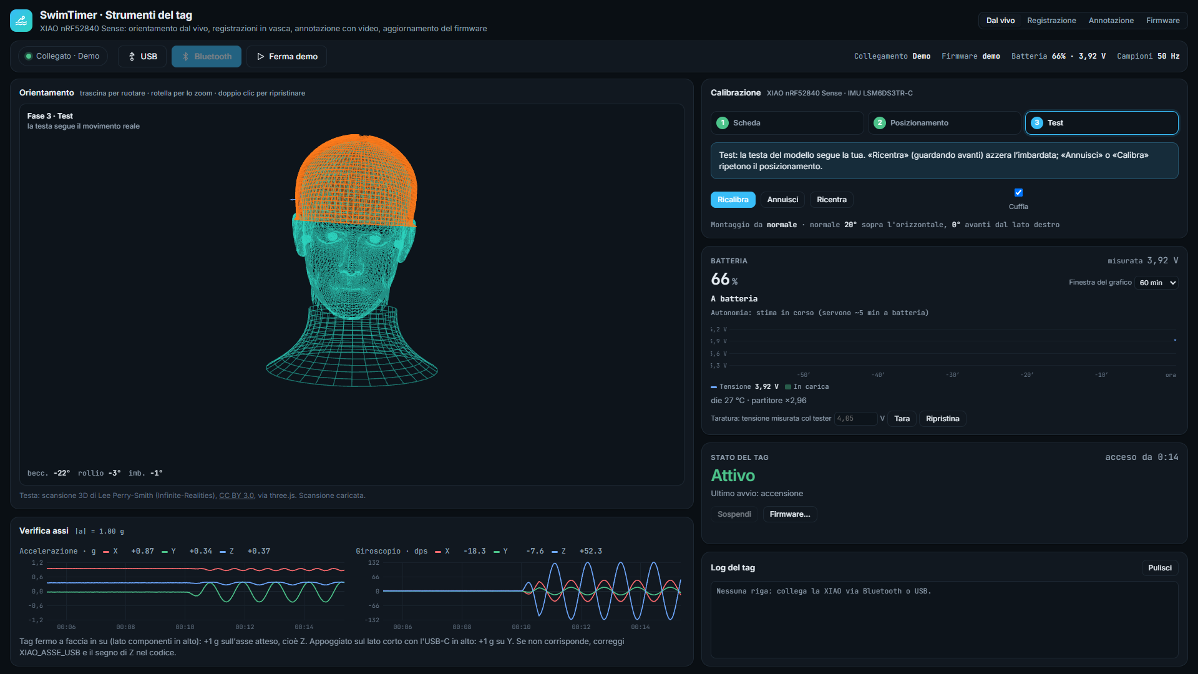
media/video/img_v2/strumenti_dal_vivo.png
