PZero/SwimTimer/media/video/img_v2/strumenti_firmware.png

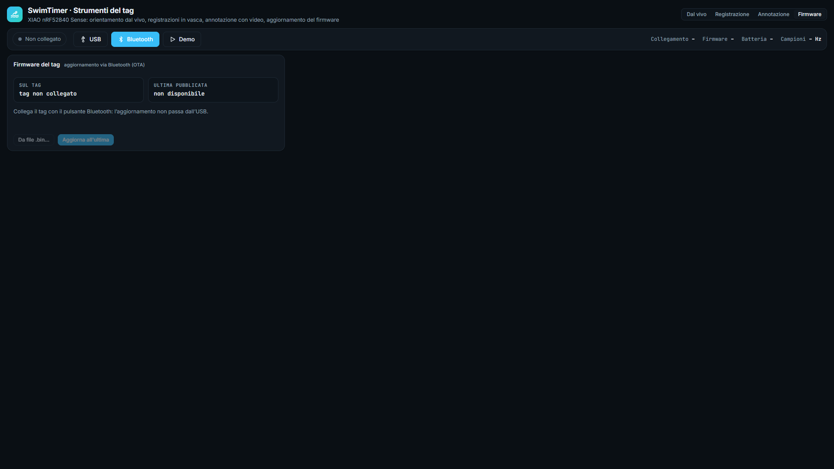
media/video/img_v2/strumenti_firmware.png
