PZero/SwimTimer/hardware/nrf52840/kicad/jlc/v0.6_swimtag_v06/bom_jlc.csv

Comment | Designator | Footprint | LCSC Part # | Quantity
10u | C1 | Capacitor_SMD:C_0402_1005Metric | C15525 | 1
100n | C2,C3,C4 | Capacitor_SMD:C_0402_1005Metric | C1525 | 3
4u7 | C5,C6 | Capacitor_SMD:C_0402_1005Metric | C23733 | 2
rosso 0603 | D1 | LED_SMD:LED_0603_1608Metric | C2286 | 1
1N5819WS | D2 | swimtag:SOD-323_L1.8-W1.3-LS2.5-RD | C191023 | 1
PTVSLC3D5VB | D3 | swimtag:SOD-323_L1.8-W1.3-LS2.5-RD | C41408025 | 1
1N4148WS | D4 | swimtag:SOD-323_L1.8-W1.3-LS2.5-RD | C2128 | 1
AO3401A | Q1 | Package_TO_SOT_SMD:SOT-23 | C15127 | 1
66k5 | R1 | Resistor_SMD:R_0402_1005Metric | C172114 | 1
100k | R2,R5,R6,R8,R9 | Resistor_SMD:R_0402_1005Metric | C25741 | 5
1k | R3 | Resistor_SMD:R_0402_1005Metric | C11702 | 1
10k | R4 | Resistor_SMD:R_0402_1005Metric | C25744 | 1
1M | R7 | Resistor_SMD:R_0402_1005Metric | C26083 | 1
E73-2G4M08S1C | U1 | swimtag:WIRELM-SMD_E73-2G4M08S1C | C356849 | 1
LSM6DSV16X | U2 | swimtag:LGA-14_L3.0-W2.5-P0.50-BR | C5267406 | 1
W25Q128JVSIQ | U3 | Package_SO:SOIC-8_5.3x5.3mm_P1.27mm | C97521 | 1
MCP73831T-2ACI/OT | U4 | Package_TO_SOT_SMD:SOT-23-5 | C424093 | 1
TPS22917DBVR | U6 | Package_TO_SOT_SMD:SOT-23-6 | C2681320 | 1
