PZero/SwimTimer/hardware/nrf52840/kicad/nextpcb/v0.5_pannello_2x1/bom_nextpcb.csv

Designator | Quantity | Value | Description | Manufacturer | MPN | Footprint | LCSC Part #
C1_1,C1_2 | 2 | 10u | 10uF 6.3V X5R 0402 | Samsung | CL05A106MQ5NUNC | C_0402_1005Metric | C15525
C2_1,C3_1,C4_1,C2_2,C3_2,C4_2 | 6 | 100n | 100nF 16V X7R 0402 | Samsung | CL05B104KO5NNNC | C_0402_1005Metric | C1525
C5_1,C6_1,C5_2,C6_2 | 4 | 4u7 | 4.7uF 10V X5R 0402 | Samsung | CL05A475MP5NRNC | C_0402_1005Metric | C23733
D1_1,D1_2 | 2 | red 0603 | Red LED 0603 | Hubei KENTO | KT-0603R | LED_0603_1608Metric | C2286
D2_1,D2_2 | 2 | 1N5819WS | Schottky 40V 1A SOD-323 |  | 1N5819WS | SOD-323_L1.8-W1.3-LS2.5-RD | C191023
D3_1,D3_2 | 2 | PTVSLC3D5VB | Bidirectional TVS 5V SOD-323 |  | PTVSLC3D5VB | SOD-323_L1.8-W1.3-LS2.5-RD | C41408025
Q1_1,Q1_2 | 2 | AO3401A | P-MOSFET SOT-23 | Alpha & Omega | AO3401A | SOT-23 | C15127
R1_1,R2_1,R4_1,R1_2,R2_2,R4_2 | 6 | 10k | 10k 1% 0402 | UNI-ROYAL | 0402WGF1002TCE | R_0402_1005Metric | C25744
R3_1,R3_2 | 2 | 1k | 1k 1% 0402 | UNI-ROYAL | 0402WGF1001TCE | R_0402_1005Metric | C11702
R5_1,R6_1,R8_1,R9_1,R5_2,R6_2,R8_2,R9_2 | 8 | 100k | 100k 1% 0402 | UNI-ROYAL | 0402WGF1003TCE | R_0402_1005Metric | C25741
R7_1,R7_2 | 2 | 1M | 1M 1% 0402 | UNI-ROYAL | 0402WGF1004TCE | R_0402_1005Metric | C26083
U1_1,U1_2 | 2 | E73-2G4M08S1C | nRF52840 BLE module | Ebyte | E73-2G4M08S1C | WIRELM-SMD_E73-2G4M08S1C | C356849
U2_1,U2_2 | 2 | LSM6DSV16X | IMU LGA-14 | STMicroelectronics | LSM6DSV16XTR | LGA-14_L3.0-W2.5-P0.50-BR | C5267406
U3_1,U3_2 | 2 | W25Q128JVSIQ | flash 128 Mbit SOIC-8 208 mil | Winbond | W25Q128JVSIQ | SOIC-8_5.3x5.3mm_P1.27mm | C97521
U4_1,U4_2 | 2 | BQ25101 | Li-ion charger DSBGA-6 | Texas Instruments | BQ25101YFPR | DSBGA-6_L0.9-W1.6-R2-C3-P0.40-BL | C478468
U6_1,U6_2 | 2 | TPS22916C | load switch DSBGA-4 | Texas Instruments | TPS22916CYFPR | DSBGA-4_L0.78-W0.78-P0.40 | C2680319
