PZero/SwimTimer/hardware/display-involucro/stl/vaso.stl

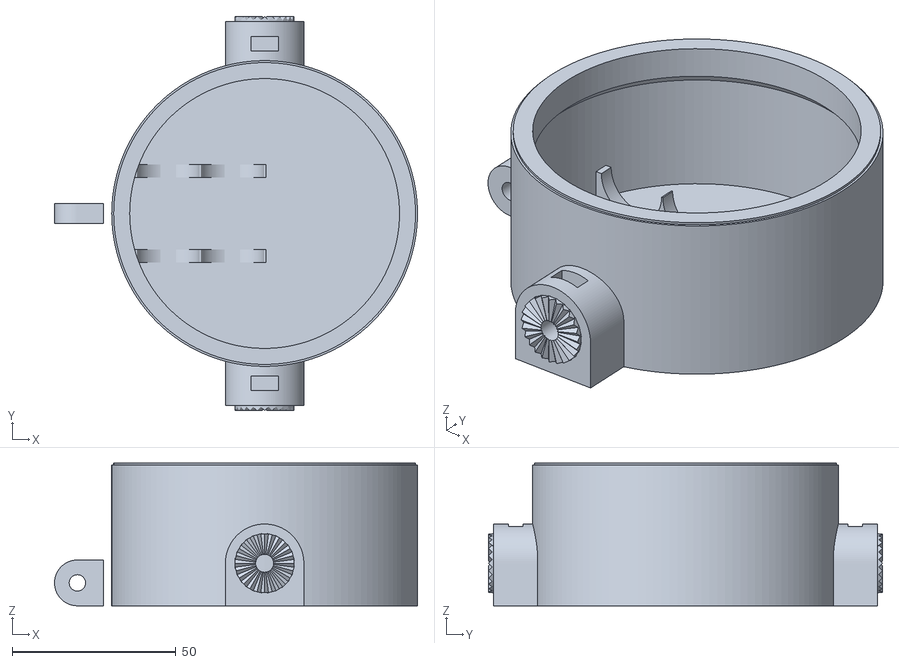
[picture p89: CAD file, 2026-11-12]
hardware/display-involucro/stl/vaso.stl
111.0 x 120.5 x 43.6
