PZero/SwimTimer/hardware/display-involucro/stl/forcella.stl

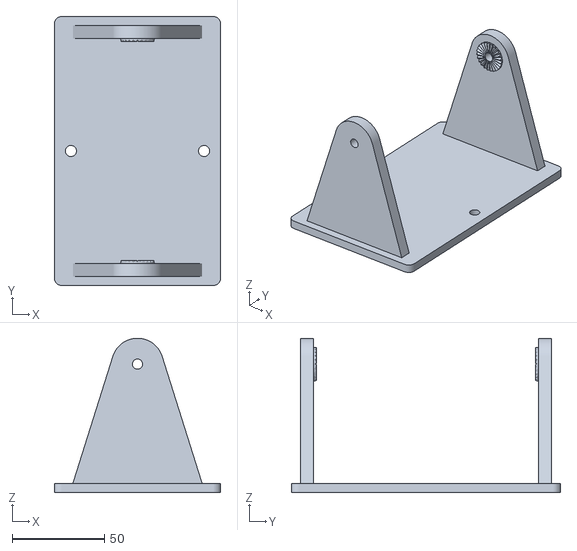
[picture p90: CAD file, 2026-11-12]
hardware/display-involucro/stl/forcella.stl
90.0 x 145.5 x 83.6
