PZero/SwimTimer/hardware/display-involucro/stl/pomello.stl

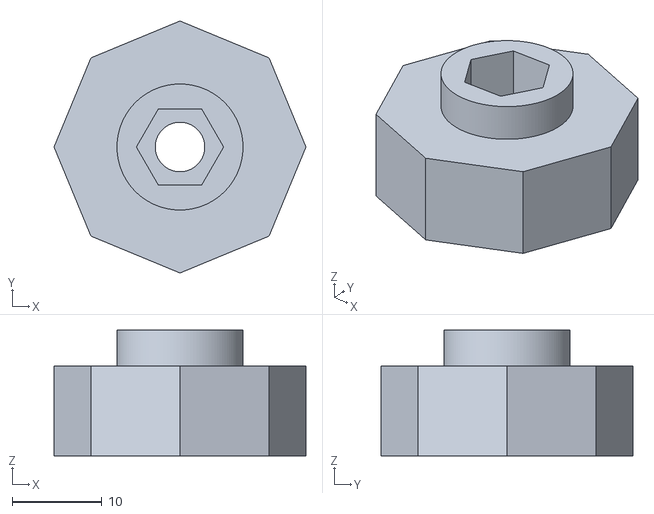
[picture p91: CAD file, 2026-11-12]
hardware/display-involucro/stl/pomello.stl
28.0 x 28.0 x 14.0
