PZero/SwimTimer/hardware/nrf52840/kicad/nextpcb/v0.5_pannello_3x1/assembly_top_render.png

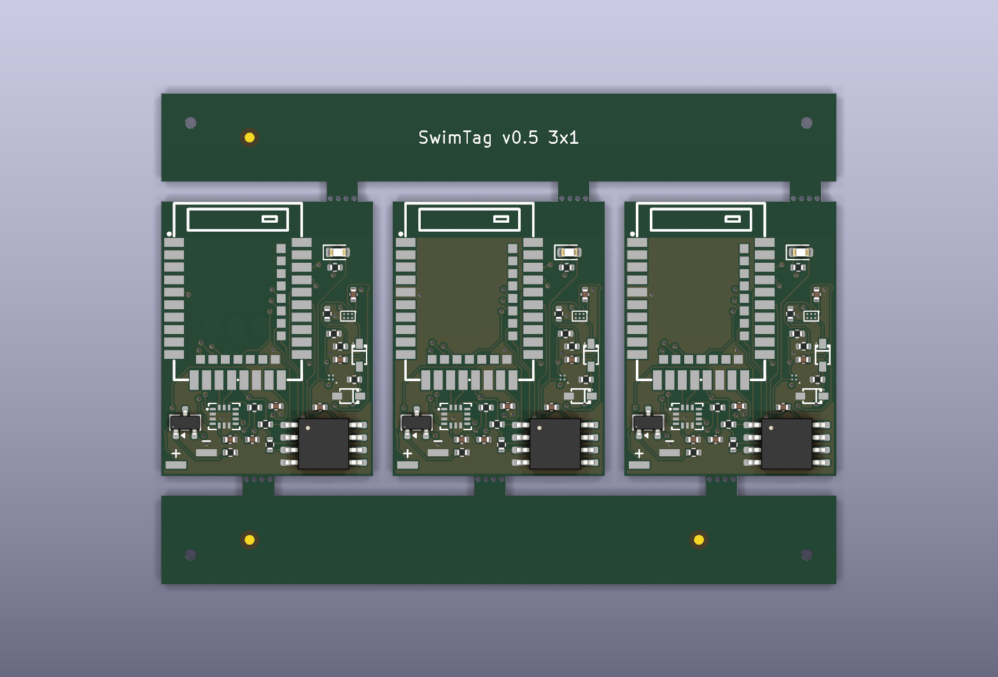
hardware/nrf52840/kicad/nextpcb/v0.5_pannello_3x1/assembly_top_render.png
