PZero/SwimTimer/hardware/nrf52840/kicad/nextpcb/v0.6/assembly_pin1.png

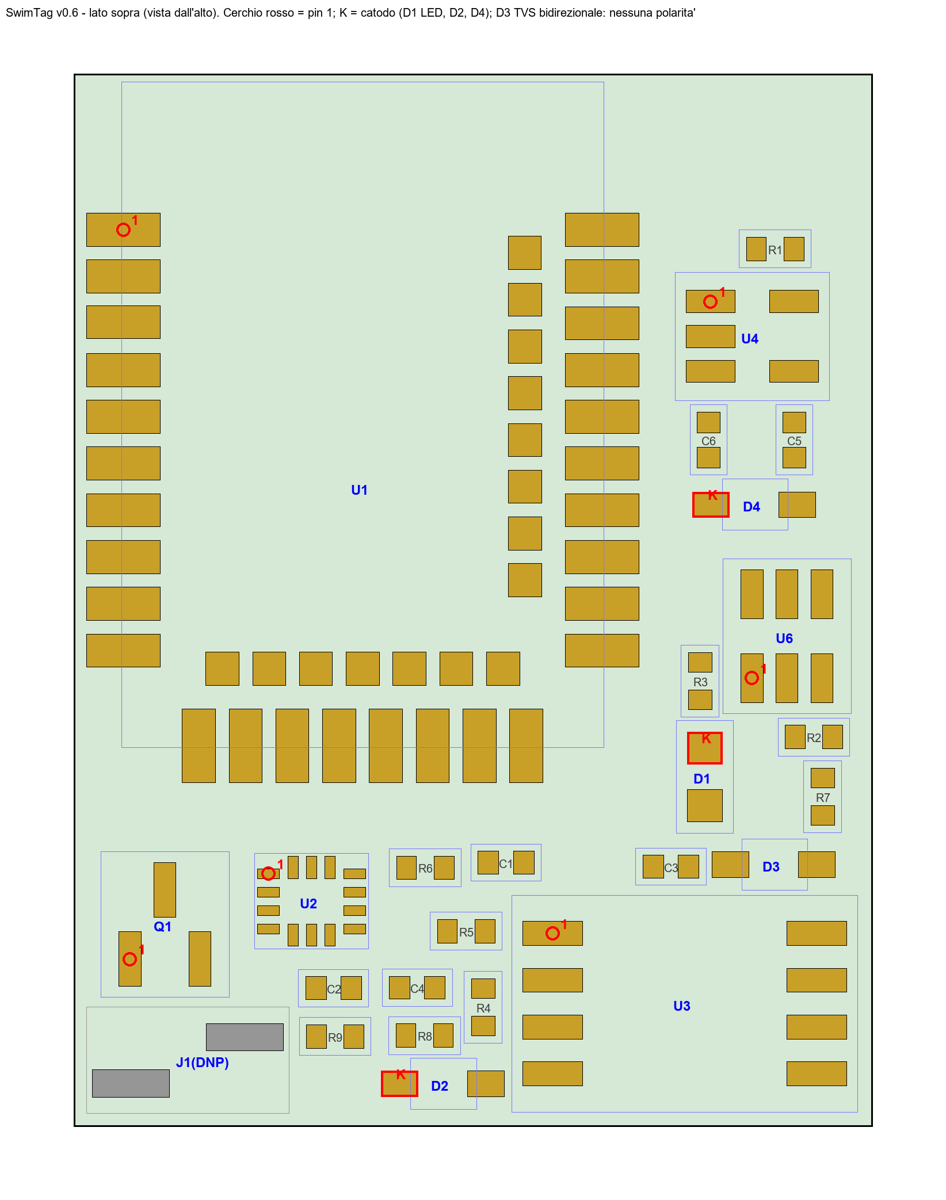
hardware/nrf52840/kicad/nextpcb/v0.6/assembly_pin1.png
