PZero/SwimTimer/hardware/nrf52840/kicad/nextpcb/v0.6/assembly_top_render.png

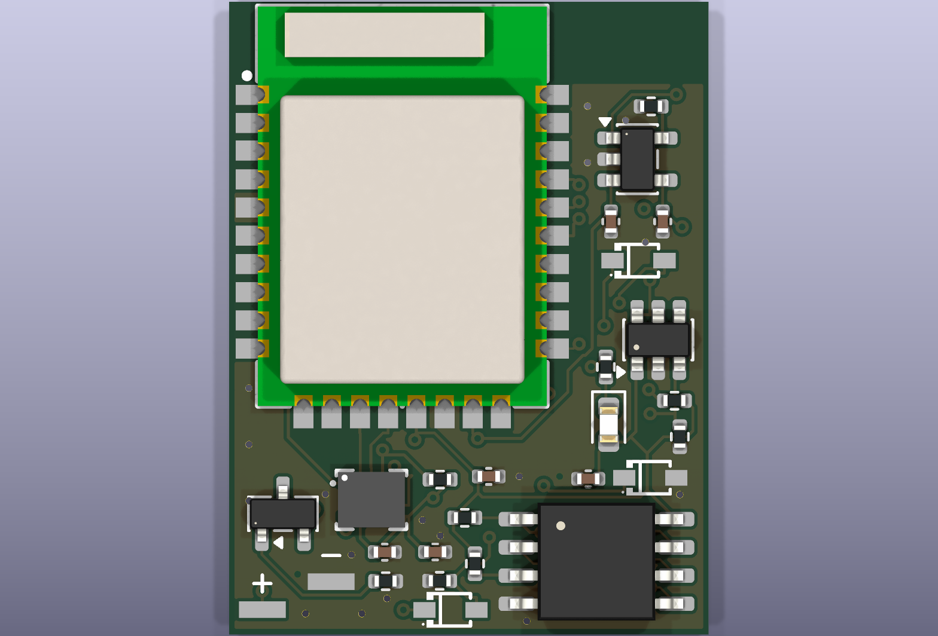
hardware/nrf52840/kicad/nextpcb/v0.6/assembly_top_render.png
