PZero/SwimTimer/hardware/nrf52840/kicad/jlc/schema.pdf

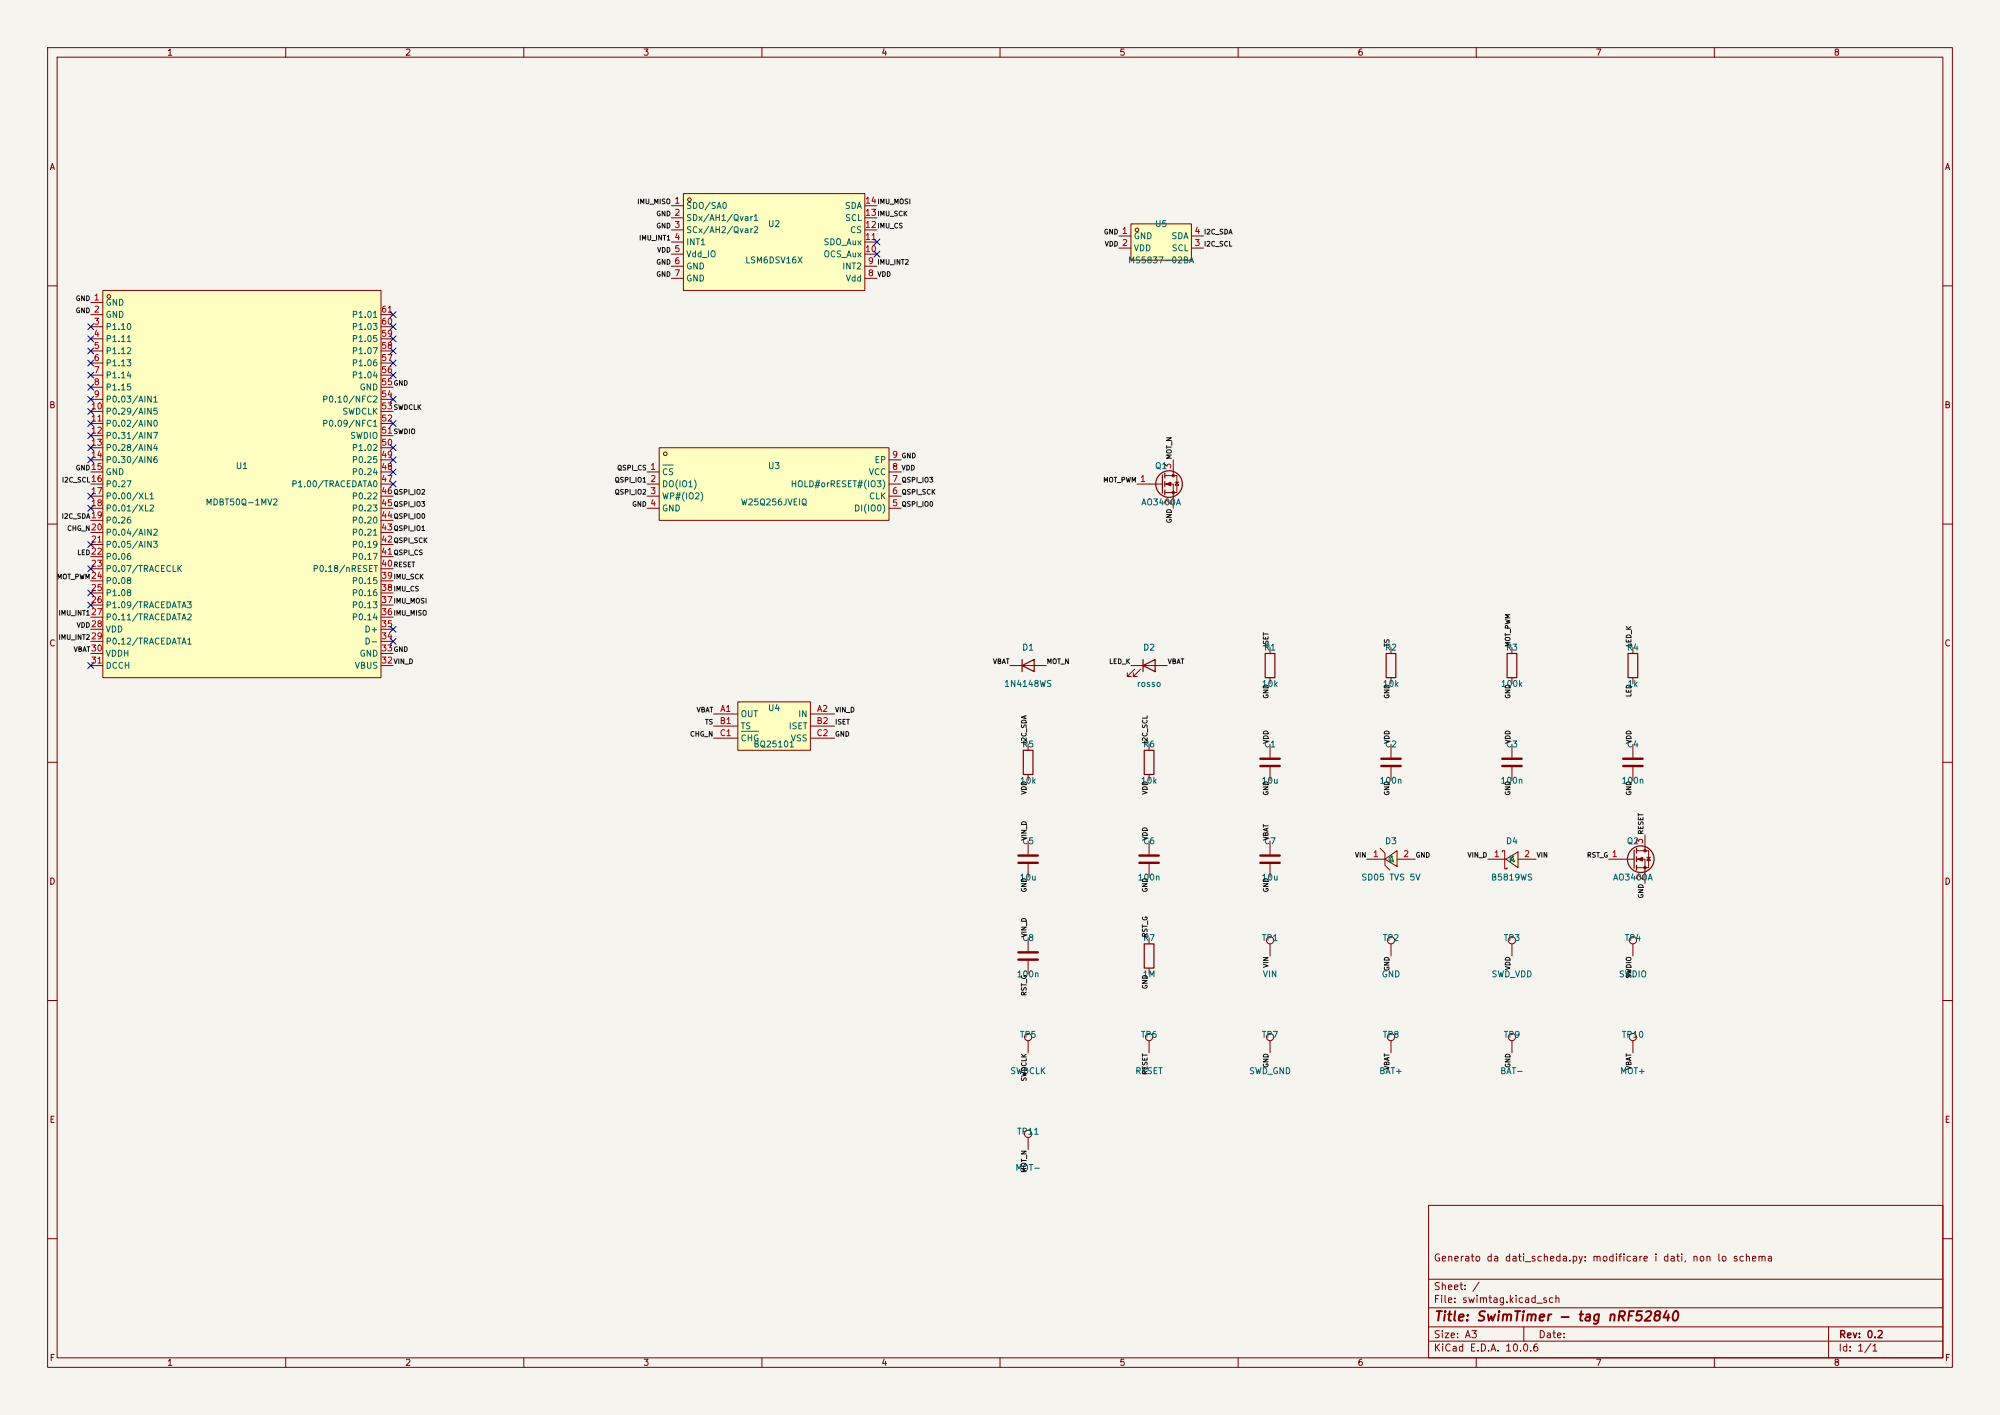
[picture p96: page 1]

Generato da dati_scheda.py: modificare i dati, non lo schema

Size: A3 | Rev: 0.2 | F Date:
KiCad E.D.A. 10.0.6 | Id: 1/1
