PZero/SwimTimer/hardware/nrf52840/kicad/swimtag_v06.kicad_pcb

## KiCad design hardware/nrf52840/kicad/swimtag_v06.kicad_pcb (2026-11-06)

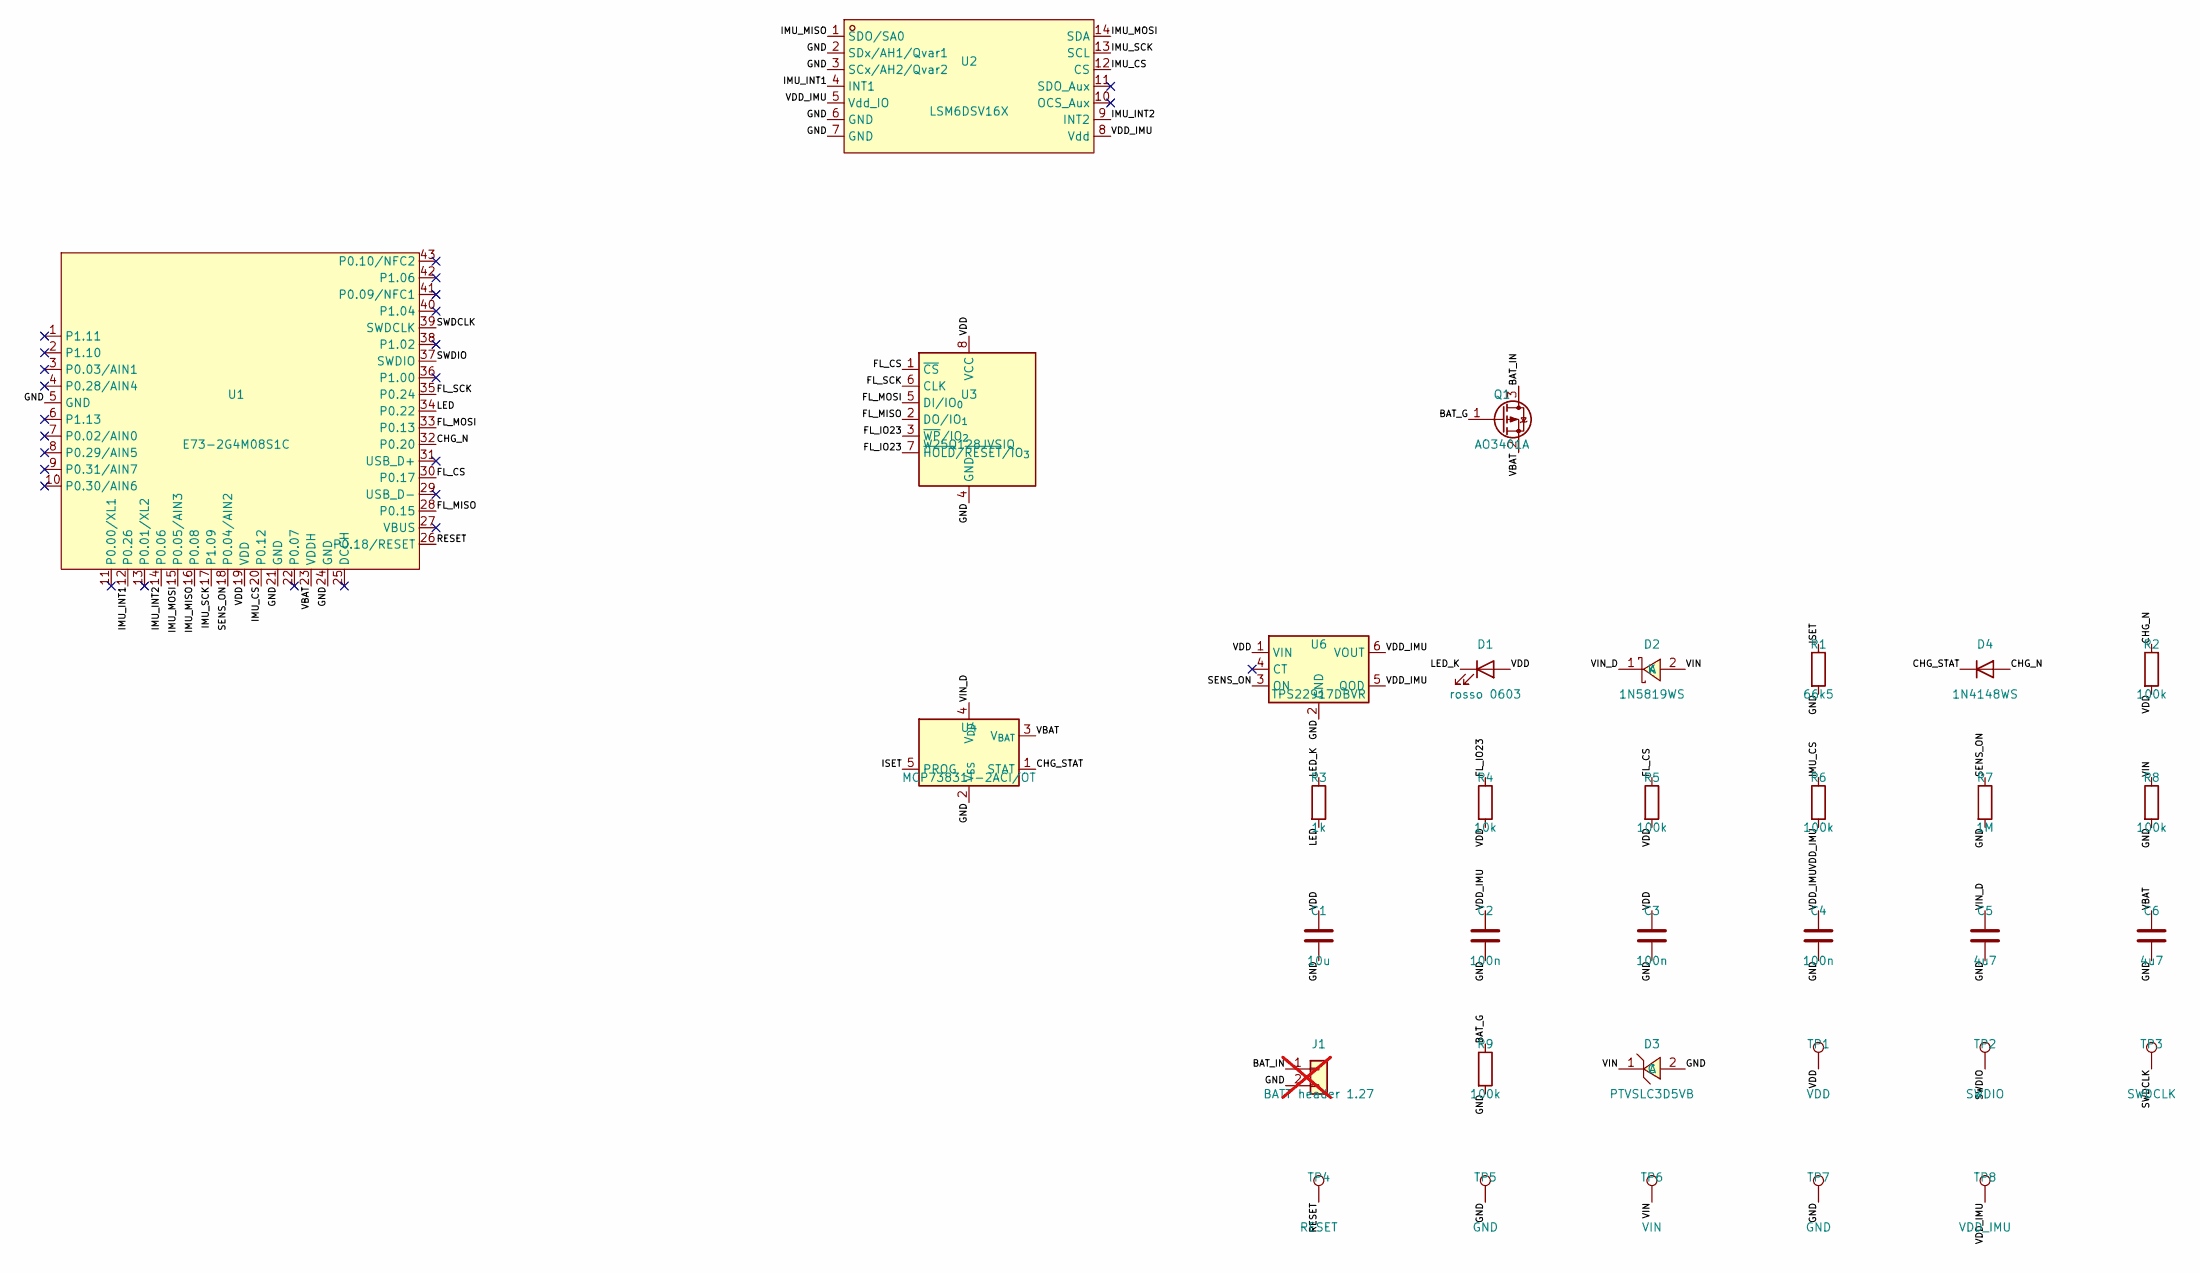
[picture p97: schematic swimtag_v06.kicad_sch, SwimTimer - tag nRF52840]

Parts:
C1: 10u; C_0402_1005Metric; LCSC C15525
C2, C3, C4: 100n; C_0402_1005Metric; LCSC C1525
C5, C6: 4u7; C_0402_1005Metric; LCSC C23733
D1: rosso 0603; LED_0603_1608Metric; LCSC C2286
D2: 1N5819WS; SOD-323_L1.8-W1.3-LS2.5-RD; LCSC C191023
D3: PTVSLC3D5VB; SOD-323_L1.8-W1.3-LS2.5-RD; LCSC C41408025
D4: 1N4148WS; SOD-323_L1.8-W1.3-LS2.5-RD; LCSC C2128
J1: BATT header 1.27; HDR-SMD_2P-P1.27-V-M-LS4.2-R1; LCSC C55213900; not fitted
Q1: AO3401A; SOT-23; LCSC C15127
R1: 66k5; R_0402_1005Metric; LCSC C172114
R2, R5, R6, R8, R9: 100k; R_0402_1005Metric; LCSC C25741
R3: 1k; R_0402_1005Metric; LCSC C11702
R4: 10k; R_0402_1005Metric; LCSC C25744
R7: 1M; R_0402_1005Metric; LCSC C26083
TP1: VDD; TestPoint_Pad_D2.0mm_NoCY
TP2: SWDIO; TestPoint_Pad_D2.0mm_NoCY
TP3: SWDCLK; TestPoint_Pad_D2.0mm_NoCY
TP4: RESET; TestPoint_Pad_D2.0mm_NoCY
TP5: GND; TestPoint_Pad_D2.0mm_NoCY
TP6: VIN; TestPoint_Pad_D2.5mm
TP7: GND; TestPoint_Pad_D2.5mm
TP8: VDD_IMU; TestPoint_Pad_D0.8mm
U1: E73-2G4M08S1C; WIRELM-SMD_E73-2G4M08S1C; LCSC C356849
U2: LSM6DSV16X; LGA-14_L3.0-W2.5-P0.50-BR; LCSC C5267406
U3: W25Q128JVSIQ; SOIC-8_5.3x5.3mm_P1.27mm; LCSC C97521
U4: MCP73831T-2ACI/OT; SOT-23-5; LCSC C424093
U6: TPS22917DBVR; SOT-23-6; LCSC C2681320

Connections:
/BAT_G: Q1.1 (G), R9.1
/BAT_IN: J1.1, Q1.3 (D)
/CHG_N: D4.2 (A), R2.1, U1.32 (P0.20)
/CHG_STAT: D4.1 (K), U4.1 (STAT)
/FL_CS: R5.1, U1.30 (P0.17), U3.1 (~CS)
/FL_IO23: R4.1, U3.3 (~WP/IO_{2}), U3.7 (~HOLD/~RESET/IO_{3})
/FL_MISO: U1.28 (P0.15), U3.2 (DO/IO_{1})
/FL_MOSI: U1.33 (P0.13), U3.5 (DI/IO_{0})
/FL_SCK: U1.35 (P0.24), U3.6 (CLK)
/GND: C1.2, C2.2, C3.2, C4.2, C5.2, C6.2, D3.2 (A), J1.2, R1.2, R7.2, R8.2, R9.2, TP5.1, TP7.1, U1.5 (GND), U1.21 (GND), U1.24 (GND), U2.2 (SDx/AH1/Qvar1), U2.3 (SCx/AH2/Qvar2), U2.6 (GND), U2.7 (GND), U3.4 (GND), U4.2 (V_{SS}), U6.2 (GND)
/IMU_CS: R6.1, U1.20 (P0.12), U2.12 (CS)
/IMU_INT1: U1.12 (P0.26), U2.4 (INT1)
/IMU_INT2: U1.14 (P0.06), U2.9 (INT2)
/IMU_MISO: U1.16 (P0.08), U2.1 (SDO/SA0)
/IMU_MOSI: U1.15 (P0.05/AIN3), U2.14 (SDA)
/IMU_SCK: U1.17 (P1.09), U2.13 (SCL)
/ISET: R1.1, U4.5 (PROG)
/LED: R3.2, U1.34 (P0.22)
/LED_K: D1.1 (K), R3.1
/RESET: TP4.1, U1.26 (P0.18/RESET)
/SENS_ON: R7.1, U1.18 (P0.04/AIN2), U6.3 (ON)
/SWDCLK: TP3.1, U1.39 (SWDCLK)
/SWDIO: TP2.1, U1.37 (SWDIO)
/VBAT: C6.1, Q1.2 (S), U1.23 (VDDH), U4.3 (V_{BAT})
/VDD: C1.1, C3.1, D1.2 (A), R2.2, R4.2, R5.2, TP1.1, U1.19 (VDD), U3.8 (VCC), U6.1 (VIN)
/VDD_IMU: C2.1, C4.1, R6.2, TP8.1, U2.5 (Vdd_IO), U2.8 (Vdd), U6.5 (QOD), U6.6 (VOUT)
/VIN: D2.2 (A), D3.1 (C), R8.1, TP6.1
/VIN_D: C5.1, D2.1 (K), U4.4 (V_{DD})

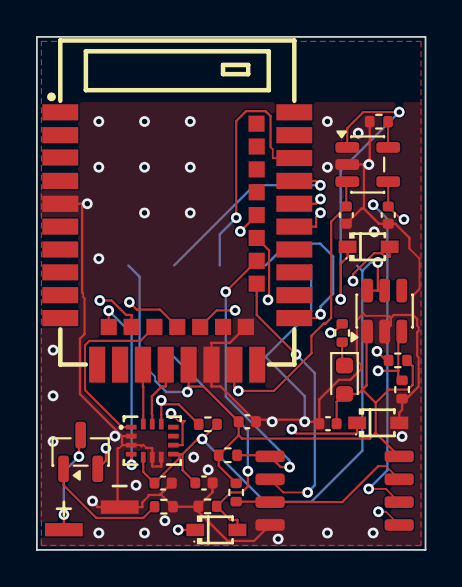
[picture p98: board swimtag_v06.kicad_pcb from above]

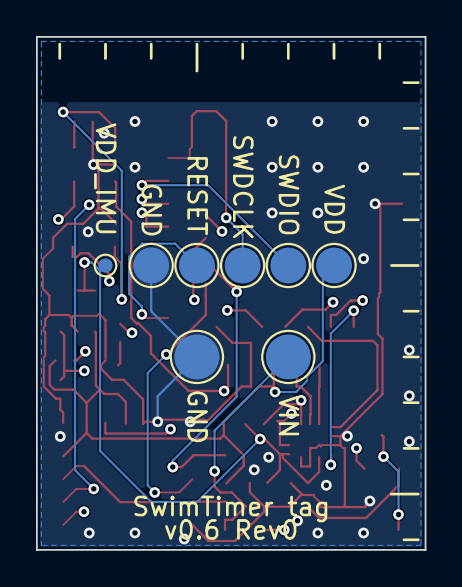
[picture p99: board swimtag_v06.kicad_pcb from below]

Board: 4 copper layers, 21.6 x 28.5 mm, 34 parts (8 on the bottom side), 28 nets.
