PZero/SwimTimer/hardware/programmatore/swimtag_programmatore.kicad_pcb

## KiCad design hardware/programmatore/swimtag_programmatore.kicad_pcb (2026-11-04)

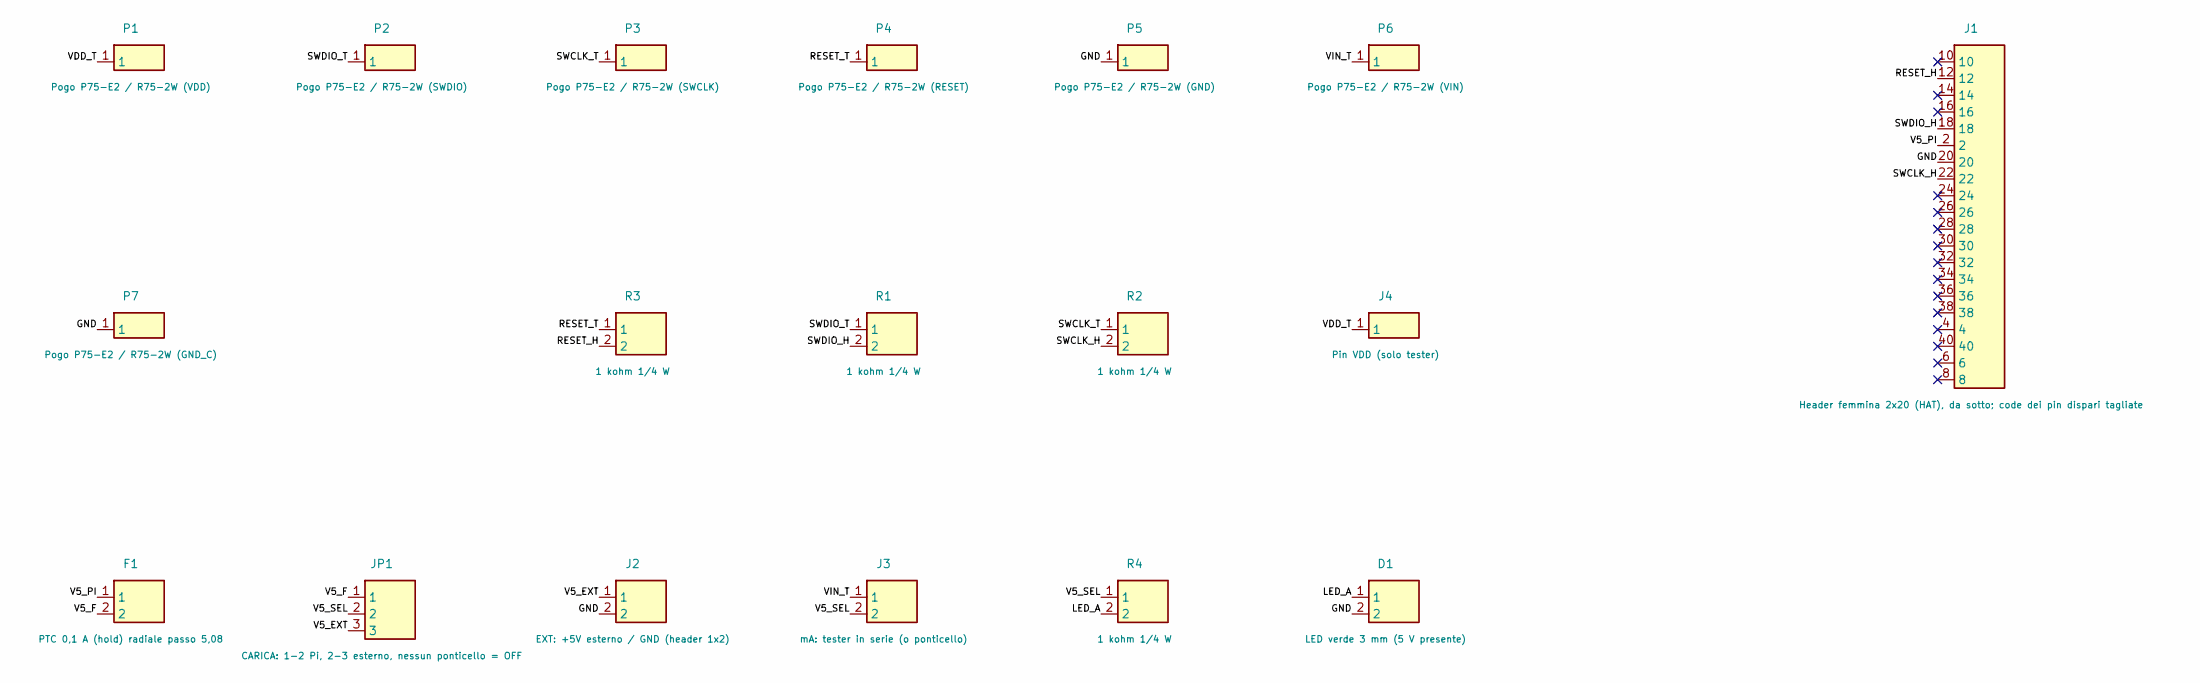
[picture p100: schematic swimtag_programmatore.kicad_sch, SwimTag - adattatore di programmazione e collaudo]

Parts:
D1: LED verde 3 mm (5 V presente); LED_P2.54
F1: PTC 0,1 A (hold) radiale passo 5,08; PTC_Radial_P5.08
J1: Header femmina 2x20 (HAT), da sotto; code dei pin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; Header_F_2x20_HAT
J2: EXT: +5V esterno / GND (header 1x2); Header_1x2_P2.54
J3: mA: tester in serie (o ponticello); Header_1x2_P2.54
J4: Pin VDD (solo tester); Header_1x1
JP1: CARICA: 1-2 Pi, 2-3 esterno, nessun ponticello = 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; Header_1x3_P2.54
P1: Pogo P75-E2 / R75-2W (VDD); Pogo_P75_ricettacolo
P2: Pogo P75-E2 / R75-2W (SWDIO); Pogo_P75_ricettacolo
P3: Pogo P75-E2 / R75-2W (SWCLK); Pogo_P75_ricettacolo
P4: Pogo P75-E2 / R75-2W (RESET); Pogo_P75_ricettacolo
P5: Pogo P75-E2 / R75-2W (GND); Pogo_P75_ricettacolo
P6: Pogo P75-E2 / R75-2W (VIN); Pogo_P75_ricettacolo
P7: Pogo P75-E2 / R75-2W (GND_C); Pogo_P75_ricettacolo
R1, R2, R3, R4: 1 kohm 1/4 W; R_1k

Connections:
/GND: D1.2, J1.20, J2.2, P5.1, P7.1
/LED_A: D1.1, R4.2
/RESET_H: J1.12, R3.2
/RESET_T: P4.1, R3.1
/SWCLK_H: J1.22, R2.2
/SWCLK_T: P3.1, R2.1
/SWDIO_H: J1.18, R1.2
/SWDIO_T: P2.1, R1.1
/V5_EXT: J2.1, JP1.3
/V5_F: F1.2, JP1.1
/V5_PI: F1.1, J1.2
/V5_SEL: J3.2, JP1.2, R4.1
/VDD_T: J4.1, P1.1
/VIN_T: J3.1, P6.1

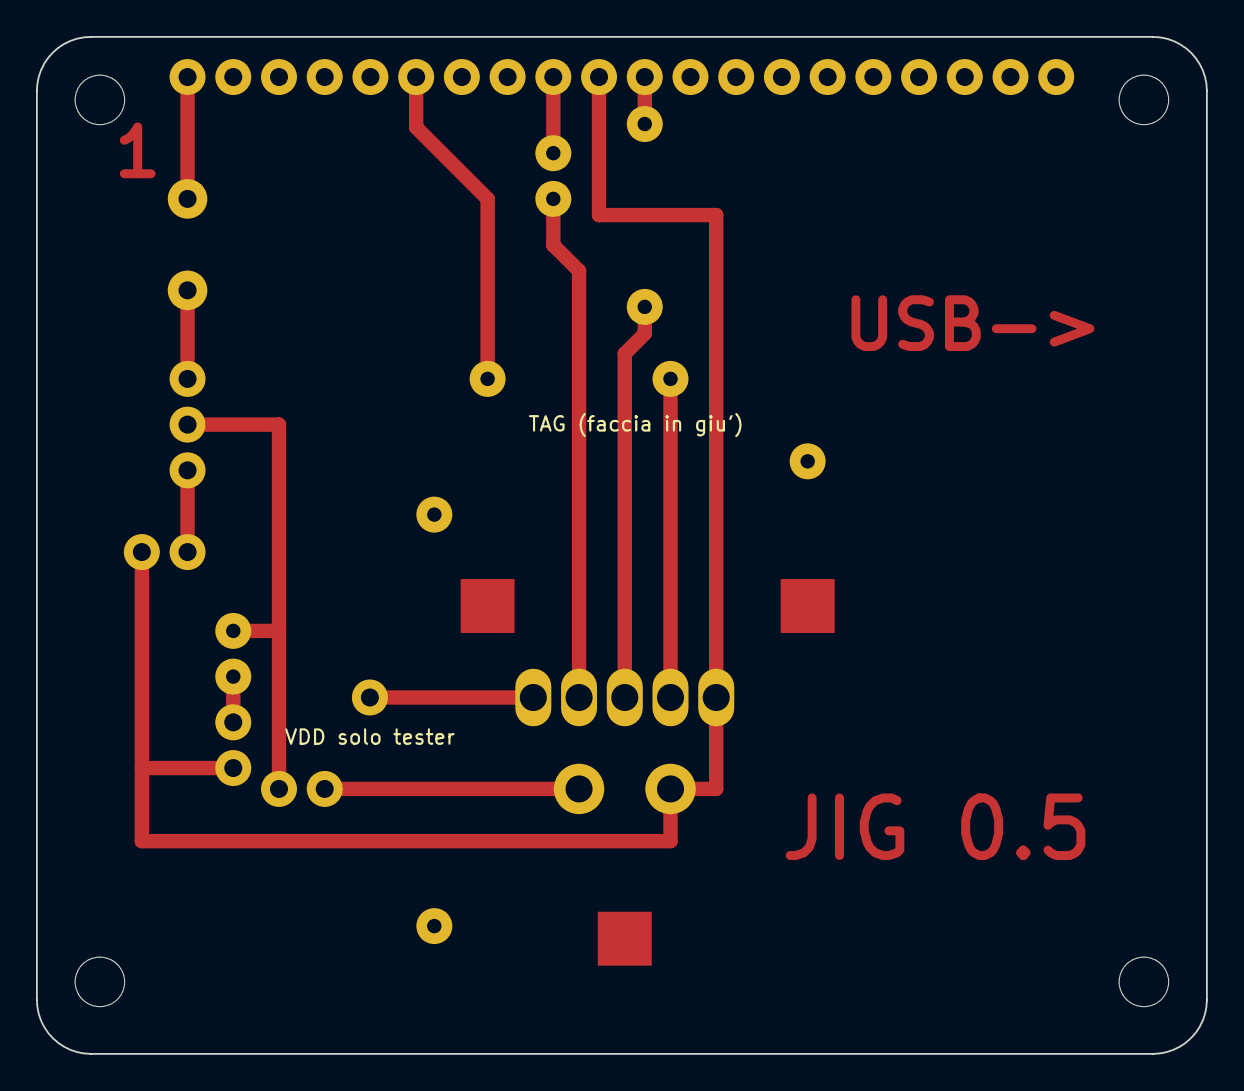
[picture p101: board swimtag_programmatore.kicad_pcb from above]

Board: 2 copper layers, 65.0 x 56.5 mm, 28 parts (0 on the bottom side), 14 nets.

Other parts of the board:
H1, H2, H3, H4: Foro M2,5 (HAT); MountingHole_M2.5
S1, S2: Battuta lato sinistro (pin 0,64 mm); Header_1x1
S3: Battuta lato alto (pin 0,64 mm); Header_1x1
S4, S5, S6: Sede dell'appoggio (blocchetto 2,5 mm incollato); Glue_3x3
