PZero/SwimTimer/hardware/nrf52840/kicad/swimtag_collaudo.kicad_pcb

## KiCad design hardware/nrf52840/kicad/swimtag_collaudo.kicad_pcb (2026-11-01)

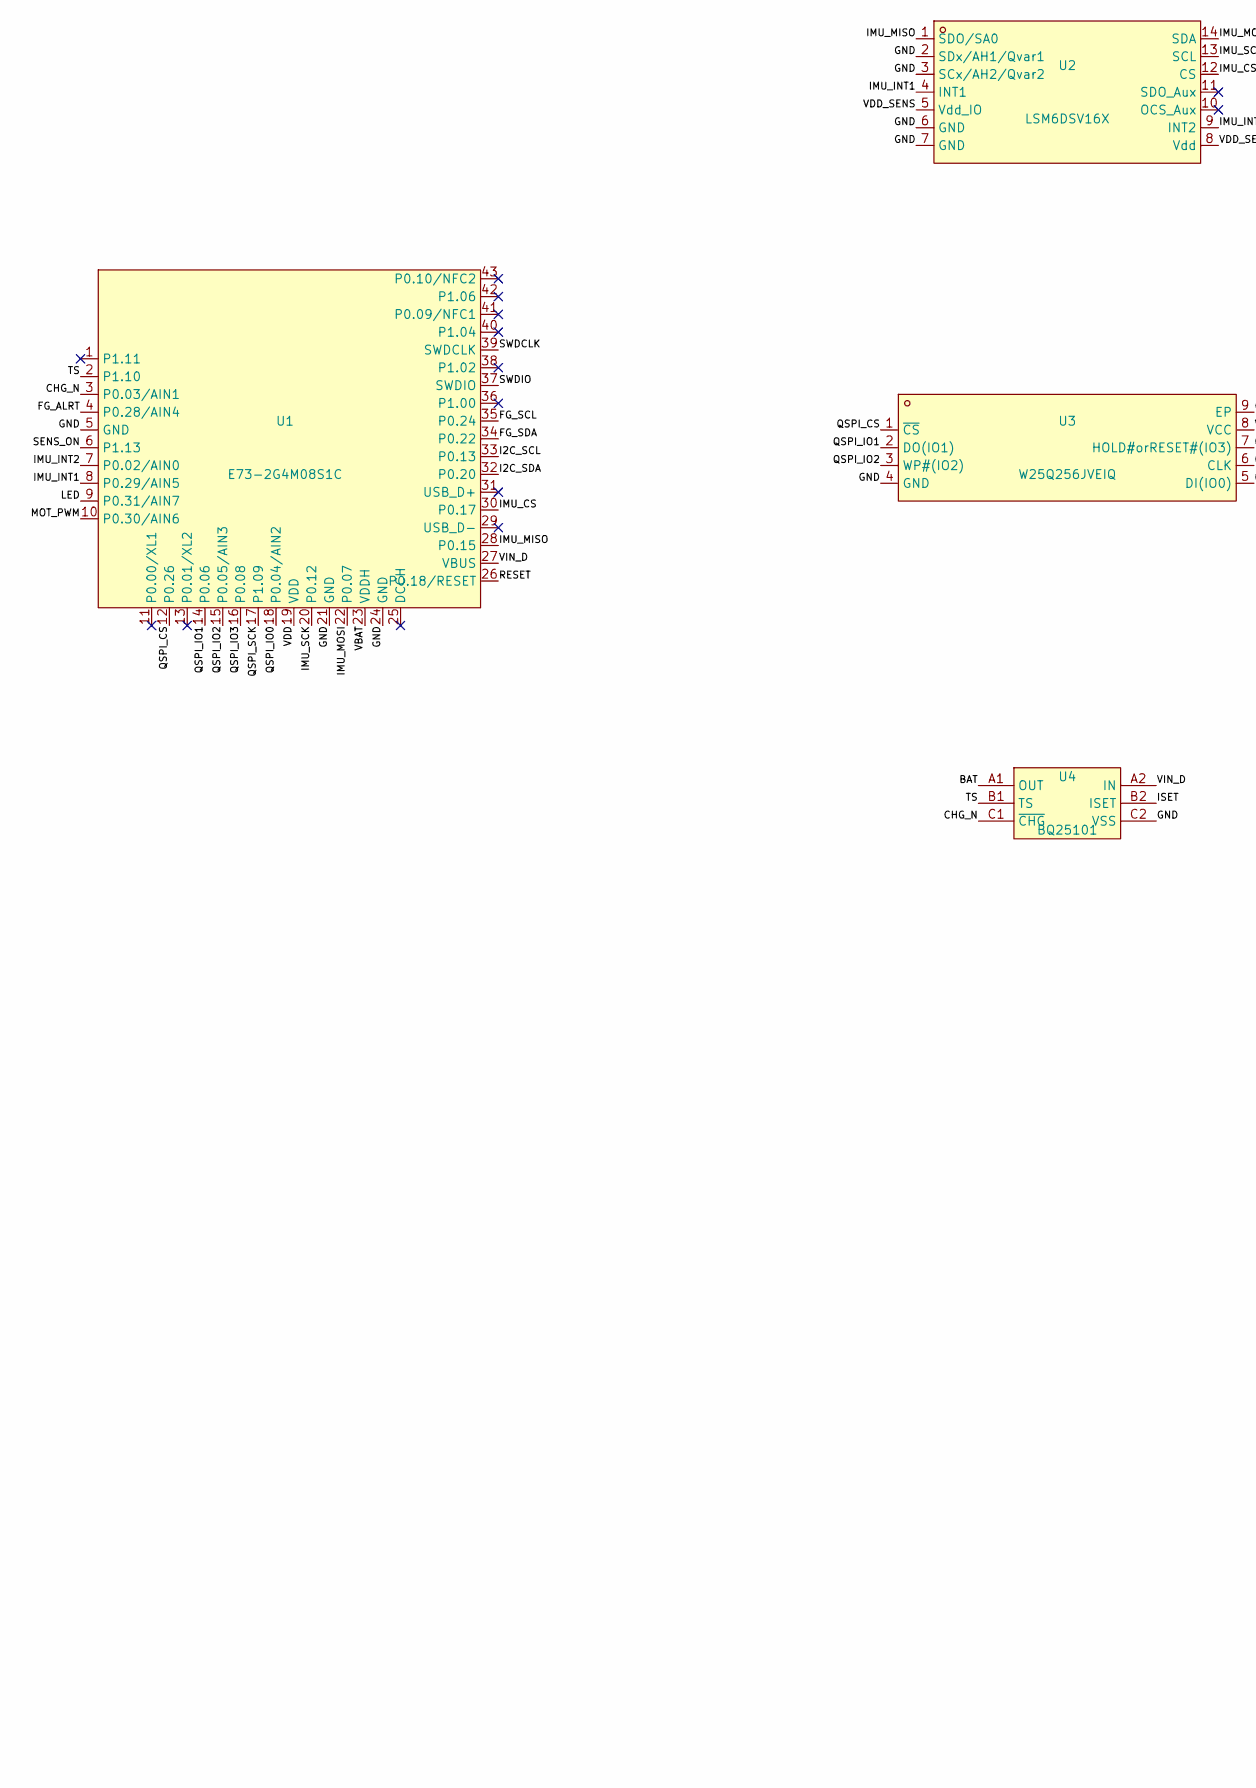
[picture p102: schematic swimtag_collaudo.kicad_sch, SwimTimer - tag nRF52840, part in row 1, column 1]

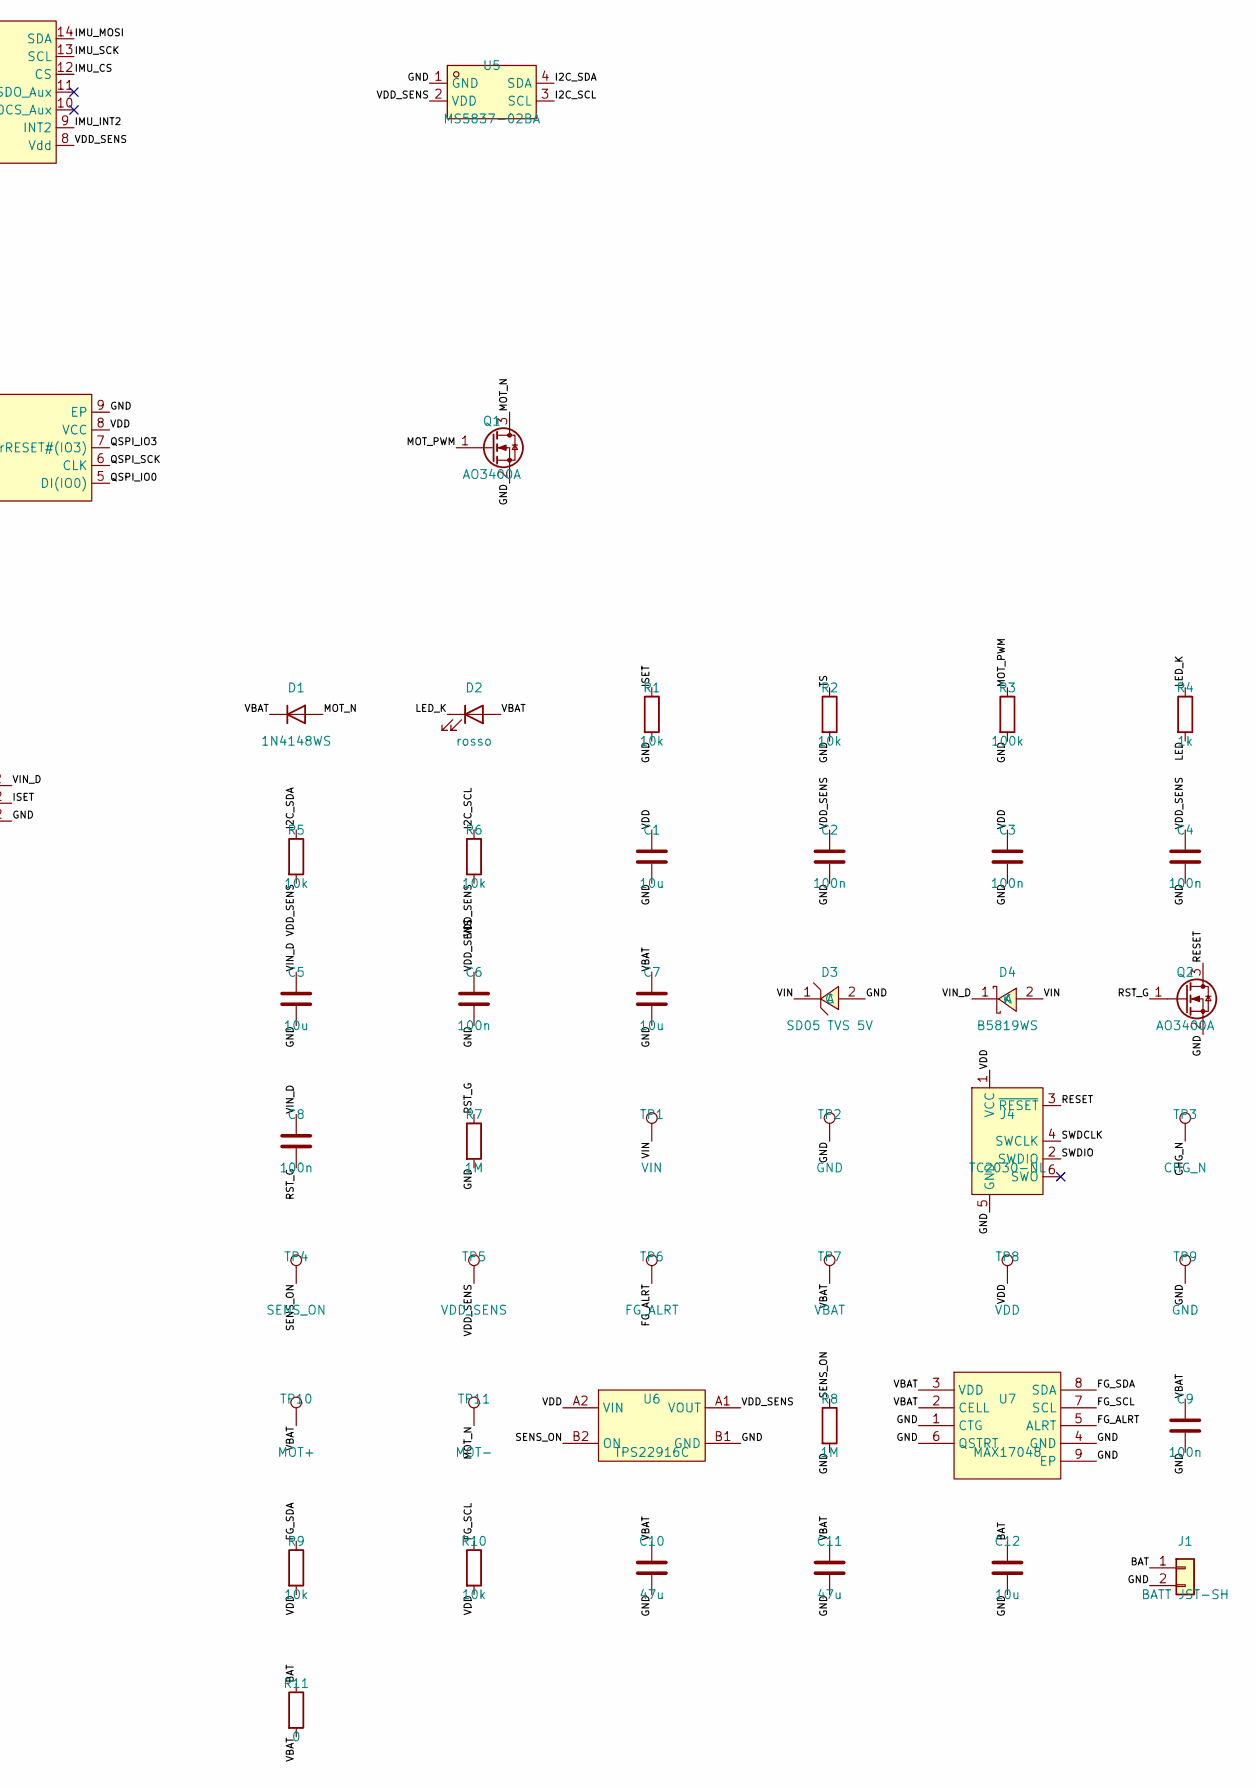
[picture p103: schematic swimtag_collaudo.kicad_sch, SwimTimer - tag nRF52840, part in row 1, column 2]

Parts:
C1, C5, C7, C12: 10u; C_0402_1005Metric; LCSC C15525
C2, C3, C4, C6, C8, C9: 100n; C_0402_1005Metric; LCSC C1525
C10, C11: 47u; C_0805_2012Metric; LCSC C16780
D1: 1N4148WS; D_SOD-323; LCSC C2128
D2: rosso; LED_0603_1608Metric; LCSC C2286
D3: SD05 TVS 5V; SOD-323_L1.8-W1.3-LS2.5-RD; LCSC C85201
D4: B5819WS; SOD-323_L1.8-W1.3-LS2.5-RD; LCSC C22624
J1: BATT JST-SH; JST_SH_SM02B-SRSS-TB_1x02-1MP_P1.00mm_Horizontal; LCSC C160402
J4: TC2030-NL; Tag-Connect_TC2030-IDC-NL_2x03_P1.27mm_Vertical
Q1, Q2: AO3400A; SOT-23; LCSC C20917
R1, R2, R5, R6, R9, R10: 10k; R_0402_1005Metric; LCSC C25744
R3: 100k; R_0402_1005Metric; LCSC C25741
R4: 1k; R_0402_1005Metric; LCSC C11702
R7, R8: 1M; R_0402_1005Metric; LCSC C26083
R11: 0; R_0402_1005Metric; LCSC C17168
TP1: VIN; TestPoint_Pad_D2.5mm
TP2: GND; TestPoint_Pad_D2.5mm
TP3: CHG_N; TestPoint_Pad_D0.8mm
TP4: SENS_ON; TestPoint_Pad_D0.8mm
TP5: VDD_SENS; TestPoint_Pad_D0.8mm
TP6: FG_ALRT; TestPoint_Pad_D0.8mm
TP7: VBAT; TestPoint_Pad_D1.0mm
TP8: VDD; TestPoint_Pad_D1.0mm
TP9: GND; TestPoint_Pad_D1.0mm
TP10: MOT+; TestPoint_Pad_1.0x1.0mm
TP11: MOT-; TestPoint_Pad_1.0x1.0mm
U1: E73-2G4M08S1C; WIRELM-SMD_E73-2G4M08S1C; LCSC C356849
U2: LSM6DSV16X; LGA-14_L3.0-W2.5-P0.50-BR; LCSC C5267406
U3: W25Q256JVEIQ; WSON-8_L8.0-W6.10-P1.27-BL-EP; LCSC C97522
U4: BQ25101; DSBGA-6_L0.9-W1.6-R2-C3-P0.40-BL; LCSC C478468
U5: MS5837-02BA; LGA-4_L3.3-W3.3-P2.00-TL; LCSC C5785272
U6: TPS22916C; DSBGA-4_L0.78-W0.78-P0.40; LCSC C2680319
U7: MAX17048; TDFN-8-1EP_2x2mm_P0.5mm_EP0.8x1.2mm; LCSC C2682616

Connections:
/BAT: C12.1, J1.1, R11.1, U4.A1 (OUT)
/CHG_N: TP3.1, U1.3 (P0.03/AIN1), U4.C1 (~CHG)
/FG_ALRT: TP6.1, U1.4 (P0.28/AIN4), U7.5 (ALRT)
/FG_SCL: R10.1, U1.35 (P0.24), U7.7 (SCL)
/FG_SDA: R9.1, U1.34 (P0.22), U7.8 (SDA)
/GND: C1.2, C2.2, C3.2, C4.2, C5.2, C6.2, C7.2, C9.2, C10.2, C11.2, C12.2, D3.2 (A), J1.2, J4.5 (GND), Q1.2 (S), Q2.2 (S), R1.2, R2.2, R3.2, R7.2, R8.2, TP2.1, TP9.1, U1.5 (GND), U1.21 (GND), U1.24 (GND), U2.2 (SDx/AH1/Qvar1), U2.3 (SCx/AH2/Qvar2), U2.6 (GND), U2.7 (GND), U3.4 (GND), U3.9 (EP), U4.C2 (VSS), U5.1 (GND), U6.B1 (GND), U7.1 (CTG), U7.4 (GND), U7.6 (QSTRT), U7.9 (EP)
/I2C_SCL: R6.1, U1.33 (P0.13), U5.3 (SCL)
/I2C_SDA: R5.1, U1.32 (P0.20), U5.4 (SDA)
/IMU_CS: U1.30 (P0.17), U2.12 (CS)
/IMU_INT1: U1.8 (P0.29/AIN5), U2.4 (INT1)
/IMU_INT2: U1.7 (P0.02/AIN0), U2.9 (INT2)
/IMU_MISO: U1.28 (P0.15), U2.1 (SDO/SA0)
/IMU_MOSI: U1.22 (P0.07), U2.14 (SDA)
/IMU_SCK: U1.20 (P0.12), U2.13 (SCL)
/ISET: R1.1, U4.B2 (ISET)
/LED: R4.2, U1.9 (P0.31/AIN7)
/LED_K: D2.1 (K), R4.1
/MOT_N: D1.2 (A), Q1.3 (D), TP11.1
/MOT_PWM: Q1.1 (G), R3.1, U1.10 (P0.30/AIN6)
/QSPI_CS: U1.12 (P0.26), U3.1 (~CS)
/QSPI_IO0: U1.18 (P0.04/AIN2), U3.5 (DI(IO0))
/QSPI_IO1: U1.14 (P0.06), U3.2 (DO(IO1))
/QSPI_IO2: U1.15 (P0.05/AIN3), U3.3 (WP#(IO2))
/QSPI_IO3: U1.16 (P0.08), U3.7 (HOLD#orRESET#(IO3))
/QSPI_SCK: U1.17 (P1.09), U3.6 (CLK)
/RESET: J4.3 (~RESET), Q2.3 (D), U1.26 (P0.18/RESET)
/RST_G: C8.2, Q2.1 (G), R7.1
/SENS_ON: R8.1, TP4.1, U1.6 (P1.13), U6.B2 (ON)
/SWDCLK: J4.4 (SWCLK), U1.39 (SWDCLK)
/SWDIO: J4.2 (SWDIO), U1.37 (SWDIO)
/TS: R2.1, U1.2 (P1.10), U4.B1 (TS)
/VBAT: C7.1, C9.1, C10.1, C11.1, D1.1 (K), D2.2 (A), R11.2, TP7.1, TP10.1, U1.23 (VDDH), U7.2 (CELL), U7.3 (VDD)
/VDD: C1.1, C3.1, J4.1 (VCC), R9.2, R10.2, TP8.1, U1.19 (VDD), U3.8 (VCC), U6.A2 (VIN)
/VDD_SENS: C2.1, C4.1, C6.1, R5.2, R6.2, TP5.1, U2.5 (Vdd_IO), U2.8 (Vdd), U5.2 (VDD), U6.A1 (VOUT)
/VIN: D3.1 (C), D4.2 (A), TP1.1
/VIN_D: C5.1, C8.1, D4.1 (K), U1.27 (VBUS), U4.A2 (IN)

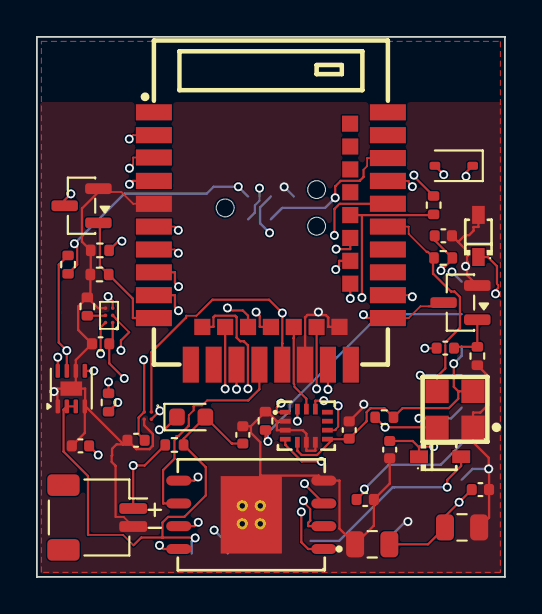
[picture p104: board swimtag_collaudo.kicad_pcb from above]

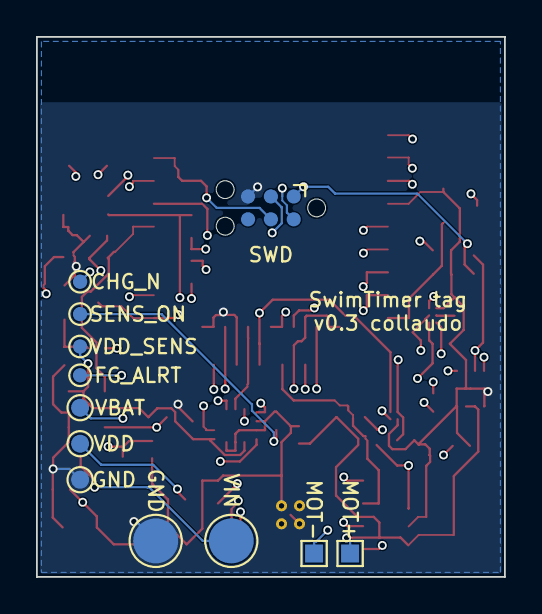
[picture p105: board swimtag_collaudo.kicad_pcb from below]

Board: 4 copper layers, 26.0 x 30.0 mm, 49 parts (12 on the bottom side), 36 nets.
