PZero/SwimTimer/hardware/nrf52840/kicad/swimtag.kicad_pcb

## KiCad design hardware/nrf52840/kicad/swimtag.kicad_pcb (2026-10-25, an earlier design)

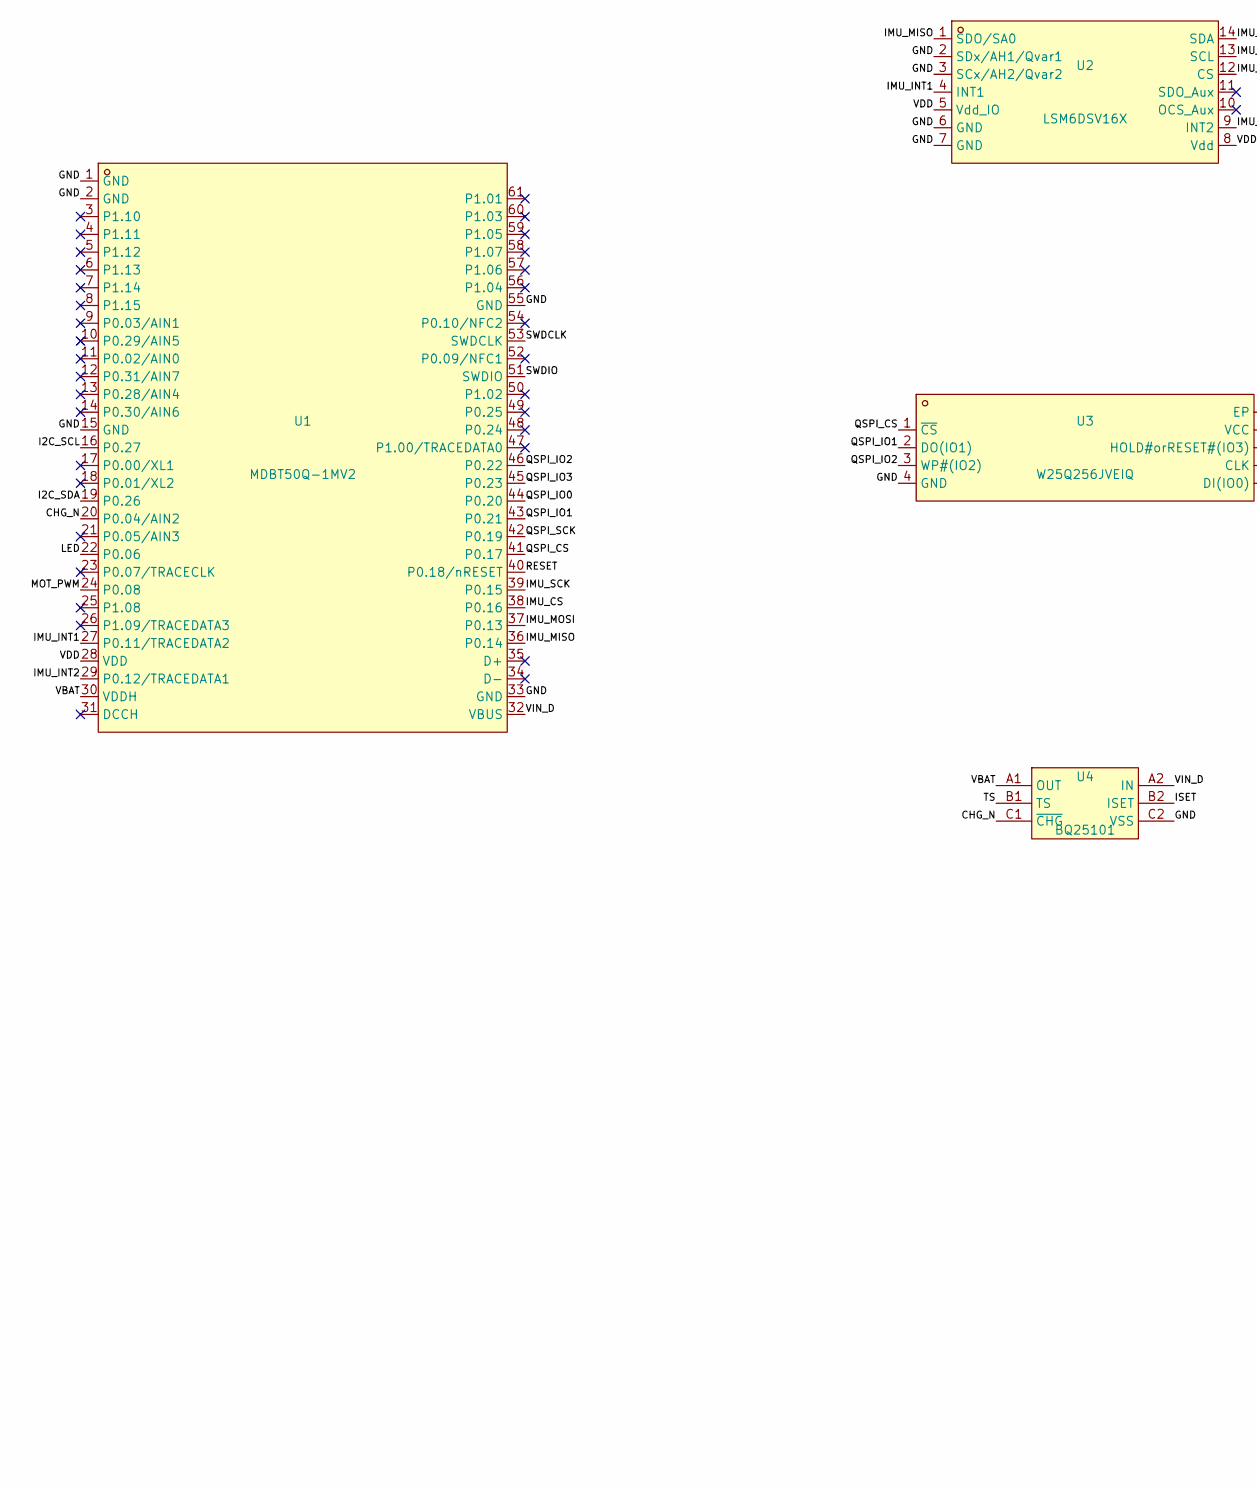
[picture p106: schematic swimtag.kicad_sch, SwimTimer - tag nRF52840, part in row 1, column 1]

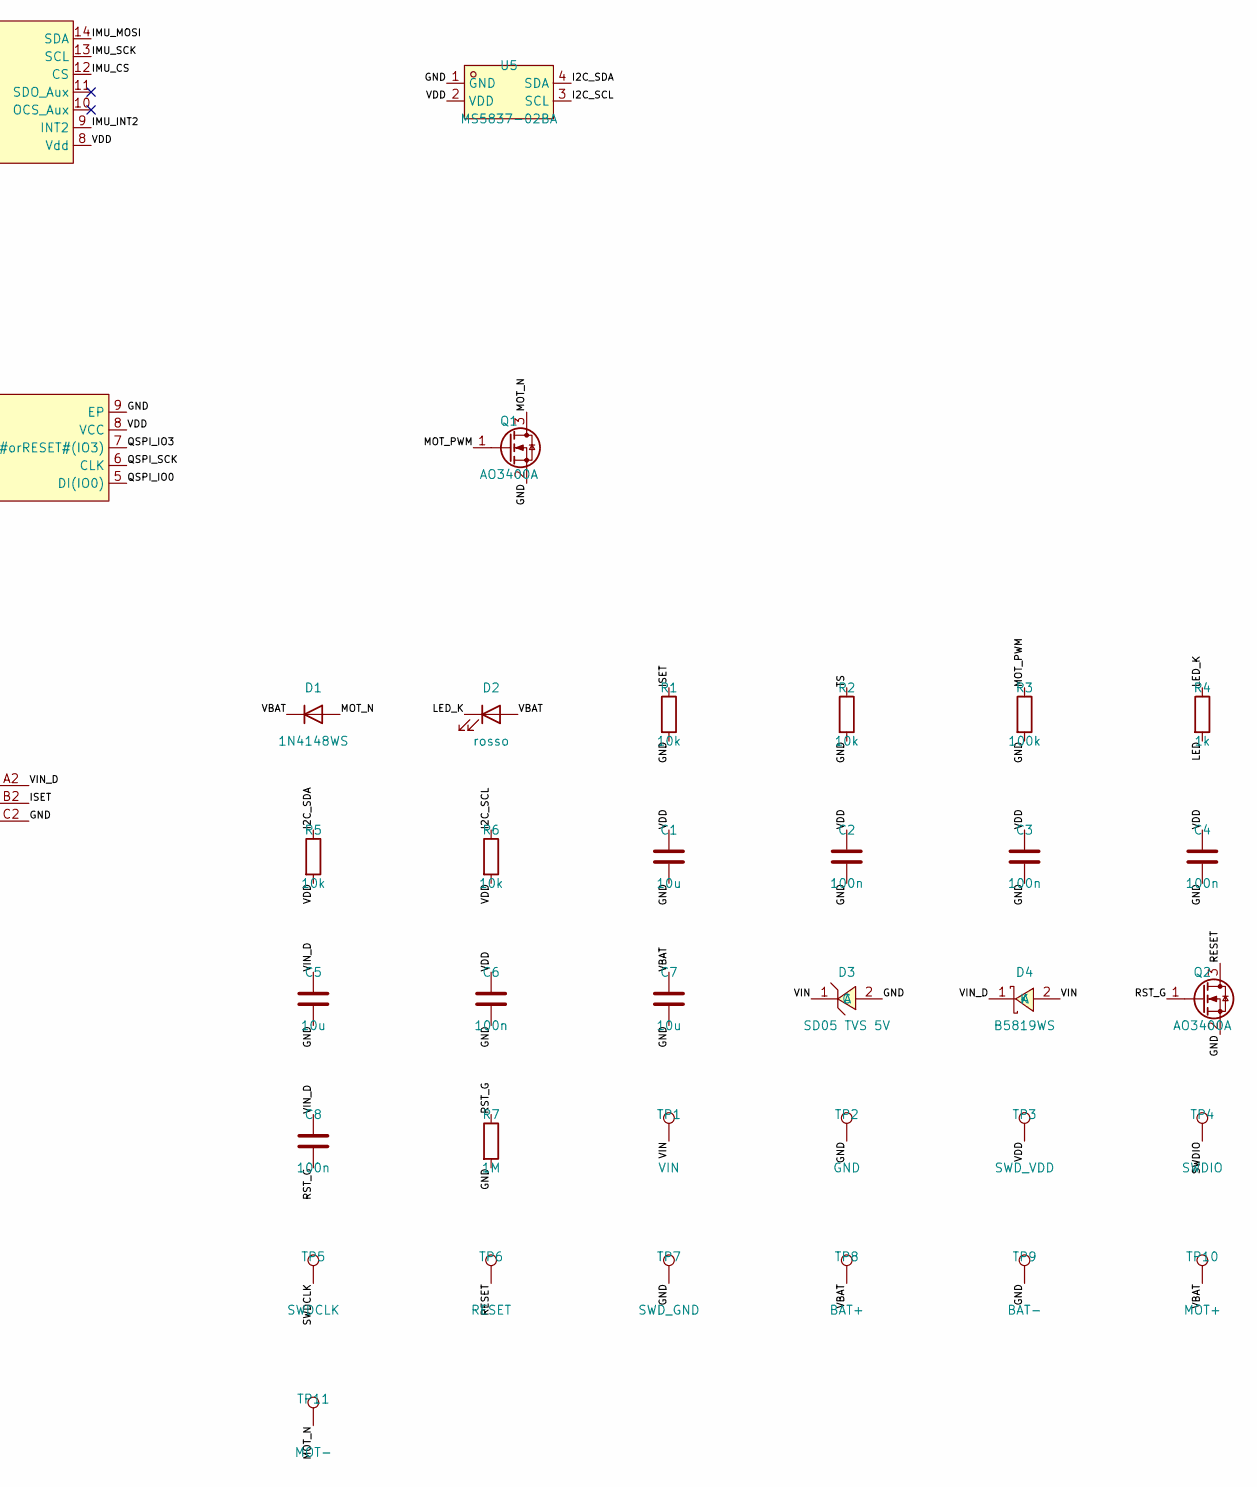
[picture p107: schematic swimtag.kicad_sch, SwimTimer - tag nRF52840, part in row 1, column 2]

Parts:
C1, C5, C7: 10u; C_0402_1005Metric; LCSC C15525
C2, C3, C4, C6, C8: 100n; C_0402_1005Metric; LCSC C1525
D1: 1N4148WS; D_SOD-323; LCSC C2128
D2: rosso; LED_0603_1608Metric; LCSC C2286
D3: SD05 TVS 5V; SOD-323_L1.8-W1.3-LS2.5-RD; LCSC C85201
D4: B5819WS; SOD-323_L1.8-W1.3-LS2.5-RD; LCSC C22624
Q1, Q2: AO3400A; SOT-23; LCSC C20917
R1, R2, R5, R6: 10k; R_0402_1005Metric; LCSC C25744
R3: 100k; R_0402_1005Metric; LCSC C25741
R4: 1k; R_0402_1005Metric; LCSC C11702
R7: 1M; R_0402_1005Metric; LCSC C26083
TP1: VIN; TestPoint_Pad_D2.5mm
TP2: GND; TestPoint_Pad_D2.5mm
TP3: SWD_VDD; TestPoint_Pad_D1.0mm
TP4: SWDIO; TestPoint_Pad_D1.0mm
TP5: SWDCLK; TestPoint_Pad_D1.0mm
TP6: RESET; TestPoint_Pad_D1.0mm
TP7: SWD_GND; TestPoint_Pad_D1.0mm
TP8: BAT+; TestPoint_Pad_1.0x1.0mm
TP9: BAT-; TestPoint_Pad_1.0x1.0mm
TP10: MOT+; TestPoint_Pad_1.0x1.0mm
TP11: MOT-; TestPoint_Pad_1.0x1.0mm
U1: MDBT50Q-1MV2; COMM-SMD_MDBT50Q-1MV2-1; LCSC C5118826
U2: LSM6DSV16X; LGA-14_L3.0-W2.5-P0.50-BR; LCSC C5267406
U3: W25Q256JVEIQ; WSON-8_L8.0-W6.10-P1.27-BL-EP; LCSC C97522
U4: BQ25101; DSBGA-6_L0.9-W1.6-R2-C3-P0.40-BL; LCSC C478468
U5: MS5837-02BA; LGA-4_L3.3-W3.3-P2.00-TL; LCSC C2887129

Connections:
/CHG_N: U1.20 (P0.04/AIN2), U4.C1 (~CHG)
/GND: C1.2, C2.2, C3.2, C4.2, C5.2, C6.2, C7.2, D3.2 (A), Q1.2 (S), Q2.2 (S), R1.2, R2.2, R3.2, R7.2, TP2.1, TP7.1, TP9.1, U1.1 (GND), U1.2 (GND), U1.15 (GND), U1.33 (GND), U1.55 (GND), U2.2 (SDx/AH1/Qvar1), U2.3 (SCx/AH2/Qvar2), U2.6 (GND), U2.7 (GND), U3.4 (GND), U3.9 (EP), U4.C2 (VSS), U5.1 (GND)
/I2C_SCL: R6.1, U1.16 (P0.27), U5.3 (SCL)
/I2C_SDA: R5.1, U1.19 (P0.26), U5.4 (SDA)
/IMU_CS: U1.38 (P0.16), U2.12 (CS)
/IMU_INT1: U1.27 (P0.11/TRACEDATA2), U2.4 (INT1)
/IMU_INT2: U1.29 (P0.12/TRACEDATA1), U2.9 (INT2)
/IMU_MISO: U1.36 (P0.14), U2.1 (SDO/SA0)
/IMU_MOSI: U1.37 (P0.13), U2.14 (SDA)
/IMU_SCK: U1.39 (P0.15), U2.13 (SCL)
/ISET: R1.1, U4.B2 (ISET)
/LED: R4.2, U1.22 (P0.06)
/LED_K: D2.1 (K), R4.1
/MOT_N: D1.2 (A), Q1.3 (D), TP11.1
/MOT_PWM: Q1.1 (G), R3.1, U1.24 (P0.08)
/QSPI_CS: U1.41 (P0.17), U3.1 (~CS)
/QSPI_IO0: U1.44 (P0.20), U3.5 (DI(IO0))
/QSPI_IO1: U1.43 (P0.21), U3.2 (DO(IO1))
/QSPI_IO2: U1.46 (P0.22), U3.3 (WP#(IO2))
/QSPI_IO3: U1.45 (P0.23), U3.7 (HOLD#orRESET#(IO3))
/QSPI_SCK: U1.42 (P0.19), U3.6 (CLK)
/RESET: Q2.3 (D), TP6.1, U1.40 (P0.18/nRESET)
/RST_G: C8.2, Q2.1 (G), R7.1
/SWDCLK: TP5.1, U1.53 (SWDCLK)
/SWDIO: TP4.1, U1.51 (SWDIO)
/TS: R2.1, U4.B1 (TS)
/VBAT: C7.1, D1.1 (K), D2.2 (A), TP8.1, TP10.1, U1.30 (VDDH), U4.A1 (OUT)
/VDD: C1.1, C2.1, C3.1, C4.1, C6.1, R5.2, R6.2, TP3.1, U1.28 (VDD), U2.5 (Vdd_IO), U2.8 (Vdd), U3.8 (VCC), U5.2 (VDD)
/VIN: D3.1 (C), D4.2 (A), TP1.1
/VIN_D: C5.1, C8.1, D4.1 (K), U1.32 (VBUS), U4.A2 (IN)

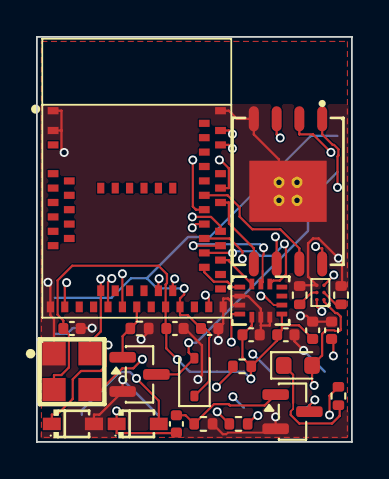
[picture p108: board swimtag.kicad_pcb from above]

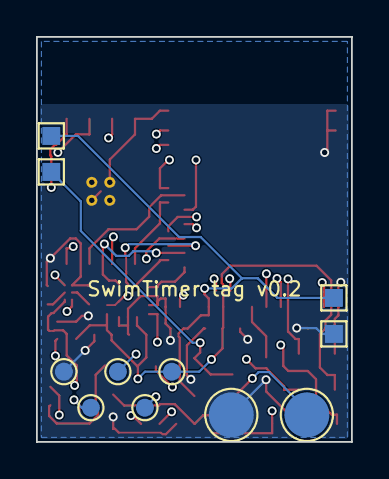
[picture p109: board swimtag.kicad_pcb from below]

Board: 4 copper layers, 17.5 x 22.5 mm, 37 parts (11 on the bottom side), 30 nets.
