PZero/SwimTimer/hardware/nrf52840/kicad/nextpcb/v0.5_pannello_3x1/pannello_3x1.kicad_pcb

## KiCad design hardware/nrf52840/kicad/nextpcb/v0.5_pannello_3x1/pannello_3x1.kicad_pcb (2026-11-06)

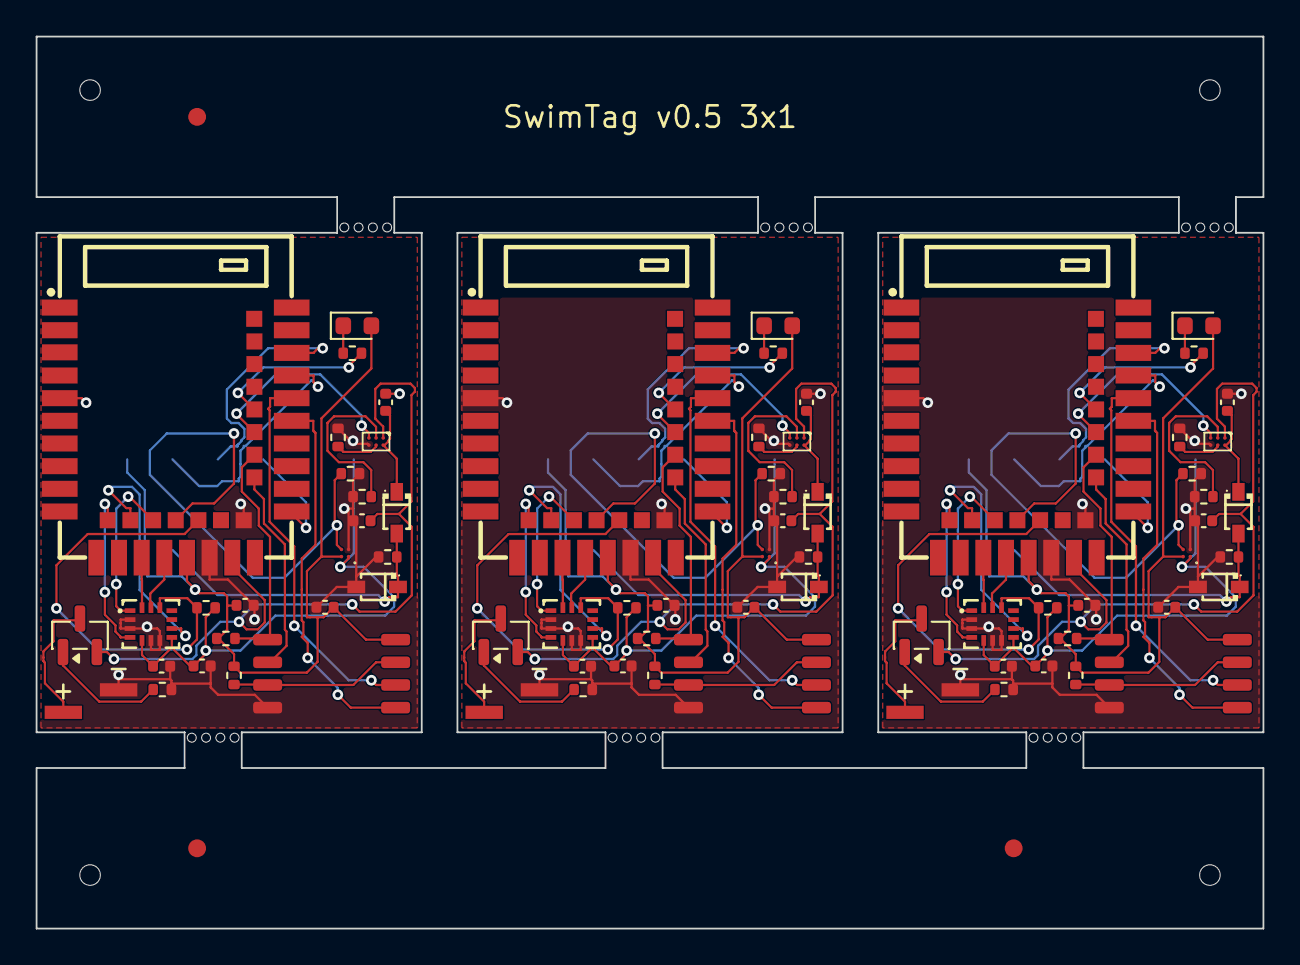
[picture p110: board pannello_3x1.kicad_pcb from above]

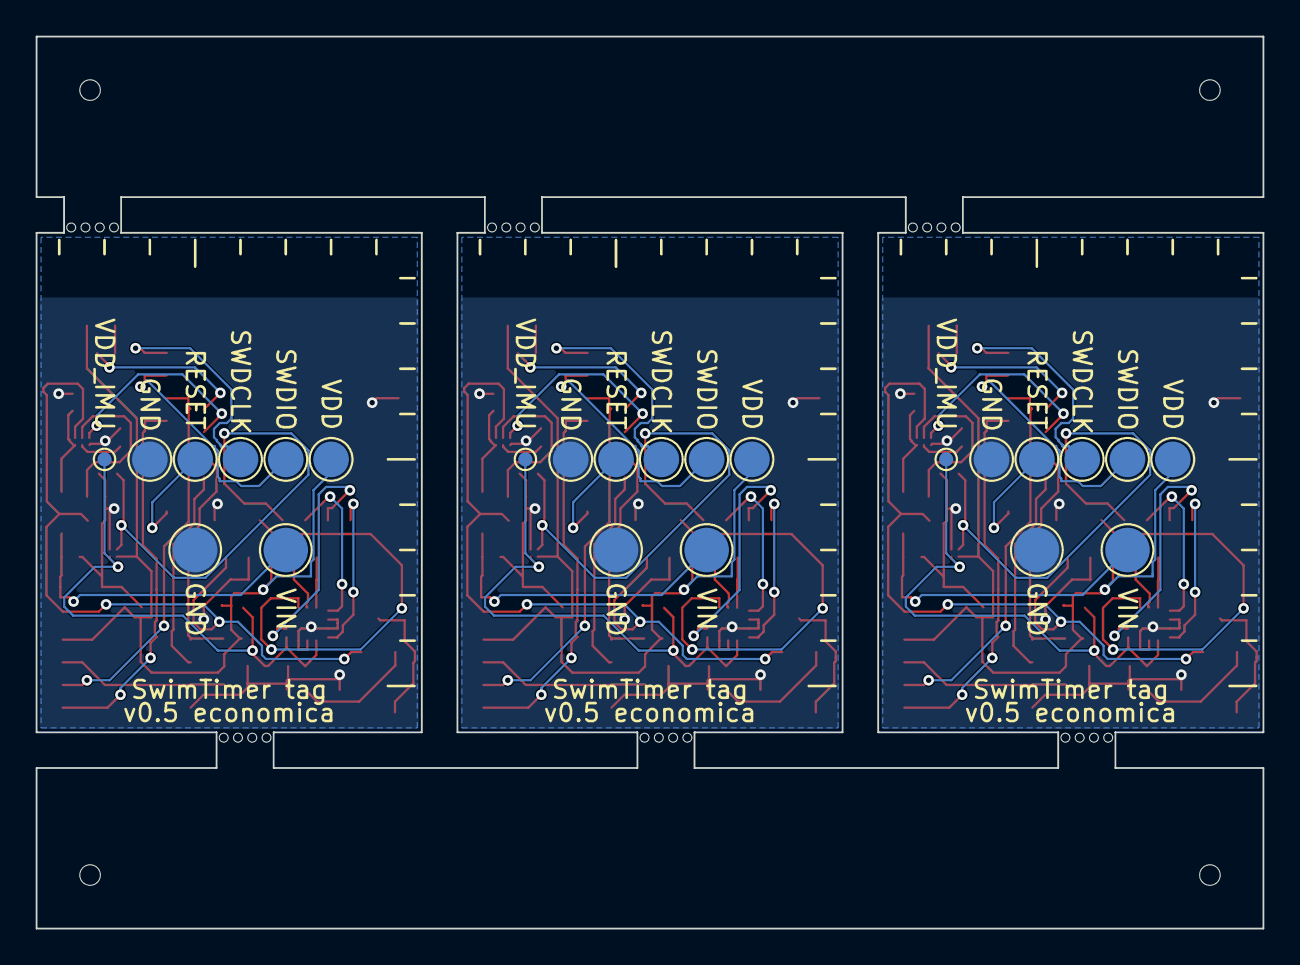
[picture p111: board pannello_3x1.kicad_pcb from below]

Board: 2 copper layers, 68.8 x 50.0 mm, 130 parts (24 on the bottom side), 84 nets.

Parts:
C1_1, C1_2, C1_3: 10u; C_0402_1005Metric
C2_1, C2_2, C2_3, C3_1, C3_2, C3_3, C4_1, C4_2, C4_3: 100n; C_0402_1005Metric
C5_1, C5_2, C5_3, C6_1, C6_2, C6_3: 4u7; C_0402_1005Metric
D1_1, D1_2, D1_3: rosso 0603; LED_0603_1608Metric
D2_1, D2_2, D2_3: 1N5819WS; SOD-323_L1.8-W1.3-LS2.5-RD
D3_1, D3_2, D3_3: PTVSLC3D5VB; SOD-323_L1.8-W1.3-LS2.5-RD
FID1, FID2, FID3: Fiducial_1mm_Mask2mm
J1_1, J1_2, J1_3: BATT header 1.27; HDR-SMD_2P-P1.27-V-M-LS4.2-R1
MB1, MB2, MB3, MB4, MB5, MB6, MB7, MB8, MB9, MB10, MB11, MB12, MB13, MB14, MB15, MB16, MB17, MB18, MB19, MB20, MB21, MB22, MB23, MB24: NPTH
Q1_1, Q1_2, Q1_3: AO3401A; SOT-23
R1_1, R1_2, R1_3, R2_1, R2_2, R2_3, R4_1, R4_2, R4_3: 10k; R_0402_1005Metric
R3_1, R3_2, R3_3: 1k; R_0402_1005Metric
R5_1, R5_2, R5_3, R6_1, R6_2, R6_3, R8_1, R8_2, R8_3, R9_1, R9_2, R9_3: 100k; R_0402_1005Metric
R7_1, R7_2, R7_3: 1M; R_0402_1005Metric
TH1, TH2, TH3, TH4: NPTH
TP1_1, TP1_2, TP1_3: VDD; TestPoint_Pad_D2.0mm_NoCY
TP2_1, TP2_2, TP2_3: SWDIO; TestPoint_Pad_D2.0mm_NoCY
TP3_1, TP3_2, TP3_3: SWDCLK; TestPoint_Pad_D2.0mm_NoCY
TP4_1, TP4_2, TP4_3: RESET; TestPoint_Pad_D2.0mm_NoCY
TP5_1, TP5_2, TP5_3: GND; TestPoint_Pad_D2.0mm_NoCY
TP6_1, TP6_2, TP6_3: VIN; TestPoint_Pad_D2.5mm
TP7_1, TP7_2, TP7_3: GND; TestPoint_Pad_D2.5mm
TP8_1, TP8_2, TP8_3: VDD_IMU; TestPoint_Pad_D0.8mm
U1_1, U1_2, U1_3: E73-2G4M08S1C; WIRELM-SMD_E73-2G4M08S1C
U2_1, U2_2, U2_3: LSM6DSV16X; LGA-14_L3.0-W2.5-P0.50-BR
U3_1, U3_2, U3_3: W25Q128JVSIQ; SOIC-8_5.3x5.3mm_P1.27mm
U4_1, U4_2, U4_3: BQ25101; DSBGA-6_L0.9-W1.6-R2-C3-P0.40-BL
U6_1, U6_2, U6_3: TPS22916C; DSBGA-4_L0.78-W0.78-P0.40

Connections:
B1_/BAT_G: Q1_1.1, R9_1.1
B1_/BAT_IN: J1_1.1, Q1_1.3
B1_/CHG_N: U1_1.32, U4_1.C1
B1_/FL_CS: R5_1.1, U1_1.30, U3_1.1
B1_/FL_IO23: R4_1.1, U3_1.3, U3_1.7
B1_/FL_MISO: U1_1.28, U3_1.2
B1_/FL_MOSI: U1_1.33, U3_1.5
B1_/FL_SCK: U1_1.35, U3_1.6
B1_/GND: C1_1.2, C2_1.2, C3_1.2, C4_1.2, C5_1.2, C6_1.2, D3_1.2, J1_1.2, R1_1.2, R2_1.2, R7_1.2, R8_1.2, R9_1.2, TP5_1.1, TP7_1.1, U1_1.5, U1_1.21, U1_1.24, U2_1.2, U2_1.3, U2_1.6, U2_1.7, U3_1.4, U4_1.C2, U6_1.B1
B1_/IMU_CS: R6_1.1, U1_1.20, U2_1.12
B1_/IMU_INT1: U1_1.12, U2_1.4
B1_/IMU_INT2: U1_1.14, U2_1.9
B1_/IMU_MISO: U1_1.16, U2_1.1
B1_/IMU_MOSI: U1_1.15, U2_1.14
B1_/IMU_SCK: U1_1.17, U2_1.13
B1_/ISET: R1_1.1, U4_1.B2
B1_/LED: R3_1.2, U1_1.34
B1_/LED_K: D1_1.1, R3_1.1
B1_/RESET: TP4_1.1, U1_1.26
B1_/SENS_ON: R7_1.1, U1_1.18, U6_1.B2
B1_/SWDCLK: TP3_1.1, U1_1.39
B1_/SWDIO: TP2_1.1, U1_1.37
B1_/TS: R2_1.1, U4_1.B1
B1_/VBAT: C6_1.1, Q1_1.2, U1_1.23, U4_1.A1
B1_/VDD: C1_1.1, C3_1.1, D1_1.2, R4_1.2, R5_1.2, TP1_1.1, U1_1.19, U3_1.8, U6_1.A2
B1_/VDD_IMU: C2_1.1, C4_1.1, R6_1.2, TP8_1.1, U2_1.5, U2_1.8, U6_1.A1
B1_/VIN: D2_1.2, D3_1.1, R8_1.1, TP6_1.1
B1_/VIN_D: C5_1.1, D2_1.1, U4_1.A2
B2_/BAT_G: Q1_2.1, R9_2.1
B2_/BAT_IN: J1_2.1, Q1_2.3
B2_/CHG_N: U1_2.32, U4_2.C1
B2_/FL_CS: R5_2.1, U1_2.30, U3_2.1
B2_/FL_IO23: R4_2.1, U3_2.3, U3_2.7
B2_/FL_MISO: U1_2.28, U3_2.2
B2_/FL_MOSI: U1_2.33, U3_2.5
B2_/FL_SCK: U1_2.35, U3_2.6
B2_/GND: C1_2.2, C2_2.2, C3_2.2, C4_2.2, C5_2.2, C6_2.2, D3_2.2, J1_2.2, R1_2.2, R2_2.2, R7_2.2, R8_2.2, R9_2.2, TP5_2.1, TP7_2.1, U1_2.5, U1_2.21, U1_2.24, U2_2.2, U2_2.3, U2_2.6, U2_2.7, U3_2.4, U4_2.C2, U6_2.B1
B2_/IMU_CS: R6_2.1, U1_2.20, U2_2.12
B2_/IMU_INT1: U1_2.12, U2_2.4
B2_/IMU_INT2: U1_2.14, U2_2.9
B2_/IMU_MISO: U1_2.16, U2_2.1
B2_/IMU_MOSI: U1_2.15, U2_2.14
B2_/IMU_SCK: U1_2.17, U2_2.13
B2_/ISET: R1_2.1, U4_2.B2
B2_/LED: R3_2.2, U1_2.34
B2_/LED_K: D1_2.1, R3_2.1
B2_/RESET: TP4_2.1, U1_2.26
B2_/SENS_ON: R7_2.1, U1_2.18, U6_2.B2
B2_/SWDCLK: TP3_2.1, U1_2.39
B2_/SWDIO: TP2_2.1, U1_2.37
B2_/TS: R2_2.1, U4_2.B1
B2_/VBAT: C6_2.1, Q1_2.2, U1_2.23, U4_2.A1
B2_/VDD: C1_2.1, C3_2.1, D1_2.2, R4_2.2, R5_2.2, TP1_2.1, U1_2.19, U3_2.8, U6_2.A2
B2_/VDD_IMU: C2_2.1, C4_2.1, R6_2.2, TP8_2.1, U2_2.5, U2_2.8, U6_2.A1
B2_/VIN: D2_2.2, D3_2.1, R8_2.1, TP6_2.1
B2_/VIN_D: C5_2.1, D2_2.1, U4_2.A2
B3_/BAT_G: Q1_3.1, R9_3.1
B3_/BAT_IN: J1_3.1, Q1_3.3
B3_/CHG_N: U1_3.32, U4_3.C1
B3_/FL_CS: R5_3.1, U1_3.30, U3_3.1
B3_/FL_IO23: R4_3.1, U3_3.3, U3_3.7
B3_/FL_MISO: U1_3.28, U3_3.2
B3_/FL_MOSI: U1_3.33, U3_3.5
B3_/FL_SCK: U1_3.35, U3_3.6
B3_/GND: C1_3.2, C2_3.2, C3_3.2, C4_3.2, C5_3.2, C6_3.2, D3_3.2, J1_3.2, R1_3.2, R2_3.2, R7_3.2, R8_3.2, R9_3.2, TP5_3.1, TP7_3.1, U1_3.5, U1_3.21, U1_3.24, U2_3.2, U2_3.3, U2_3.6, U2_3.7, U3_3.4, U4_3.C2, U6_3.B1
B3_/IMU_CS: R6_3.1, U1_3.20, U2_3.12
B3_/IMU_INT1: U1_3.12, U2_3.4
B3_/IMU_INT2: U1_3.14, U2_3.9
B3_/IMU_MISO: U1_3.16, U2_3.1
B3_/IMU_MOSI: U1_3.15, U2_3.14
B3_/IMU_SCK: U1_3.17, U2_3.13
B3_/ISET: R1_3.1, U4_3.B2
B3_/LED: R3_3.2, U1_3.34
B3_/LED_K: D1_3.1, R3_3.1
B3_/RESET: TP4_3.1, U1_3.26
B3_/SENS_ON: R7_3.1, U1_3.18, U6_3.B2
B3_/SWDCLK: TP3_3.1, U1_3.39
B3_/SWDIO: TP2_3.1, U1_3.37
B3_/TS: R2_3.1, U4_3.B1
B3_/VBAT: C6_3.1, Q1_3.2, U1_3.23, U4_3.A1
B3_/VDD: C1_3.1, C3_3.1, D1_3.2, R4_3.2, R5_3.2, TP1_3.1, U1_3.19, U3_3.8, U6_3.A2
B3_/VDD_IMU: C2_3.1, C4_3.1, R6_3.2, TP8_3.1, U2_3.5, U2_3.8, U6_3.A1
B3_/VIN: D2_3.2, D3_3.1, R8_3.1, TP6_3.1
B3_/VIN_D: C5_3.1, D2_3.1, U4_3.A2
