PZero/SwimTimer/hardware/nrf52840/kicad/esporta_jlc.py

"""Esporta i file per l'ordine JLCPCB in jlc/: Gerber + fori (zip), BOM e CPL nel formato JLC, render.

Uso (Python normale o di KiCad):  python esporta_jlc.py
"""
import csv
import os
import shutil
import subprocess
import zipfile
from pathlib import Path

QUI = Path(__file__).parent
KICAD = Path(os.environ.get("KICAD_DIR", Path.home() / "AppData/Local/Programs/KiCad/10.0"))
CLI = KICAD / "bin" / "kicad-cli.exe"
from dati_scheda import N_STRATI, NOME, VERSIONE
OUT = QUI / "jlc" / f"{VERSIONE}_{NOME}"
PCB = QUI / f"{NOME}.kicad_pcb"
SCH = QUI / f"{NOME}.kicad_sch"
# correzioni di rotazione per impronte della libreria KiCad il cui modello JLC è orientato diversamente
# (le impronte swimtag: vengono da EasyEDA/LCSC e non ne hanno bisogno); verificato nell'anteprima JLC
CORREZIONE_ROT = {"Package_SO:SOIC-": 270}
# correzioni per designatore, dall'anteprima JLC della v0.5 (2026-11-05): il modello JLC dell'AO3401A ha i due pin
# dal lato opposto (+180°); il TPS22916C JLC a 0° ha A1 in basso a sinistra, il nostro A1 (VOUT) è in basso a destra (+90°)
CORREZIONE_REF_PER_VERSIONE = {
    "v0.5": {"Q1": 180, "U6": 90},
    # v0.6: Q1 (stesso AO3401A SOT-23) resta +180; U6 e' ora un SOT-23-6 (la correzione +90 del DSBGA NON vale) e U4 un SOT-23-5:
    # le loro correzioni sono SCONOSCIUTE fino all'anteprima JLC (nessuna applicata; i SOT-23 della libreria KiCad spesso vogliono +180)
    "v0.6": {"Q1": 180},
}
CORREZIONE_REF = CORREZIONE_REF_PER_VERSIONE.get(VERSIONE, {})
STRATI = ("F.Cu,In1.Cu,In2.Cu,B.Cu" if N_STRATI == 4 else "F.Cu,B.Cu") + ",F.Paste,B.Paste,F.Silkscreen,B.Silkscreen,F.Mask,B.Mask,Edge.Cuts"


def cli(*argomenti):
    subprocess.run([str(CLI), *map(str, argomenti)], check=True, capture_output=True)


def main():
    OUT.mkdir(parents=True, exist_ok=True)
    gerber = OUT / "gerber"
    shutil.rmtree(gerber, ignore_errors=True)
    gerber.mkdir()
    cli("pcb", "export", "gerbers", "--layers", STRATI, "--subtract-soldermask", "-o", gerber, PCB)
    cli("pcb", "export", "drill", "--format", "excellon", "--excellon-separate-th", "-o", gerber, PCB)
    with zipfile.ZipFile(OUT / "swimtag_gerber.zip", "w", zipfile.ZIP_DEFLATED) as z:
        for f in sorted(gerber.iterdir()):
            z.write(f, f.name)

    # BOM: un rigo per valore/impronta/codice LCSC, piazzole escluse (in_bom no nello schema);
    # designatori elencati uno per uno: JLC non capisce gli intervalli tipo "C2-C4"
    cli("sch", "export", "bom", "--fields", "Value,Reference,Footprint,LCSC,${QUANTITY}",
        "--labels", "Comment,Designator,Footprint,LCSC Part #,Quantity", "--ref-range-delimiter", "",
        "--group-by", "Value,Footprint,LCSC", "--exclude-dnp", "-o", OUT / "bom_jlc.csv", SCH)

    # CPL: posizioni dei componenti montati da JLC (solo lato sopra)
    pos = OUT / "pos_kicad.csv"
    cli("pcb", "export", "pos", "--format", "csv", "--units", "mm", "--side", "front",
        "-o", pos, PCB)
    with pos.open(encoding="utf-8") as f, (OUT / "cpl_jlc.csv").open("w", newline="", encoding="utf-8") as g:
        w = csv.writer(g)
        w.writerow(["Designator", "Mid X", "Mid Y", "Layer", "Rotation"])
        for r in csv.DictReader(f):
            rot = float(r["Rot"]) + sum(v for k, v in CORREZIONE_ROT.items() if r["Package"].startswith(k.split(":")[1]))
            rot += CORREZIONE_REF.get(r["Ref"], 0)
            w.writerow([r["Ref"], f'{float(r["PosX"]):.3f}mm', f'{float(r["PosY"]):.3f}mm',
                        "Top" if r["Side"] == "top" else "Bottom", f'{rot % 360:.0f}'])
    pos.unlink()

    for lato, extra in (("sopra", ["--side", "top"]), ("sotto", ["--side", "bottom"]),
                        ("3d", ["--rotate", "-40,0,30", "--perspective"])):
        cli("pcb", "render", "-o", OUT / f"render_{lato}.png", "-w", "1200", "-h", "1000",
            "--quality", "high", "--background", "opaque", *extra, PCB)
    cli("sch", "export", "pdf", "-o", OUT / "schema.pdf", SCH)
    print("file per JLC in", OUT)


if __name__ == "__main__":
    main()
