PZero/SwimTimer/hardware/nrf52840/kicad/dati_scheda.py

"""Dati del tag SwimTimer nRF52840 v0.3: componenti, collegamenti e posizioni.

Unica fonte per lo schema (genera_schema.py) e il PCB (genera_pcb.py), così restano coerenti.
Coordinate PCB in mm, origine in alto a sinistra della scheda, y verso il basso.
Modulo Ebyte E73-2G4M08S1C (v0.3: il Raytac MDBT50Q-1MV2 e' a stock 0, sostituito il 2026-11-01), antenna sul bordo alto
(3,7 mm senza rame). Componenti solo sul lato sopra (montaggio JLC su un lato); sotto contatti di ricarica, piazzole SWD e vibratore.
"""

import os

# Varianti generate dagli stessi dati (variabile d'ambiente SWIMTAG_VARIANTE):
#   "collaudo"   : primi 2 tag, variante 1c (quasi quadrata, indossabile): Tag-Connect + piazzole di prova sotto, 0 ohm sulla corrente
#   "definitiva" : piu' piccola possibile, senza piazzole di prova (DA FARE)
VARIANTE = os.environ.get("SWIMTAG_VARIANTE", "collaudo")
if VARIANTE not in ("collaudo", "definitiva", "economica", "v06"):
    raise SystemExit(f"VARIANTE sconosciuta: {VARIANTE}")
if VARIANTE == "definitiva":
    raise NotImplementedError("variante definitiva: non ancora implementata (v0.3 solo collaudo)")

NOME = f"swimtag_{VARIANTE}"   # nome dei file KiCad generati
# parametri della scheda (la variante "economica" li sovrascrive in fondo al file, vedi dati_economica.py)
VERSIONE, TITOLO_SERIGRAFIA, N_STRATI, SPESSORE = "v0.3", "v0.3 collaudo", 4, 0.8
PISTA, DISTANZA, VIA_D, VIA_FORO = 0.127, 0.1, 0.5, 0.3

from posizioni_collaudo import POS, SCHEDA_L, SCHEDA_H_TOT   # misure e posizioni (x, y, rotazione, lato) della variante 1c, vedi cerca_posizioni.py
ANTENNA_H = 3.7   # striscia senza rame sotto l'antenna: dal bordo al pad 1/43 del modulo (a 3,97 mm dal bordo, foglio Ebyte); Ebyte non da' una quota di rispetto

# Impronte standard di KiCad
R0402 = "Resistor_SMD:R_0402_1005Metric"
C0402 = "Capacitor_SMD:C_0402_1005Metric"
C0603 = "Capacitor_SMD:C_0603_1608Metric"
LED0603 = "LED_SMD:LED_0603_1608Metric"

C0805 = "Capacitor_SMD:C_0805_2012Metric"
JST_SH = "Connector_JST:JST_SH_SM02B-SRSS-TB_1x02-1MP_P1.00mm_Horizontal"

# Pin del modulo non usati (restano senza collegamento): P1.11 (1), XL1/XL2 (11, 13: tenuti per un eventuale quarzo a
# 32 kHz), DCCH (25), USB D-/D+ (29, 31), P1.00 (36), P1.02 (38), P1.04 (40), NFC (41, 43), P1.06 (42)
NC_U1 = [1, 11, 13, 25, 29, 31, 36, 38, 40, 41, 42, 43]

TP1MM = "TestPoint:TestPoint_Pad_1.0x1.0mm"
TPSWD = "TestPoint:TestPoint_Pad_D1.0mm"  # piazzole per il tester
TP08 = "swimtag:TestPoint_Pad_D0.8mm"
TC2030 = "Connector:Tag-Connect_TC2030-IDC-NL_2x03_P1.27mm_Vertical"
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
