PZero/SwimTimer/(commit log)

2026-10-24 docs: registra la scelta del repository pubblico
2026-10-24 firmware: aggiunge il test dei collegamenti del BMI160
2026-10-24 firmware: aggiunge la pagina Web Serial per i 3 assi
2026-10-24 docs: aggiorna README, changelog e analisi con il prototipo del tag
2026-10-24 firmware: aggiunge il servizio BLE e l'annuncio con i dati al test dei collegamenti
    Servizio GATT 7a1e0001-... con caratteristica 7a1e0002-... (16 byte: millis e 6 int16, notifica a 25 Hz).
    Annuncio "SwimTag" con dati produttore 0xFFFF (contatore e 6 int16, 20 Hz) per il display.
    Libreria BLE del core esp32 3.3.12: NimBLE-Arduino va in crash.
    [test-collegamenti.ino]
2026-10-24 firmware: aggiunge il firmware di prova del display LilyGO T-RGB
    Riceve gli annunci BLE del tag "SwimTag" senza collegarsi.
    Doppio framebuffer con attesa del vsync, corona con le 3 linee dell'accelerazione (un giro = 15 s),
    cronometro di prova (colpo secco = parte, tag vicino e fermo 3 s = stop, tocco = azzera).
    Driver in src/trgb, copia adattata di LilyGo-T-RGB 1.0.5 (MIT, vedi src/trgb/LICENSE).
2026-10-24 firmware: aggiunge il collegamento Bluetooth alla pagina assi.html
    Pulsante "Collega via Bluetooth" (Web Bluetooth, Chrome o Edge su desktop e Android)
    accanto a quello USB. Legge le notifiche GATT del tag "SwimTag" a 25 Hz.
    I pulsanti restano disabilitati se l'API del browser manca o se una sorgente è attiva.
2026-10-24 elettronica: aggiorna la distinta con il display 2,8" e touch GT911
    Verificato collegando la scheda T-RGB: display da 2,8 pollici, touch GT911.
2026-10-24 docs: aggiorna stato, decisioni e domande aperte
    Stato dei firmware di tag e display, decisioni su BLE, display e driver,
    domande aperte su display e partitore della batteria.
2026-10-24 docs: aggiorna il README con BLE, display di prova e roadmap
    Canali BLE del tag, flusso dei dati, firmware del display, compilazione con le librerie,
    struttura delle cartelle aggiornata; display 2,8" con touch GT911.
2026-10-24 firmware: svuota la cache dopo ogni disegno, il display mostra subito i decimi
2026-10-24 firmware: pace clock a 4 lancette sul display; tag: seriale non bloccante e collegamento BLE più veloce
2026-10-24 firmware: display compilato con PlatformIO e core Arduino 2.0.17 (driver LilyGO originale); tag: sonno profondo con risveglio dal BMI160 su INT1
2026-10-24 firmware: tensione e percentuale della batteria sul display (partitore interno della T-RGB)
2026-10-24 firmware: display, fix ricaduta immediata in sonno, risveglio anche da BOOT, motivo dell'avvio a schermo; docs e bom aggiornati
    [display-prova.ino]
2026-10-25 hardware: proposta di scheda su misura nRF52840 (distinta, progetto, consumi, rischi, piano a tappe) e domande aperte
2026-10-25 hardware: nRF52840, aggiunti sensore di profondità MS5837 e vibratore (pilotaggio in PWM per la cella da 20 mAh)
2026-10-25 hardware: nRF52840, piazzole SWD interne per il primo avvio (sotto la resina), MCUboot a prova di errore
2026-10-25 hardware: nRF52840, pannello di più tag con mouse bites per l'ordine dei prototipi
2026-10-25 hardware: nRF52840, risposte dell'utente (modulo, ±4 g, 3 h di autonomia), budget, ingombro, custodia, attrezzo di programmazione e stampo
2026-10-25 hardware: nRF52840, niente scheda intermedia (prototipo ESP32), budget JLC, ISP1807 via Global Sourcing, 32 MB confermati
2026-10-25 hardware: nRF52840, scelta la disposizione B compatta (~19 × 21 × 7,2 mm)
2026-10-25 hardware: nRF52840, avviso in acqua (vibratore consigliato, cicalino regolabile come riserva, prova sul prototipo), cella 15–20 mAh, programmatore e custodia da costruire
2026-10-25 hardware: nRF52840, progetto KiCad generato da script (schema, PCB piazzato 17,5 × 20,5 mm, BOM e CPL per JLC, render)
    Componenti con codici LCSC (easyeda2kicad), netlist verificata contro i dati,
    DRC senza cortocircuiti né sovrapposizioni; piste ancora da tracciare.
    [bom_jlc.csv, swimtag.kicad_pcb, swimtag.kicad_sch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]
2026-10-25 firmware: tag 0.4.2 con registrazione a tap, aggiornamento via Bluetooth, stato esteso; partitori e ±16 g in hardware
    [partitions.csv]
2026-10-25 app: pagina di analisi tools/index.html e workflow GitHub Pages (riconosce il marcatore di versione anche dopo il formato %s)
2026-10-25 docs: README, il display riceve l'annuncio già convertito a 16384 LSB/g
2026-10-25 firmware: tag 0.4.3, fondo scala del BMI160 impostato a sensori accesi e riletto
2026-10-25 app: la pagina avvisa se da fermo l'accelerazione non vale circa 1 g
2026-10-25 hardware: nRF52840, PCB v0.1 sbrogliato con Freerouting (DRC 0 errori), Gerber, BOM e CPL per JLC
    Scheda 17,5 × 20,5 mm a 4 strati; caricatore ruotato tra le sue resistenze,
    piste 0,127 mm, via 0,5/0,3 coperti; documentazione del progetto KiCad.
    [bom_jlc.csv, swimtag.kicad_pcb, swimtag.kicad_sch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]
2026-10-25 hardware: nRF52840, zip dei Gerber per JLC nel repository
2026-10-25 hardware: nRF52840, verifiche sui datasheet (ST AN5763, TE MS5837, TI BQ25101, Raytac) e correzioni; PCB risbrogliato, DRC 0 errori
    - IMU: due 100 nF vicini a Vdd e Vdd_IO (sensore ruotato di 180°)
    - MS5837: pull-up I2C 10 kOhm come da application circuit TE
    - BQ25101: 10 uF sull'uscita (intervallo 1-10 uF), via i 2 x 22 uF
    - modulo: 10 uF vicini a VDD e VDDH
    - registro delle verifiche in hardware/nrf52840/verifiche.md
    [bom_jlc.csv, swimtag.kicad_pcb, swimtag.kicad_sch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]
2026-10-25 hardware: nRF52840 v0.2, protezione dei contatti di ricarica (TVS SD05 + Schottky B5819WS) e reset all'inserimento nella custodia
    Scheda 17,5 × 22,5 mm, contatti di ricarica sul bordo basso, SWD su due file;
    risbrogliata con Freerouting, DRC 0 errori; verifiche e misura della batteria documentate.
    [bom_jlc.csv, swimtag.kicad_pcb, swimtag.kicad_sch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]
2026-10-26 app: card Batteria con grafico e livello target nella pagina di analisi
2026-10-26 docs: la scheda nRF52840 vive nel repository privato SwimTimer-nrf52840
2026-10-26 docs: README e CHANGELOG con la scheda nRF52840; aggiornati STATO, DECISIONI e DOMANDE-APERTE
2026-10-26 hardware: nRF52840, progetto e distinta allineati alla v0.2 (VDD 3,3 V, BQ25101 a 13,5 mA)
2026-11-01 docs: v0.3, scelta la cella LiPo 401015 (~40 mAh)
2026-11-01 hardware: nRF52840 v0.3 collaudo, schema con Ebyte E73, sensori commutati, MAX17048, TS da GPIO, connettore batteria e pin di collaudo (non sbrogliato)
    [swimtag_collaudo.kicad_pcb, swimtag_collaudo.kicad_sch]
2026-11-01 hardware: nRF52840 v0.3 collaudo variante 1c (26 x 30 mm, una faccia, Tag-Connect TC2030-NL, 0 ohm BAT/VBAT), sbrogliato, DRC 0, file JLC in jlc/v0.3_swimtag_collaudo
    [bom_jlc.csv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]
2026-11-01 hardware: nRF52840 v0.3 collaudo, vibratore non montato (nessun motore SMD montabile da JLC a rifusione); decisioni e domande aggiornate
    [dati_scheda.py]
2026-11-01 hardware: nRF52840 v0.3 collaudo, render 3D, 8 wallpaper tecnici (PNG 1170x2532) e PDF di progetto generati dal PCB reale
2026-11-02 hardware: variante v0.4 economica negli script generatori (dati_economica, 2 strati, griglia 2,54 mm, header 1,27 mm); la v0.3 collaudo resta rigenerabile
2026-11-02 hardware: nRF52840 v0.4 economica sbrogliata (22,86 x 26 mm, 2 strati HASL, DRC 0), file JLC, render e ingombro con griglia 2,54 mm
    [bom_jlc.csv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]
2026-11-02 hardware: BOM JLC con designatori elencati uno per uno (JLC non legge gli intervalli tipo C2-C4), v0.3 e v0.4
    [bom_jlc.csv]
2026-11-02 hardware: CPL JLC, correzione di rotazione +270 per i SOIC della libreria KiCad (U3 flash v0.4 ruotata di 90 gradi nell'anteprima JLC)
    [cpl_jlc.csv]
2026-11-03 hardware: v0.4 economica ricompattata a 21,59 x 26 mm (E73 a 0,3 mm dal bordo sinistro), LED 0603 Basic C2286 con anodo su VDD, pinout lento sui pad interni, DRC 0; file JLC, ingombro, documenti aggi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
    [bom_jlc.csv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]
2026-11-03 hardware: programmatore HAT per Raspberry Pi 3/4 (pogo sulle piazzole del tag v0.4, toner transfer, PDF con stampe 1:1, ricarica); decisioni aggiornate
    [swimtag_programmatore.kicad_pcb, swimtag_programmatore.kicad_sch]
2026-11-03 WIP hardware: v0.4 con TPS22916C per l'IMU, lavoro interrotto (DRC non rifatto, non ordinare); STATO con i passi per riprendere
    [swimtag_economica.kicad_pcb, swimtag_economica.kicad_sch]
2026-11-04 WIP hardware: v0.4 TPS22916C, ultime modifiche dell'agente interrotto (non verificate)
    [swimtag_economica.kicad_pcb]
2026-11-04 hardware: scheda v0.5 (TPS22916C su VDD_IMU, TVS su VIN, AO3401A contro l'inversione della cella, 100k VIN-GND, TP8, C5/C6 4,7 uF 10 V, IMU MISO/CS su P0.08/P0.12), 21,59 x 28 mm, DRC 0; file JLC v0.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
    [bom_jlc.csv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]
2026-11-04 hardware: v0.5 completa (sfondi tecnici v0.5, programmatore rigenerato sulla scheda 21,59 x 28 mm, documento e PDF di revisione v0.5); docs: README, CHANGELOG e STATO alla v0.5, revisioni esterne Gem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
    [swimtag_programmatore.kicad_pcb]
2026-11-04 ci: il workflow di GitHub Pages gira solo nel repository pubblico (nel privato falliva: Pages non attivo)
2026-11-04 hardware: immagine di dove saldare la cella sul tag v0.5 (J1, polarità) e script che la genera dal render
2026-11-04 hardware: programmatore allineato alla v0.5 (PDF Programmatore_SwimTag_v0.5.pdf, scritta JIG 0.5, revisione 0.5, riferimenti aggiornati); sfondi 17-20 rigenerati
    [swimtag_programmatore.kicad_pcb, swimtag_programmatore.kicad_sch]
2026-11-04 chore: video e audio di media/video fuori dal repository (link YouTube nel README)
2026-11-04 media: generatore del video di presentazione (2 min) con musica originale sintetizzata, miniatura YouTube e testo della descrizione; il video non è nel repository
2026-11-04 docs: README con il video di presentazione su YouTube (miniatura cliccabile)
2026-11-04 docs: repository unico e pubblico PZero/SwimTimer con tutto il progetto (README, STATO, DECISIONI, /fine-sessione, workflow Pages)
2026-11-05 hw: v0.5 orientamento di Q1 e U6 per JLC (anteprima del 2026-11-05)
    - U6 (TPS22916C): puntino di pin 1 in serigrafia spostato accanto ad A1 (VOUT, in basso a destra);
    era vicino ad A2 e coincideva con il pin 1 sbagliato del modello JLC
    - esporta_jlc.py: correzioni di rotazione per designatore, Q1 +180 (270) e U6 +90 (90)
    - file JLC v0.5 rigenerati; DRC 0, verifica_v05 100/100 pin; anteprima JLC controllata
    [cpl_jlc.csv, swimtag_economica-B_Cu.gbl, swimtag_economica-B_Mask.gbs, swimtag_economica-B_Paste.gbp, swimtag_economica-B_Silkscreen.gbo, swimtag_economica-Edge_Cuts.gm1, swimtag_economica-F_Cu.gtl, swimtag_economica-F_Mask.gts]
2026-11-06 elettronica: scheda v0.6 Rev0, uscite NextPCB e documenti (2026-11-06)
    - Scheda v0.6 "Rev0": 4 strati, senza BGA, MCP73831, TPS22917, J1 DNP, D4 e R2, D3 sostituito con LC05CI
    - Uscite NextPCB in hardware/nrf52840/kicad/nextpcb/v0.6 (Gerber, BOM, CPL, NOTE_ORDINE.md)
    - Script crea_pannelli, cuci_massa, esporta_nextpcb, verifica_v06 e disegno_montaggio_v06
    - Pannelli v0.5 3x1 e 2x1 (rifiutati dal Rev0)
    - Documentazione XIAO in hardware/xiao
    - Decisioni: restare a 4 strati, base di ricarica a slot con NFC, README solo in inglese
    - CHANGELOG e documenti di stato aggiornati
    [bom_jlc.csv, bom_nextpcb.csv, bom_nextpcb.xlsx, centroid_nextpcb.xlsx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]
2026-11-06 repo: switch commit messages to English; English repository description
2026-11-06 tools: XIAO tab with live board orientation, head mounting calibration and wireframe head (Lee Perry-Smith scan, CC BY 3.0)
2026-11-06 tools: XIAO axis check shows live accelerometer and gyroscope charts instead of the value table
2026-11-06 tools: XIAO eyes drawn as green wireframe like the head, solid red only during the flash
2026-11-06 tools: XIAO eyes placed in the measured eye sockets of the head scan
2026-11-06 docs: add XIAO swim cap and eye placement to README and changelog
    The XIAO tab now has an optional orange swim cap ("Cuffia" checkbox,
    on by default, remembered between visits), and the eyes sit on the
    eye sockets measured on the head scan. README XIAO line and the
    2026-11-06 changelog updated; docs/STATO.md and docs/DECISIONI.md
    updated with the same change.
2026-11-07 firmware: XIAO nRF52840 Sense stream sketch 0.2.0 (BLE DFU, BLE log, sleep with hardware double-tap wake, 208 Hz averaging and gyro bias); tools: XIAO tab log panel, sleep and firmware update buttons
2026-11-07 tools: firmware dialog points XIAO users to the XIAO tab update button
2026-11-07 firmware: XIAO stream 0.3.2 - 'still enough' auto-sleep (1 s averages: rotation < 3 dps and tilt < 3 deg for 60 s), shorter log lines; tools: hide XIAO browser DFU (Nordic legacy DFU is on the Web Bl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
    [xiao-stream.ino]
2026-11-07 firmware: XIAO stream 0.4.2 - own BLE OTA on characteristic 0006 (staging + CRC + RAM installer, board signature check), 4-tap wake, extended 12-byte status (charge, VBUS, die temp, divider), VCAL ca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
    OTA verified on hardware 0.4.0 -> 0.4.1 -> 0.4.2 over BLE.
2026-11-07 firmware: track the published XIAO release binary (xiao.bin) despite the *.bin ignore rule
2026-11-07 docs: session wrap-up - XIAO stream firmware 0.4.2 (BLE OTA, log, sleep, battery) in README, changelog, status, decisions and open questions
2026-11-07 firmware: XIAO pool recording mode 0.5.0/0.5.1 and wake fix; tools: recording download and video annotation tabs
    - Fix 2-tap wake: the Adafruit bootloader clears RESETREAS, so a GPREGRET2
    marker is written before every System OFF and read at boot
    - Wake sequence: 2 taps, blue LED, 2 taps (IMU is blind ~0.5 s after wake);
    0.5.1 blinks the blue LED off at each counted tap
    - 0.5.0: raw IMU recording to QSPI flash (256-byte pages, CRC16, int8 deltas,
    208 Hz, +-16 g / +-1000 dps), BLE off, segments, 8+2 tap erase, 180 s rest
    stop, low-battery close, USB DUMP/ERASE/MEM
    - .swr decoders (swr.py, tools/swr.js), scarica.py, 11 unit tests on
    invented data, tools/parita_swr.mjs parity check
    -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
    [flash_qspi.h, scarica.py, swr.py, swr_formato.h, test_swr.py, xiao-stream.ino]
2026-11-07 docs: README test methodology section (raw recording, video sync, hand annotation, filters) and XIAO status fixes
2026-11-08 firmware: XIAO 0.5.2/0.5.3 (no sleep on USB, USB stops recording); tools: XIAO-only page; app: Firebase collaboration site
    - Firmware XIAO 0.5.2: no automatic sleep while USB power is present.
    - Firmware XIAO 0.5.3: plugging USB during a pool recording closes it
    (stop reason 4, also in swr.py/swr.js) and restarts in normal mode.
    - tools/index.html reorganised for the XIAO only: one USB/Bluetooth/Demo
    connection panel, Live/Recording/Annotation/Firmware tabs; ESP32 parts
    and tools/assi.html removed.
    - New online app (Firebase Spark, project swimtimer-pzero): public landing,
    /area/ with Google login and admin approval, raw sessions in Firestore
    chunks, videos as Drive links with sha2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
2026-11-08 firmware: XIAO 0.5.4 charges at 100 mA; tools: battery estimate for the 1000 mAh cell
    - Firmware XIAO 0.5.4: P0.13 driven low (kept in System OFF), BQ25101
    charge current 100 mA instead of 50 mA. Flashed over BLE from the PC.
    - tools/index.html: charge time estimate uses 1000 mAh and 100 mA.
    - Docs: status, decisions and changelog updated (cell now 1000 mAh,
    flat voltage over minutes is expected at 0.1 C).
2026-11-08 docs: session wrap-up - firmware 0.5.4, 1000 mAh test cell, recording usage
    - README: firmware 0.5.4 (100 mA charging), 1000 mAh test cell and
    charge times, usage note (normal mode vs recording gesture).
    - LEGGIMI: 0.5.4 note.
    - Status and decisions updated.
2026-11-08 app: bilingual site, contact form, online tools and display demo; media: progress video v2
    - Firebase site: IT/EN switch on landing and members' area (i18n.js),
    contact form stored in Firestore `contatti` (validated public create,
    admin-only read) with admin "Messages" page, poolside display section
    with screenshot and live demo (/display/), tag tools published on
    /strumenti/ at deploy time with "Upload online" of .swr recordings.
    - Firestore rules: contacts rules, 17 emulator tests passing.
    - tools/display.html: ?demo&vel= starts the demo immediately.
    - New 2-minute progress video (IT/EN), original generated music;
    generator v2, screenshots with made-up data, thumbnails. YouTube: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
2026-11-10 video v3 "first pool test" on YouTube, annotation editor fixes, OpenCV and IMU test bench
    - Landing page, README, CHANGELOG, docs: links to the new video (IT J01CR2nldp8, EN bs7WDUuwb-A)
    - Annotation editor (area and tools): list no longer scrolls the page, real fps measured (50 fps),
    clicked event moved frame by frame with the arrow keys
    - analisi/video: OpenCV pipeline (stabilisation, background, skin filter, wall distance, classification)
    - analisi/imu: streaming test bench, dataset format, evaluation, sample-rate experiment
    - media/video: generator, music, texts and storyboard of video v3 (real images stay out of the repo)
2026-11-10 sync: tag-to-display synchronization (tag 0.6.0, display-sync, .swr format 3)
    - Protocol (docs/SINCRONIZZAZIONE.md): 4 KB blocks pushed by the tag, confirmed
    only after SD write + read-back, no timed resend, window 2, seq never reused
    - XIAO firmware 0.6.0: 512-block ring, .swr format 3 (confirm word 252..255:
    the Puya flash replaces 4-byte words), BLE always on, name/colour, LEDs off
    on battery, unknown flash never erased automatically
    - New T-RGB display firmware (Adafruit GFX): 3 sectors, block map, battery,
    signal, single SD writer, boot log, DEMO mode
    - tools/index.html: Synchronization panel, name/colour; swr.js reads formats 1-3
    - Dry test: 2 tags x 15 min, 666 blocks confirme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
    [ble_sync.cpp, demo.cpp, display-sync.ino, flash_qspi.h, protocollo.h, ricezione.cpp, ricezione.h]
2026-11-10 sync: one SD file per tag, multi-file open, SLEEP during recording
    - Display writes /swim/<tag id>/tag.swr (+ .idx, .anomalia) instead of one
    file per boot; boot log with reset reason in /swim/avvii.txt
    - tools page: open several .swr files merged by block seq; format-3 MEM/DUMP
    over USB; asks the tag for its real name/colour on connect
    - Tag 0.6.0: SLEEP accepted while recording (stop reason 6); NOME/COLORE
    without argument return the current value
    - SD card verified from the PC: 2408 blocks, no seq gaps, no overruns
    - Docs: status, decisions, open questions, README, CHANGELOG
    [sd_scrittore.cpp, swr.py, swr_formato.h, xiao-stream.ino]
2026-11-12 firmware 0.6.1: recovery after in-pool reset, headless station with Wi-Fi status page, display enclosure
    Tag (xiao-stream 0.6.1, test build "-prove"):
    - after the 2026-11-11 pool incident (reset during recording -> normal mode, swim lost):
    without USB the tag only records or sleeps; automatic resume after crash/watchdog
    (max 3, RAM mark + flash file); 8 s watchdog; fault context; persistent diary
    - IMU FIFO realignment with content check (swr_fifo.h, fifo_sim.py), I2C reads <= 24 bytes
    - continuous session time across resets (T_AVVIO 500 ms, misura_avvio.py)
    - USB rules: 2 s debounce, VBUS settle wait at boot, never System OFF with VBUS
    - tap-sequence LEDs visible on battery; M_SONNO sta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
    [forcella.stl, involucro.scad, pomello.stl, vaso.stl]
2026-11-12 station: Raspberry Pi 3 headless setup, final architecture, crash analysis
2026-11-12 receiver 0.1.6, host script, tag 0.6.3, bench download results
    - firmware/ricevitore: XIAO nRF52840 USB receiver (central for 2 tags,
    encrypted sync, CRC USB frames, tag ack only after host OK)
    - stazione/ricevitore_host.py: host saving tag.swr/.idx with fsync+reread
    - tag 0.6.3: 238 B fragments, DIAGNOSI message, aligned flash reads,
    8 KB BLE task stack
    - bench tests: 1 tag ~16.5 KB/s, 2 tags ~17.6 KB/s total, 0 discards;
    receiver radio is the bottleneck; BLE stack 606 B free of 8 KB
    - docs: status, decisions, open questions, README, CHANGELOG
2026-11-12 video v4 "Houston, we have a problem": scripts, YouTube links, landing
    - media/video: genera_video_v4.py, musica_v4.py, testi_v4_en.py, STORYBOARD_v4.md
    - YouTube IT 85RNvPnFV1E, EN mj6OTWkjgwk: landing (first), README, CHANGELOG, DECISIONI, LEGGIMI
2026-11-13 station: Raspberry Pi 3 host service, HTML panel and cog kiosk; tag 0.6.4, receiver 0.1.7
    - ricevitore_host.py: --stato writes an atomic JSON every second for the panel;
    serial-port errors logged only when they change
    - stazione/rpi: pannello.py (stdlib HTTP server) + pannello.html (per-tag RSSI,
    blocks, battery, memory, DIAGNOSI2, inferred REGISTRA badge, filtered log,
    portrait layout, tag names from a Pi-only nomi.txt)
    - systemd units (host, panel, cog kiosk on DRM), installa.sh, deploy.sh, kiosk.sh
    - verified on the Pi 3: autostart, 2 tags downloaded with 0 discarded blocks;
    known issue: Pi undervoltage
    - tag 0.6.4 stays connected while recording, receiver 0.1.7 with DIAGNOSI2
    - d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
    [ble_rx.cpp, blocchi.cpp, protocollo.h, ric.h, ricevitore.ino, ricevitore_host.py, swr_sync.h]
